user-lqt/gowin-fpga-instrument-138k/companion/README.md

# 配套应用

| 目录 | 内容 |
| --- | --- |
| `phone/` | Web Bluetooth网页、通信协议、测试和示例曲谱 |
| `esp32c3/` | ESP-IDF NimBLE BLE-UART桥接工程 |

网页部署与通信协议见[蓝牙说明](../docs/BLUETOOTH.md)。K230程序位于 [final/k230](../final/k230/)。

网页来源为团队提交 `2b471689`；ESP源码来自团队现有ESP32-C3工程。文件校验见 `release/manifest.json`。
