user-lqt/gowin-fpga-instrument-138k/docs/HARDWARE.md

# 硬件接线

整机连接图及模块工作原理见[硬件总览](HARDWARE_OVERVIEW.md)。本页给出具体引脚与接线对应关系。

按开发板球位丝印接线（如C18、A19）。58个端口及IO属性见[完整引脚表](PINOUT.md)。

## 硬件组成

| 部件 | 功能与数量 |
| --- | --- |
| Tang Mega 138K | GW5AST-LV138PG484AC1/I0；音频合成、扫描、控制与显示 |
| 自制24键琴键 | 每键2个触点，共48触点；8×6矩阵 |
| 双EC11 | 音量/音色与页面参数，各1个 |
| MCP3008 | SPI ADC，采样FSR和摇杆 |
| FSR压力传感器 | CH0，控制颤音 |
| 双轴摇杆 | CH1/CH2，表情输入 |
| PCM5102A模块 | 立体声I2S DAC；线路输出接功放或有源音箱 |
| Sipeed 5英寸RGB屏 | 800×480，RGB666接口 |
| 可寻址RGB灯带 | GRB数据格式，代码发送49个灯位置，24个位置对应实体琴键 |
| ESP32-C3 | BLE与UART双向桥接 |
| K230 | 手势、调参及8虚拟键扩展 |

外部GPIO信号采用3.3V逻辑，所有设备信号地共地。5V电源脚不是3.3V GPIO；不要将5V信号送入FPGA。F4板上复位属于1.5V Bank，不能将其当作普通外接3.3V输入。

## 双触点矩阵

| 行信号 | 球位 | 触点作用 |
| --- | --- | --- |
| R0 `row_out[0]` | E14 | K1–K6 的A触点 |
| R1 `row_out[1]` | E13 | K1–K6 的B触点 |
| R2 `row_out[2]` | C15 | K7–K12 的A触点 |
| R3 `row_out[3]` | C14 | K7–K12 的B触点 |
| R4 `row_out[4]` | B13 | K13–K18 的A触点 |
| R5 `row_out[5]` | C13 | K13–K18 的B触点 |
| R6 `row_out[6]` | A14 | K19–K24 的A触点 |
| R7 `row_out[7]` | A13 | K19–K24 的B触点 |

| 列信号 | 球位 | 对应琴键 |
| --- | --- | --- |
| C0 `col_in[0]` | B16 | K1 K7 K13 K19 |
| C1 `col_in[1]` | B15 | K2 K8 K14 K20 |
| C2 `col_in[2]` | A16 | K3 K9 K15 K21 |
| C3 `col_in[3]` | A15 | K4 K10 K16 K22 |
| C4 `col_in[4]` | A20 | K5 K11 K17 K23 |
| C5 `col_in[5]` | B20 | K6 K12 K18 K24 |

每个触点串独立防鬼键二极管，例如1N4148：`列线 → 触点 → 二极管阳极 → 阴极带环端 → 行线`。触点与二极管串联次序可对调，但带环端始终朝行。共48只二极管；A触点先闭合，B触点后闭合。

6条列线各用一只约10kΩ电阻连接3.3V，电阻另一端与对应列输入相接；不是将电阻串在列线中。最终CST也启用内部列上拉及8条行上拉，未选中行由RTL置高阻。

## 双EC11

| 信号 | 球位 |
| --- | --- |
| A编码器 A相 `enc_a` | A21 |
| A编码器 B相 `enc_b` | B21 |
| A编码器按压 `enc_sw_n` | B18 |
| B编码器 A相 `enc2_a` | C17 |
| B编码器 B相 `enc2_b` | D17 |
| B编码器按压 `enc2_sw_n` | E19 |

裸EC11相位公共端接GND，按压触点另一端接GND；信号端上拉到3.3V。用万用表确认实际引脚分组，不靠不同商家的ABCDE图猜测。当前约束启用内部上拉；已有外部上拉按已验证实物保留。

## MCP3008 FSR与摇杆

| FPGA信号 | 球位 | MCP3008 PDIP16 |
| --- | --- | --- |
| `adc_cs_n` | A18 | CS脚10 |
| `adc_sclk` | D15 | CLK脚13 |
| `adc_mosi` | D14 | DIN脚11 |
| `adc_miso` | D16 | DOUT脚12 |

VDD脚16与VREF脚15接3.3V，DGND脚9与AGND脚14共地，芯片附近做去耦。模块板按自身丝印，不照搬裸芯片脚号。

FSR分压输出送CH0（脚1）；摇杆VRx送CH1（脚2），VRy送CH2（脚3），摇杆电源3.3V。所有模拟输入限制在0至3.3V。压力增大需对应ADC读数上升，例如3.3V经FSR到CH0节点，再经固定分压电阻至GND；分压阻值和零点按实物标定。

## 外置PCM5102A

| 模块端 | 接线 |
| --- | --- |
| BCK | FPGA **A19** `o_hp_bck` |
| LCK/LRCK | FPGA **E16** `o_hp_ws` |
| DIN | FPGA **E17** `o_hp_din` |
| GND | 公共GND |
| 3.3V | 已确认的3.3V电源；不要取J13的5V |
| XMT/XSMT | 3.3V，解除静音 |
| FMT | GND，选择Philips I2S |
| SCK | 按当前无MCLK方案接GND，使用内部PLL |
| VCC/VIN | 对团队现有YX69008模块按厂家文字修正留空，避免与3.3V脚同时供电 |

FLT、DMP若引出，按模块已验证配置与资料核对。上述供电适用于团队已有模块，不能推广到所有PCM5102A板。音频从其LINE OUT的L/G/R或AUX引出，L/R不要短接，裸喇叭需要功放。

## 蓝牙 K230 灯带与屏幕

| 连接 | 最终球位与方向 |
| --- | --- |
| ESP GPIO21 TX → FPGA RX | C18 `ble_uart_rx` |
| FPGA TX → ESP GPIO20 RX | C19 `ble_uart_tx` |
| K230 UART3 IO32 TX → FPGA | C20 `k230_uart_rx`，115200/8N1 |
| LED灯带DIN | B17 `led_strip_din`；灯带GND共地 |
| RGB屏控制 | DE=L14 VS=L15 HS=N20 CLK=L19 |

ESP用USB供电及USB Serial/JTAG监视，避免日志占用GPIO20/21。K230程序与模型部署见[板端说明](../final/k230/README.md)。

灯带使用独立合适的5V供电，避免由FPGA信号脚供电；若灯带为5V输入阈值器件，DIN通过支持3.3V输入的5V逻辑缓冲器（如74AHCT125）转换。灯带电源与FPGA共地，按实际负载选电源，不将电源反灌开发板。

K1–K12映射灯 **2、4、6、8、10、12、14、16、18、20、22、24**；K13–K24映射灯 **27、29、31、33、35、37、39、41、43、45、47、49**。灯编号从DIN方向第一颗按1起算。

5英寸RGB屏使用对应专用RGB连接器与排线；数据RGB各6位共18位，完整球位见[引脚表](PINOUT.md)。不要沿用旧OLED接线。
