user-lqt/gowin-fpga-instrument-138k/docs/PLATFORM_TANG_MEGA_138K.md

# 平台冻结卡 · Tang Mega 138K

> 归属：成员 C 维护。**A/B 也必须读**，因为采样率、位宽、时钟直接决定你们的模块参数。
> 本文所有器件与板卡参数已按 Sipeed 官方文档核实（2026 年 9 月）；管脚号必须按实物原理图人工核对，见第 6 节。

---

## 1. 器件与板卡

| 项 | 值 |
|---|---|
| 开发板 | **Sipeed Tang Mega 138K Dock**（SOM + Dock 底板） |
| 芯片型号 | **GW5AST-LV138PG484AC1/I0** |
| 工艺 | 22 nm |
| 封装 | PG484（484 脚） |
| 事实核对 | SOM 资料页同时出现 `GW5AST-LV138FPG676A`；**IDE 里按 `PBG484A` 选封装，并按实物选 Device Version** |

> ⚠️ **这是最容易翻车的一步。** 器件版本选错 → 综合通过、烧录"成功"、管脚完全无反应。
> 核对方法：读芯片顶面丝印 + 查 Sipeed 的器件版本识别说明。核对结果写入 `constraint/tang_mega138k.cst` 顶部注释。

### 片上资源

| 资源 | 数量 | 对本项目的意义 |
|---|---|---|
| LUT4 | **138,240** | 32 路振荡器 + 音效 + 可视化后仍有余量 |
| FF | 138,240 | 控制逻辑与流水线充裕 |
| 分布式 SRAM (S-SRAM) | 1,080 Kbit | 小查找表、FIFO |
| 块 SRAM (B-SRAM) | **6,120 Kbit / 340 块** | 多组波表 + 混响/延迟线**全片上解决，不必用 DDR** |
| 18×18 乘法器 | **298** | 多相插值、FM 调制、滤波器都够用 |
| PLL | 12 | 可独立生成 12.288 MHz 音频时钟 |
| 全局时钟 / 高速时钟 | 16 / 24 | 音频域与系统域分离从容 |
| 硬核 SoC | RISC-V AE350 @800MHz | **本项目不使用**（软核/CPU 会破坏"纯硬件合成"合规性） |
| IO Bank | 10 | 外设扩展充足 |

### 板载资源（与本项目相关）

| 板载资源 | 数量 | 用途 |
|---|---|---|
| DDR3 | 1 GB（512MB×2） | 可选：超长延时/混响；**首选不用，避免时序坑** |
| Flash | 64/128 Mbit | 配置固化 |
| **扬声器接口** | **2 路，各 3W** | ★ 见第 4 节 |
| **3.5 mm 耳机接口** | 1（立体声，无麦克风） | ★ 见第 4 节 |
| 板载 ADC | 2 路差分 | 可选：模拟力度/包络输入 |
| 麦克风阵列接口 | 1（Sipeed 6+1） | 预留 |
| DVI/HDMI TX+RX | 1 | 拓展：可视化输出到显示器 |
| 千兆以太网 / USB3 / PCIe | 各 1 | 本项目不用 |
| PMOD / 2x20P 排针 | 2 / 2 | 外接键盘、OLED、传感器 |
| LED | 4（电池指示）+ 8（PMOD_LED） | 系统状态指示 |
| 按键 | 3 用户键 + 1 重配置键 | 复位、模式切换 |
| USB JTAG & UART | 1（JST SH1.0 8P） | 下载 + 串口调试 |
| MS5351 时钟发生器 | 1 | 可为 Serdes 提供 RefClk（本项目暂不用） |
| 供电 | 12V DC（DC5521）或双 5V USB | 见第 5 节电源注意 |

---

## 2. IDE 与 License（版本门槛，必须核对）

| 渠道 | 最低版本 | 说明 |
|---|---|---|
| **教育版** | **V1.9.9 或更高** | 138K 目前由教育版支持 |
| **商业版** | **V1.9.11.03 或更高** | 官网申请 License，或用 Sipeed 浮动 License 服务器 |
| 独立下载器 Programmer | **1.9.12 SP1** 更稳 | 从"云源软件商业版"页面单独下载 |

**Sipeed 浮动 License 服务器**（商业版选 Floating License 填入）：

```
IP:   106.55.34.119
Port: 10559
```

**烧写 Flash 的推荐模式**：

```
exFlash Erase, Program through GAO-Bridge 5A        (V1.9.11.03+)
exFlash Erase, Program through GAO-Bridge Arora V   (V1.9.12+)
```

---

## 3. 时钟与采样率方案（A/B/C 共同依据）

| 信号 | 频率 | 来源 | 用途 |
|---|---|---|---|
| `clk_fsys` | 100 MHz | PLL（板载晶振） | 系统、控制、UART、键盘扫描 |
| `clk_fs` | **12.288 MHz** | PLL = 48 kHz × 256 | 音频采样域，I2S 位时钟基准 |
| `sample_tick` | **48 kHz** | 由 `clk_fs` 每 256 拍产生（整除） | 音频核心的唯一样本节拍 |
| `HP_WS`（LRCK） | 48 kHz | `clk_fs` / 256 | 声道选择，**低电平 = 左声道** |
| `HP_BCK` | **3.072 MHz** = 64 × 48 kHz | `clk_fs` / 4 | 位时钟，每声道 **32 bit 槽**（给 24 bit 留空间） |

> ⚠️ **与官方例程的差异**：官方例程用 `HP_BCK = 1.536 MHz`（**16 bit** 槽、32 BCK/帧）以输出纯单音梯形波。
> 我们的设计把 BCK 提到 **3.072 MHz**（32 bit 槽、64 BCK/帧）以便输出 **24 bit**。
> **板载 DAC 是否接受 32 bit 槽尚未验证** —— 按 [`C_官方例程与板载音频通路分析.md`](C_官方例程与板载音频通路分析.md) 第 3 节的"验证阶梯"分四步走，不要一步到位。

> **为什么不用 100 MHz 直接分频？** 100 MHz / 48 kHz = 2083.33，除不尽，需要小数累加。用 12.288 MHz 音频域则每采样正好 256 拍，**无抖动、无累积误差**，也满足"确定性无抖动延迟"这条拓展要求。
> 若某处必须用 `clk_fsys` 产生 48 kHz，`event_defs.vh` 里也给了 Bresenham 小数累加的说明，但**首选音频域方案**。

**I2S 格式约定（C1 必须按此实现）**

| 项 | 约定 |
|---|---|
| 协议 | I2S（MSB 先出） |
| 槽位 | 每声道 **32 bit**，BCK = 64 × LRCK |
| 有效位宽 | 目标 24 bit，**左对齐放在 32 bit 槽的高 24 位**，低 8 位补 0 |
| 时序 | 发射端在 BCK 下降沿更新数据，接收端在上升沿采样 |
| 相位 | 官方例程在帧内第 3 个 BCK 翻转 `HP_WS`（**不是标准 1-BCK 延迟**）。**首次实现请照抄官方相位并实测确认**，不要凭理论推断 |
| 接口 | `HP_BCK` / `HP_WS` / `HP_DIN` 三线直连板载 DAC；官方例程将 `PA_EN` 固定低电平常开 |
| 备选 | 若板载 DAC 不接受 32 bit 槽：退回 16 bit 槽（BCK=1.536 MHz），或用外置 PCM5102A（SCK 接 GND，无需 MCLK） |

---

## 4. 音频输出硬件路径

> ### ✅ 已确认（2026-09-21）：板载 DAC + 功放是完整的，不需要外置器件
>
> 依据 Sipeed 官方例程 **`TangMega-138K-example → audio_i2s/`**：
>
> ```verilog
> output HP_BCK,   // 位时钟
> output HP_WS,    // 左右声道（低=左）
> output HP_DIN,   // DAC 串行数据输入
> output PA_EN,    // 音频功放控制；官方 top.v 固定为低电平常开
> ```
>
> 例程自述："Test condition: earphone in the jack or mounted speaker. Phenomenon: A 400 Hz trapezoidal wave is generated and played."
>
> **结论：外置 PCM5102A、PAM8403 功放、独立 5V 电源、无源喇叭全部不需要。**
> 板载已有 DAC + 功放 + 耳机口 + 扬声器接口，`PA_EN` 控制功放使能。
> **实机管脚已核实并写入 `constraint/tang_mega138k.cst`。**
> 详细分析与 I2S 协议参数见 [`C_官方例程与板载音频通路分析.md`](C_官方例程与板载音频通路分析.md)。

**首选路径（板载，阶段一即可验证）**

```
FPGA (HP_BCK / HP_WS / HP_DIN) → 板载 I2S DAC → 板载功放 (PA_EN 固定低电平) → 耳机口 / 扬声器
```

**备选路径（仅在板载 DAC 不支持 24 bit 时考虑）**

```
FPGA (I2S 三线) → PCM5102A 模块（3.3V 供电，SCK 接 GND）→ 有源音箱
```

> ⚠️ **仍需保留逻辑分析仪。** I2S 三线波形必须实测（LRCK=48 kHz、BCK/DATA 对齐），这是 C1 的硬性验收条件，"听起来对"不能代替波形证据。

**采购清单的重要修正**

原采购清单按 **Tang Mega 60K** 编写，且假设需要外置 DAC + 功放 + 独立电源。现修正为：

| 项 | 原计划 | 修正 |
|---|---|---|
| 开发板 | Tang Mega 60K | **Tang Mega 138K Dock** |
| 器件型号 | GW5AT-LV60PG484AC1/I0 | **GW5AST-LV138PG484AC1/I0**（IDE 选 PBG484A，版本 B/C） |
| **PCM5102A × 2** | 阶段一必买 | **不需要**（板载已有 I2S DAC）；仅作为"24 bit 不通"时的备选 |
| **PAM8403 功放板 + 5V 电源 + 无源喇叭** | 阶段四必买 | **不需要**（板载已有功放与扬声器接口） |
| **3.5mm 有源音箱** | 阶段一必买 | **不需要**（耳机口 + 一副耳机即可验证第一声） |
| 8 通道逻辑分析仪 | 阶段一自购 | ✅ **仍然必买**，不可省 |
| 管脚手册 | UG986-1.2.7 GW5AST-138 Pinout | ✅ 与板子匹配，不用更换 |

> 预算影响：可省下约 100~400 元，实际需要买的只剩**逻辑分析仪 + 万用表 + 杜邦线/面包板**，加上阶段二的键盘、编码器、OLED。

---

## 5. 硬件安全红线（违反会烧板子）

1. **外接 GPIO 只允许 3.3 V 电平。** 超过会**永久损坏** PCBA。
2. **HC-SR04 的 ECHO 是 5 V**，必须 10 kΩ 串联 + 20 kΩ 下拉分压到约 3.3 V 再进 FPGA，**不得直连**。
3. **PAM8403 / 板载功放为 BTL 差分输出**：扬声器负端**不得接地**，左右声道负端**不得互连**，不得接普通耳机。
4. **示波器地夹不得随意夹在功放输出端**（会短路 BTL 输出）。
5. **5 V I2C 模块（会通过上拉把 SDA/SCL 拉到 5 V）不得直连** FPGA。
6. 供电不足的典型现象：按住 PWR 2 秒后"灯全灭再依次点亮"。解决：双 USB 5V 供电，或 12V DC，或 3.7V 锂电池（≥3.6V / ≥600 mA）。
7. **上电后核心板灯不亮是正常的** —— 底板 PWR 键需**长按 2 秒**才开机。
8. 插拔、动 PCIe 金手指前必须完全断电。

---

## 6. 需要从 PDF / 官方资料人工核对的清单

> 这些内容自动化提取不可靠（中文管脚手册的汉字层无法转文本），**必须人工查**，查完把结论补进本文件与 `.cst`。

| # | 待核对项 | 依据文件 | 责任人 |
|---|---|---|---|
| 1 | 芯片实际器件版本（B/C） | 芯片丝印 + Sipeed 器件版本识别说明 | C |
| 2 | I2S 三根信号（BCK/LRCK/DIN）的物理管脚号 | `constraint/` 参考 + Sipeed 原理图 | C |
| 3 | 板载音频输出是 line-level 还是已放大 | Sipeed Schematics | C |
| 4 | 可用 GPIO 排针管脚表（键盘/OLED/传感器） | `UG986-1.2.7_GW5AST-138器件Pinout手册.pdf` | C/B |
| 5 | 板载晶振频率与可用 PLL 输入 | Sipeed 原理图 | C |
| 6 | 按键、LED、复位键管脚号 | Sipeed 原理图 | C |

**官方资料链接**

- 板卡文档：<https://wiki.sipeed.com/hardware/en/tang/tang-mega-138k/mega-138k.html>
- 原理图 / PCB / 机械 / 管脚文件：<https://dl.sipeed.com/shareURL/TANG/Mega_138K_60K/02_Schematic>
- 官方例程：<https://github.com/sipeed/TangMega-138K-example>
- 云源软件用户指南：`SUG100-4.4.6_Gowin云源软件用户指南.pdf`（工作区根目录）
- 器件管脚手册：`UG986-1.2.7_GW5AST-138器件Pinout手册.pdf`（工作区根目录）

---

## 7. 13.8 万 LUT / 298 乘法器下的资源规划（初版估算）

| 模块 | LUT 估算 | BSRAM | DSP | 说明 |
|---|---|---|---|---|
| 32 路振荡器（含 ADSR） | ~12–18 K | 2–4 块 | 32 | 每路相位累加 32 bit + 包络 |
| 共享波表（4 音色 × 4 K 点 × 16 bit） | ~1 K | 6 块 | — | **共享波表**，不按声部复制 |
| 混音 + 饱和 | ~3 K | 0 | 32 | 加法树 + 饱和链 |
| FM 调制（可选，每声部 1 算子） | ~6 K | 0 | 32–64 | 冲奖音色 |
| 延迟效果（最大 500 ms @48 kHz） | ~2 K | ~150 块 | 4 | 24 bit × 24000 点 ≈ 4.6 Mbit |
| Schroeder 混响（4 梳状 + 2 全通） | ~3 K | ~60 块 | 8 | 短延时为主 |
| 输入链路（键盘/编码器/触摸/力度） | ~4 K | 少量 | 1 | 含 I2C/SPI 状态机 |
| OLED 驱动 + 页面 | ~2 K | 少量 | 0 | I2C 写时序 |
| 系统（时钟/节拍/I2S/UART/LED） | ~3 K | 少量 | 2 | — |
| **合计** | **~36–42 K / 138 K（≈30%）** | **~220 块 / 340** | **~110 / 298** | 余量充足 |

> 资源余量充足，因此**不要为了省资源牺牲音质**：优先上多相插值、24 bit 全精度运算、长延时线。
> 真正的瓶颈不是资源，而是**时序收敛与调试时间**。

---

## 8. 延迟预算分解（A/B/C 共同目标）

| 环节 | 归属 | 预算 | 如何测 |
|---|---|---|---|
| 键盘扫描周期 | B | ≤ 1 ms | 扫描计数器周期，逻辑分析仪 |
| 消抖帧数 | B | 3 帧 ≈ 3 ms（可降到 2 帧 ≈ 2 ms 冲 5 ms 目标） | RTL 参数 + 仿真 |
| 事件打包与跨模块传递 | B→A | < 10 μs | 仿真波形 |
| 声部分配 | A | < 1 个采样周期 ≈ 21 μs | 仿真波形 |
| 振荡器/包络/混音流水线 | A | 若干采样周期，纯流水线**相位延迟不增加延迟** | 仿真 |
| C 后端（音量/效果/峰值） | C | ≤ 2 个采样周期 ≈ 42 μs | 仿真 |
| I2S 输出滞后 | C | 32 bit 槽 ≈ 0.67 ms | LRCK/BCK 实测 |
| **合计** | | **≈ 4.7 ms** ✅ 满足 ≤10 ms；冲 ≤5 ms 需压缩消抖 | 示波器：输入标记 → DAC 输出变化 |

**两个必须实测的数字**（写进报告与答辩）：

1. **总延迟**：输入事件标记 → DAC 输出首个变化样本，示波器双通道测
2. **吞吐量**：同时活跃可闻独立振荡器数 × **48 kHz**（过采样不计入）

---

## 9. 本卡的状态

- [x] 器件与板卡参数核实
- [x] IDE/License 版本门槛核实
- [x] 时钟与 I2S 方案定稿
- [ ] 第 6 节 6 项人工核对（责任人：C，阶段 0 内完成）
- [ ] 板载音频输出类型确认（责任人：C，阶段 0 内完成）

**未完成项不影响 A/B 开工** —— A/B 只依赖第 3 节的时钟/采样率约定和 `rtl/common/event_defs.vh`。
