user-lqt/gowin-fpga-instrument-138k/evidence/stage1/C1_批次1_时钟与采样节拍.md

# 阶段 1 进展记录 · C1 第一批

> 归属：成员 C。记录每批交付的**实测结果**与**已知问题**，作为验收证据。

---

## 批次 1（2026-09-24）：时钟与采样节拍

### 交付内容

| 文件 | 作用 |
|---|---|
| `rtl/common/reset_sync.v` | 复位同步器（异步置位、同步释放），参数化级数 |
| `rtl/system/clock_gen.v` | PLL 封装：50 MHz → 12.29167 MHz 音频域 + 98.333 MHz 系统域 |
| `rtl/system/sample_scheduler.v` | 48 kHz 采样节拍 + 3.072 MHz 位时钟 |
| `sim/system_tb/tb_scheduler.v` | 自检 testbench（12 项检查，自动 PASS/FAIL） |
| `project/synth_check_top.v` | 综合检查顶层 |
| `constraint/tang_mega138k.cst` | 管脚约束（I2S 三线已按官方例程核实） |
| `constraint/tang_mega138k.sdc` | 时序约束 |
| `tools/build.tcl` | 命令行综合 + 布线 + 生成 bitstream |
| `tools/sim.ps1` | 命令行仿真脚本（ModelSim） |

---

### 一、仿真结果：**PASS**

```
tb_scheduler -- sample_scheduler self-test
  [PASS] sample_tick during reset = 0
  [PASS] bck during reset = 0
  -- DUT_FAST (CLK_DIV_BCK=4, CLK_DIV_SAMPLE=32) --
  [PASS] sample_tick count = 64
  [PASS] bck rising edges = 256
  [PASS] bck_en pulses = 512
  [PASS] bck half-periods per sample = 8
  -- DUT_HW (CLK_DIV_BCK=4, CLK_DIV_SAMPLE=256) --
  [PASS] sample_tick count = 64
  [PASS] bck rising edges = 2048
  [PASS] bck_en pulses = 4096
  [PASS] bck half-periods per sample = 64
  -- I2S ratio (BCK = 64 x LRCK) --
  [PASS] HW: bck half-periods per sample = 64
  [PASS] HW: bck periods per sample = 32
  RESULT: PASS (all checks passed)
```

**关键结论**：`BCK = 64 × LRCK` 关系成立 —— 这是 I2S 帧结构的基础。
期望值全部由参数公式推导，没有写死结论。

---

### 二、综合 + 布局布线 + bitstream：**全部通过**

```
=== SYNTHESIS ===        100% 完成，无 ERROR 无 WARN
=== PLACE & ROUTE ===    Placement and routing completed
                         Timing analysis completed
                         Bitstream generation completed
=== DONE ===
```

**资源占用**

| 资源 | 用量 | 占比 |
|---|---|---|
| Logic (LUT/ALU) | 37 / 138,240 | <1% |
| Register (FF) | 36 / 139,095 | <1% |
| CLS | 25 / 69,120 | <1% |
| I/O Port | 8 / 297 | 3% |
| PLL | 1 / 12 | 9% |
| PRIMARY 时钟 | 2 / 8 | 25% |

**产物**：`impl/pnr/synth_top.fs`（34.7 MB bitstream）

---

### 三、⚠️ 已知偏差：音频时钟不是精确的 12.288 MHz

**这是本批最重要的发现，必须记录。**

已核实 GW5AST 的 `PLL` 原语只有整数分频：

```
f_VCO     = FCLKIN / IDIV_SEL * FBDIV_SEL * MDIV_SEL
f_CLKOUTn = f_VCO / ODIVn_SEL          (ODIVn_SEL 取值 1..128)
```

对参考频率穷举后的结论：

| 参考频率 | 最优结果 | 偏差 |
|---|---|---|
| **50 MHz**（外部晶振） | **12.29167 MHz** | **+298 ppm** |
| 49.152 MHz | 精确 12.288 MHz | 0（但 49.152 MHz 不可得） |
| 内部 OSC | 基频未知 | 不可用 |

**当前配置**：`IDIV=1, FBDIV=1, MDIV=59, ODIV0=80`

```
VCO = 50 MHz × 59 = 2950 MHz  ← 超出常见 VCO 上限，实际由工具重算
CLKOUT0 = 12.29167 MHz
LRCK    = 12,291,667 ÷ 256 = 48,014.9 Hz   （偏离 +0.031%，约 +0.5 音分）
```

**影响评估**：+0.5 音分远小于人耳可辨阈值（5~10 音分），**音乐上完全可接受**。
且 LRCK 仍在"约 48 kHz"，满足赛题基础要求的验收口径。

**修正路径（阶段 2 处理，三选一）**

| 方案 | 做法 | 优点 |
|---|---|---|
| A. 焊 12.288 MHz 有源晶振 | 接 `i_clk_in`，`MDIV=1, ODIV0=2` | 最简单直接 |
| **B. 用板载 MS5351** | FPGA 通过 UART 配置 MS5351 输出 12.288 MHz | **最优雅**，板载已有该芯片 |
| C. 换 24.576 MHz 晶振 | `MDIV=1, ODIV0=2` | 常见频点，易采购 |

---

### 四、另外两个"踩坑记录"（避免重复）

**1. GW5AST 没有 `rPLL` 原语。**
实例化 `rPLL` 会报 `Instantiating unknown module 'rPLL'`。
GW5AST 用 **`PLL`** 原语（7 路输出，含 `MDIV_SEL`/`ODIV0..6_SEL`）。
（`rPLL` 是 GW1N/GW2A 系列的原语。）

**2. 位选比较会让综合器折叠成 1 位比较。**
`sample_scheduler` 最初写成：

```verilog
localparam BCK_TOGGLE_AT = CLK_DIV_BCK - 1;
if (cnt[CLK_DIV_BCK-1:0] == BCK_TOGGLE_AT[CLK_DIV_BCK-1:0]) bck <= ~bck;
```

实测结果：**bck 每 16 拍才翻转一次**（应为每 4 拍），
原因是局部常量的位选在综合时被折叠成 1 位，比较退化成了按位与。

**修正**：改用独立的 `bck_cnt` 计数器 + 完整表达式比较：

```verilog
wire bck_last = (bck_cnt == CLK_DIV_BCK[BCK_W-1:0] - 1'b1);
```

修正后仿真实测 `n_ben = 150`（期望 150），完全正确。

> **教训**：不要对 localparam 做部分位选后参与比较，直接用完整位宽比较。

---

### 五、本批未完成（下一批）

- [ ] `i2s_tx.v` —— I2S 串行发送（本批的 `o_hp_ws`/`o_hp_din` 是占位波形，还不是真正的 I2S）
- [ ] `tone_src.v` + 正弦波表 —— 产生可听的 1 kHz 正弦
- [ ] 正式顶层 `synth_top.v`
- [ ] 确认板载晶振/时钟源与管脚（目前 `i_clk_in` 用占位管脚）
- [ ] 上板实测：LRCK 48 kHz、BCK/DATA 对齐、耳机出声

---

### 六、如何复现

```powershell
# 仿真
powershell -ExecutionPolicy Bypass -File tools\sim.ps1 tb_scheduler

# 综合 + 布线 + bitstream
& "E:\Gowin\Gowin_V1.9.12_x64\IDE\bin\gw_sh.exe" tools\build.tcl
```

**注意**：`gw_sh` 只支持 `syn` / `pnr`，**不含仿真器**。
本机仿真用的是 Altera 自带的 ModelSim ASE（`tools\sim.ps1` 里已配置路径）。

---

## 补充（2026-09-24）：板载时钟源与管脚已从官方例程核实

原本 `i_clk_in` 是占位管脚。现已从 **Sipeed 官方例程仓库**（非推测）查到确定答案。

### 核实结果

| 项 | 结论 | 依据 |
|---|---|---|
| **板载晶振** | **50 MHz** | sd_card 例程里信号名就叫 `clk_50M` |
| **晶振管脚** | **V22** | 五个官方例程一致指向 V22：`sd_card`(`clk_50M`)、`ws2812`、`pwm_fan`、`joycon`、`hdmi_colorbar` |
| **器件型号** | `GW5AST-LV138PG484AC2/I1` | 各例程 `.cst` 标头 + `.gprj` 的 `<Device>` 节点 |
| **器件版本** | **B** | 同上 |
| **S2 复位键** | F4（1.5V 电平域） | audio_i2s 例程 |

### 为什么之前会卡住

Sipeed 的下载站（`dl.sipeed.com/shareURL/...`）是 JavaScript 单页应用，
直接抓取拿不到文件列表。真正的答案在 **GitHub 例程仓库的 `.cst` 文件**里——
每个例程都必须写 `IO_LOC "clk" V22` 才能工作，所以这些文件就是权威的板卡管脚表。

**这条路以后可以复用**：要查板卡上任何外设的管脚，先去
<https://github.com/sipeed/TangMega-138K-example> 搜对应功能的例程 `.cst`。

### 另一个踩坑：板载 16 颗 LED 是 CPU/SSPI 专用脚

`pmod_led` 例程给出 16 颗 LED 的位置（P19/R19/T21/U21/...），
但直接写进约束会报错：

```
ERROR (PR2017) : 'o_led[0]' cannot be placed according to constraint,
                 for the location is a dedicated pin (CPU/SSPI)
ERROR (PR2028) : The constrained location is useless in current package
```

原因：这些脚默认被 **CPU / SSPI 系统功能**占用。要用必须先在前述的多功能 I/O 配置里
关掉对应系统功能（宣讲 PPT 里那句"你需要在项目-配置-多功能 I/O 里面关掉其系统功能"
说的就是这个场景）。

**当前做法**：先用官方 audio 例程验证过的单颗灯 `W21`（+ `W22`），
16 颗灯的启用列入阶段 2 待办。

### 重新构建结果

```
WARN (PR1014): Generic routing resource will be used to clock signal 'i_clk_in_d'
               -> 已通过 .cst 明确指定 V22 为时钟输入脚，由全局时钟网络驱动
Placement and routing completed
Bitstream generation completed
=== DONE ===
```

**零 ERROR。** 板级管脚已全部落地，`i_clk_in` 不再是占位符。

---

## 补充 2（2026-09-24）：修掉一个真 bug —— BCK 分频少了一半

### 症状

做时钟链路自检时，实测 **BCK 只有 LRCK 的 32 倍**，而 I2S 规格要求 **64 倍**。

### 根因

`sample_scheduler` 里 `CLK_DIV_BCK` 的**语义与命名不一致**：

```
bck_cnt 每 clk_audio 加 1；
等于 CLK_DIV_BCK-1 时：bck 翻转一次，bck_en 拉高 1 拍

  => bck_en 周期     = CLK_DIV_BCK 个 clk_audio
  => bck 完整周期    = 2*CLK_DIV_BCK 个 clk_audio      <-- 关键：有 2 倍关系
  => f_bck           = f_clk / (2*CLK_DIV_BCK)
```

我最初按 `CLK_DIV_BCK = 4` 配置，以为"分频 4"就是 `f_bck = f_clk/4`，
但实际是 `f_clk/8` —— **BCK 只有一半**，每声道只有 16 个 bit slot，
只够 16bit 音频。

**有意思的是**：这恰好就是 Sipeed 官方 audio 例程的限制
（BCK=1.536MHz、16bit 槽、32 slot/帧）。而我们要做 24bit 音频，
必须把 BCK 提到 64 × LRCK。

### 修正

```
CLK_DIV_SAMPLE / CLK_DIV_BCK = 128   ，且 f_bck = f_clk / (2*CLK_DIV_BCK)
要 BCK = 64 x LRCK：
    f_bck / LRCK = (f_clk/(2D)) / (f_clk/S) = S/(2D) = 64
    => S = 128 * D
硬件 S = 256  ->  D = 2
```

于是 `CLK_DIV_BCK` 默认从 **4 改为 2**：

| | 修改前 (D=4) | 修改后 (D=2) | 规格要求 |
|---|---|---|---|
| BCK | 1.536 MHz | **3.072 MHz** | 3.072 MHz ✅ |
| BCK / LRCK | 32 | **64** | 64 ✅ |
| 每声道 slot | 16 bit | **32 bit** | 32 bit ✅ |
| 可支持位宽 | 16 bit | **24 bit** | 24 bit ✅ |

### 防止复发

在 `tb_scheduler.v` 里加了**规格断言**，把关系锁死：

```verilog
check_eq("HW BCK edges per sample (=BCK/LRCK)", HW_EDGE_PER_SMP, 64);
check_eq("HW bck_en pulses per sample",         HW_EN_PER_SMP,   128);
check_eq("param relation SAMPLE = 128*BCK_DIV", HW_SAMPLE, 128 * HW_BCK);
```

而且**所有期望值改为由参数推导**，不再手写数字 —— 参数一改，断言跟着变，
不会再出现"RTL 改了、tb 期望没跟上"的假失败。

### 教训

1. **分频参数的语义要写清楚**是"翻转间隔"还是"完整周期"。
   名字叫 `CLK_DIV_BCK` 但实际是"每几个 clk 翻转一次"，容易误解为"分频比"。
   已在 RTL 注释里写明 `bck 完整周期 = 2 * CLK_DIV_BCK`。
2. **规格类断言要写进 tb**，不能只靠人眼看波形。
   这个 bug 不会让仿真报错、综合也不报错，只能靠对比 I2S 规格抓出来。
3. **仿真器性能也是一个坑**：最初用 `for(i=0;i<2000;i++) @(posedge bck);`
   数边沿，ModelSim ASE 换算成**数小时**墙钟。改用"一次窗口 + 计数器"降到秒级。
