user-lqt/gowin-fpga-instrument-138k/testing/measurements/reports/latency/full_key_budget_001/report.md

# 24键延迟：相位复核与条件性误差预算

## 结果

- 全部84次可用记录均纳入，24键各至少3次。
- 原始数据和旧报告不改动，所有审计源文件在补算前后均经SHA-256核对。
- 原最大扫描等余量包络：3.848995 ms。
- 全批次新增相位偏移最大值：20.770000 µs。
- 统一额外经验分析余量：30 µs（上述最大值向上取整到10 µs）。
- 按25 ppm时基假设、2 ns通道偏差计算，最大条件性包络：3.879094 ms。
- 若另按距校准10年累计漂移情景计算：3.879288 ms；这不是本机真实校准年龄。
- 最大值对应K1第1次。
- 上述为经验分析余量及仪器规格条件成立时的条件性结果，不是校准确认的严格物理闭合延迟上界。

## 计算口径

每条条件性包络 U(Y) = [E + A/1000 + 0.000002] / [1 - (25 + 5Y)×10⁻⁶]，单位ms。
E为旧包络（已包含扫描等待、对齐残差、采样及边界余量），A为本批统一经验分析余量（µs），Y为距适用校准基准的年数；0.000002 ms为2 ns通道间最大偏差。用整个包络计算时基项，不仅对3.5 ms图示间隔计算，也不重复添加扫描等待。
已下载核实的RIGOL官方英文手册第6页为15 ppm、5 ppm/年；时基精度带注[1]，第11页明确[1]为典型值，不是保证上限。本报告25 ppm是大于15 ppm的保守计算假设，不能由此反推本机真实误差必小于25 ppm。先前提及的中文25 ppm资料未能成功下载核实，因此不作为本次正式规格依据。规格要求规定温度下连续运行超过30分钟，本批未记录温度、预热及实际校准日期。

## 全键结果

|按键|可用次数|原最大间隔/ms|原最大包络/ms|最大新增相位偏移/µs|条件性包络：基础25 ppm/ms|条件性包络：加10年漂移/ms|
|---|---:|---:|---:|---:|---:|---:|
|K1|3|3.644729|3.848995|13.360|3.879094|3.879288|
|K2|3|3.593011|3.797557|17.810|3.827655|3.827846|
|K3|4|3.606189|3.810776|20.770|3.840874|3.841066|
|K4|3|3.600830|3.805243|15.267|3.835340|3.835532|
|K5|4|3.625809|3.830312|19.940|3.860411|3.860604|
|K6|3|3.613725|3.818217|8.450|3.848316|3.848508|
|K7|3|3.544496|3.748931|17.335|3.779027|3.779216|
|K8|4|3.586846|3.791281|18.445|3.821378|3.821569|
|K9|3|3.546361|3.750857|18.315|3.780954|3.781143|
|K10|4|3.531246|3.736508|12.105|3.766604|3.766793|
|K11|3|3.546947|3.751447|18.655|3.781544|3.781733|
|K12|3|3.545798|3.750209|18.315|3.780305|3.780494|
|K13|4|3.528483|3.732929|17.905|3.763025|3.763213|
|K14|3|3.505520|3.709968|18.615|3.740064|3.740251|
|K15|3|3.506245|3.710765|17.235|3.740861|3.741048|
|K16|4|3.518382|3.722858|8.660|3.752953|3.753141|
|K17|3|3.513631|3.718130|19.110|3.748226|3.748413|
|K18|3|3.526583|3.731064|17.050|3.761160|3.761348|
|K19|4|3.455832|3.660426|19.500|3.690520|3.690705|
|K20|3|3.467188|3.672896|5.460|3.702990|3.703176|
|K21|3|3.511721|3.716132|6.960|3.746228|3.746415|
|K22|7|3.447175|3.652398|19.245|3.682492|3.682676|
|K23|3|3.478565|3.682969|19.405|3.713064|3.713249|
|K24|4|3.513604|3.718145|19.965|3.748240|3.748428|

## 相位复核方法

两种方法×25/50/100 kHz×10/15/20 mV；每个降采样因子f检查0到f−1全部整数原始采样相位。FIR为与原SciPy默认resample_poly相同的Kaiser(β=5)、20f+1抽头低通；原始输入边界固定，不裁掉相位起点之前的样本。分块均值保留每块中心时刻；以完整输入的滑动均值枚举所有分块起点。
每个相位独立按原始规则估计静音基线，并寻找连续至少0.1 ms超阈值的首个起音。FIR全网格零相位与原resample_poly逐点比对，分块均值零相位与原reshape均值逐点比对；超过0.1 nV数值差异即中止。阈值比较另使用1 nV数值保护带，等于阈值按未超过处理，这不是新增的模拟电压准确度声明。
每条新增偏移=max(0，所有新增相位的最晚起音−旧18项最晚起音)。统一余量从全部记录的最大新增偏移得到，不因按键或结果是否小于5 ms选择算法。旧18项中位约50 µs、最大约80 µs的极差已由旧最晚起音覆盖，不重复相加。FIR未来样本支持长度不是额外测量误差，不能直接再加。

## 结论及仍需确认的条件

本轮钢琴音色、音量127、音效关闭、中等力度的84次记录，在采用本批经验分析余量及上述仪器规格假设时，条件性包络均小于5 ms。
整数相位检查覆盖记录中的原始采样网格，不等同于连续时间校准。经验余量只约束本批被比较的方法及相位，不能证明所有滤波方法共有的系统偏移为零，也不包含独立探头/线缆校准或电压阈值到真实物理声学起音的转换。
起点仍是B触点持续有效导通的扫描约束，不是任意首次机械接触；使用前一B窗口起点覆盖扫描盲区，以相邻扫描间的有效持续导通假设为条件。不能覆盖扫描期间完全不可见的短暂导通或任意接触抖动历史。
正式文档可采用本报告的条件性结论，但必须保留测量条件、起终点定义、经验余量口径及仪器假设。典型值不能冒充保证值；若需要校准确认的严格上界，还需本机有效校准依据，不能靠软件补算取代。未核实的预热/温度/校准日期不能填成已确认；因此软件严格验收标志仍不自动改为通过。

## 官方资料

RIGOL MSO/DS2000A官方英文数据手册，第6及11页
https://download.rigol.com/en/Manual/Digital%20Oscilloscope/MSO%26DS2000A/MSO2000A%26DS2000A_Datasheet_EN.pdf
