user-lqt/gowin-fpga-instrument-138k/final/THIRD_PARTY_NOTICES.md

# 第三方说明

FFT的r22sdf实现保留原许可证，见：

- `project/integrated_instrument_64/source/vendor/r22sdf/LICENSE`

MIT许可证及Nanamaru Namake的原版权声明未删除。源文件中的作者及许可说明保留。
Gowin生成IP及开发工具需按厂商许可使用。
本包含已固化的显示数据表，不分发操作系统字体文件；维护显示数据时应使用具有相应使用权的字体。
K230运行库和模型需按各自提供方授权另行安装。
