user-lqt/gowin-fpga-instrument-138k/docs/C1_模块设计说明.md

# C1 模块设计说明（写代码前的技术方案）

> 归属：成员 C。本文是 C1 阶段的**设计冻结文档** —— 写代码之前先定清楚"写什么、为什么这样写"。
> 对应任务书：`成员C_音频输出与FPGA系统平台任务书.md` 的 **C0 + C1**。

---

## 1. 本阶段要达成的目标

**一句话**：让 FPGA 自己产生的固定正弦波，经过 I2S 送到板载 DAC，从耳机口稳定出声。

对应任务书 C1 的硬性门槛：

| # | 门槛 | 怎么证明 |
|---|---|---|
| 1 | LRCK（HP_WS）实测 **48 kHz** | 示波器测周期 ≈ 20.83 μs |
| 2 | BCK = 64 × LRCK，DATA 对齐无错位 | 逻辑分析仪抓三线 |
| 3 | 左右声道稳定、无杂音/爆音/周期性中断 | 听 + 长时间观察 |
| 4 | 有逻辑分析仪波形证据 | 存 `evidence/stage1/` |

**本阶段不做**：不做合成、不做复音、不做 ADSR、不接键盘。**波形是固定的正弦**——它的作用是把整条输出链路先立起来，将来换成 A 的音频核心。

---

## 2. 要写的文件（5 个模块 + 1 个顶层 + 1 个 testbench）

| # | 文件 | 归属目录 | 干什么 |
|---|---|---|---|
| 1 | `rtl/system/clock_gen.v` | rtl/system | 产生两个时钟：`clk_fsys`（100 MHz 系统域）、`clk_fs`（12.288 MHz 音频域） |
| 2 | `rtl/system/sample_scheduler.v` | rtl/system | 从 12.288 MHz 产生 **48 kHz 单拍脉冲** `sample_tick`，以及 I2S 位时钟使能 |
| 3 | `rtl/system/i2s_tx.v` | rtl/system | 把 24 位采样串行输出：`HP_BCK` / `HP_WS` / `HP_DIN` |
| 4 | `rtl/system/tone_src.v` | rtl/system | **临时占位**：固定正弦音源（将来被 A 的 audio_core 替换） |
| 5 | `ip/gowin_osc/`、`ip/gowin_pll/` | ip | Gowin 原语封装（`.ipc` 配置 + 生成的 `.v`） |
| 6 | `project/synth_top.v` | project | 顶层：接线 + 复位同步 + 输出 |
| 7 | `sim/system_tb/tb_system.v` | sim/system_tb | 仿真验证 LRCK/BCK 频率、数据对齐、复位静音 |

**已存在、直接用**：`rtl/common/reset_sync.v`（上一轮已经写好）。

---

## 3. 时钟方案（关键决策）

### 3.1 两个时钟域

```
板载晶振 / 内部 OSC
        │
        ▼
   [ Gowin_PLL ]
        ├──> clk_fsys  100 MHz    系统域：UART、LED、键盘扫描（阶段2才有）
        └──> clk_fs   12.288 MHz  音频域：采样节拍、I2S 位时钟
                        │
                        ├── /256 ──> sample_tick  48 kHz（音频唯一节拍）
                        └── /4   ──> HP_BCK       3.072 MHz
```

### 3.2 为什么音频域必须是 12.288 MHz

12,288,000 ÷ 256 = **48,000 整除**。

如果直接用 100 MHz 分频：100,000,000 ÷ 48,000 = **2083.33**，除不尽 → 需要小数累加 → **产生抖动**。而赛题拓展要求里明确写着"**确定性无抖动延迟**"，所以这一步不能将就。

### 3.3 PLL 参数（供 `.ipc` 配置用）

假设参考时钟 `f_ref = 50 MHz`（内部 OSC 或板载晶振）：

```
VCO = f_ref × (M / N)
clkout = VCO / D

取 M = 64,  N = 25  →  VCO = 50 × 2.56 = 128 MHz
  D = 1.00 → 128.00 MHz    ← 接近 100 MHz，但不够准
```

**更优的一组**（同时精确产出两个频率）：

```
VCO = 1228.8 MHz（PLL 输出频率上限内，需在 IP 配置器里确认）
  D = 100 → 12.288 MHz   ✅ 精确
  D = 12.288 → 无法用整数分频得到 100 MHz ❌
```

**结论：100 MHz 和 12.288 MHz 无法用同一个 PLL 的整数分频同时精确得到。**

因此采用**两个 PLL**（板载有 12 个 PLL，够用）：

| PLL | 输入 | 输出 | 用途 |
|---|---|---|---|
| `PLL_A` | 50 MHz | **12.288 MHz** | 音频域，必须精确 |
| `PLL_B` | 50 MHz | **100 MHz**（50 × 2） | 系统域，整数倍，精确 |

**C1 阶段其实只需要 `PLL_A`** —— 因为这一步还没有键盘和 UART。`PLL_B` 到阶段 2 再接。

### 3.4 降级方案（重要）

板载晶振的频率目前**还没确认**（官方例程用的是内部 `Gowin_OSC`，没接外部晶振）。

所以 `clock_gen.v` 设计成**参数化**：

```verilog
parameter CLK_SRC = "OSC";   // "OSC" = 用内部振荡器；"EXT" = 用外部晶振
```

- 第一版直接用 `Gowin_OSC`（内部振荡器，省掉查晶振的事），先把声音弄响
- 等确认了晶振频率，改一个参数就切到外部

> 这符合"先让声音响起来比一步到位更重要"的原则。

---

## 4. 采样节拍（sample_scheduler）

三个输出：

| 信号 | 频率 | 波形 | 用途 |
|---|---|---|---|
| `sample_tick` | 48 kHz | **单拍脉冲**（1 个 clk_fs 周期宽） | 音频核心的唯一样本节拍 |
| `bck_en` | 3.072 MHz | 时钟使能（不是门控时钟！） | I2S 位时钟的节拍 |
| `bck` | 3.072 MHz | 方波输出 | 送给 `HP_BCK` |

**实现要点**

- 12.288 MHz ÷ 4 = 3.072 MHz → 2 位计数器
- 12.288 MHz ÷ 256 = 48 kHz → 8 位计数器，计到 0 时拉高一个 `clk_fs` 周期
- **计数器和脉冲与 I2S 帧天然对齐**：256 / 4 = 64，正好一帧 64 个 BCK

> **绝不要用门控时钟**（`assign gated_clk = clk & en`）。FPGA 里要用**时钟使能**（`if (en) ...`），门控时钟会产生毛刺和时序问题。

---

## 5. I2S 发送器（i2s_tx）

### 5.1 协议参数（已从官方例程核实）

| 参数 | 值 |
|---|---|
| BCK | 3.072 MHz = 64 × LRCK |
| LRCK（HP_WS） | 48 kHz，**低电平 = 左声道** |
| 每声道槽位 | 32 bit |
| 有效数据 | 24 bit，**左对齐放在 32 bit 槽的高 24 位**，低 8 位补 0 |
| 位序 | **MSB 先出** |
| 发送边沿 | 在 BCK 下降沿更新数据 |

### 5.2 ⚠️ 一个必须注意的细节：WS 相位

官方例程里 `HP_WS` 的翻转位置**不是标准 I2S 的 1 个 BCK 延迟**：

```verilog
HP_WS_r <= (b_cnt == 5'd3) ? 1'b0 : ((b_cnt == 5'd19) ? 1'b1 : HP_WS_r);
//                         ↑ 第 3 个 BCK 拉低（左）      ↑ 第 19 个 BCK 拉高（右）
```

**我的做法**：把这个相位做成参数

```verilog
parameter WS_LEFT_PHASE  = 6'd3;    // 左声道起点
parameter WS_RIGHT_PHASE = 6'd19;   // 右声道起点
```

**第一版先照抄官方的 3 / 19**，实测确认能出声之后，再试着改成标准 I2S 相位。**不要凭理论推断**——官方参数是实机验证过的。

### 5.3 实现结构

```
        24 位左采样 ─┐
        24 位右采样 ─┴─> [ 32 位槽移位寄存器 ] ─> HP_DIN
                                ▲
        bck (下降沿) ───────────┘
                                │
        [ 帧计数器 0..63 ] ──> [ WS 相位比较器 ] ──> HP_WS
```

- 帧计数器 `b_cnt` 范围 0~63，一个 BCK 加一
- `b_cnt == WS_LEFT_PHASE` → WS 拉低（左声道），加载左采样
- `b_cnt == WS_RIGHT_PHASE` → WS 拉高（右声道），加载右采样
- 每位在 BCK 下降沿移出

---

## 6. 音源（tone_src）：**临时的，将来会删**

### 6.1 它是什么

一个**固定频率正弦波**发生器：相位累加器 + 正弦波表 ROM。

| 参数 | 值 | 说明 |
|---|---|---|
| 频率 | 1000 Hz（1 kHz） | 便于用示波器/频谱确认 |
| 波表深度 | 256 点 | 小，够用 |
| 波表位宽 | 16 bit 有符号 | 换算成 24 bit 输出 |
| 相位累加器 | 32 bit | 频率分辨率足够 |

相位增量计算：

```
fout = SAMPLE_RATE × (phase_inc / 2^32)
1000 = 48000 × (phase_inc / 4294967296)
phase_inc = 4294967296 × 1000 / 48000 ≈ 89,478,485
```

### 6.2 为什么它必须存在，又必须消失

- **必须存在**：C1 阶段 A 的音频核心还没做好，需要有个音源把链路点亮
- **必须消失**：赛题**严禁**"预录 PCM 播放"。所以：
  - 它只做**单音正弦**，不播放任何音频片段
  - 它放在 `rtl/system/`，接口和 A 的 `audio_core` **完全一致**（24 位采样 + valid）
  - 阶段 2 集成时，把 `tone_src` 换成 `audio_core` 即可，顶层其他部分不动

> **合规说明要写进报告**：C1 阶段的固定正弦是**链路调试信号**，不是音频内容；最终作品的全部音频由播放动作实时合成。

---

## 7. 顶层（synth_top）

```
        ┌────────────────────────────────────────────┐
  OSC ──┤ clock_gen → clk_fs (12.288M) / clk_fsys    │
        │      │                                      │
  rst ──┤ reset_sync → rst_n                         │
        │      │                                      │
        │ sample_scheduler                            │
        │   ├─ sample_tick (48k) ──> tone_src         │
        │   └─ bck / bck_en ──────> i2s_tx            │
        │                              ▲              │
        │        tone_src ── 24bit L/R─┘              │
        │                              │              │
        │                         i2s_tx              │
        └──────────────┬───────────────┬──────────────┘
                 HP_BCK│        HP_WS│        HP_DIN│        PA_EN
                       ▼              ▼              ▼          ▼
                       板载 DAC → 板载功放 → 耳机口 / 扬声器
```

**输出端口（管脚已核实，直接接约束）**

| 端口 | 管脚 | 说明 |
|---|---|---|
| `HP_BCK` | Y17 | 位时钟 |
| `HP_WS` | AB17 | 声道，低=左 |
| `HP_DIN` | AA16 | 数据 |
| `PA_EN` | AB16 | 板载功放控制；官方可发声例程固定为 **低电平常开** |
| `rst_ext` | F4 | S2 按键，1.5V 电平域 |
| `led` | W21 | 心跳指示（证明系统在跑） |

---

## 8. 仿真验证（tb_system）

| # | 检查项 | 判据 |
|---|---|---|
| 1 | 复位期间输出 | `HP_DIN = 0`，无直流冲击 |
| 2 | `HP_WS` 周期 | **20.833 μs**（48 kHz） |
| 3 | `HP_BCK` 周期 | 325.5 ns（3.072 MHz）；一帧 **64 个 BCK** |
| 4 | 左右声道交替 | WS 低 32 个 BCK、高 32 个 BCK |
| 5 | 数据对齐 | 左声道 MSB 在 WS 拉低后的正确位置 |
| 6 | 正弦频率 | 输出采样序列重建后 ≈ 1 kHz |

**testbench 必须自动判定**，输出 `PASS` / `FAIL`，不能只让人肉眼看波形。

---

## 9. 上板验证步骤（你来操作）

| 步 | 动作 | 期望 |
|---|---|---|
| 1 | 接 USB，**按住 PWR 键 2 秒**开机 | 板子亮灯 |
| 2 | 命令行烧录 bitstream | 无报错 |
| 3 | LED 是否在闪 | 闪烁 = 系统时钟在跑 |
| 4 | **耳机插 3.5 mm 口** | 听到 1 kHz 纯音 |
| 5 | 示波器测 `HP_WS` | 周期 20.83 μs |
| 6 | 示波器测 `HP_BCK` | 周期 325.5 ns，且是 WS 的 64 倍 |
| 7 | 逻辑分析仪抓三线 | 保存波形到 `evidence/stage1/` |

---

## 10. 我要先问你三件事

### ① 工程放在哪、怎么放？

你指定了 `E:\GowinProjects`。两种放法：

| 方案 | 说明 | 优缺点 |
|---|---|---|
| **A. 源码在仓库，工程在 E 盘**（推荐） | `E:\GowinProjects\synth_top\` 里放 `.gprj`，源码用**相对路径**指回仓库 `D:\...\gowin-fpga-instrument-138k\rtl\` | 版本管理干净，但路径跨盘、Gowin 对跨盘相对路径可能不友好 |
| **B. 整个工程在 E 盘，仓库只存副本** | 在 `E:\GowinProjects\synth_top\` 完整开发，改完手动同步回仓库 | Gowin 用起来最顺，但容易忘记同步 |

我倾向 **A**，但如果 Gowin 跨盘引用报错，就退回 B 并用脚本自动同步。

### ② 时钟源用哪个？

- **先用内部 `Gowin_OSC`**（不用查晶振，立刻能跑） ← 我推荐
- 还是你先去查板载晶振频率，一步到位用外部晶振？

### ③ 器件版本 B 还是 C？

这个**只能看芯片顶面丝印**。在确认之前，我先按 **B** 综合（官方例程就是 B），但**烧录前你必须核对**，选错会"烧录成功但管脚毫无反应"。

---

## 11. 交付顺序（我写完什么给你什么）

| 批次 | 内容 | 你能验证什么 |
|---|---|---|
| 1 | `clock_gen.v` + `sample_scheduler.v` | 仿真看时钟和 48 kHz 节拍 |
| 2 | `i2s_tx.v` + `tb_system.v` | **仿真**验证 LRCK/BCK/数据对齐 |
| 3 | `tone_src.v` + 波表 + `synth_top.v` | 完整顶层，跑综合看资源与时序 |
| 4 | `tools/build.tcl` + 命令行综合布线 | 拿到 bitstream |
| 5 | 上板 | **耳机响** |

**每批我都会在命令行真跑一遍，把报错修干净再给你**，不会给你跑不通的代码。
