user-lqt/gowin-fpga-instrument-138k/docs/高云FPGA电子乐器项目总计划书_最终版.md

# 高云 FPGA 电子乐器 · 项目总计划书

> 总控与作战手册：系统数据流、三条独立链路、冻结接口、4 个阶段与决策门、验收卡、保底路线。**全员必读，先于个人任务书。**
>
> 本文档由团队原始 Word 文件自动转换归档，内容未作修改。
> 权威的接口与平台信息以 `INTERFACE_FREEZE.md` 和 `PLATFORM_TANG_MEGA_138K.md` 为准。

---

高云 FPGA 实时多音色合成电子乐器项目总计划书
面向全国大学生嵌入式芯片与系统设计竞赛 2026 高云赛道赛题二
文档定位：这是项目的总控与作战手册。它让成员和 AI 先理解整个系统要解决什么问题、为什么这样拆分、各阶段怎样从独立模块走向比赛成品，再去阅读并执行成员 A、B、C 三份个人任务书。个人任务书负责“我具体写什么”；本文件负责“整个团队为什么这样做、何时合并、什么才算完成”。
1 项目首先要回答的问题
我们不是要做一个“播放音乐文件的 FPGA 播放器”，而是要做一个由演奏动作驱动、由 FPGA 硬件逻辑逐样本生成声音的实时电子乐器。评委应能看到：按下/触摸/施压等动作先变成控制事件，事件进入 FPGA 内部的声部和振荡器，最后通过 I2S 输出到 DAC；音频不是预录的整段 PCM。
问题
本项目的答案
演奏者输入什么
音符、按键触发/释放、力度、编码器/距离/触摸等连续表情
FPGA 计算什么
音符到频率、相位累加、波表/FM/加法音色、ADSR、复音混音
如何发声
FPGA 生成采样 → C 的后端管线 → I2S → PCM5102A → 音箱
如何证明合规
RTL 可读、测试模式多频率输出、频谱可见独立峰、无整段预录音频播放
基础目标
≥2 独立演奏维度、≥4 复音、独立 ADSR、实时变调、延迟≤10 ms
冲奖方向
16/32 复音或等价振荡器、≥2 音色、≥3 维表情、至少一种硬件音效、延迟≤5 ms
2 赛题要求如何转成工程指标
所有工程决策都围绕四条验收链路：输入链路、合成链路、输出链路、证据链路。每条链路都必须有独立仿真、真实硬件验证和可交付证据。
链路
必须实现
必须留下的证据
输入链路
按键/传感器稳定采集，事件和连续参数有明确协议
输入 testbench、波形、延迟/误触发/校准记录
合成链路
逐样本、逐声部实时产生音频，具备复音/ADSR/音色
A 的 RTL、仿真波形、资源报告、多频测试模式
输出链路
固定采样率 I2S、DAC 发声、音效和总音量可靠
C 的 I2S 波形、LRCK/BCK 实测、端到端延迟
证据链路
能向评委解释结构并现场复现
顶层 RTL、频谱、演示脚本、版本标签、故障恢复流程
3 系统大局：从动作到声音的完整数据流
演奏者动作
  ├─ 矩阵键盘：note_id + NOTE_ON/OFF
  ├─ 编码器/距离：音量、音色或连续参数
  ├─ 触摸：触发/位置
  └─ 压力：velocity/力度
             │
             ▼
B：输入与参数界面
  扫描、消抖、滤波、校准、事件打包、UI 页面数据
             │ 标准事件/参数接口
             ▼
A：音频合成与音质优化
  声部管理 → 相位累加器/振荡器 → 音色 → ADSR → 混音
             │ 24 bit 原始音频采样
             ▼
C：音频输出与 FPGA 系统平台
  sample_tick → 音量/音效/峰值 → I2S → PCM5102A
             │
             ▼
有源音箱/功放扬声器

C 同时提供时钟、复位、顶层、管脚约束、性能测试；B 提供 OLED 页面内容；A 提供音频核心状态。
4 三份个人任务书如何衔接
三份个人任务书不是三个互相独立的项目，而是三个可以先独立证明、再通过稳定接口拼接的子系统。阅读顺序建议为：先读本总计划书，再读自己的个人任务书，最后浏览另外两份任务书的接口和边界章节。
文件
成员拿到后要回答的问题
与总计划书的关系
成员A_音频合成与音质优化任务书.docx
我如何从事件生成声音？哪些波形/复音/包络必须仿真和测量？
落实合成链路和音质证据
成员B_演奏输入与参数界面任务书.docx
我如何把动作变成事件？哪些传感器和 UI 可靠？
落实输入链路和用户控制
成员C_音频输出与FPGA系统平台任务书.docx
我如何让采样稳定输出并把系统放到 Tang Mega 60K？
落实输出链路、平台和整机证据
5 为什么必须分成独立工程
Gowin 的 .gprj、顶层、.cst 和 .sdc 很容易被多人同时修改造成冲突；因此 A/B/C 各自拥有自己的仿真工程和目录。
A 可以用 testbench 假事件独立完成 DDS/ADSR；B 可以用波形激励独立完成输入；C 可以用固定正弦样本和 stub 独立完成 I2S/音效。
只有在“独立验收通过”后才合并；合并失败不能反过来阻塞成员继续开发。
最终工程不是三个人同时编辑的共享文件，而是 C 在系统分支上按版本合并的集成结果。
主仓库建议结构：
rtl/audio_core/     A
rtl/input/          B
rtl/ui/             B（页面内容/参数状态）
rtl/system/         C
rtl/common/         C 维护接口定义
sim/audio_core_tb/   A
sim/input_ui_tb/    B
sim/system_tb/      C
project/            C
constraint/         C
6 冻结的接口：三个人靠什么协作
B → A：event_valid, event_type, note_id[6:0], velocity[7:0], param_valid, param_id[3:0], param_value[15:0]
A → C：audio_core_valid, audio_left/right signed[23:0], active_voice_count[5:0], engine_ready, overload_flag
B → C：ui_page[3:0], ui_param_value[15:0], key_state[15:0], sensor_state, input_ready, ui_dirty
C → B：system_ready, audio_locked, i2s_active, system_error
EVENT_NOTE_ON、EVENT_NOTE_OFF、EVENT_PARAM_CHANGE 的编码在阶段 0 冻结。
所有模块明确 clk、rst_n、sample_tick、valid 脉冲宽度和复位值。
接口只传语义，不传对方内部实现：A 不知道事件来自哪个传感器，C 不知道 A 如何生成波形。
接口变更必须增加版本号并同步更新两个相关 testbench。
7 开发方法：先独立证明，再逐层合并
模块级仿真：每个人用自己的 testbench 证明内部逻辑，先不接真实硬件。
模块级综合：A/B/C 分别检查 RTL 能否综合；A 看音频资源，B 看状态机，C 看 I2S/效果资源。
接口级仿真：C 用 stub 或真实模块检查边界握手、时钟和状态传递。
板级最小链路：C 先用固定样本让 DAC 发声，再接 A 的真实采样。
系统级基础版本：接入 B 的键盘和参数，完成 4 复音和第二演奏维度。
冲奖扩展：在阶段 2 标签上分支扩展，任何新增功能先独立验证，避免破坏可提交版本。
8 阶段 0：工程、硬件和接口冻结
阶段目标：用最少代码消除最大的不确定性。结束时三个人应能同时开工，且不再反复争论接口和板卡基础信息。
成员
必须完成
阶段输出
A
audio_core_sim.gprj；事件输入空壳；采样率/定点/位宽方案
接口草案、tb 框架、定点说明
B
input_ui_sim.gprj；事件和参数定义；键位映射；外设电平表
输入接口、键位表、电平风险表
C
synth_top.gprj、audio_system_sim.gprj；Tang Mega 60K 器件/时钟/初版管脚
工程骨架、common 文件、约束初版
通过条件：三个工程能打开；三个 testbench 能运行；事件和音频接口字段、方向、宽度、复位值冻结。
未通过时不进入复杂功能开发；否则后续代码会建立在不稳定接口上。
9 阶段 1：三条独立最小链路
阶段目标：证明每个人负责的核心技术“单独就能工作”。
A 合成核心
B 输入界面
C 输出平台
单音 DDS/波表；NOTE_ON/OFF；基础采样
矩阵扫描；消抖；NOTE_ON/OFF；简单参数
固定正弦/ROM；sample_tick；I2S；PCM5102A
验证频率、相位、静音、释放
验证一次按键一次事件、无重复
验证 LRCK≈48 kHz、BCK/DATA 对齐、稳定发声
交付 RTL、testbench、波形、资源初测
交付 RTL、testbench、事件波形
交付 RTL、testbench、逻辑分析仪结果
首次集成步骤
C 先用 stub 连接 A/B 接口，验证顶层时序和状态线。
C 保留固定样本 I2S 回归测试，接入 A 后仍能一键切回。
接入 B 时先只用矩阵键盘，不同时引入触摸和压力。
第一次合并只追求“按键→单音→DAC”，不追求 32 复音和漂亮 UI。
10 阶段 2：基础可提交版本
阶段目标：形成随时可以提交、演示和回退的基线。所有冲奖开发都不能破坏这条基线。
模块
必须实现
清晰的完成定义
A
4～8 复音、独立 ADSR、声部分配、混音、限幅
同时按下多个键可听到不同音高；松键平滑释放；无明显混音回绕
B
矩阵键盘 + EC11 编码器；参数管理；OLED 页面内容
至少两个独立演奏维度；旋钮变化能改变音量/音色/滑音；页面显示一致
C
真实 A/B 接入；I2S；LED/调试；延迟测量
按键到 DAC 总延迟≤10 ms；连续运行 30 分钟；可复位恢复
基础版本冻结检查
给 Git 打 stage2-baseline 标签并备份 bitstream。
记录器件资源、最高频率、延迟、已知问题和演示步骤。
如果阶段 3 失败，比赛仍使用 stage2-baseline，不允许临近比赛时没有可运行版本。
11 阶段 3：冲奖扩展的优先级
冲奖不应按“想到什么做什么”，而应按收益/风险排序。每完成一个功能都要回归阶段 2 测试。
优先级
A
B
C
为什么
P1
16 复音或第二音色
触摸或力度一种
一种硬件音效、性能计数
投入适中，展示效果明显
P2
32 复音/FM/加法
第三维表情、校准
实时波形/频谱、延迟优化
提高评分但资源/调试增加
P3
声部抢占与音质精修
完整触摸+力度面板
更多效果、现场故障恢复
最后阶段才做，不能影响基础版本
冲奖合并规则
每次只合并一个大功能，记录资源增量和延迟变化。
如果时序、资源或稳定性恶化，先降低并行度/效果复杂度，不立即重写全部架构。
冲奖功能必须有演示价值和可验证证据；不能只存在于代码里。
12 阶段 4：成品化和比赛现场
成员
现场前必须完成
A
音色参数固化；切音/爆音处理；多频测试模式；最终音频核心和资源报告
B
面板、触摸电极、压力传感器固定；校准；稳定输入路线；OLED 演示页面
C
最终顶层、约束、bitstream、上电自检、故障恢复、延迟/时序/连续运行证据
现场演示固定脚本
上电：OLED/LED 显示 ready，确认没有 error。
单音：按几个不同键，确认音高变化。
和弦：同时触发 4 个以上音符，显示活跃声部。
表情：旋钮/触摸/压力改变音量、音色或效果。
测试模式：输出不同频率，连接频谱设备观察多个峰。
复位恢复：执行一次复位或重新上电，系统回到可演示状态。
13 每个人和 AI 的工作循环
理解目标 → 写接口/假数据 → 独立仿真 → 小步综合 → 记录证据 → 提交分支 → C 集成 → 系统回归
AI 开始工作前必须读本总计划书和对应个人任务书，复述自己负责和不负责的目录。
AI 先提出最小实现和验证方式，再写代码；不能一上来生成整个大系统。
成员必须把真实板卡测量结果、逻辑分析仪截图、综合报告和听感问题反馈给 AI。
AI 输出必须标记：仿真已证明、综合待确认、上板必须测量、人工决策项。
14 关键风险、保底路线和决策门
决策门
继续条件
不满足时的保底
M1 阶段1结束
单音 DAC 稳定发声
只保留固定样本/I2S 调试，暂停高级音色
M2 阶段2结束
≥4复音、2维交互、≤10 ms
冻结基础版本，冲奖全部降级
M3 阶段3中期
新增功能不破坏 stage2-baseline
回退到标签版本，删掉最高风险功能
M4 决赛前
连续运行、复位、现场脚本可复现
使用最稳定音色/输入路线，不追求全部功能
15 完成定义
项目完成不是“代码很多”，而是以下事项同时成立：A 的合成核心能用标准事件逐样本生成声音；B 的输入和参数界面能稳定产生事件并让演奏者可控；C 的系统平台能把采样可靠送到 DAC，并完成时钟、约束、音效和整机验证；基础赛题指标有实测证据；至少一个冲奖方向可演示；所有代码能从冻结版本复现。
16 与三份个人任务书的最终使用方式
全体先阅读本总计划书，理解系统数据流、阶段门和保底路线。
成员 A 打开“成员A_音频合成与音质优化任务书”，只实现音频核心目录和仿真。
成员 B 打开“成员B_演奏输入与参数界面任务书”，只实现输入/UI 目录和仿真。
成员 C 打开“成员C_音频输出与FPGA系统平台任务书”，维护顶层、约束、I2S、音效、系统验证。
每阶段由 C 发起合并，但是否进入下一阶段由本总计划书的通过条件决定。
17 阶段验收总规则
每个阶段结束时必须召开阶段验收，不能以代码写完作为完成标准。必须同时检查功能、仿真、综合、真实硬件、证据和版本冻结。只有硬性门槛全部满足，才能进入下一阶段。
等级
含义
处理
通过
全部硬性门槛满足且证据齐全
打阶段 Git 标签，备份工程和 bitstream
有条件通过
核心目标满足，但存在已记录的非阻塞问题
列出责任人和截止时间，不得隐瞒
不通过
硬性门槛未满足或结果不可复现
停止扩展，回到本阶段定位并启用保底路线
18 阶段 0 最终验收卡：工程、硬件和接口冻结
目标是让三个人可以并行开发，且后续不再反复修改基础接口。
项目
必须看到的结果
通过门槛
独立工程
audio_core_sim、input_ui_sim、audio_system_sim 均可打开
无缺失文件和路径错误
仿真顶层
tb_audio_core、tb_input、tb_system 均能启动并结束
每个 testbench 至少有 PASS 条件
接口冻结
事件、参数、音频、UI、状态字段/位宽/复位值
A/B/C 已确认，无未决字段
板卡信息
Tang Mega 60K 器件、时钟、初版管脚表
C 能解释关键接口来源和电平
代码边界
目录所有权、分支和合并规则
成员无需修改他人私有目录即可开工
阶段 0 通过后的冻结物
Git 标签 stage0-freeze。
event_defs.vh、status_defs.vh、三个工程和 testbench 骨架。
Tang Mega 60K 初版 .cst/.sdc。
接口变更流程和责任人。
19 阶段 1 最终验收卡：三条独立最小链路
A、B、C 必须分别证明自己的核心技术能脱离其他人的内部实现独立工作。
成员
验收动作
硬性门槛
证据
A
tb 发送 NOTE_ON/OFF，观察单音采样
音高可计算、复位静音、NOTE_OFF 后回零/静音
testbench、波形、频率计算、RTL
B
tb 模拟行列电平和抖动
一次按下一个 NOTE_ON、松开一个 NOTE_OFF、无抖动重复
输入波形、事件计数、键位表
C
固定正弦/ROM 样本经 I2S 到 PCM5102A
LRCK 约48 kHz、BCK/DATA 对齐、左右声道稳定、音箱发声
仿真波形、逻辑分析仪、接线记录
阶段 1 通过后的冻结物
Git 标签 stage1-minimal。
固定样本 I2S 回归测试。
A 单音、B 键盘、C I2S 的可复现实验配置。
20 阶段 2 最终验收卡：基础可提交版本
本阶段结束必须得到随时可提交、可演示、可回退的版本。
类别
测试方法
硬性通过条件
复音
同时触发多个不同音符
至少4个独立声部可闻且音高可区分
ADSR
按下、保持、松开并观察包络/听感
每声部独立，松键平滑释放，无明显硬切
双维度
键盘触发音符，编码器/第二输入改变参数
两个维度独立，连续操作不丢事件
I2S/DAC
真实板卡连续演奏
无周期中断、严重杂音、随机静音
延迟
输入标记到 DAC 数据变化的测量
总延迟≤10 ms
稳定性
连续运行30分钟并多次复位
不死机，复位后恢复，状态显示正确
合规证据
检查 RTL、波形、综合报告和测试模式
能证明 FPGA 逐样本生成而非预录播放
阶段 2 通过后的冻结物
Git 标签 stage2-baseline。
可提交 bitstream、工程压缩包、资源/时序/延迟记录。
固定演示：单音、和弦、第二维控制、复位恢复。
已知问题清单和负责人。
21 阶段 3 最终验收卡：冲奖扩展
每项冲奖功能单独验收，并回归 stage2-baseline。
方向
验收方法
硬性门槛
高复音/振荡器
多频测试+频谱+资源报告
达到申报的16/32复音或等价振荡器，谱峰可辨
第二音色
现场切换两种音色并做单音/和弦
差异可听/可测，切换不死机，不播放预录片段
第三维表情
同时改变音符、力度、连续参数
三维独立、变化平滑、噪声不造成明显颤动
硬件音效
同一音符旁路/开启对比
至少一种 FPGA 实时效果，旁路可靠，资源可接受
低延迟
不同复音/效果状态重复测量
目标≤5 ms；否则保留≤10 ms基础版本
可视化/测试
启动波形/频谱/多频模式
现场可启动，显示与真实状态一致
阶段 3 通过后的冻结物
Git 标签 stage3-award。
每项功能的资源、时序、延迟和演示证据。
stage2-baseline 可一键构建，冲奖分支独立保留。
22 阶段 4 最终验收卡：成品化和比赛现场
场景
操作
通过条件
冷启动
完全断电后上电
规定时间内 ready，无错误
基础演示
单音、音阶、和弦
每次可重复，音高和复音正常
表情演示
改变旋钮/触摸/力度
音量、音色或效果按预期变化，无明显误触发
测试模式
多频输出并观察频谱
多个独立峰可见且能解释来源
故障恢复
复位、重新上电
回到可演示状态并有状态提示
长时间运行
连续运行和间歇演奏
无死机、无周期性中断
安全检查
核对 FPGA、DAC、功放、电源、示波器接地
无5V直入FPGA；BTL负端不接地；供电明确
最终版本必须冻结
Git 标签 stage4-final。
最终 .gprj、.cst、.sdc、RTL、仿真、bitstream 和演示脚本。
从零构建/下载/演示步骤。
已知限制表和启用功能清单。
23 阶段验收会议流程
每位成员先展示自己的独立 testbench 和结果。
C 展示系统仿真、综合/布局布线和真实板卡；B 展示输入波形/校准；A 展示音频波形/频谱/资源。
逐项对照验收表填写通过、问题、证据路径。
硬性门槛全部勾选后才打 Git 标签。
未通过项目指定责任人、复测时间和保底方案。
24 失败时的判断顺序
先确认供电、复位、时钟、管脚，再怀疑算法。
先用固定样本验证 C 的 I2S，再接 A；先用 testbench 验证 B 事件，再接真实传感器。
先减功能保住 stage2-baseline，再优化资源或恢复冲奖功能。
把“听起来不对”转化为波形、频率、频谱、延迟或状态信号问题。
25 局部任务与团队验收的关系
个人任务书中的验收是局部完成条件；本总计划书中的验收卡是团队放行条件。例如 A 完成 8 复音并不等于阶段 2 通过，还必须有 B 的稳定输入、C 的 I2S 输出和≤10 ms 延迟实测。只有局部任务和系统验收同时通过，才能进入下一阶段。
26 最终完成定义
项目完成必须同时满足：A 能由标准事件逐样本生成声音；B 能稳定产生事件、参数并提供可用界面；C 能把采样可靠送到 DAC 并完成平台、音效、约束和整机验证；基础指标有实测证据；至少一个冲奖方向可演示；冻结版本可从零复现。
