user-lqt/gowin-fpga-instrument-138k/evidence/stage1/C1_批次3_16bit槽修正与回归.md

# C1 批次 3：板载 DAC 16bit 槽修正与回归

> 日期：2026-09-25
> 范围：成员 C，阶段 1 音频输出链路

## 结论

板载 DAC 实测只接受 16bit 槽格式。正式顶层已统一为：

- `CLK_DIV_SAMPLE = 256`，音频采样率约 48.0005 kHz
- `CLK_DIV_BCK = 4`，BCK 约 1.53602 MHz
- `i2s_tx DATA_BITS = 16`、`SLOT_BITS = 16`
- 24bit 音频核心样本发送前取高 16 位
- 阶段 1 临时测试音已降为 400 Hz，方便无示波器时听辨；I2S 时钟未改变

这对应 `BCK/LRCK = 32`，与板载 DAC 的官方例程格式一致。24bit 槽格式保留在 `i2s_tx` 参数化接口中，供外置 PCM5102A 等 DAC 使用。

## 仿真回归

以下命令均通过 `tools/sim.ps1` 串行执行，结果为 `RESULT: PASS`：

| Testbench | 验证内容 |
|---|---|
| `tb_rx_golden` | 手工逐位黄金接收模型，正负满量程左右声道均正确 |
| `tb_i2s_tx` | 复位、64 BCK/帧、数据重建、左右声道隔离 |
| `tb_scheduler` | 采样节拍、64 个 `bck_en`/帧、32 BCK/LRCK |
| `tb_top_integration` | 真实调度器驱动 I2S，端到端数据解码 |
| `tb_clock_gen` | 当前 16bit 槽配置的时钟比值与复位释放 |
| `tb_reset_sync` | 异步置位、同步释放、窄脉冲抗毛刺 |
| `tb_tone_src` | 1kHz 音源无 X/Z、左右一致、满量程幅度 |

## 工程构建

`tools/build.tcl` 已用 Gowin V1.9.12 重新执行，综合、布局布线、时序分析和 bitstream 生成完成。由于脚本加入了 `gao/i2s_debug.gao`，本次带片上逻辑分析仪的 bitstream 输出文件为：

`project/synth_top/impl/pnr/ao_0.fs`

`synth_top.fs` 是此前不带 GAO 的旧产物，烧录前应按是否需要片上逻辑分析仪选择对应文件。

仍有两条非致命告警：GAO 捕获信号被替换为延迟节点，以及输入时钟使用通用路由资源。需上板用示波器/逻辑分析仪确认实际波形后再处理。
