user-lqt/gowin-fpga-instrument-138k/evidence/stage1/C1_批次2_完成记录.md

# 批次 2 完成记录：i2s_tx 收敛，全链路仿真通过，bitstream 已生成（C 版）

> 承接 `C1_批次2_重做记录.md`（根因已定位但未收敛）。本文件记录收尾结果。
> 状态：**完成。** 日期：2026-09-24。

---

## 1. 最终结论

- `tb_i2s_tx` **全部 PASS**（复位 / 64 BCK 每帧 / 6 组数据重建 / 左右不串道）
- 回归 5 个 tb 全 PASS：tb_reset_sync / tb_clock_gen / tb_scheduler / tb_tone_src(新) / tb_i2s_tx
- 综合布线**零 ERROR、零时序违例**，资源 134 LUT + 147 FF（<1%）
- 器件版本按实物丝印更正为 **C**，bitstream 已按 C 重新生成
  （`project/synth_top/impl/pnr/synth_top.fs`，顶层为正式 `synth_top`）

## 2. i2s_tx 最终时序依据（推翻"扫描调参"路线）

逐拍推导 Sipeed 官方例程 `audio_i2s/eda_proj/src/audio_drive.v`
（该例程在板载 DAC 上实测发声），确认板载链路吃**左对齐格式**：

- WS 跳变与该声道 MSB 在**同一个 BCK 周期**（非标准 Philips I2S）
- 数据 MSB 先出，槽内高位对齐（32bit 槽、24bit 数据、低 8 位补 0）
- 数据/WS 在 BCK 低半周更新，DAC 在 BCK 上升沿采样

`i2s_tx.v` v2 按此三条规定重写：64bit 帧移位寄存器
`{sample_l, 8'b0, sample_r, 8'b0}`，k=0 装载并立即输出左 MSB，之后每个
PH_LO 移一位。v1 的"仿真穷举装载点"拼凑路线废弃。

## 3. 收尾过程中新抓到的问题（全部已修）

| # | 问题 | 影响 | 修法 |
|---|---|---|---|
| 1 | **tb 接收端模型 bug**（v1 时代遗留）：`ws_d` 每拍更新而采样点隔拍，WS 跳变永远检测不到，bcnt 退化成自由计数器 | 之前"左对右错"鬼影的主要来源之一 | `ws_d` 只在采样点更新（tb v2.1） |
| 2 | tb 重写时引入的 off-by-one：ws 跳变处 bcnt 应从 1 计（v1 原写法），误改为 0 | 锁存窗口错位 1 位、跨槽串数据 | bcnt 跳变处 `<= 6'd1`（tb v2.2） |
| 3 | `tone_src` 例化 `sine_rom` **漏接 .clk** | 音源输出恒为 x，从未真正跑过 | 补上 `.clk(clk_audio)` |
| 4 | `sine_rom.v` 127 个 `16'sd-NNN` 非法字面量 | ModelSim 编译直接报错（该文件从未通过编译） | 批量改为 `-16'sdNNN` |
| 5 | `synth_top` 给 `i2s_tx` 传不存在的参数 `WS_LEAD` | 正式顶层从未综合通过 | 删除该参数 |
| 6 | 器件版本按官方例程误用 B | wiki 明示：版本错则"烧录成功但管脚无反应" | 实物丝印核对为 **C**，build.tcl/.cst 更正 |

## 4. 防回归措施

- 新增 `tb/tb_tone_src.v` 冒烟测试（锁死音源链路：无 x/z、左右同源、输出在动）
- `tb_i2s_tx` 带 `TB_VERSION` 打印，执行"改完先确认版本号"纪律
- `tools/sim.ps1` 已纳入批次 2 全部源文件（此前只编译批次 1 文件）
- `tools/build.tcl` 顶层切换为正式 `synth_top`

## 5. 上板检查单（M1 决策门：耳机出声）

1. 板子接 DEBUG-USB2，长按 PWR 2s 开机
2. Programmer 烧录 `synth_top.fs`（SRAM 模式）
3. 预期现象：`o_locked`（W22）常亮；`o_led`（W21）约 1.5Hz 闪烁；耳机 1kHz 蜂鸣
4. 无声排查顺序：S2 复位（F4）→ 核对烧录器件版本是 C → 示波器量 HP_BCK（Y17，周期 ≈325.5ns）/ HP_WS（AB17，周期 ≈20.83µs）
5. 若音高正常但有杂音/顿挫：怀疑板载 DAC 只认 16bit 槽（官方例程是 16bit 槽），
   把 `i2s_tx` 的 `SLOT_BITS` 改 16 试一次即可定位

---

## 6. 追加（2026-09-24 二审后）：PLL 参数重大修正

二次代码审查对"12.29167 MHz"的来源提出质疑，追查后确认为**致命 bug**，
若按原 bitstream 上板 PLL 不会锁定。三个叠加错误：

| # | 错误 | 后果 |
|---|---|---|
| 1 | `clock_gen` 的 `IDIV_SEL`/`FBDIV_SEL` 参数**从未通过 defparam 传给 PLL 原语** | IDIV 按默认 ÷1 |
| 2 | 文件头"+1 语义"注释是臆测（UG306 表 5-4/5-8：静态值=实际分频值） | 全部分频计算错误 |
| 3 | 由此 VCO = 50×59 = **2950 MHz**，而 138K 合法范围 650~1300 MHz（UG306 §2.3） | 硬件上 PLL 不锁定 |

**实锤证据**：时序报告 Clock Summary 的 Generated Clock 推导值为 36.875 MHz
（=50×59/80），而非注释声称的 12.29167 MHz；若上板 LRCK 会快 3 倍。

**修复过程第四个约束**：先试 IDIV=3，报 `PA2078: PFD 必须 19~81.25 MHz`
（50/3=16.67 不达标）。脚本穷举全参数空间（VCO 与 PFD 双约束）得最优解：

```
IDIV=2, FBDIV=1, MDIV=29, ODIV0=59  →  VCO=725 MHz  →  12.288136 MHz
LRCK = 48000.5 Hz（偏差 +0.0011%，约 0.02 音分 —— 比原目标还准 30 倍）
ODIV1=7 → 103.571 MHz 系统域
```

重建后时序报告确认 Generated Clock = **12.288 MHz** ✓，零 ERROR。
`sample_scheduler`/`synth_check_top`/tb 中的旧频率数字已全部同步修正
（`synth_check_top` 里还发现第三套"+1 误解"参数，一并修正）。

**防回归**：
- 新增 `tb/tb_top_integration.v`：scheduler+i2s_tx 真实互连，锁死
  "每帧 128 bck_en、frame_start 与 sample_tick 1:1"的跨模块关系，PASS
- 纪律：**PLL 频率只看时序报告 Clock Summary 的 Generated Clock 推导值**，
  注释不算数
- 回归 6/6 tb PASS：tb_reset_sync / tb_clock_gen / tb_scheduler /
  tb_tone_src / tb_i2s_tx / tb_top_integration
