user-lqt/gowin-fpga-instrument-138k/companion/phone/scores/YEQU_REVISION.md

# 夜曲开头第二版

依据用户提供的MIDI修正；20次按键、建议200 BPM、默认映射、吉他音色，整体降低一个八度。

删除首版选入的 tick 3084 与 4044 两处疑似和弦经过音；保留 tick 4006 的重复C，补入后续的重复C。不再直接将同一小时间窗的最高音全部当成主旋律。选取源起音 tick 为：892,1012,1127,1203,1373,1488,1734,2086,2333,2449,3123,3293,3406,3654,3892,4006,4251,4368,4967,5327。

按120 BPM原MIDI时间（384 ticks/quarter）与200 BPM目标曲谱建立115.2 tick/单位的时间对应，先量化累计起音位置再求相邻时值，避免独立取整漂移。最短时值仍为一个八分音符单位，不包含原始音长、踏板、伴奏与力度，无法完全还原原MIDI。源旋律分离属于人工候选修订，尚未完成真人听辨验收。

yequ_guitar_opening.txt和兼容旧链接的yequ_guitar_chorus.txt内容一致，以本说明替代README中的初版自动提取规则。
