user-lqt/gowin-fpga-instrument-138k/testing/measurements/reports/lrck/lrck_002/report.html

# LRCK 采样率实测

实测：47999.586 Hz。不是示波器采集采样率。

接线与固件版本为人工确认；周期离散包含仪器误差，不证明无抖动，不代表比赛验收通过。

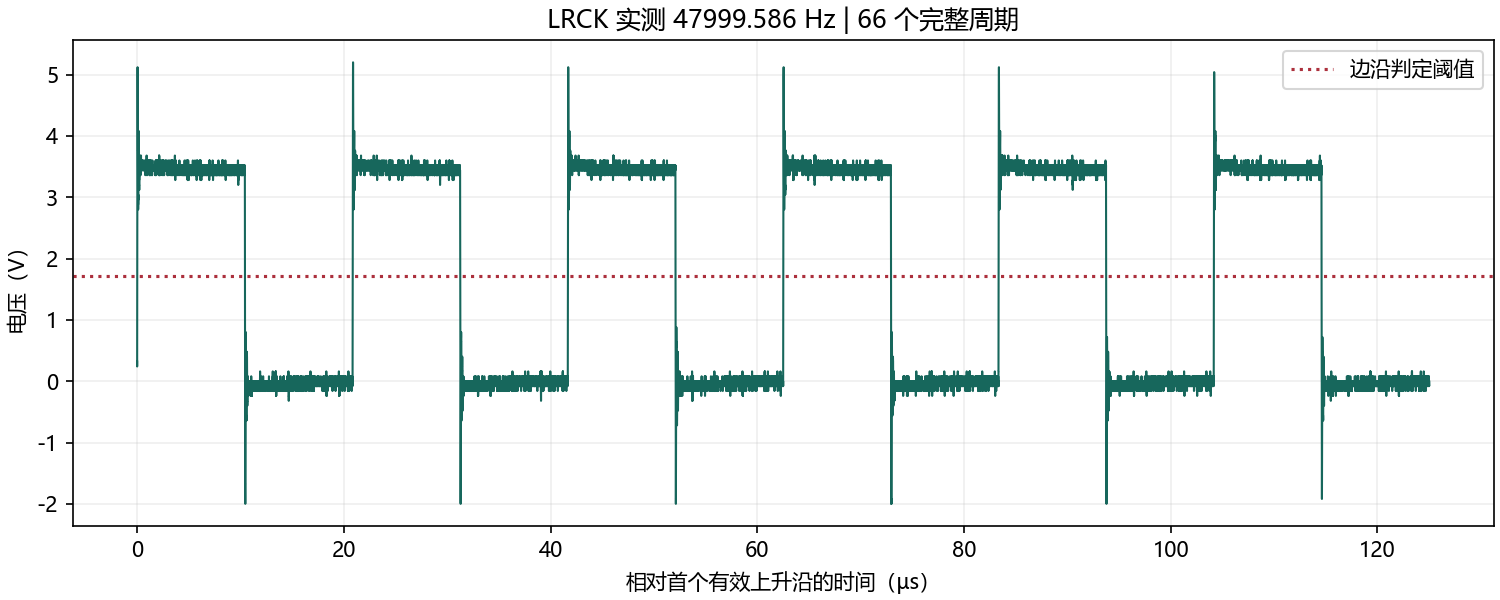
[picture p2: testing/measurements/reports/lrck/lrck_002/lrck_waveform.png]
LRCK 原始数据波形


示波器原始屏幕 · 逐周期数据

LRCK 实测频率（Hz） | 47999.585894523574
平均周期（µs） | 20.83351306816364
最短周期（µs） | 20.819664584700035
最长周期（µs） | 20.848414581824994
观测周期标准差（ns，含仪器误差） | 9.433195631545924
完整周期数 | 66
每周期采样点数 | 20832.666666666675
低电平估计（V） | -0.08
高电平估计（V） | 3.52
边沿判定阈值（V） | 1.72
采样间隔（ns） | 0.9999999
相对标称 48 kHz 的偏差（ppm） | -8.627197425559174
计算方法 | 筛选有效上升沿，线性插值定位阈值，使用全部完整周期
记录类型 | LRCK 采样率分析
原始数据 SHA256 | 8e8368325d098774e8f364f099df03ecab4a0a049ddfb8b055265e87be45f611
示波器身份 | RIGOL TECHNOLOGIES,DS2202A,DS2D192700914,00.03.05.SP1
示波器采集采样率（Hz） | 1000000100.00001
人工记录的固件版本 | C:/Users/lenovo/Desktop/FPGA/FPGA_Instrument_20261031/project/integrated_instrument_64/impl/pnr/integrated_instrument_64.fs
人工指定烧录文件 SHA256 | 2a1c5ea9a07e9421049f5e1623558a684046df6744faac9d5258cddcdec18ef8
接线已经人工确认 | 是
采集元数据 SHA256 | a3db68a7eae60b0711dd97ef83497b0b45e6cde400fa9ae2abd3973f44b82c41
