user-lqt/gowin-fpga-instrument-138k/testing/measurements/reports/polyphony/group02_64_001/report.html

# 复音频率测量证据

DAC 模拟输出实测 | 64 声部 | 第 2 组 | 工具自检：通过
记录时长 0.700000 s；FFT 频点间隔 1.192093 Hz；共同频率缩放拟合系数 1.00001000。频率显示的小数位数不代表仪器测量准确度。
橙色虚线：设计频率。圆点标注：实测 FFT 频点的幅度最大位置。关闭声部不把噪声最大值作为音调频率报告。
此处通过/未通过为工具自检结果；自检阈值不是赛题直接规定，不能替代最终比赛验收。频谱峰数也不能单独证明 RTL 振荡器的独立性。

## 频谱总览

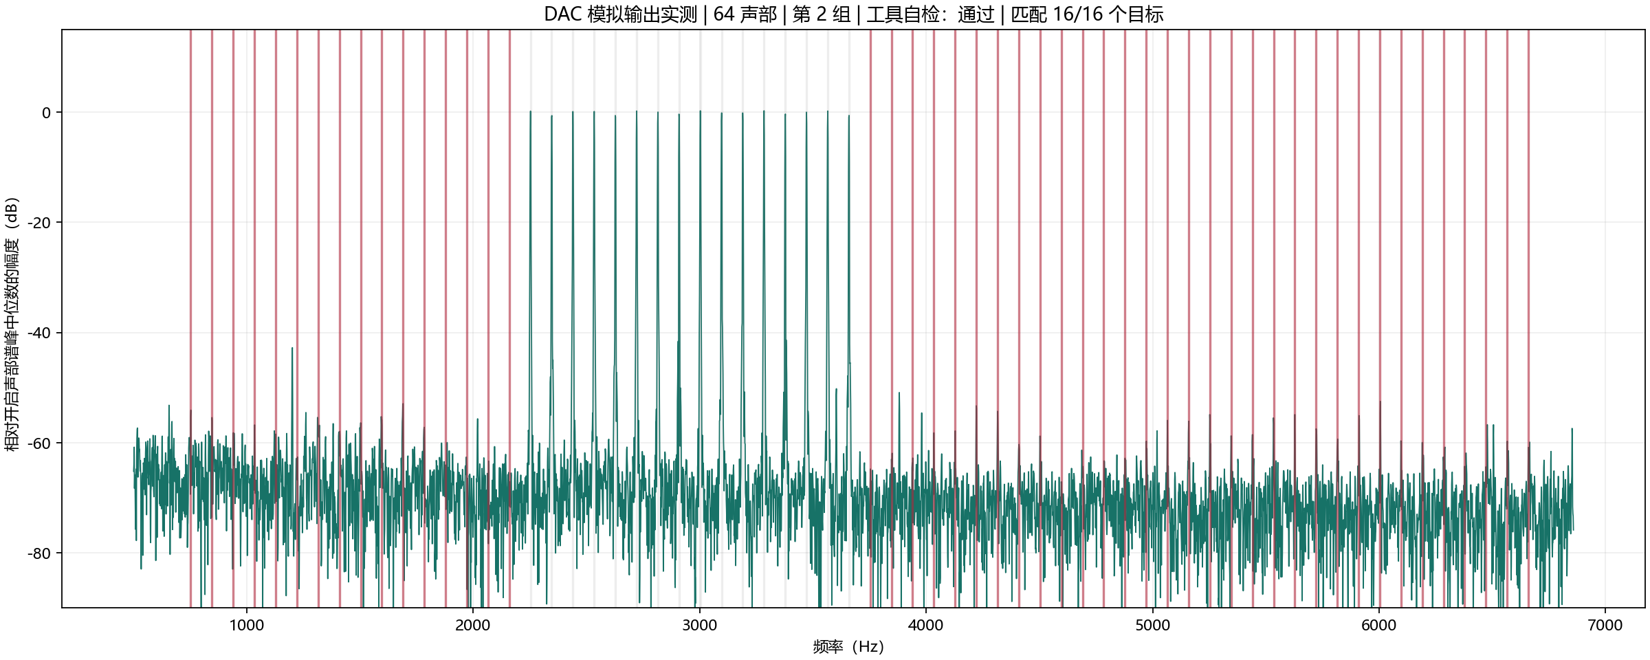
[picture p22: testing/measurements/reports/polyphony/group02_64_001/spectrum.png]
实测频谱总览


## 频率明细

频率偏差 CSV | 可打印频率表

声部 | 状态 | 设计频率（Hz） | 实测频率（Hz） | 频率偏差（Hz） | 目标检查
01 | 关闭 | 752.929688 | -- | -- | 符合
02 | 关闭 | 846.679688 | -- | -- | 符合
03 | 关闭 | 940.429688 | -- | -- | 符合
04 | 关闭 | 1034.179688 | -- | -- | 符合
05 | 关闭 | 1127.929688 | -- | -- | 符合
06 | 关闭 | 1221.679688 | -- | -- | 符合
07 | 关闭 | 1315.429688 | -- | -- | 符合
08 | 关闭 | 1409.179688 | -- | -- | 符合
09 | 关闭 | 1502.929688 | -- | -- | 符合
10 | 关闭 | 1596.679688 | -- | -- | 符合
11 | 关闭 | 1690.429688 | -- | -- | 符合
12 | 关闭 | 1784.179688 | -- | -- | 符合
13 | 关闭 | 1877.929688 | -- | -- | 符合
14 | 关闭 | 1971.679688 | -- | -- | 符合
15 | 关闭 | 2065.429688 | -- | -- | 符合
16 | 关闭 | 2159.179688 | -- | -- | 符合
17 | 开启 | 2252.929688 | 2253.055573 | +0.125885 | 符合
18 | 开启 | 2346.679688 | 2347.230911 | +0.551224 | 符合
19 | 开启 | 2440.429688 | 2440.214157 | -0.215530 | 符合
20 | 开启 | 2534.179688 | 2534.389496 | +0.209808 | 符合
21 | 开启 | 2627.929688 | 2627.372742 | -0.556946 | 符合
22 | 开启 | 2721.679688 | 2721.548080 | -0.131607 | 符合
23 | 开启 | 2815.429688 | 2815.723419 | +0.293732 | 符合
24 | 开启 | 2909.179688 | 2908.706665 | -0.473022 | 符合
25 | 开启 | 3002.929688 | 3002.882004 | -0.047684 | 符合
26 | 开启 | 3096.679688 | 3097.057343 | +0.377655 | 符合
27 | 开启 | 3190.429688 | 3190.040588 | -0.389099 | 符合
28 | 开启 | 3284.179688 | 3284.215927 | +0.036240 | 符合
29 | 开启 | 3377.929688 | 3378.391266 | +0.461578 | 符合
30 | 开启 | 3471.679688 | 3471.374512 | -0.305176 | 符合
31 | 开启 | 3565.429688 | 3565.549850 | +0.120163 | 符合
32 | 开启 | 3659.179688 | 3659.725189 | +0.545502 | 符合
33 | 关闭 | 3752.929688 | -- | -- | 符合
34 | 关闭 | 3846.679688 | -- | -- | 符合
35 | 关闭 | 3940.429688 | -- | -- | 符合
36 | 关闭 | 4034.179688 | -- | -- | 符合
37 | 关闭 | 4127.929688 | -- | -- | 符合
38 | 关闭 | 4221.679688 | -- | -- | 符合
39 | 关闭 | 4315.429688 | -- | -- | 符合
40 | 关闭 | 4409.179688 | -- | -- | 符合
41 | 关闭 | 4502.929688 | -- | -- | 符合
42 | 关闭 | 4596.679688 | -- | -- | 符合
43 | 关闭 | 4690.429688 | -- | -- | 符合
44 | 关闭 | 4784.179688 | -- | -- | 符合
45 | 关闭 | 4877.929688 | -- | -- | 符合
46 | 关闭 | 4971.679688 | -- | -- | 符合
47 | 关闭 | 5065.429688 | -- | -- | 符合
48 | 关闭 | 5159.179688 | -- | -- | 符合
49 | 关闭 | 5252.929688 | -- | -- | 符合
50 | 关闭 | 5346.679688 | -- | -- | 符合
51 | 关闭 | 5440.429688 | -- | -- | 符合
52 | 关闭 | 5534.179688 | -- | -- | 符合
53 | 关闭 | 5627.929688 | -- | -- | 符合
54 | 关闭 | 5721.679688 | -- | -- | 符合
55 | 关闭 | 5815.429688 | -- | -- | 符合
56 | 关闭 | 5909.179688 | -- | -- | 符合
57 | 关闭 | 6002.929688 | -- | -- | 符合
58 | 关闭 | 6096.679688 | -- | -- | 符合
59 | 关闭 | 6190.429688 | -- | -- | 符合
60 | 关闭 | 6284.179688 | -- | -- | 符合
61 | 关闭 | 6377.929688 | -- | -- | 符合
62 | 关闭 | 6471.679688 | -- | -- | 符合
63 | 关闭 | 6565.429688 | -- | -- | 符合
64 | 关闭 | 6659.179688 | -- | -- | 符合

## 标注放大图

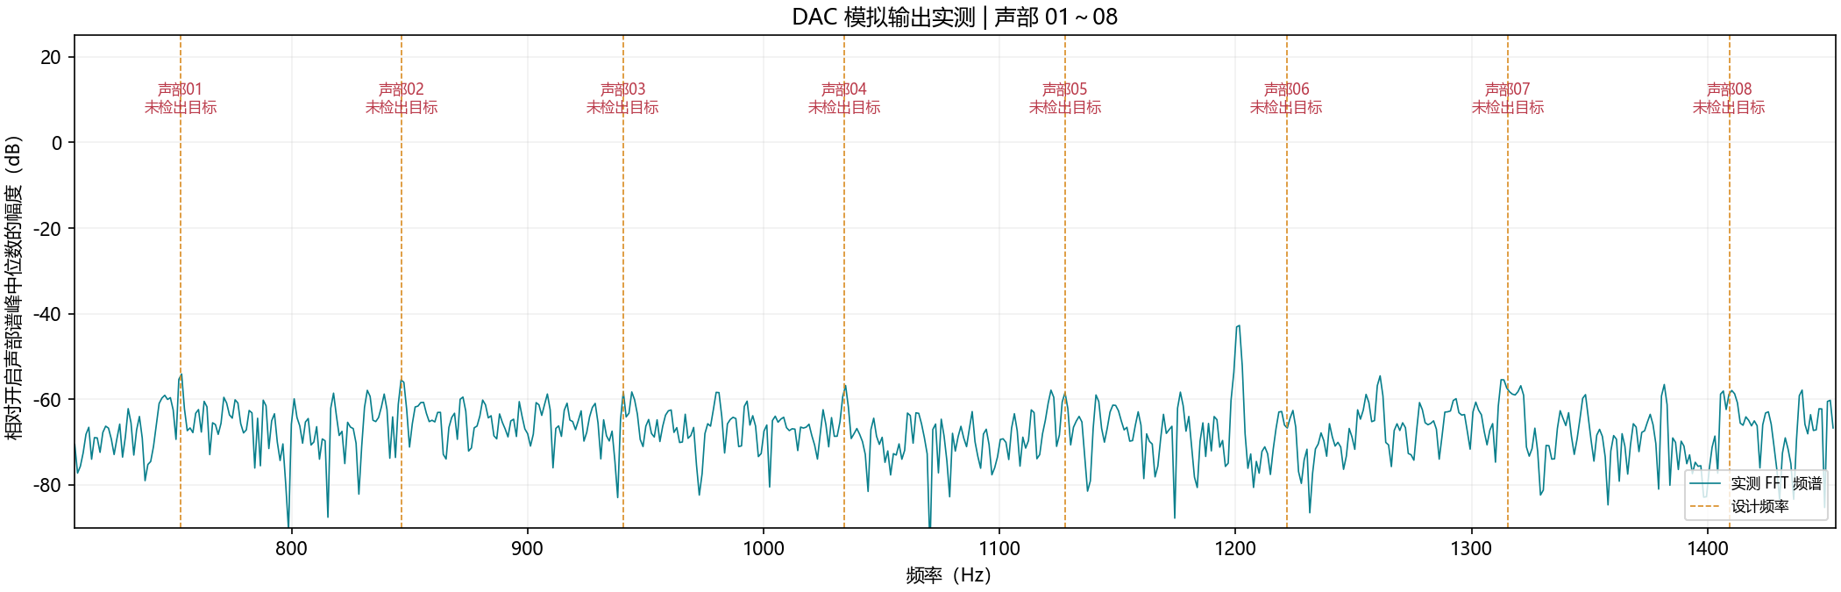
[picture p23: testing/measurements/reports/polyphony/group02_64_001/zoom_01_08.png]
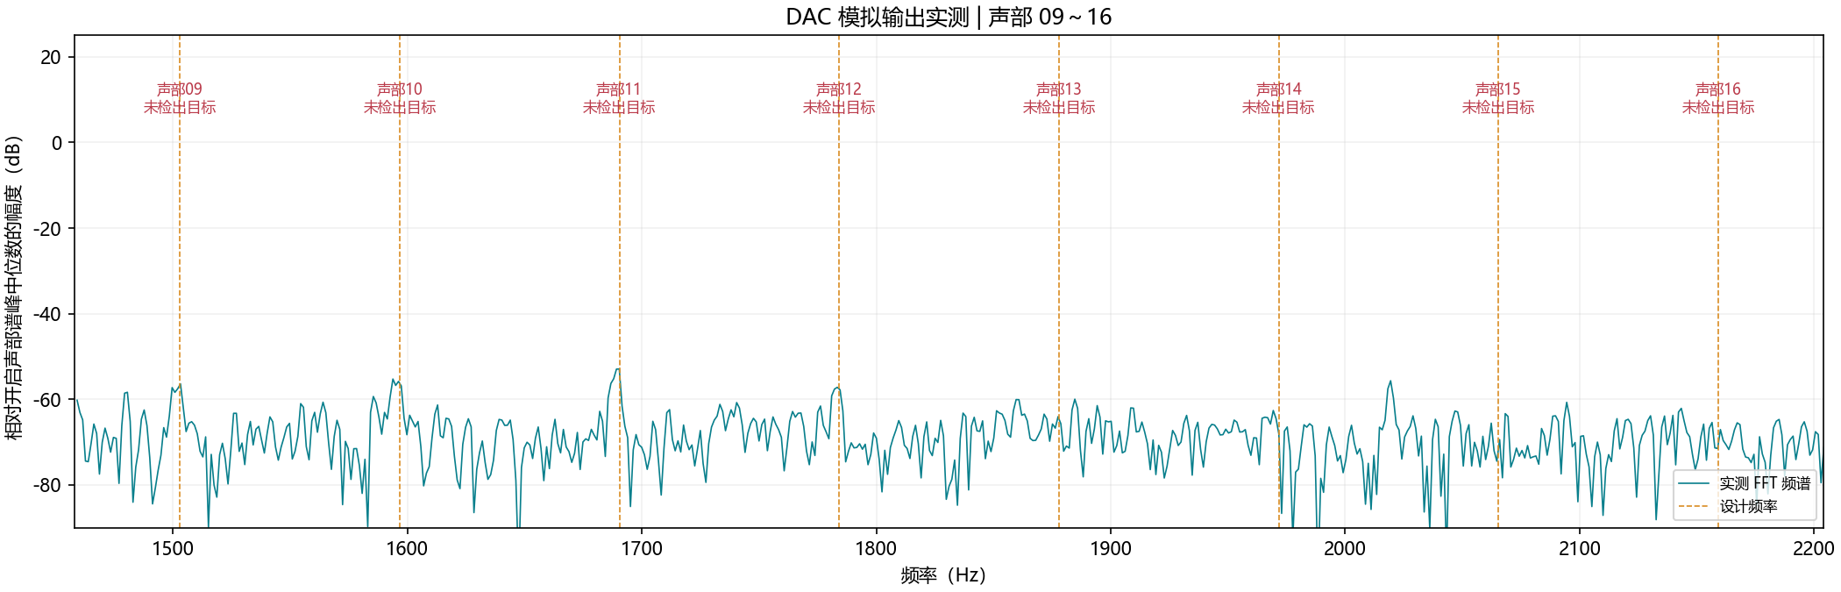
[picture p24: testing/measurements/reports/polyphony/group02_64_001/zoom_09_16.png]
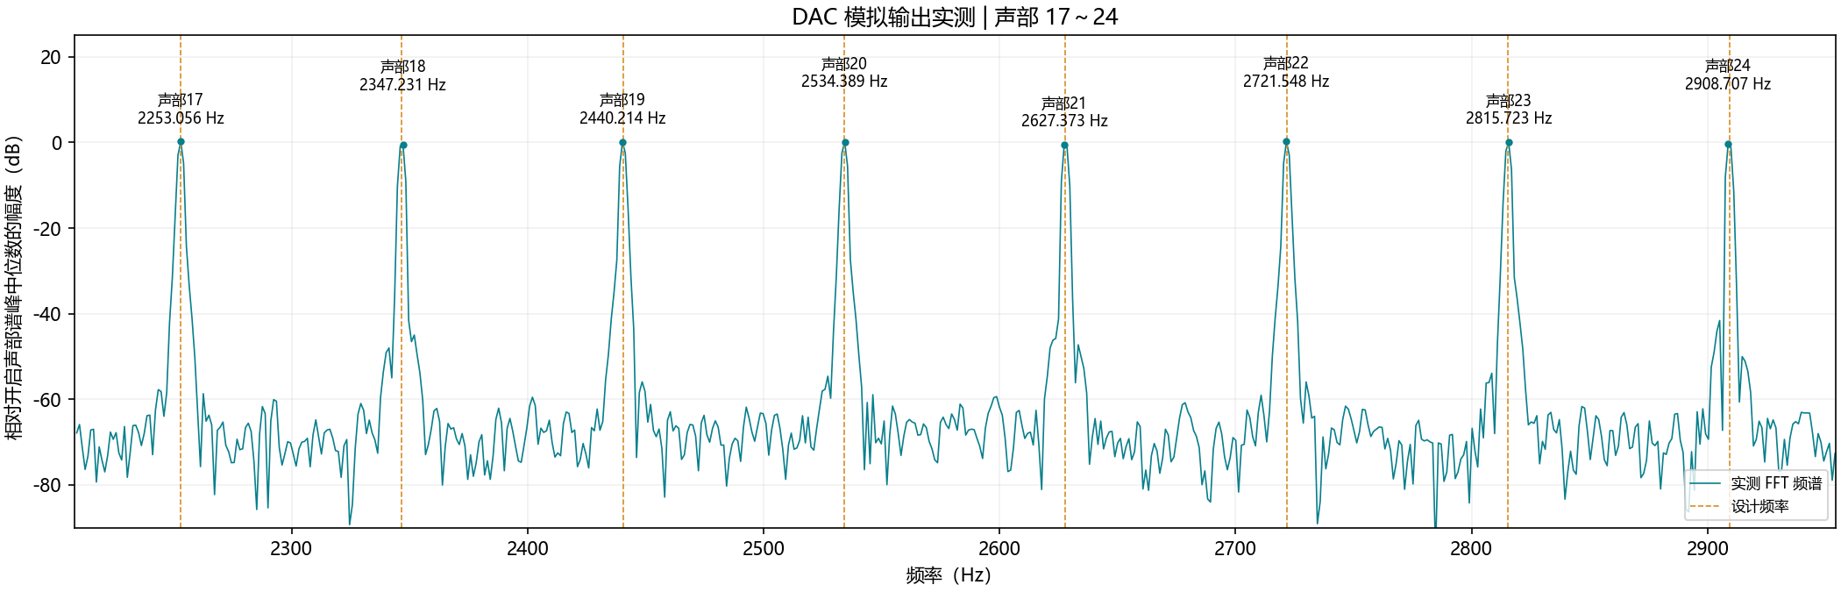
[picture p25: testing/measurements/reports/polyphony/group02_64_001/zoom_17_24.png]
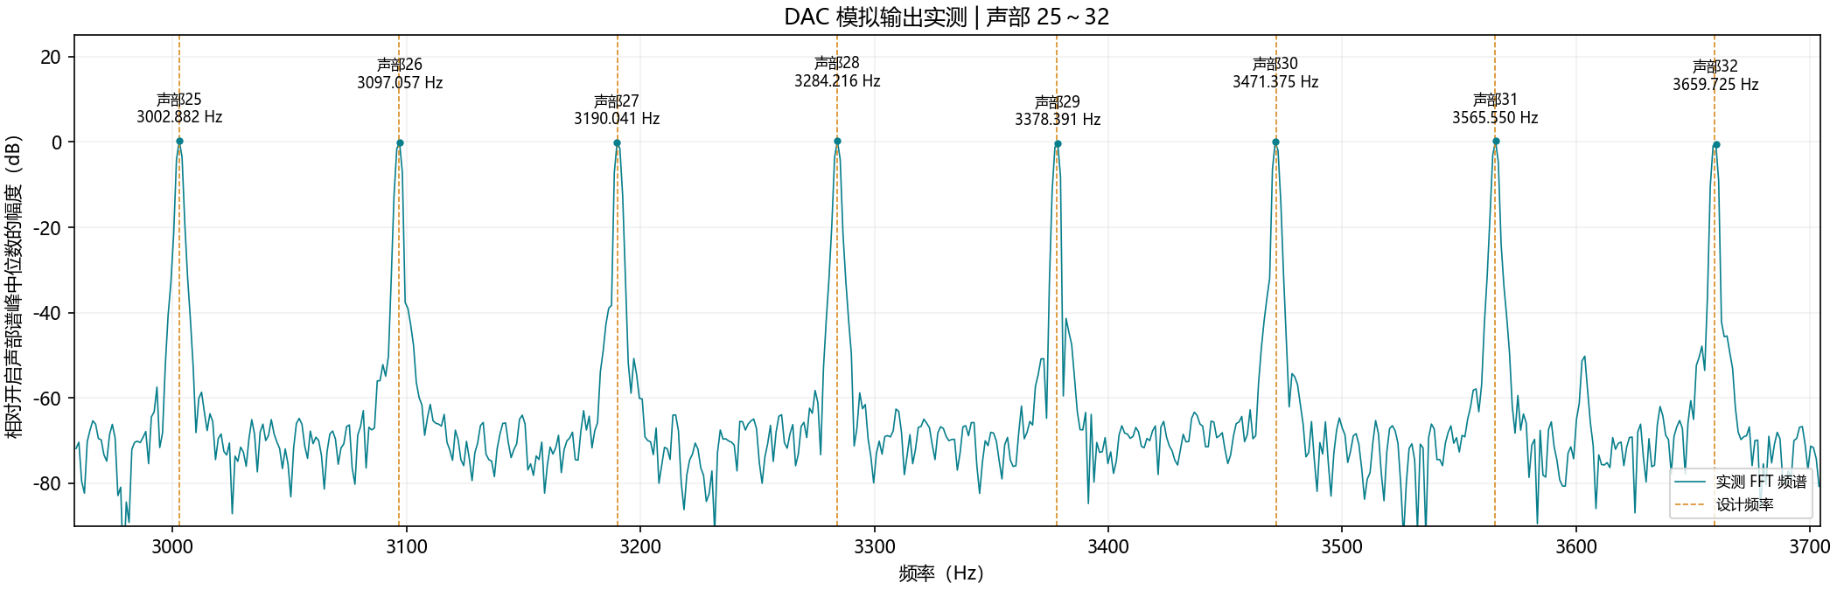
[picture p26: testing/measurements/reports/polyphony/group02_64_001/zoom_25_32.png]
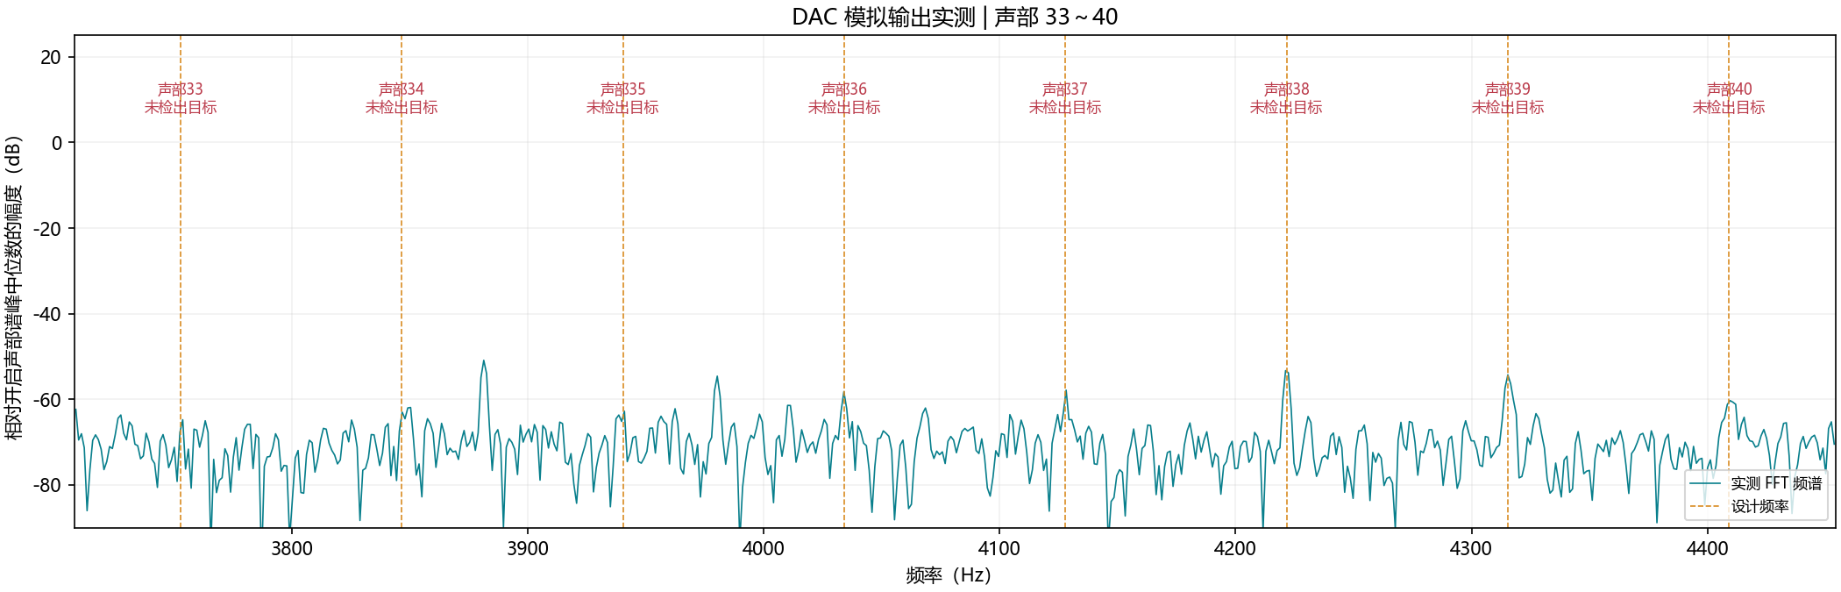
[picture p27: testing/measurements/reports/polyphony/group02_64_001/zoom_33_40.png]
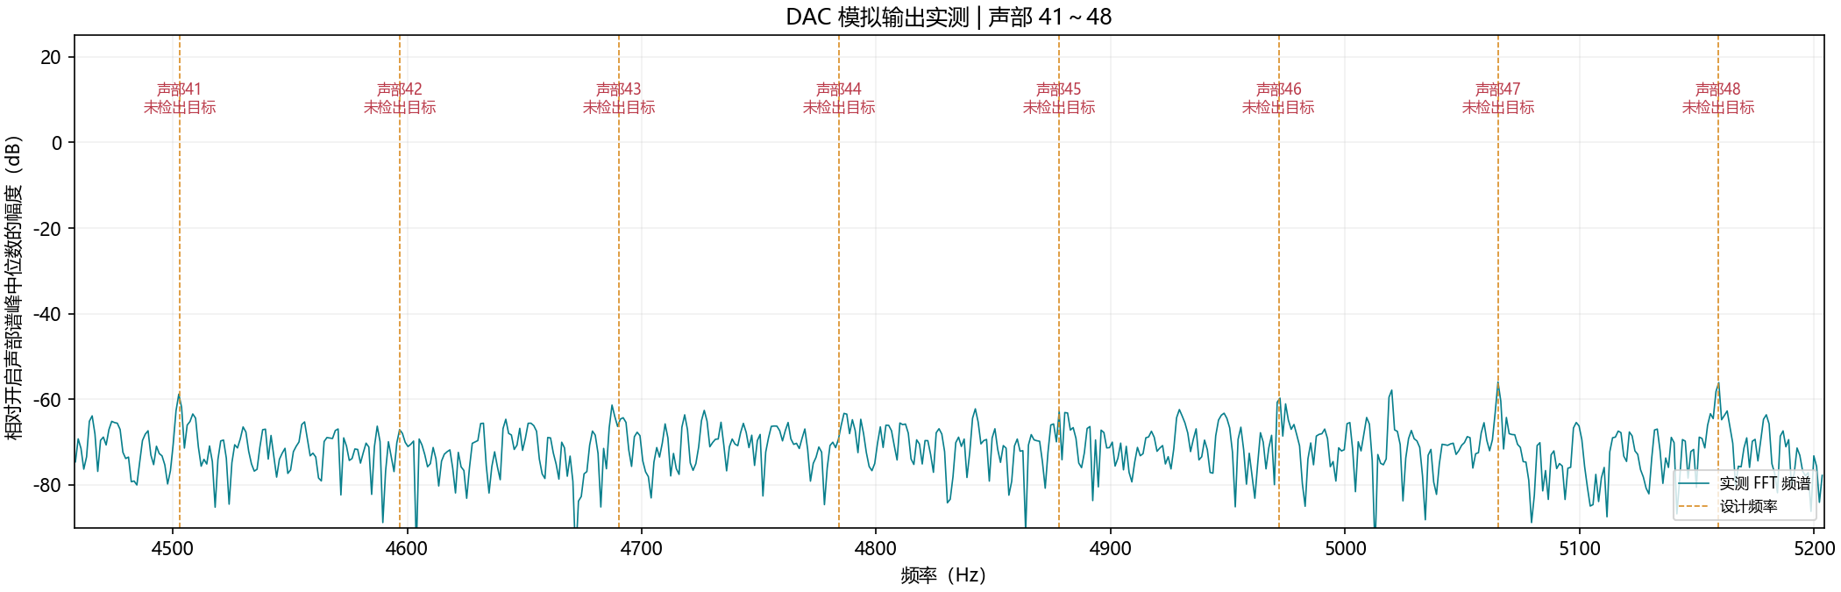
[picture p28: testing/measurements/reports/polyphony/group02_64_001/zoom_41_48.png]
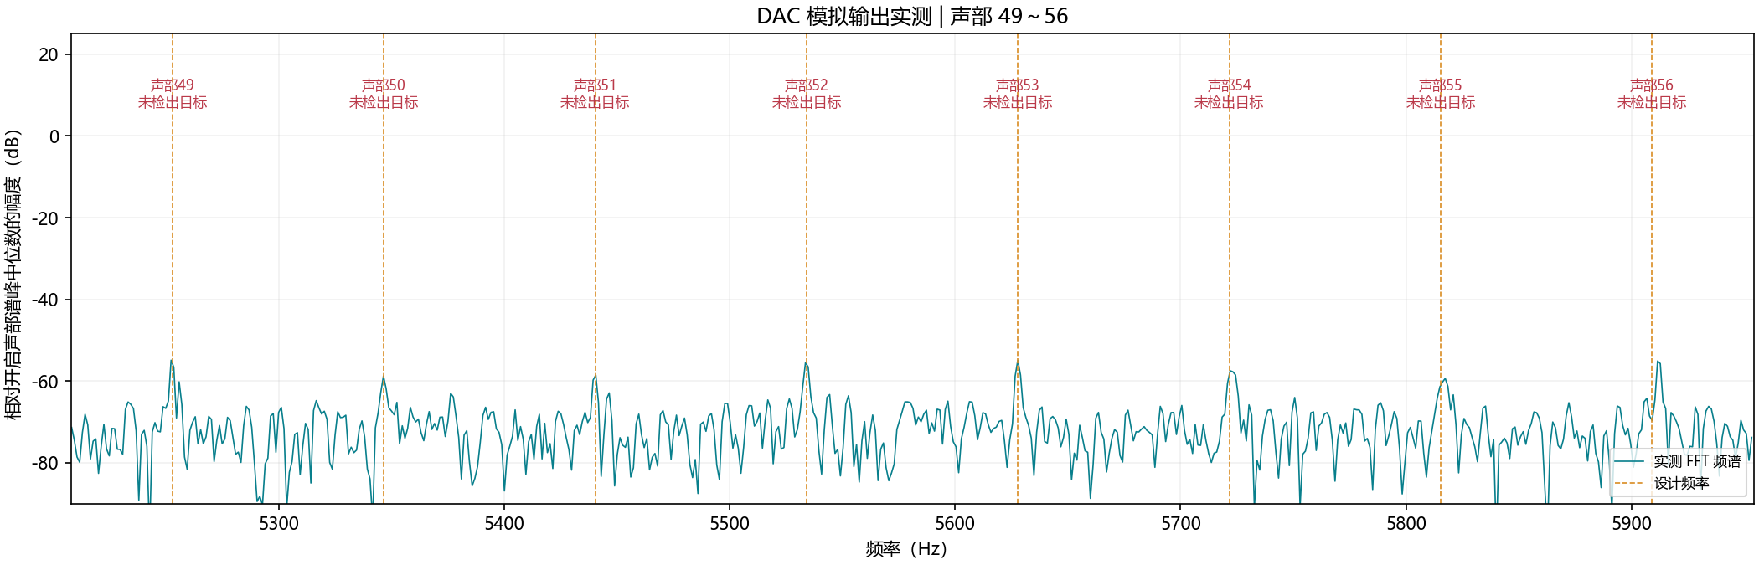
[picture p29: testing/measurements/reports/polyphony/group02_64_001/zoom_49_56.png]
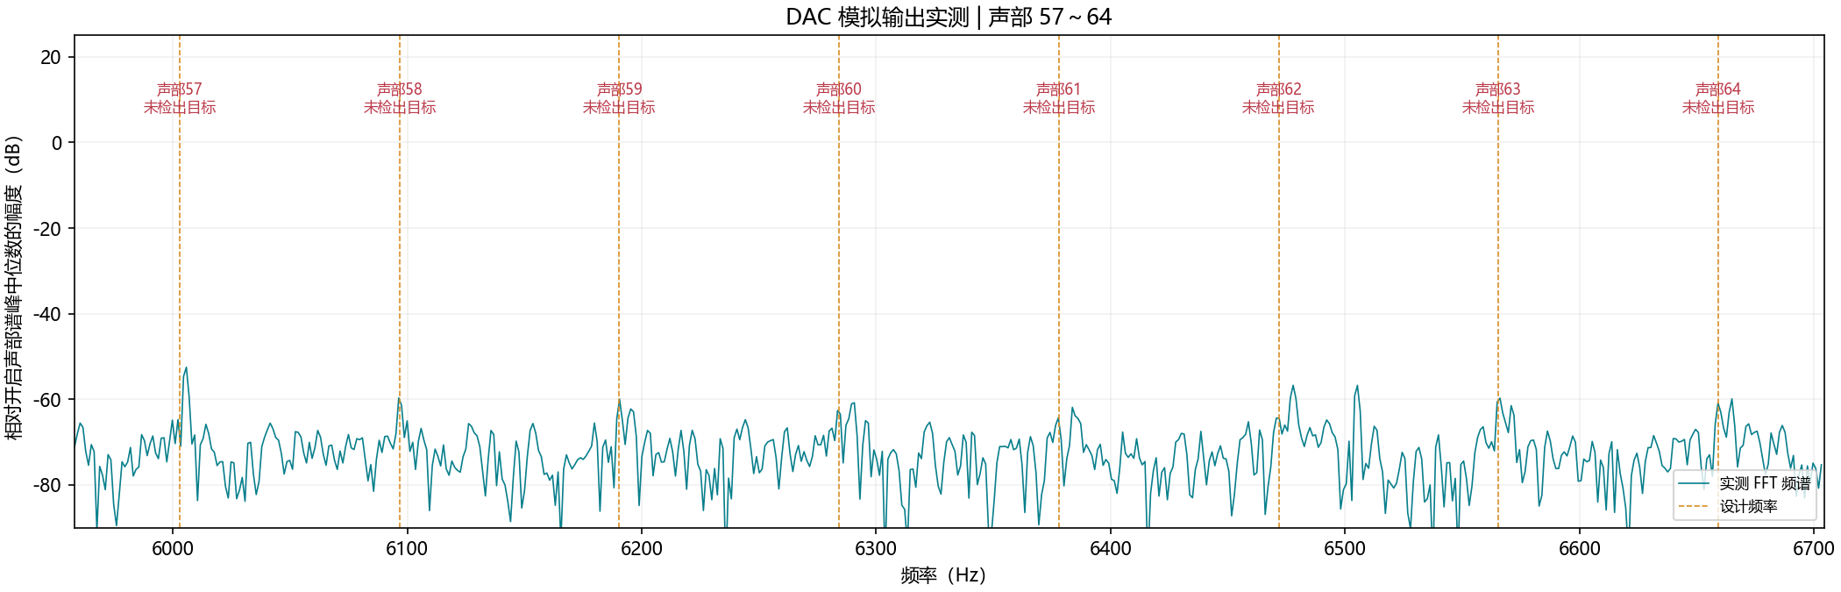
[picture p30: testing/measurements/reports/polyphony/group02_64_001/zoom_57_64.png]
