user-lqt/gowin-fpga-instrument-138k/testing/measurements/reports/polyphony/group03_64_001/report.html

# 复音频率测量证据

DAC 模拟输出实测 | 64 声部 | 第 3 组 | 工具自检：通过
记录时长 0.700000 s；FFT 频点间隔 1.192093 Hz；共同频率缩放拟合系数 1.00000500。频率显示的小数位数不代表仪器测量准确度。
橙色虚线：设计频率。圆点标注：实测 FFT 频点的幅度最大位置。关闭声部不把噪声最大值作为音调频率报告。
此处通过/未通过为工具自检结果；自检阈值不是赛题直接规定，不能替代最终比赛验收。频谱峰数也不能单独证明 RTL 振荡器的独立性。

## 频谱总览

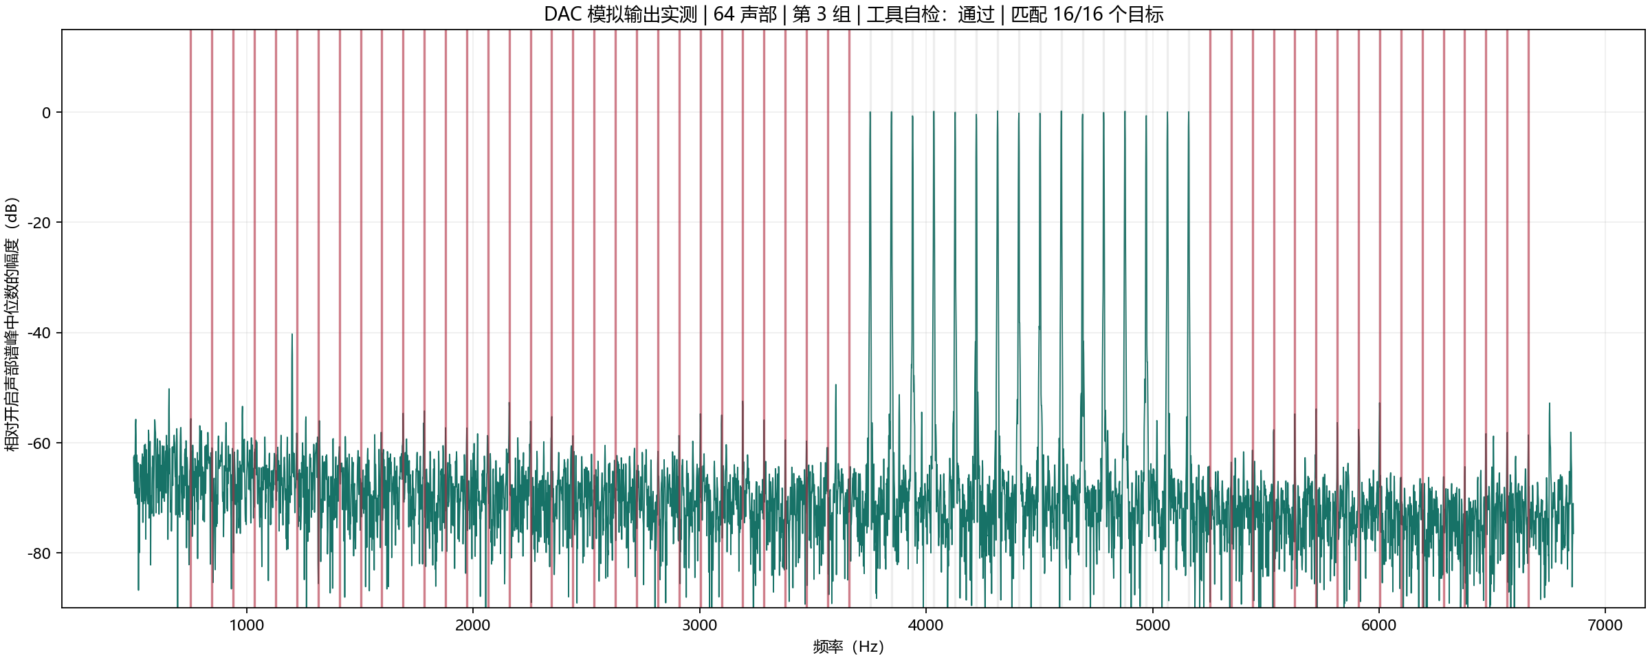
[picture p31: testing/measurements/reports/polyphony/group03_64_001/spectrum.png]
实测频谱总览


## 频率明细

频率偏差 CSV | 可打印频率表

声部 | 状态 | 设计频率（Hz） | 实测频率（Hz） | 频率偏差（Hz） | 目标检查
01 | 关闭 | 752.929688 | -- | -- | 符合
02 | 关闭 | 846.679688 | -- | -- | 符合
03 | 关闭 | 940.429688 | -- | -- | 符合
04 | 关闭 | 1034.179688 | -- | -- | 符合
05 | 关闭 | 1127.929688 | -- | -- | 符合
06 | 关闭 | 1221.679688 | -- | -- | 符合
07 | 关闭 | 1315.429688 | -- | -- | 符合
08 | 关闭 | 1409.179688 | -- | -- | 符合
09 | 关闭 | 1502.929688 | -- | -- | 符合
10 | 关闭 | 1596.679688 | -- | -- | 符合
11 | 关闭 | 1690.429688 | -- | -- | 符合
12 | 关闭 | 1784.179688 | -- | -- | 符合
13 | 关闭 | 1877.929688 | -- | -- | 符合
14 | 关闭 | 1971.679688 | -- | -- | 符合
15 | 关闭 | 2065.429688 | -- | -- | 符合
16 | 关闭 | 2159.179688 | -- | -- | 符合
17 | 关闭 | 2252.929688 | -- | -- | 符合
18 | 关闭 | 2346.679688 | -- | -- | 符合
19 | 关闭 | 2440.429688 | -- | -- | 符合
20 | 关闭 | 2534.179688 | -- | -- | 符合
21 | 关闭 | 2627.929688 | -- | -- | 符合
22 | 关闭 | 2721.679688 | -- | -- | 符合
23 | 关闭 | 2815.429688 | -- | -- | 符合
24 | 关闭 | 2909.179688 | -- | -- | 符合
25 | 关闭 | 3002.929688 | -- | -- | 符合
26 | 关闭 | 3096.679688 | -- | -- | 符合
27 | 关闭 | 3190.429688 | -- | -- | 符合
28 | 关闭 | 3284.179688 | -- | -- | 符合
29 | 关闭 | 3377.929688 | -- | -- | 符合
30 | 关闭 | 3471.679688 | -- | -- | 符合
31 | 关闭 | 3565.429688 | -- | -- | 符合
32 | 关闭 | 3659.179688 | -- | -- | 符合
33 | 开启 | 3752.929688 | 3752.708435 | -0.221252 | 符合
34 | 开启 | 3846.679688 | 3846.883774 | +0.204086 | 符合
35 | 开启 | 3940.429688 | 3939.867020 | -0.562668 | 符合
36 | 开启 | 4034.179688 | 4034.042358 | -0.137329 | 符合
37 | 开启 | 4127.929688 | 4128.217697 | +0.288010 | 符合
38 | 开启 | 4221.679688 | 4221.200943 | -0.478745 | 符合
39 | 开启 | 4315.429688 | 4315.376282 | -0.053406 | 符合
40 | 开启 | 4409.179688 | 4409.551620 | +0.371933 | 符合
41 | 开启 | 4502.929688 | 4502.534866 | -0.394821 | 符合
42 | 开启 | 4596.679688 | 4596.710205 | +0.030518 | 符合
43 | 开启 | 4690.429688 | 4690.885544 | +0.455856 | 符合
44 | 开启 | 4784.179688 | 4783.868790 | -0.310898 | 符合
45 | 开启 | 4877.929688 | 4878.044128 | +0.114441 | 符合
46 | 开启 | 4971.679688 | 4972.219467 | +0.539780 | 符合
47 | 开启 | 5065.429688 | 5065.202713 | -0.226974 | 符合
48 | 开启 | 5159.179688 | 5159.378052 | +0.198364 | 符合
49 | 关闭 | 5252.929688 | -- | -- | 符合
50 | 关闭 | 5346.679688 | -- | -- | 符合
51 | 关闭 | 5440.429688 | -- | -- | 符合
52 | 关闭 | 5534.179688 | -- | -- | 符合
53 | 关闭 | 5627.929688 | -- | -- | 符合
54 | 关闭 | 5721.679688 | -- | -- | 符合
55 | 关闭 | 5815.429688 | -- | -- | 符合
56 | 关闭 | 5909.179688 | -- | -- | 符合
57 | 关闭 | 6002.929688 | -- | -- | 符合
58 | 关闭 | 6096.679688 | -- | -- | 符合
59 | 关闭 | 6190.429688 | -- | -- | 符合
60 | 关闭 | 6284.179688 | -- | -- | 符合
61 | 关闭 | 6377.929688 | -- | -- | 符合
62 | 关闭 | 6471.679688 | -- | -- | 符合
63 | 关闭 | 6565.429688 | -- | -- | 符合
64 | 关闭 | 6659.179688 | -- | -- | 符合

## 标注放大图

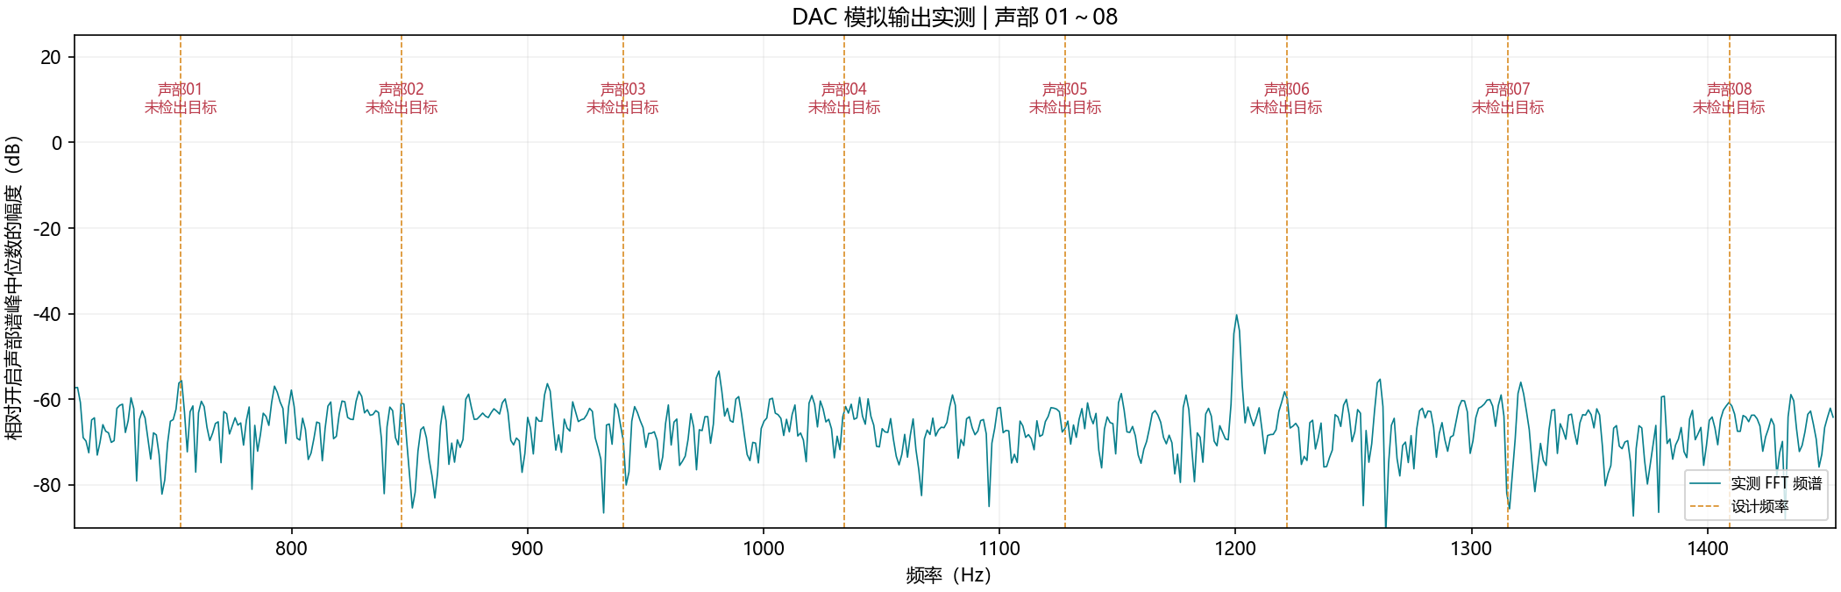
[picture p32: testing/measurements/reports/polyphony/group03_64_001/zoom_01_08.png]
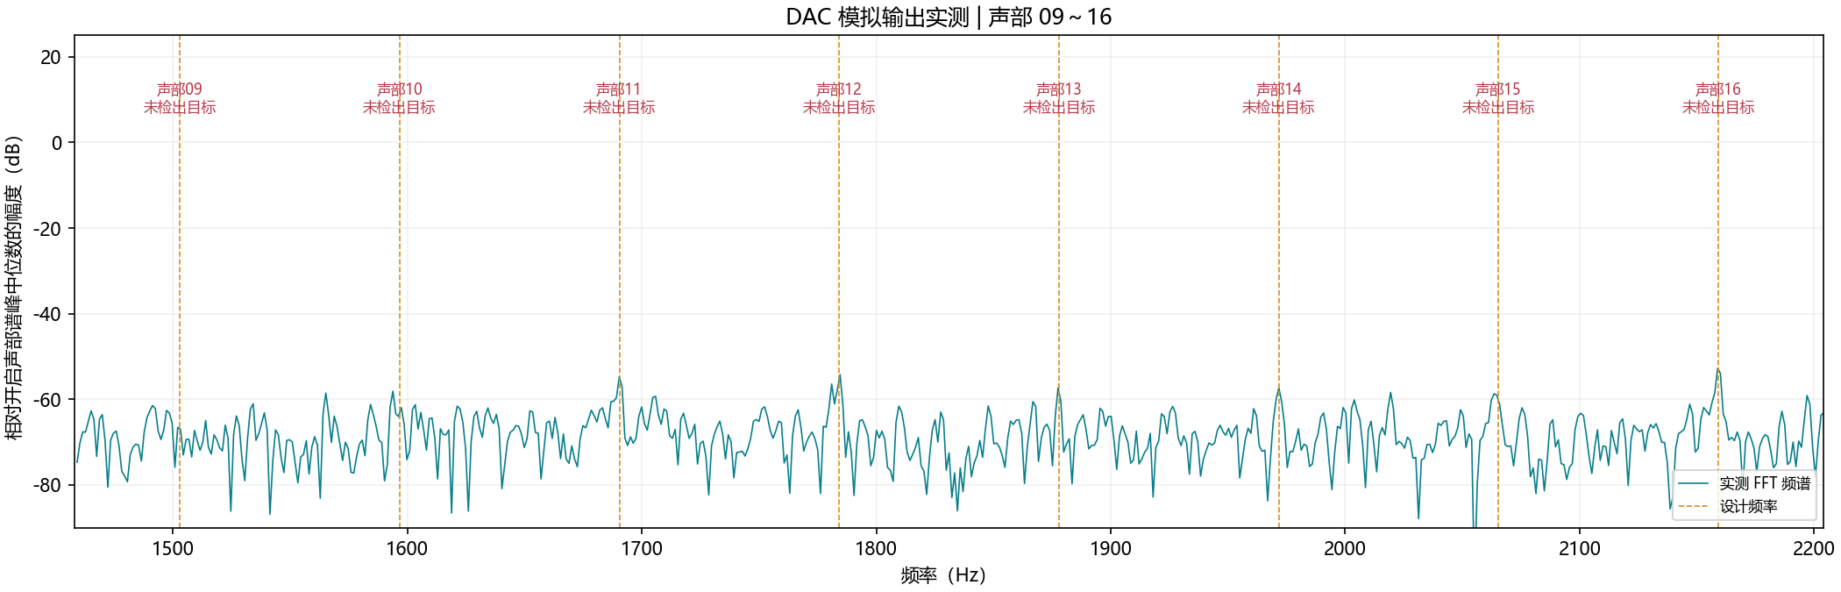
[picture p33: testing/measurements/reports/polyphony/group03_64_001/zoom_09_16.png]
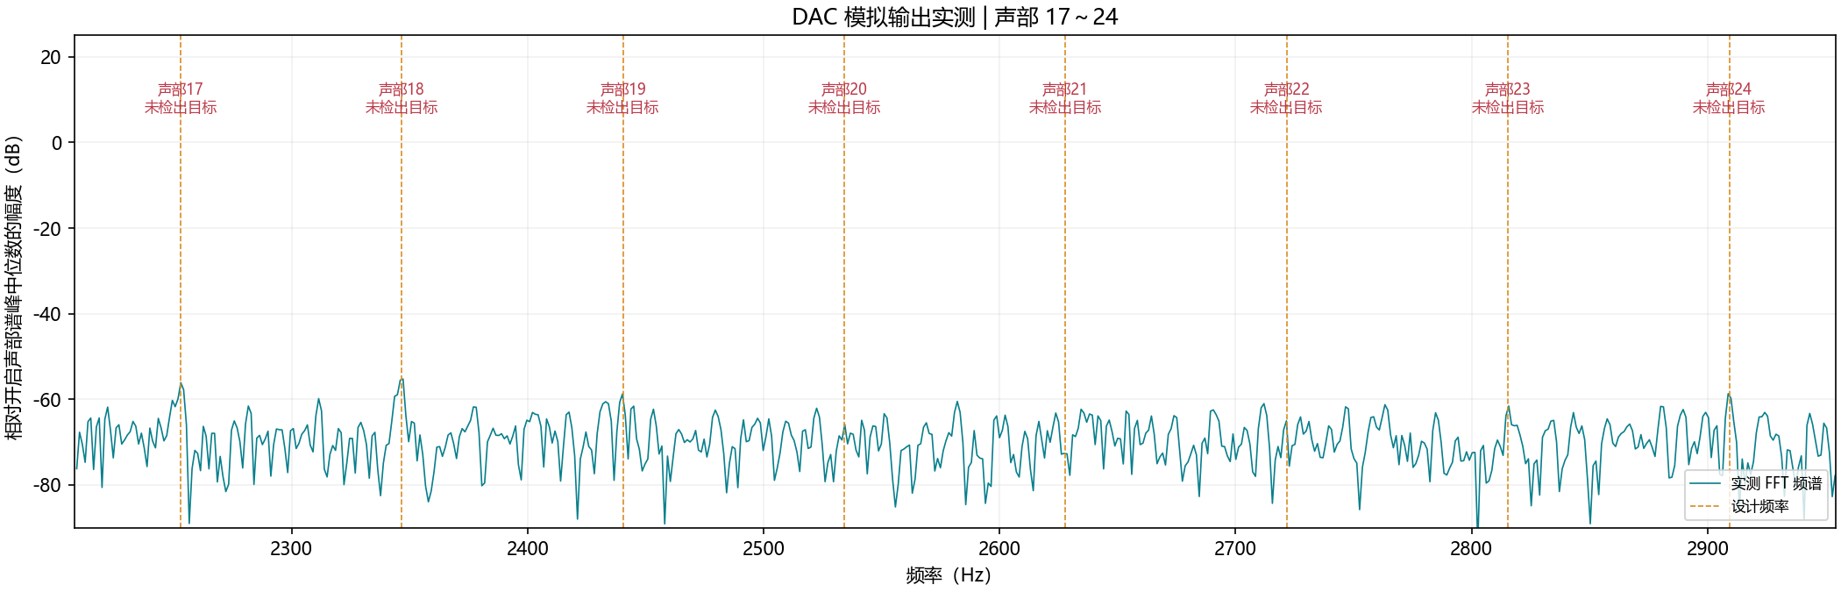
[picture p34: testing/measurements/reports/polyphony/group03_64_001/zoom_17_24.png]
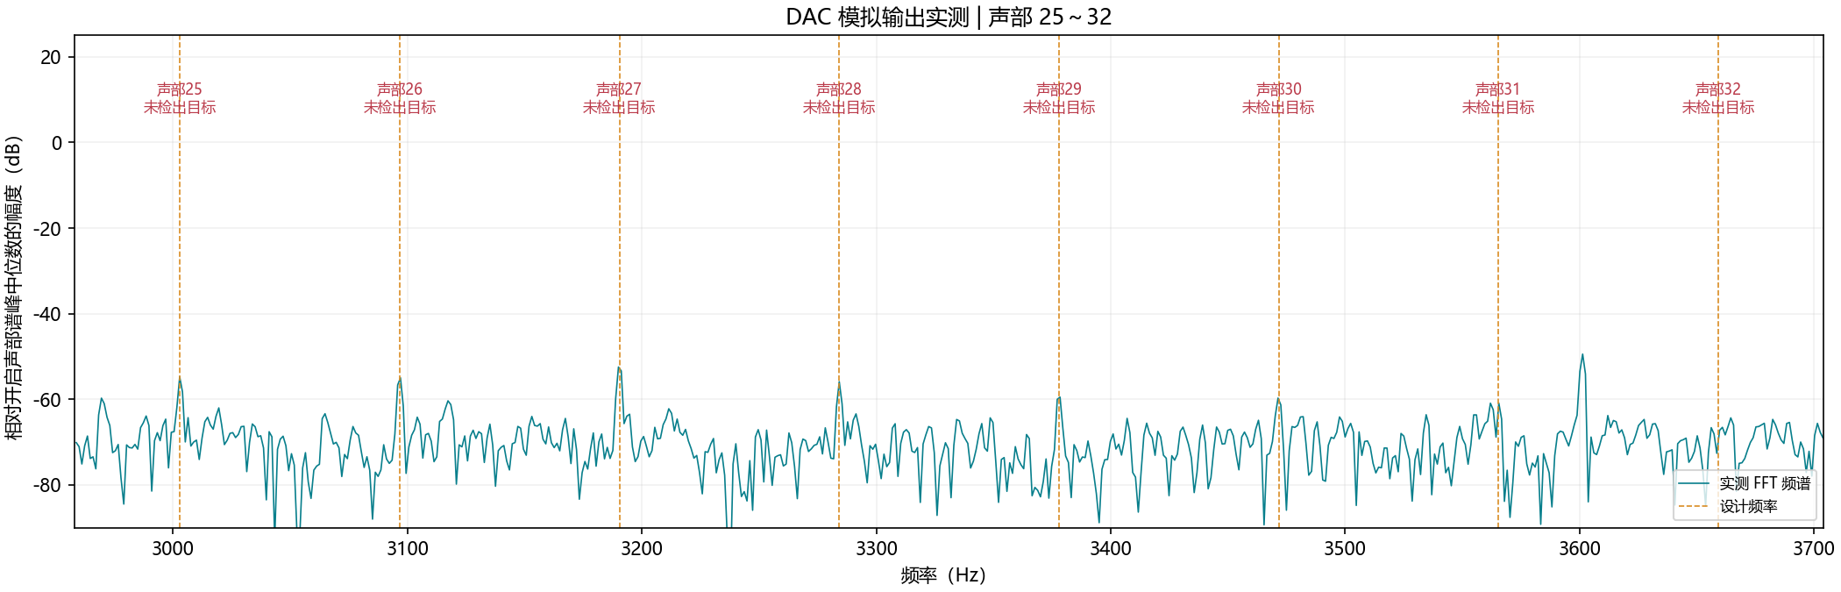
[picture p35: testing/measurements/reports/polyphony/group03_64_001/zoom_25_32.png]
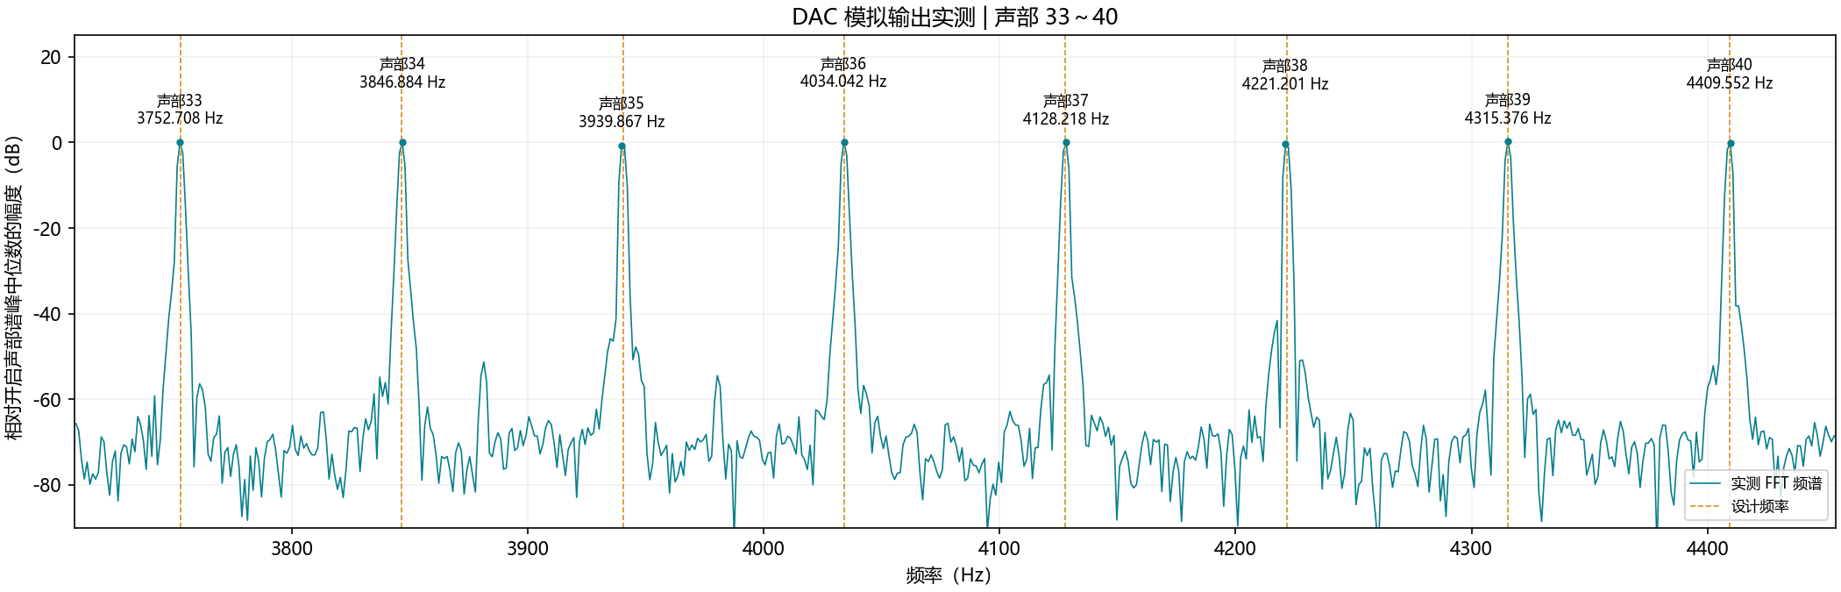
[picture p36: testing/measurements/reports/polyphony/group03_64_001/zoom_33_40.png]
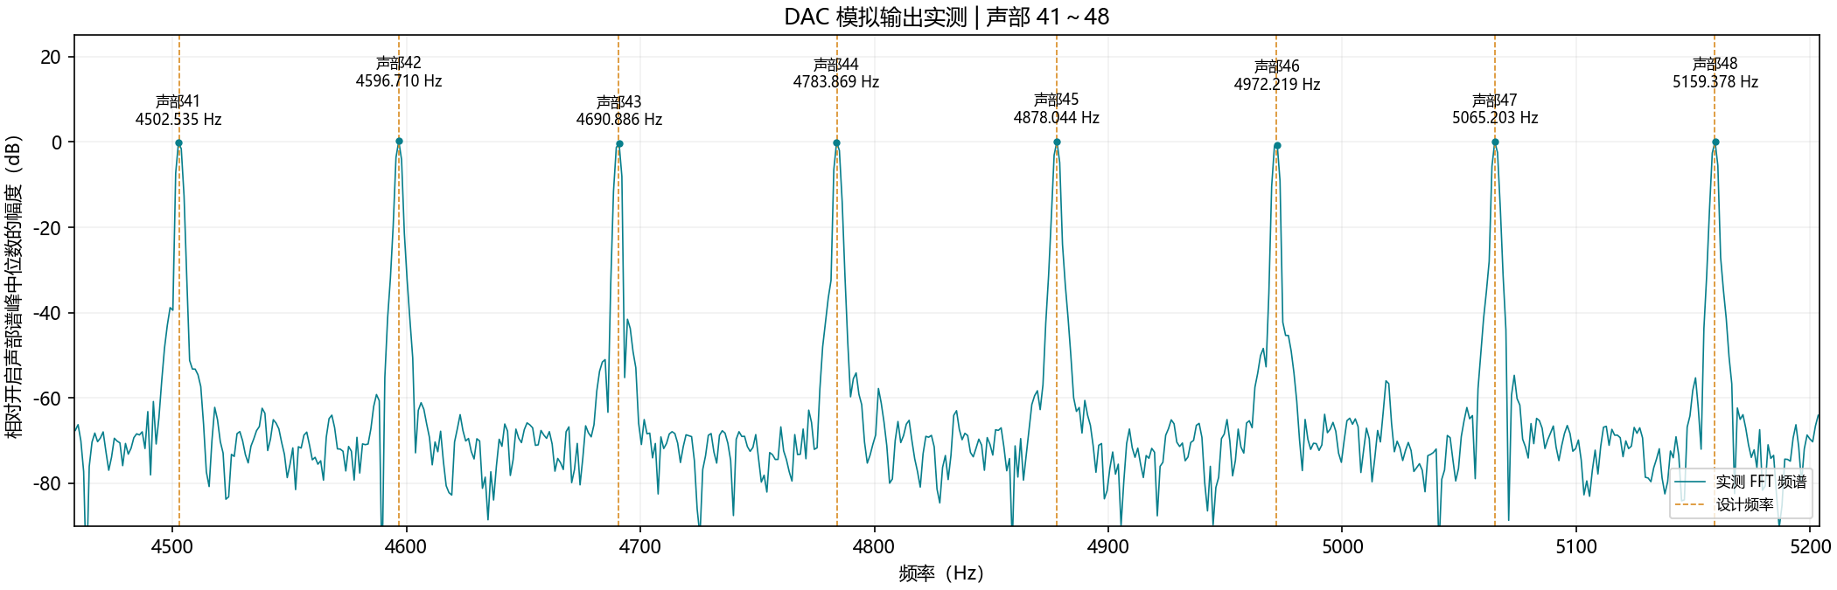
[picture p37: testing/measurements/reports/polyphony/group03_64_001/zoom_41_48.png]
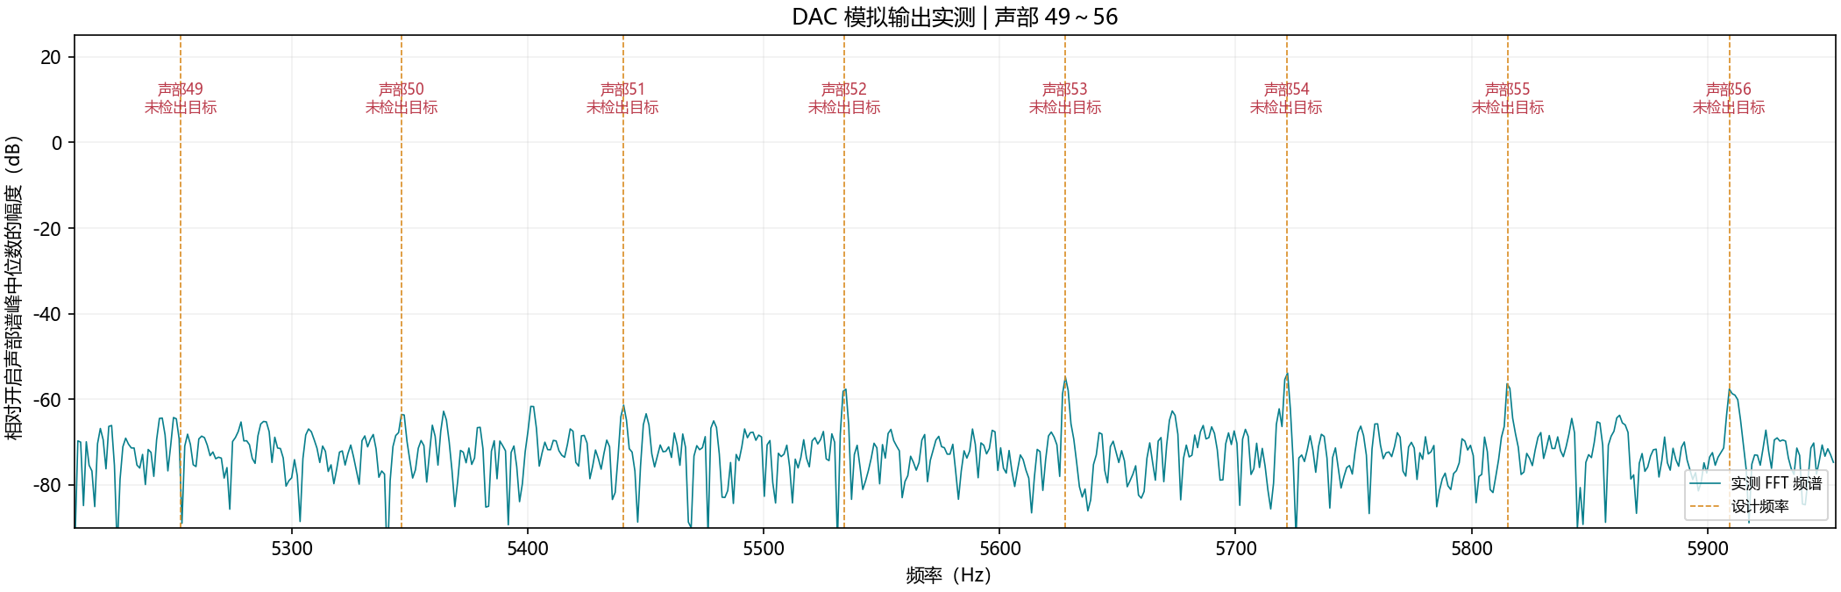
[picture p38: testing/measurements/reports/polyphony/group03_64_001/zoom_49_56.png]
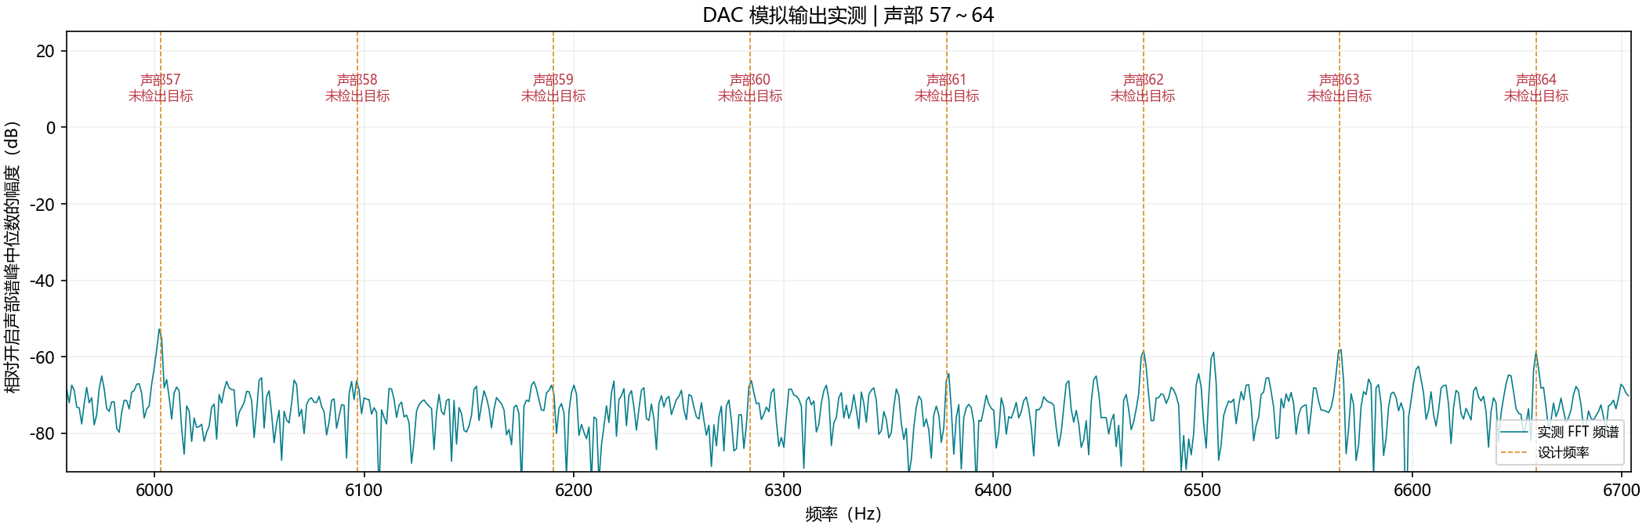
[picture p39: testing/measurements/reports/polyphony/group03_64_001/zoom_57_64.png]
