user-lqt/gowin-fpga-instrument-138k/testing/measurements/reports/polyphony/group04_64_001/report.html

# 复音频率测量证据

DAC 模拟输出实测 | 64 声部 | 第 4 组 | 工具自检：通过
记录时长 0.700000 s；FFT 频点间隔 1.192093 Hz；共同频率缩放拟合系数 0.99999000。频率显示的小数位数不代表仪器测量准确度。
橙色虚线：设计频率。圆点标注：实测 FFT 频点的幅度最大位置。关闭声部不把噪声最大值作为音调频率报告。
此处通过/未通过为工具自检结果；自检阈值不是赛题直接规定，不能替代最终比赛验收。频谱峰数也不能单独证明 RTL 振荡器的独立性。

## 频谱总览

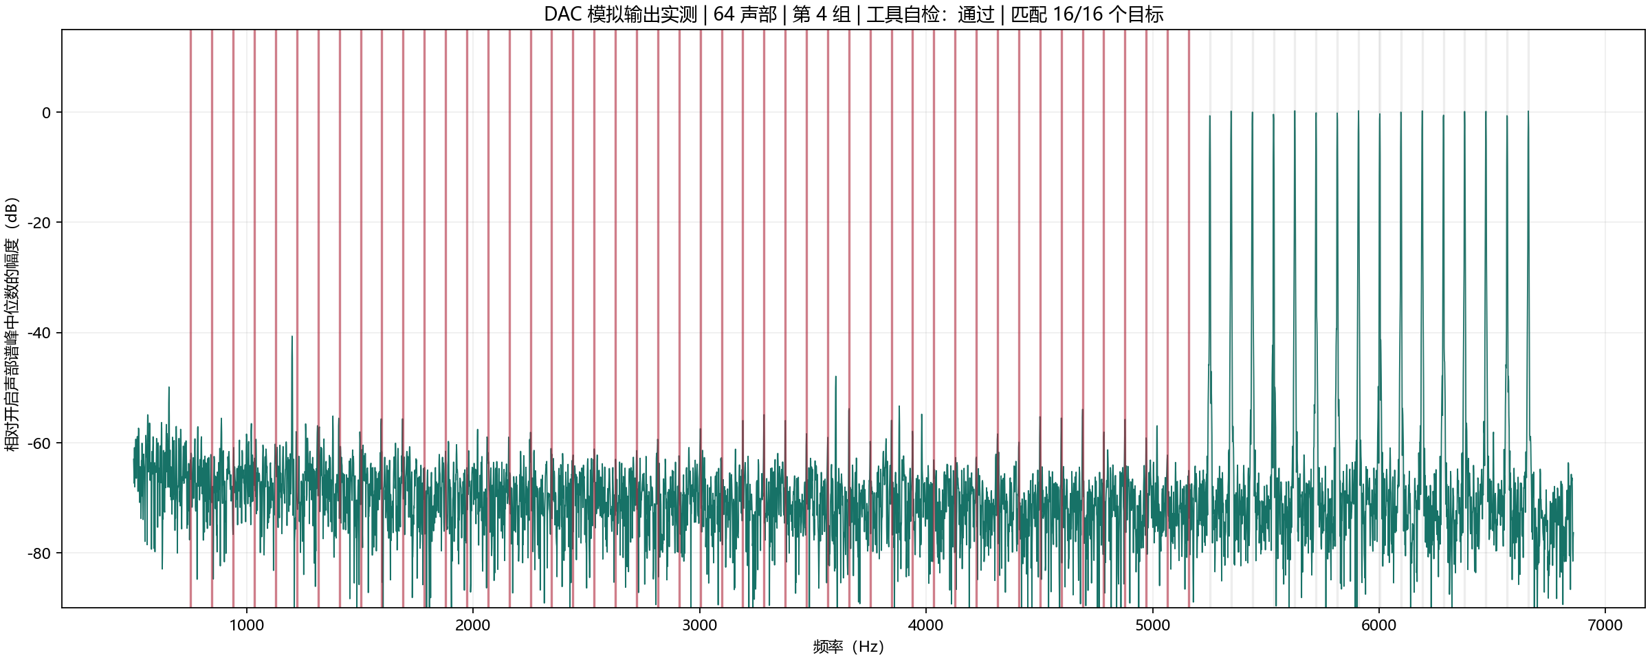
[picture p40: testing/measurements/reports/polyphony/group04_64_001/spectrum.png]
实测频谱总览


## 频率明细

频率偏差 CSV | 可打印频率表

声部 | 状态 | 设计频率（Hz） | 实测频率（Hz） | 频率偏差（Hz） | 目标检查
01 | 关闭 | 752.929688 | -- | -- | 符合
02 | 关闭 | 846.679688 | -- | -- | 符合
03 | 关闭 | 940.429688 | -- | -- | 符合
04 | 关闭 | 1034.179688 | -- | -- | 符合
05 | 关闭 | 1127.929688 | -- | -- | 符合
06 | 关闭 | 1221.679688 | -- | -- | 符合
07 | 关闭 | 1315.429688 | -- | -- | 符合
08 | 关闭 | 1409.179688 | -- | -- | 符合
09 | 关闭 | 1502.929688 | -- | -- | 符合
10 | 关闭 | 1596.679688 | -- | -- | 符合
11 | 关闭 | 1690.429688 | -- | -- | 符合
12 | 关闭 | 1784.179688 | -- | -- | 符合
13 | 关闭 | 1877.929688 | -- | -- | 符合
14 | 关闭 | 1971.679688 | -- | -- | 符合
15 | 关闭 | 2065.429688 | -- | -- | 符合
16 | 关闭 | 2159.179688 | -- | -- | 符合
17 | 关闭 | 2252.929688 | -- | -- | 符合
18 | 关闭 | 2346.679688 | -- | -- | 符合
19 | 关闭 | 2440.429688 | -- | -- | 符合
20 | 关闭 | 2534.179688 | -- | -- | 符合
21 | 关闭 | 2627.929688 | -- | -- | 符合
22 | 关闭 | 2721.679688 | -- | -- | 符合
23 | 关闭 | 2815.429688 | -- | -- | 符合
24 | 关闭 | 2909.179688 | -- | -- | 符合
25 | 关闭 | 3002.929688 | -- | -- | 符合
26 | 关闭 | 3096.679688 | -- | -- | 符合
27 | 关闭 | 3190.429688 | -- | -- | 符合
28 | 关闭 | 3284.179688 | -- | -- | 符合
29 | 关闭 | 3377.929688 | -- | -- | 符合
30 | 关闭 | 3471.679688 | -- | -- | 符合
31 | 关闭 | 3565.429688 | -- | -- | 符合
32 | 关闭 | 3659.179688 | -- | -- | 符合
33 | 关闭 | 3752.929688 | -- | -- | 符合
34 | 关闭 | 3846.679688 | -- | -- | 符合
35 | 关闭 | 3940.429688 | -- | -- | 符合
36 | 关闭 | 4034.179688 | -- | -- | 符合
37 | 关闭 | 4127.929688 | -- | -- | 符合
38 | 关闭 | 4221.679688 | -- | -- | 符合
39 | 关闭 | 4315.429688 | -- | -- | 符合
40 | 关闭 | 4409.179688 | -- | -- | 符合
41 | 关闭 | 4502.929688 | -- | -- | 符合
42 | 关闭 | 4596.679688 | -- | -- | 符合
43 | 关闭 | 4690.429688 | -- | -- | 符合
44 | 关闭 | 4784.179688 | -- | -- | 符合
45 | 关闭 | 4877.929688 | -- | -- | 符合
46 | 关闭 | 4971.679688 | -- | -- | 符合
47 | 关闭 | 5065.429688 | -- | -- | 符合
48 | 关闭 | 5159.179688 | -- | -- | 符合
49 | 开启 | 5252.929688 | 5252.361298 | -0.568390 | 符合
50 | 开启 | 5346.679688 | 5346.536636 | -0.143051 | 符合
51 | 开启 | 5440.429688 | 5440.711975 | +0.282288 | 符合
52 | 开启 | 5534.179688 | 5533.695221 | -0.484467 | 符合
53 | 开启 | 5627.929688 | 5627.870560 | -0.059128 | 符合
54 | 开启 | 5721.679688 | 5722.045898 | +0.366211 | 符合
55 | 开启 | 5815.429688 | 5815.029144 | -0.400543 | 符合
56 | 开启 | 5909.179688 | 5909.204483 | +0.024796 | 符合
57 | 开启 | 6002.929688 | 6003.379822 | +0.450134 | 符合
58 | 开启 | 6096.679688 | 6096.363068 | -0.316620 | 符合
59 | 开启 | 6190.429688 | 6190.538406 | +0.108719 | 符合
60 | 开启 | 6284.179688 | 6284.713745 | +0.534058 | 符合
61 | 开启 | 6377.929688 | 6377.696991 | -0.232697 | 符合
62 | 开启 | 6471.679688 | 6471.872330 | +0.192642 | 符合
63 | 开启 | 6565.429688 | 6564.855576 | -0.574112 | 符合
64 | 开启 | 6659.179688 | 6659.030914 | -0.148773 | 符合

## 标注放大图

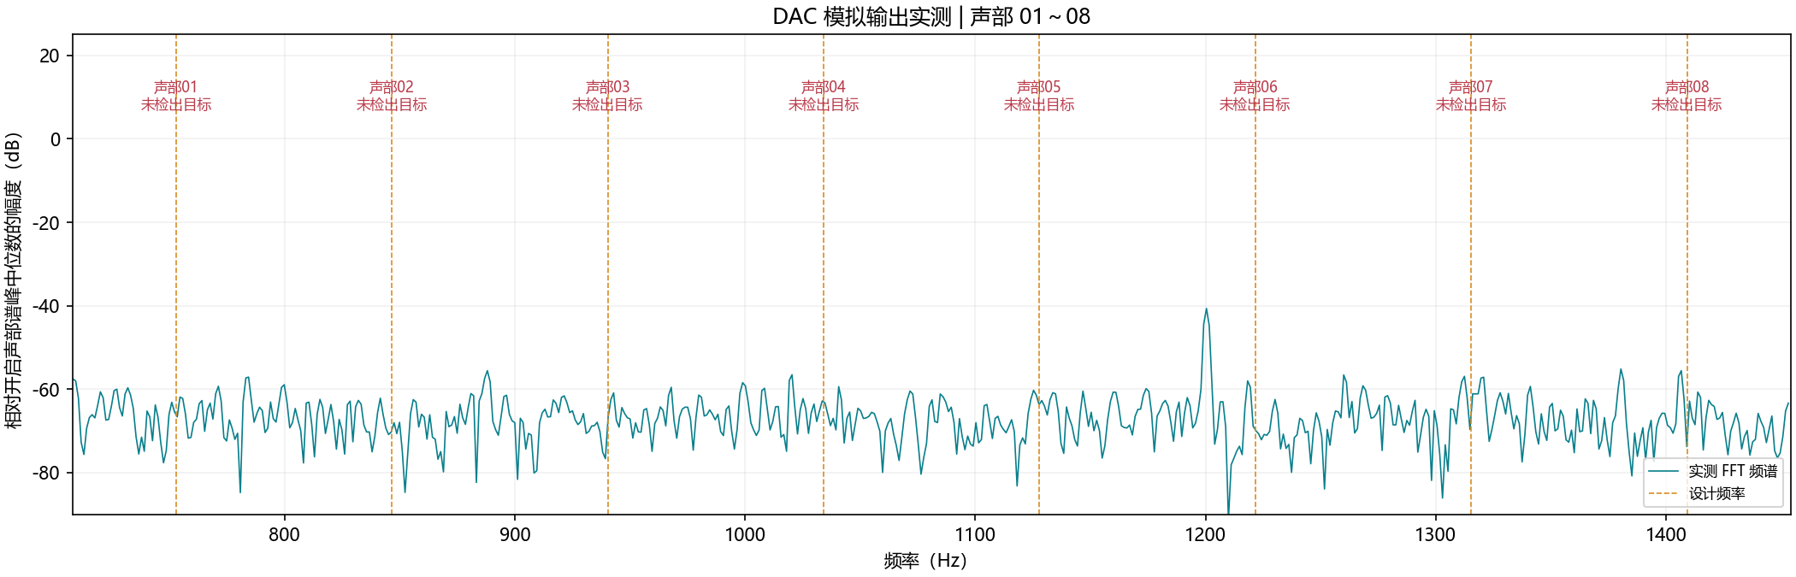
[picture p41: testing/measurements/reports/polyphony/group04_64_001/zoom_01_08.png]
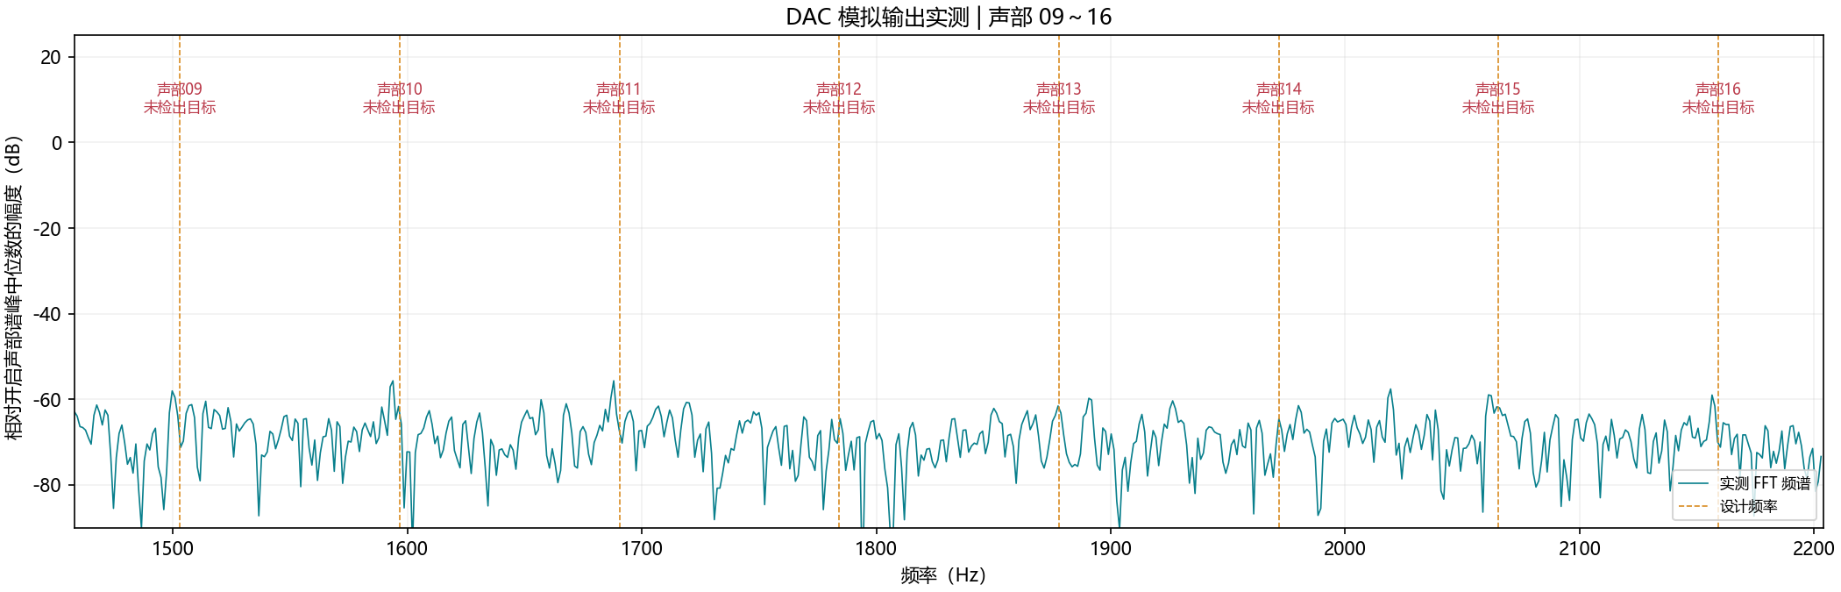
[picture p42: testing/measurements/reports/polyphony/group04_64_001/zoom_09_16.png]
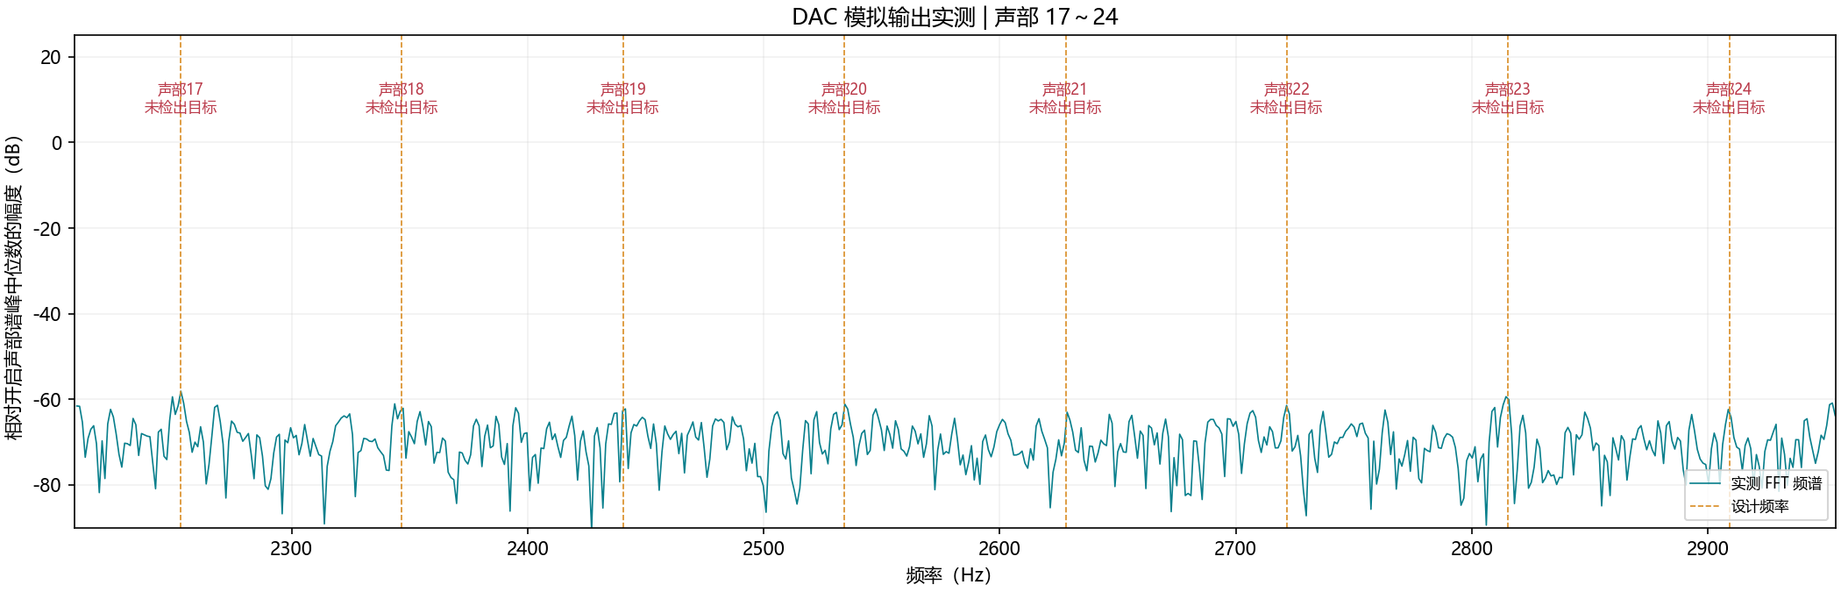
[picture p43: testing/measurements/reports/polyphony/group04_64_001/zoom_17_24.png]
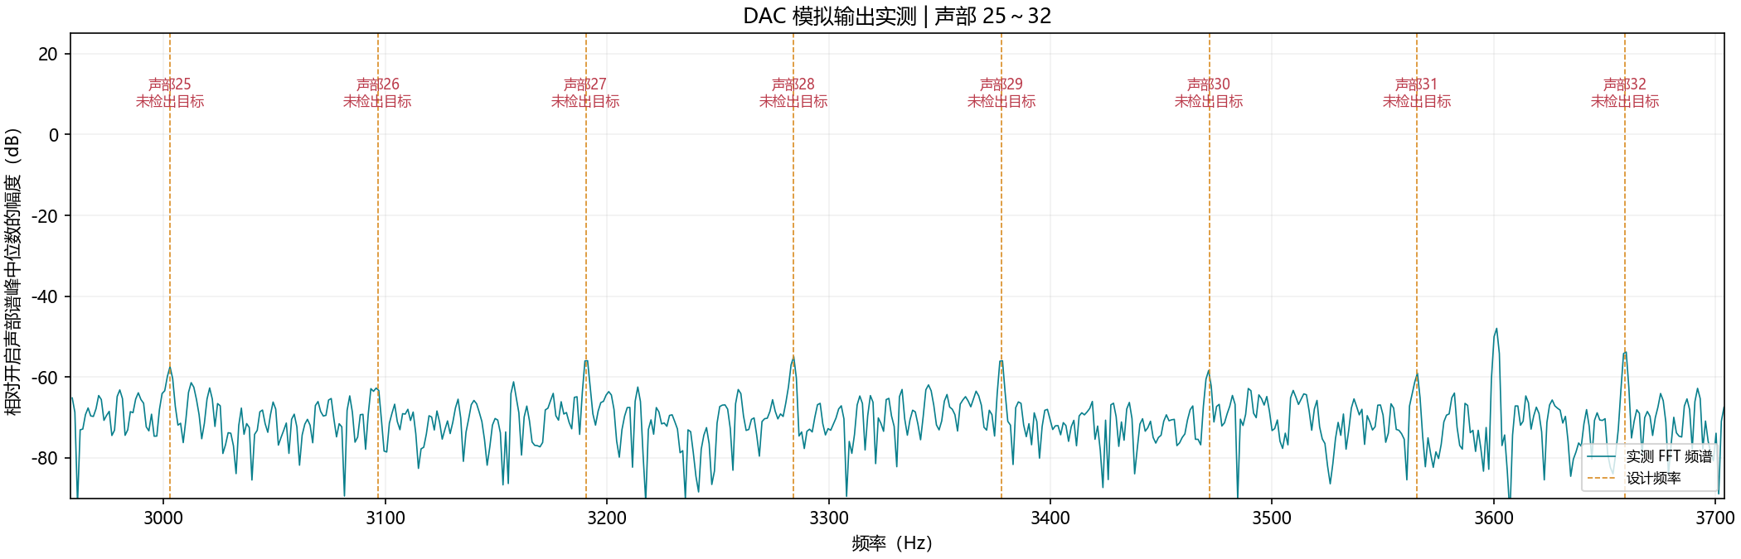
[picture p44: testing/measurements/reports/polyphony/group04_64_001/zoom_25_32.png]
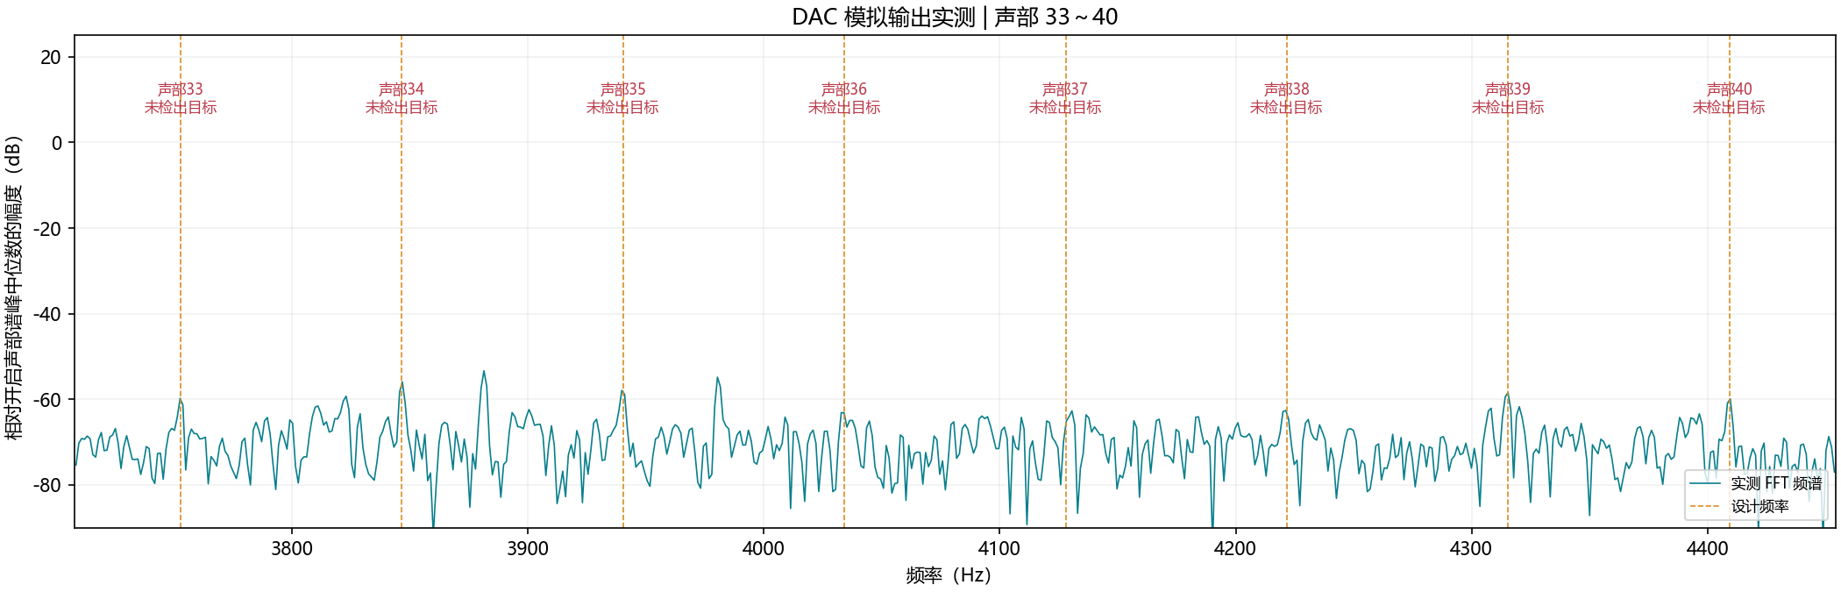
[picture p45: testing/measurements/reports/polyphony/group04_64_001/zoom_33_40.png]
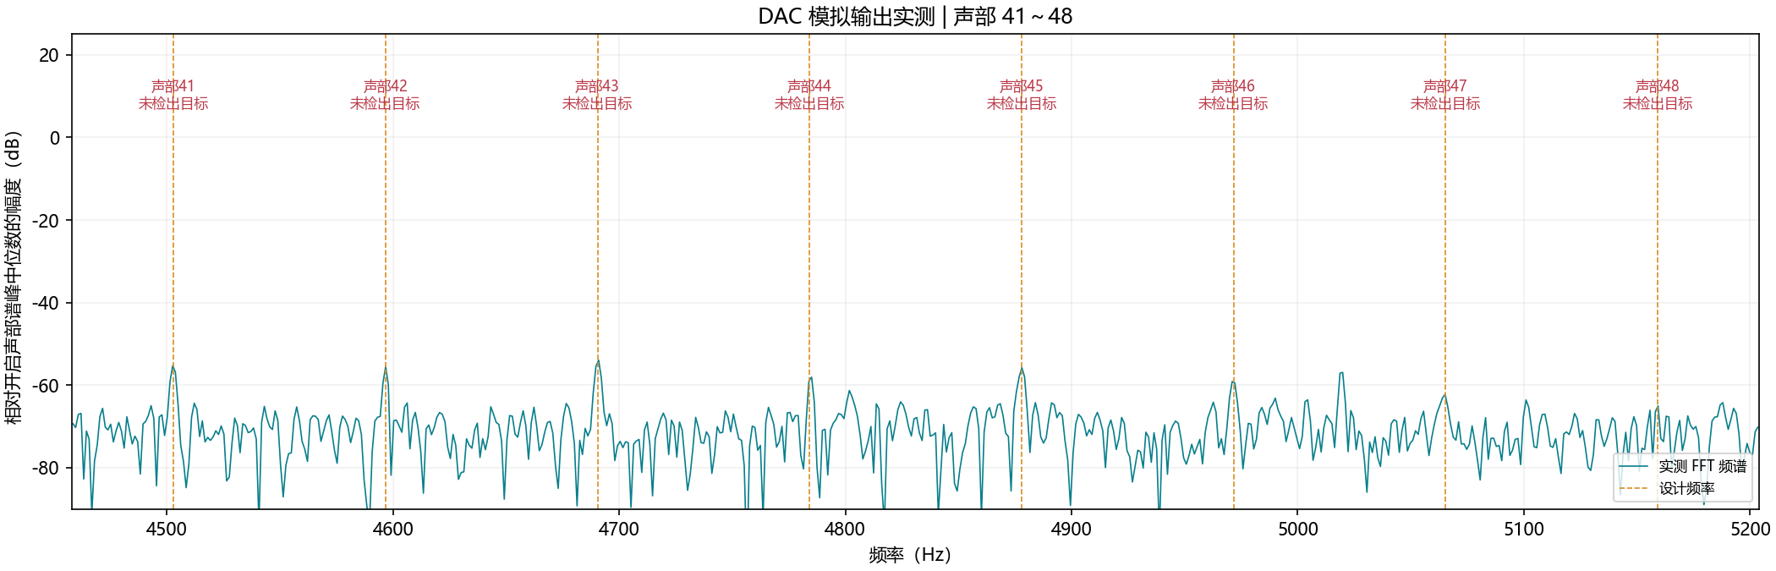
[picture p46: testing/measurements/reports/polyphony/group04_64_001/zoom_41_48.png]
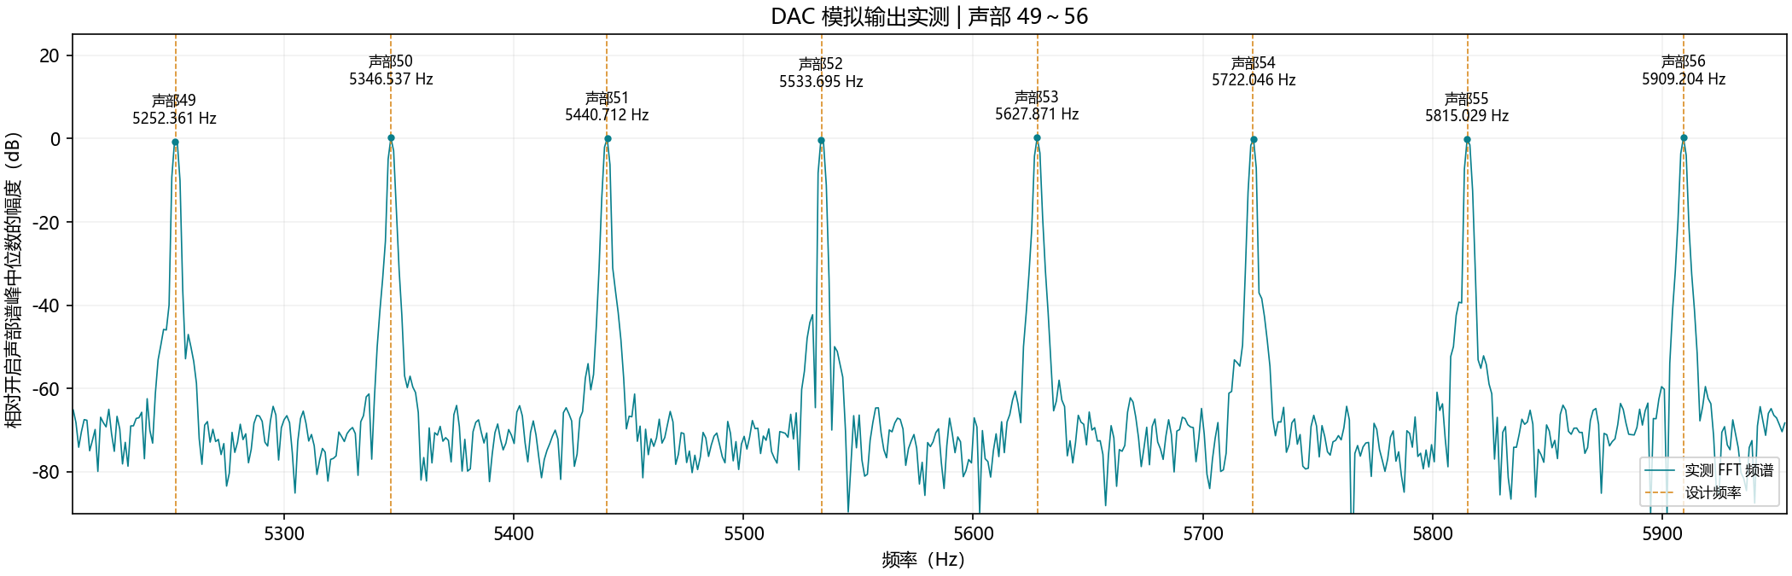
[picture p47: testing/measurements/reports/polyphony/group04_64_001/zoom_49_56.png]
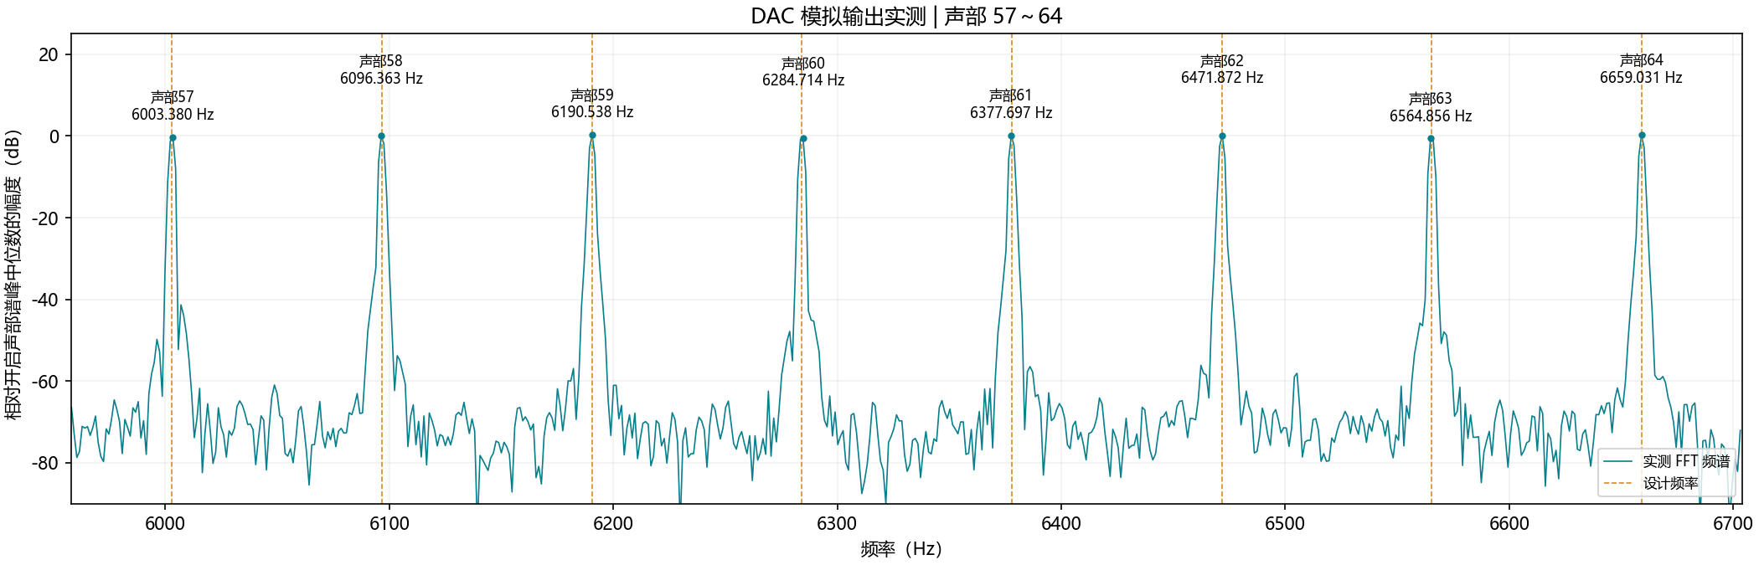
[picture p48: testing/measurements/reports/polyphony/group04_64_001/zoom_57_64.png]
