user-lqt/gowin-fpga-instrument-138k/testing/measurements/reports/polyphony/mute18_64_001/report.html

# 复音频率测量证据

DAC 模拟输出实测 | 64 声部 | 声部 18 静音 | 工具自检：通过
记录时长 0.700000 s；FFT 频点间隔 1.192093 Hz；共同频率缩放拟合系数 1.00000000。频率显示的小数位数不代表仪器测量准确度。
橙色虚线：设计频率。圆点标注：实测 FFT 频点的幅度最大位置。关闭声部不把噪声最大值作为音调频率报告。
此处通过/未通过为工具自检结果；自检阈值不是赛题直接规定，不能替代最终比赛验收。频谱峰数也不能单独证明 RTL 振荡器的独立性。

## 频谱总览

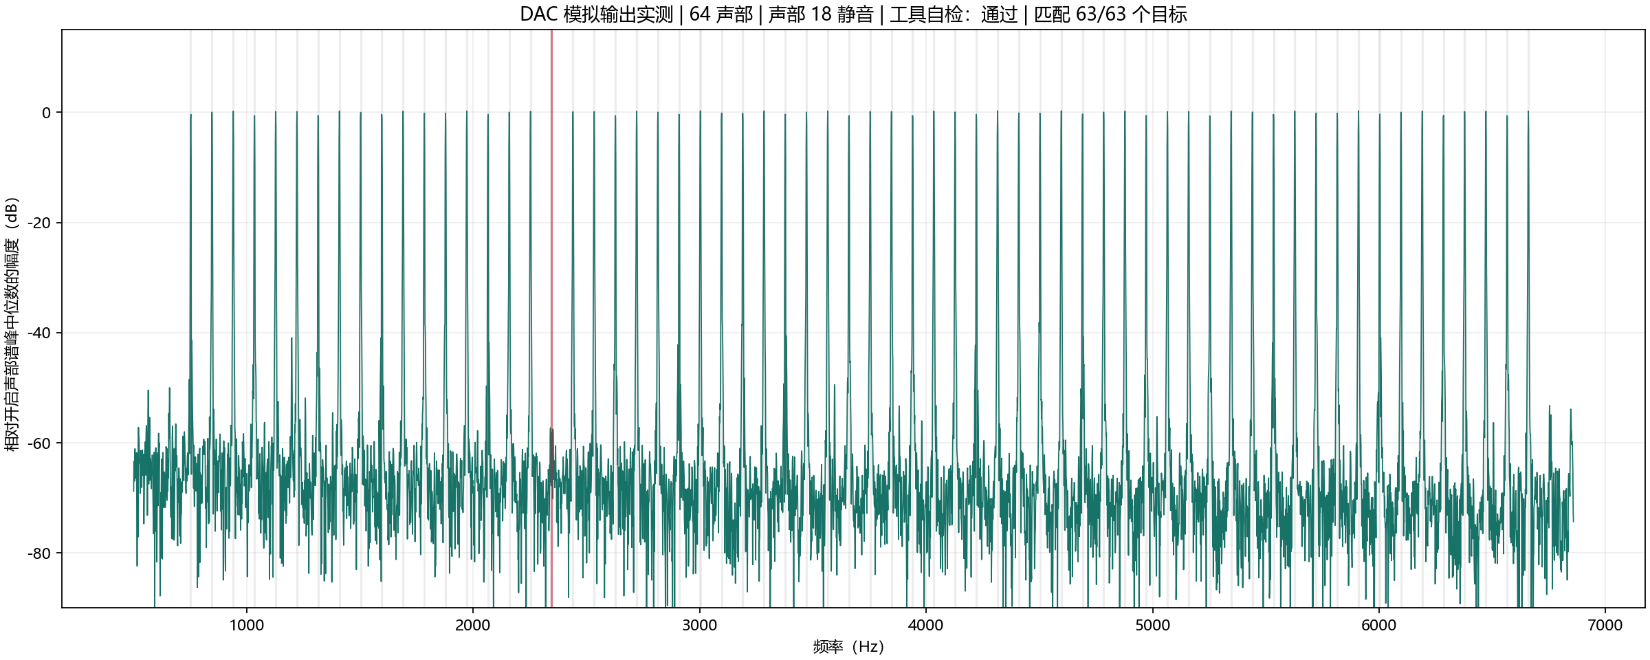
[picture p59: testing/measurements/reports/polyphony/mute18_64_001/spectrum.png]
实测频谱总览


## 频率明细

频率偏差 CSV | 可打印频率表

声部 | 状态 | 设计频率（Hz） | 实测频率（Hz） | 频率偏差（Hz） | 目标检查
01 | 开启 | 752.929688 | 753.402710 | +0.473022 | 符合
02 | 开启 | 846.679688 | 846.385956 | -0.293732 | 符合
03 | 开启 | 940.429688 | 940.561295 | +0.131607 | 符合
04 | 开启 | 1034.179688 | 1034.736633 | +0.556946 | 符合
05 | 开启 | 1127.929688 | 1127.719879 | -0.209808 | 符合
06 | 开启 | 1221.679688 | 1221.895218 | +0.215530 | 符合
07 | 开启 | 1315.429688 | 1314.878464 | -0.551224 | 符合
08 | 开启 | 1409.179688 | 1409.053802 | -0.125885 | 符合
09 | 开启 | 1502.929688 | 1503.229141 | +0.299454 | 符合
10 | 开启 | 1596.679688 | 1596.212387 | -0.467300 | 符合
11 | 开启 | 1690.429688 | 1690.387726 | -0.041962 | 符合
12 | 开启 | 1784.179688 | 1784.563065 | +0.383377 | 符合
13 | 开启 | 1877.929688 | 1877.546310 | -0.383377 | 符合
14 | 开启 | 1971.679688 | 1971.721649 | +0.041962 | 符合
15 | 开启 | 2065.429688 | 2065.896988 | +0.467300 | 符合
16 | 开启 | 2159.179688 | 2158.880234 | -0.299454 | 符合
17 | 开启 | 2252.929688 | 2253.055573 | +0.125885 | 符合
18 | 关闭 | 2346.679688 | -- | -- | 符合
19 | 开启 | 2440.429688 | 2440.214157 | -0.215530 | 符合
20 | 开启 | 2534.179688 | 2534.389496 | +0.209808 | 符合
21 | 开启 | 2627.929688 | 2627.372742 | -0.556946 | 符合
22 | 开启 | 2721.679688 | 2721.548080 | -0.131607 | 符合
23 | 开启 | 2815.429688 | 2815.723419 | +0.293732 | 符合
24 | 开启 | 2909.179688 | 2908.706665 | -0.473022 | 符合
25 | 开启 | 3002.929688 | 3002.882004 | -0.047684 | 符合
26 | 开启 | 3096.679688 | 3097.057343 | +0.377655 | 符合
27 | 开启 | 3190.429688 | 3190.040588 | -0.389099 | 符合
28 | 开启 | 3284.179688 | 3284.215927 | +0.036240 | 符合
29 | 开启 | 3377.929688 | 3378.391266 | +0.461578 | 符合
30 | 开启 | 3471.679688 | 3471.374512 | -0.305176 | 符合
31 | 开启 | 3565.429688 | 3565.549850 | +0.120163 | 符合
32 | 开启 | 3659.179688 | 3659.725189 | +0.545502 | 符合
33 | 开启 | 3752.929688 | 3752.708435 | -0.221252 | 符合
34 | 开启 | 3846.679688 | 3846.883774 | +0.204086 | 符合
35 | 开启 | 3940.429688 | 3939.867020 | -0.562668 | 符合
36 | 开启 | 4034.179688 | 4034.042358 | -0.137329 | 符合
37 | 开启 | 4127.929688 | 4128.217697 | +0.288010 | 符合
38 | 开启 | 4221.679688 | 4221.200943 | -0.478745 | 符合
39 | 开启 | 4315.429688 | 4315.376282 | -0.053406 | 符合
40 | 开启 | 4409.179688 | 4409.551620 | +0.371933 | 符合
41 | 开启 | 4502.929688 | 4502.534866 | -0.394821 | 符合
42 | 开启 | 4596.679688 | 4596.710205 | +0.030518 | 符合
43 | 开启 | 4690.429688 | 4690.885544 | +0.455856 | 符合
44 | 开启 | 4784.179688 | 4783.868790 | -0.310898 | 符合
45 | 开启 | 4877.929688 | 4878.044128 | +0.114441 | 符合
46 | 开启 | 4971.679688 | 4972.219467 | +0.539780 | 符合
47 | 开启 | 5065.429688 | 5065.202713 | -0.226974 | 符合
48 | 开启 | 5159.179688 | 5159.378052 | +0.198364 | 符合
49 | 开启 | 5252.929688 | 5252.361298 | -0.568390 | 符合
50 | 开启 | 5346.679688 | 5346.536636 | -0.143051 | 符合
51 | 开启 | 5440.429688 | 5440.711975 | +0.282288 | 符合
52 | 开启 | 5534.179688 | 5533.695221 | -0.484467 | 符合
53 | 开启 | 5627.929688 | 5627.870560 | -0.059128 | 符合
54 | 开启 | 5721.679688 | 5722.045898 | +0.366211 | 符合
55 | 开启 | 5815.429688 | 5815.029144 | -0.400543 | 符合
56 | 开启 | 5909.179688 | 5909.204483 | +0.024796 | 符合
57 | 开启 | 6002.929688 | 6003.379822 | +0.450134 | 符合
58 | 开启 | 6096.679688 | 6096.363068 | -0.316620 | 符合
59 | 开启 | 6190.429688 | 6190.538406 | +0.108719 | 符合
60 | 开启 | 6284.179688 | 6284.713745 | +0.534058 | 符合
61 | 开启 | 6377.929688 | 6377.696991 | -0.232697 | 符合
62 | 开启 | 6471.679688 | 6471.872330 | +0.192642 | 符合
63 | 开启 | 6565.429688 | 6564.855576 | -0.574112 | 符合
64 | 开启 | 6659.179688 | 6659.030914 | -0.148773 | 符合

## 标注放大图

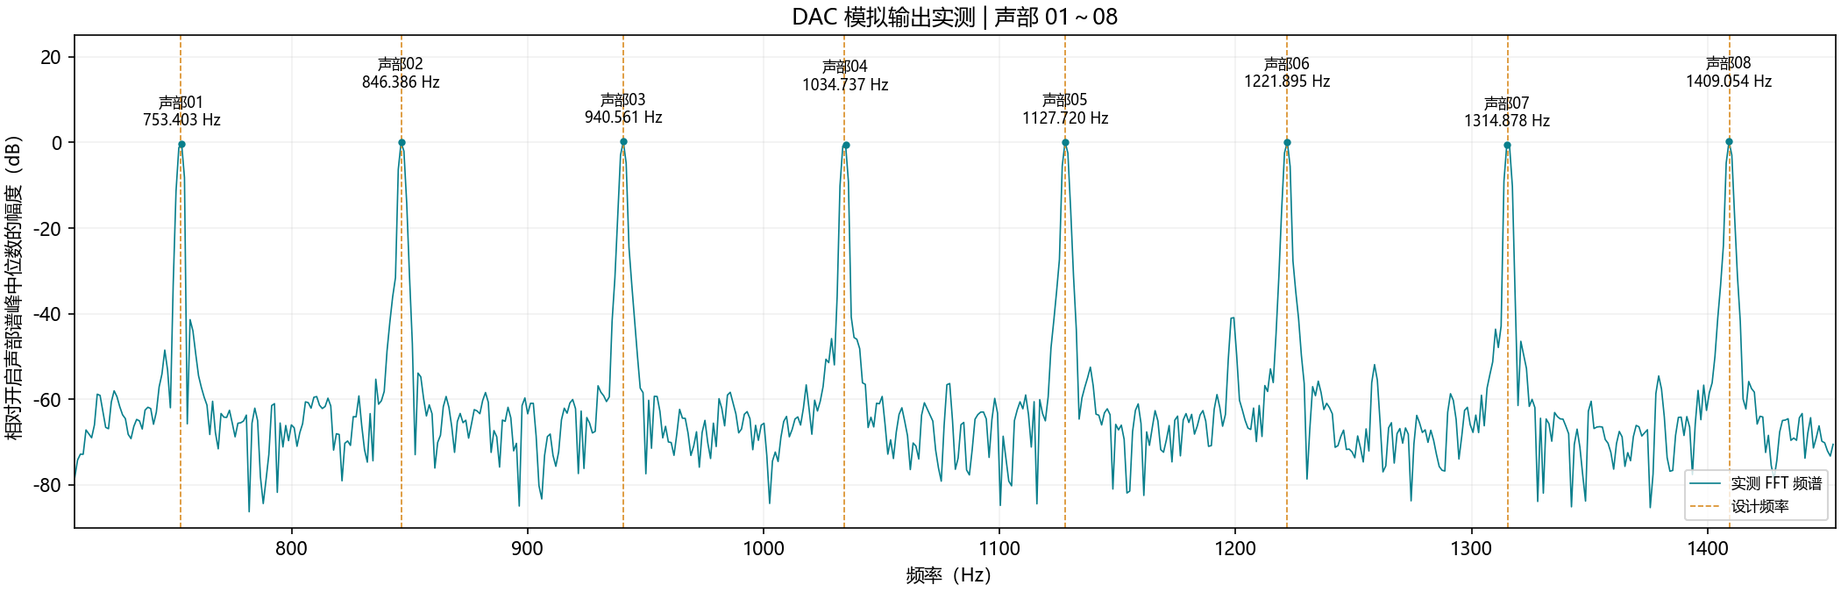
[picture p60: testing/measurements/reports/polyphony/mute18_64_001/zoom_01_08.png]
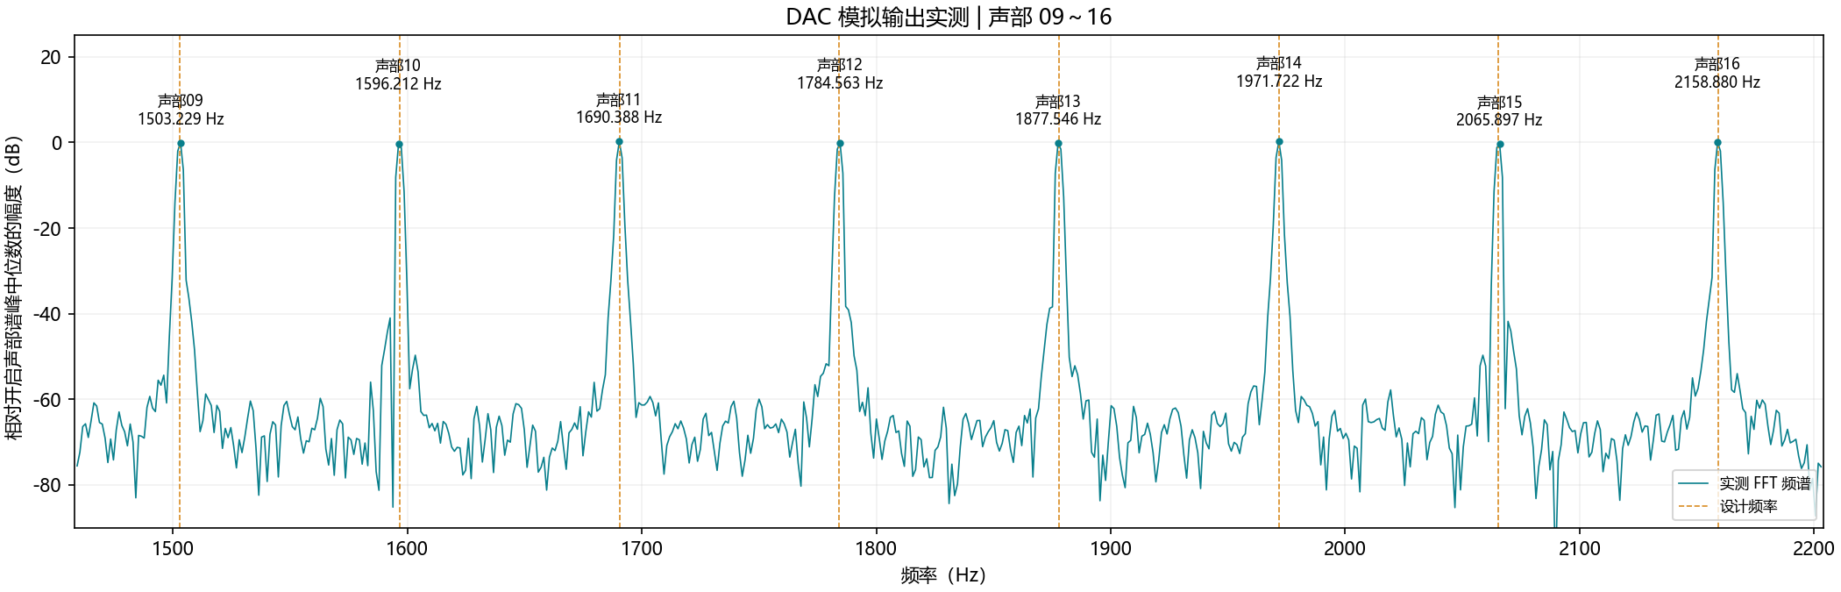
[picture p61: testing/measurements/reports/polyphony/mute18_64_001/zoom_09_16.png]
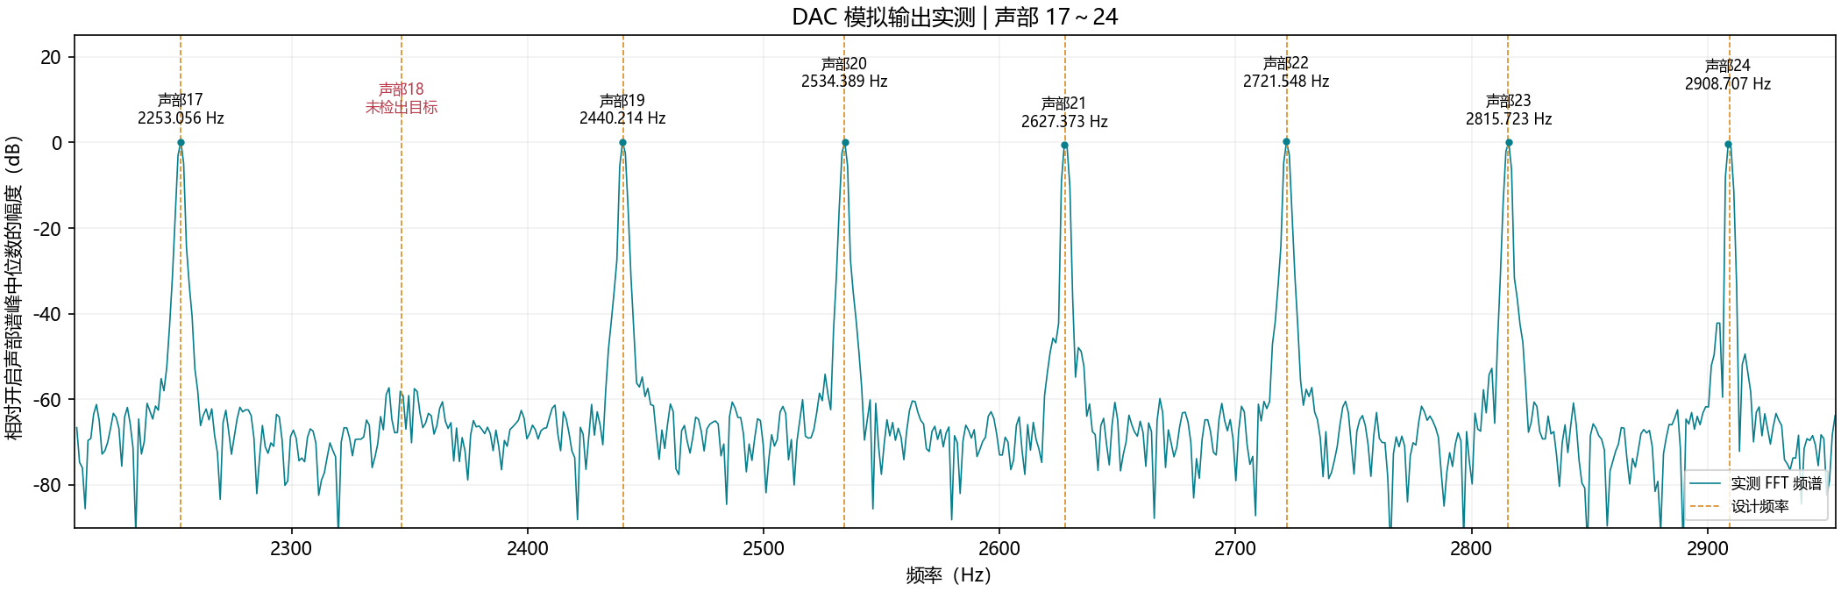
[picture p62: testing/measurements/reports/polyphony/mute18_64_001/zoom_17_24.png]
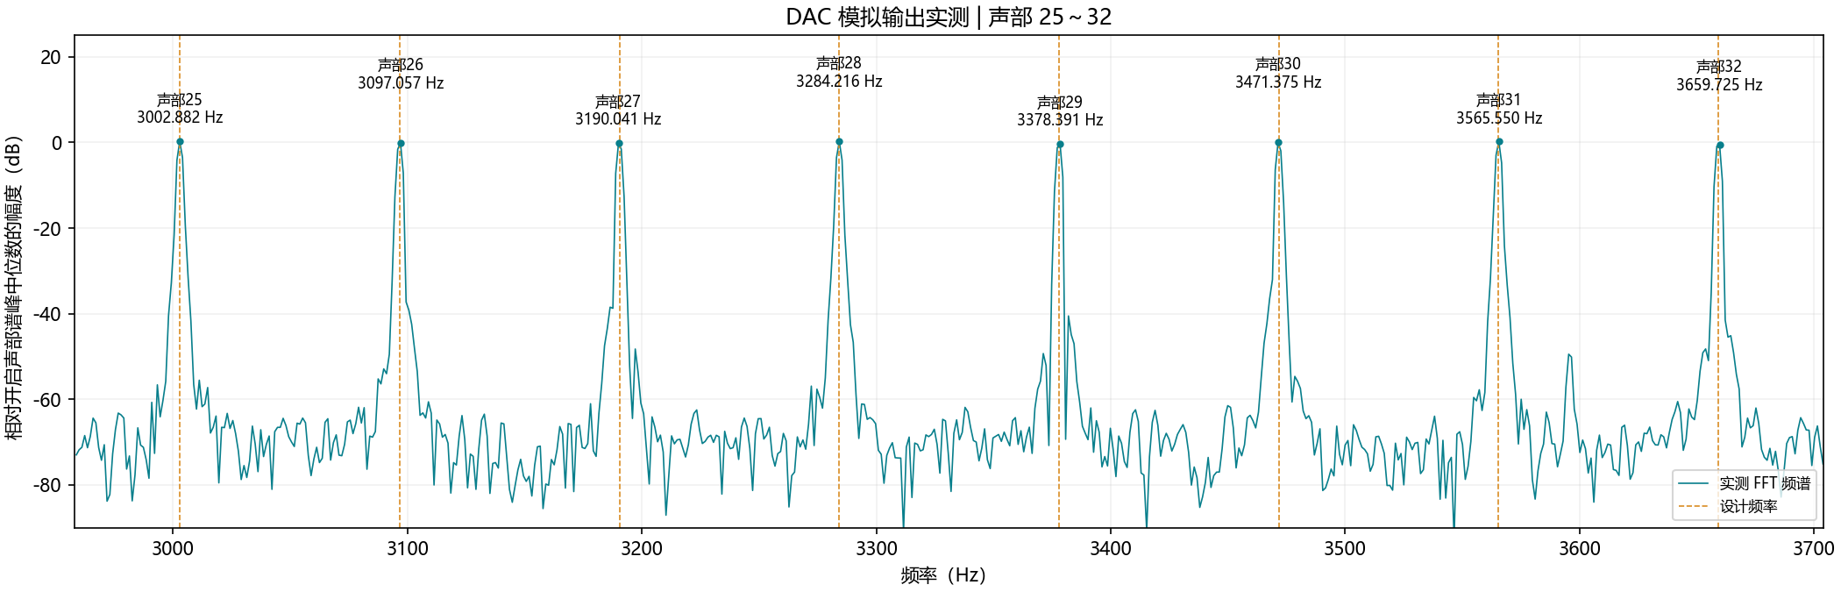
[picture p63: testing/measurements/reports/polyphony/mute18_64_001/zoom_25_32.png]
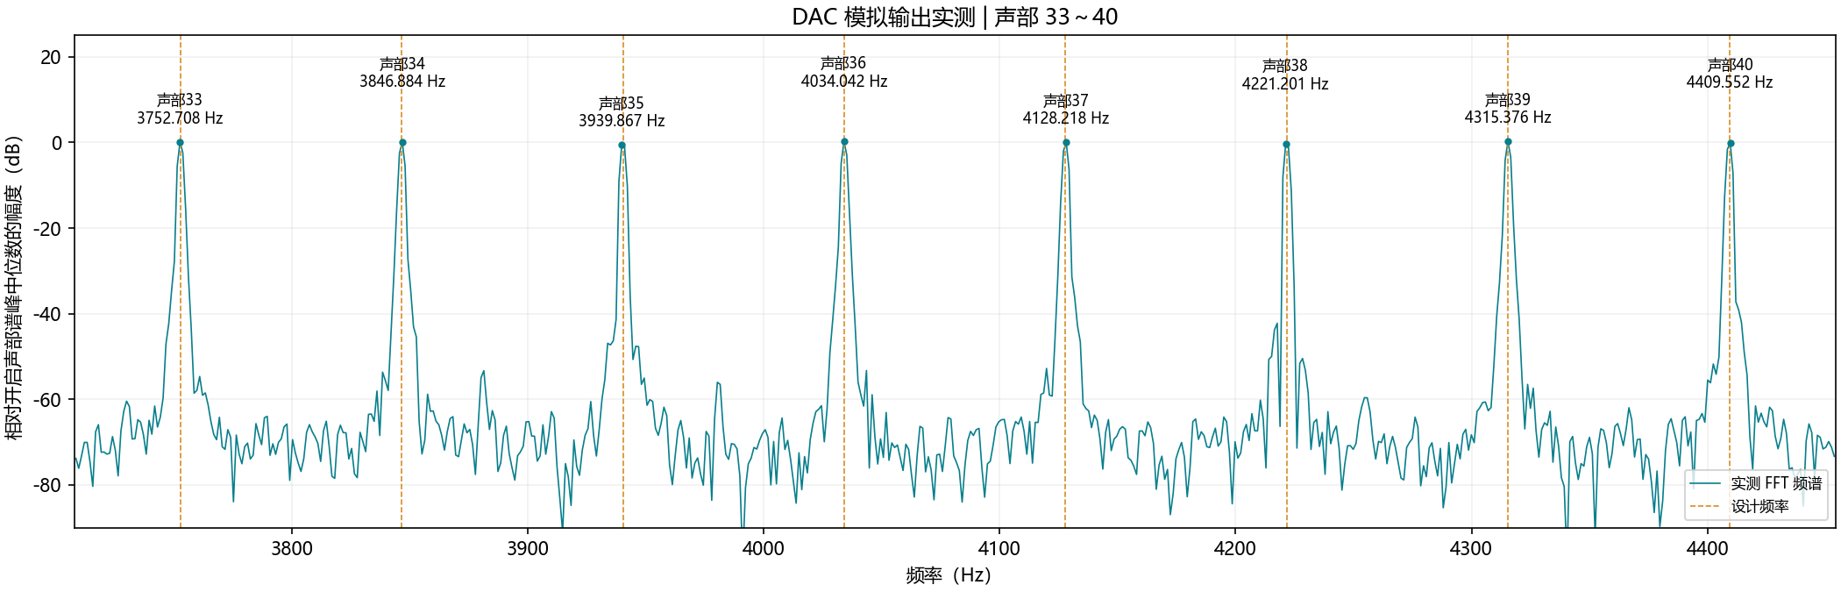
[picture p64: testing/measurements/reports/polyphony/mute18_64_001/zoom_33_40.png]
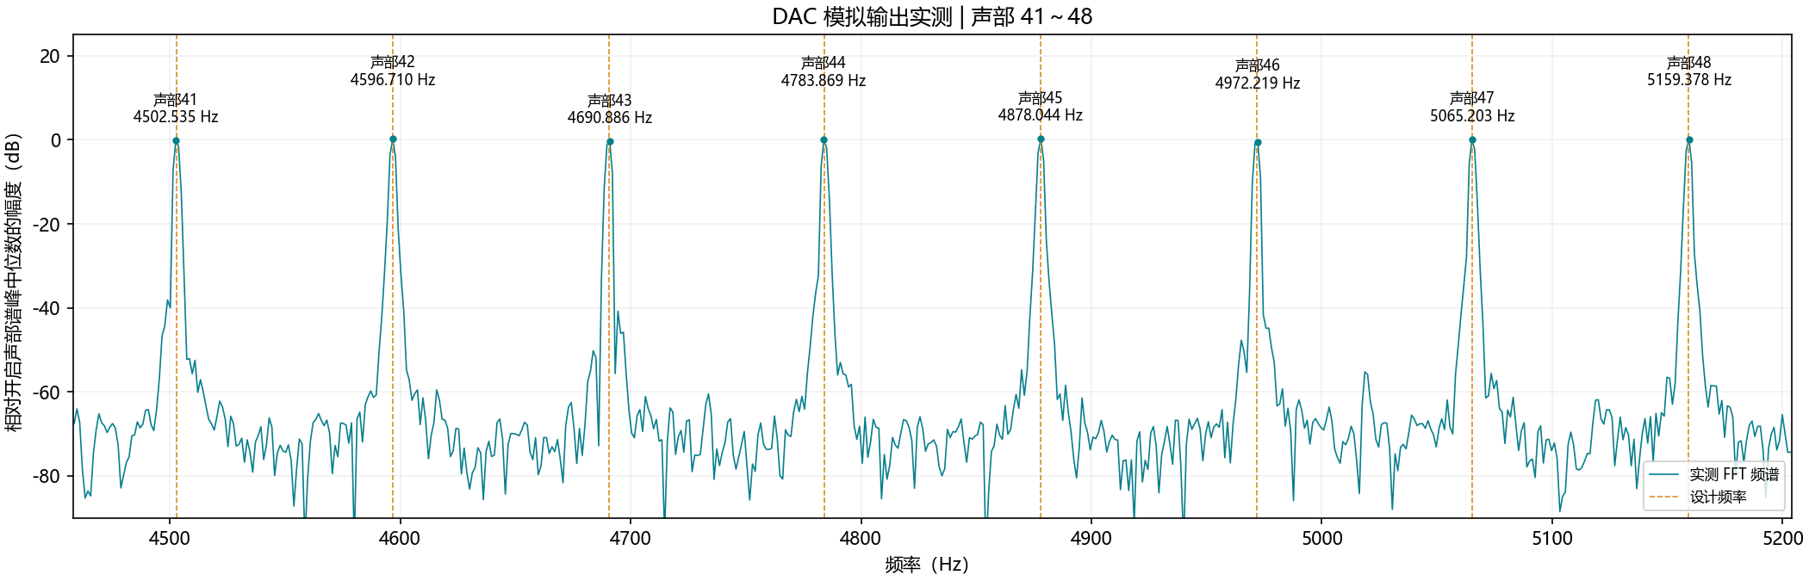
[picture p65: testing/measurements/reports/polyphony/mute18_64_001/zoom_41_48.png]
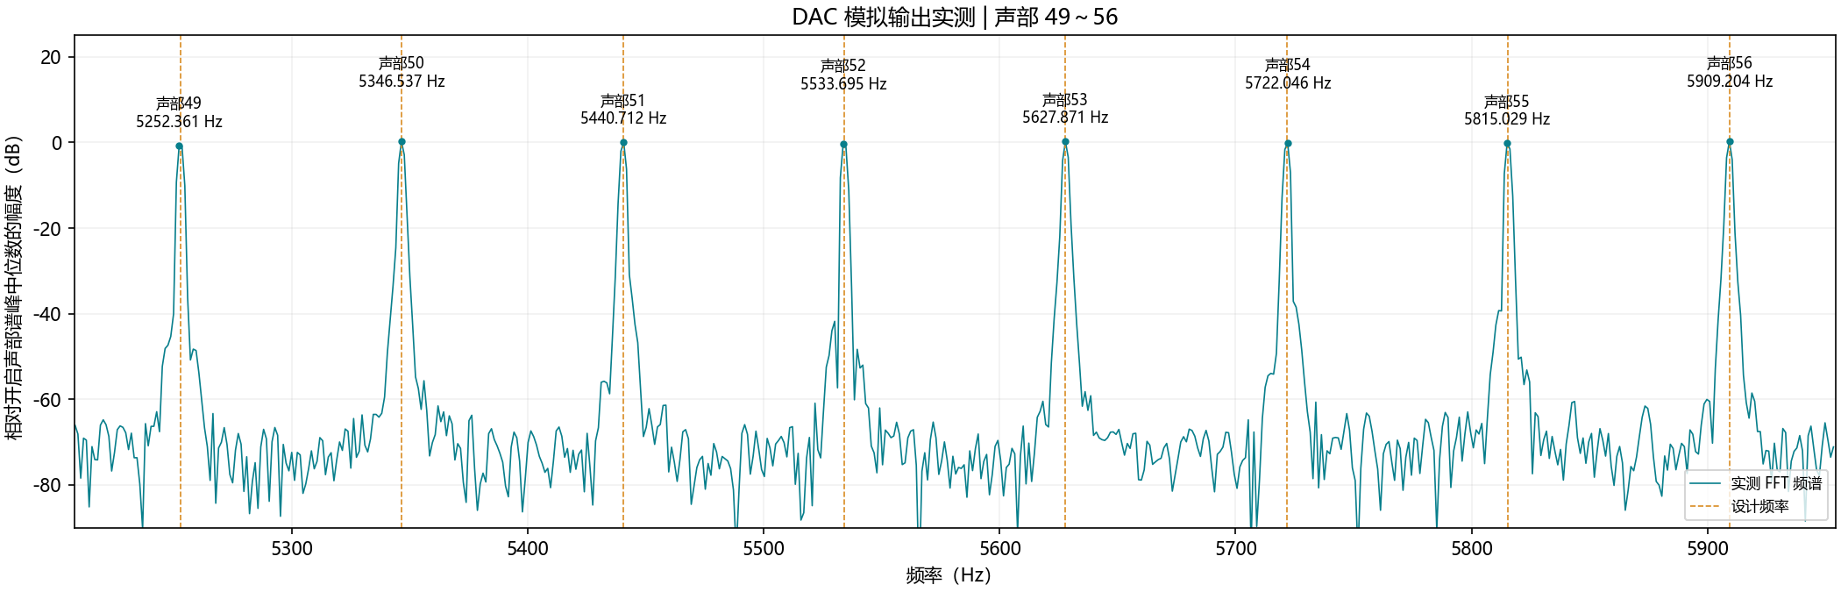
[picture p66: testing/measurements/reports/polyphony/mute18_64_001/zoom_49_56.png]
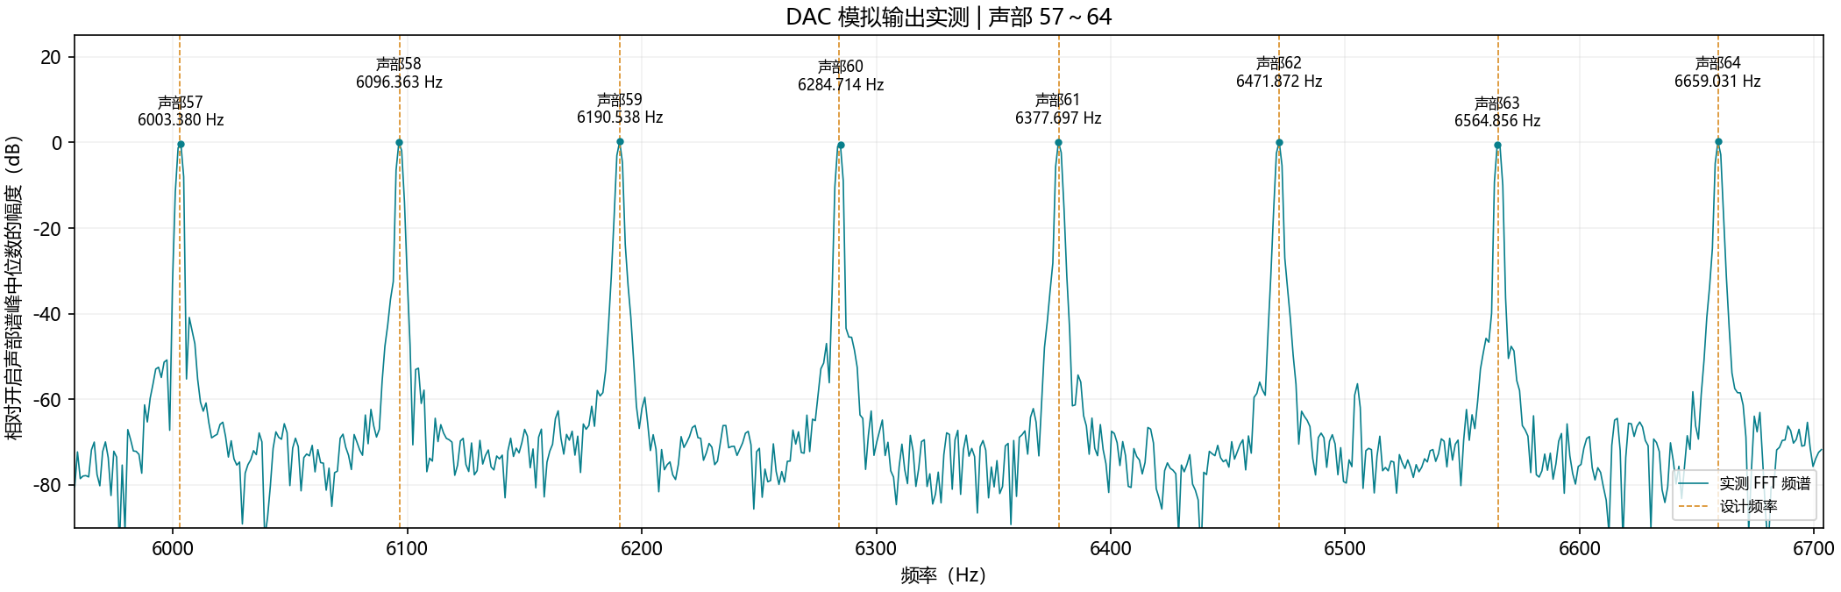
[picture p67: testing/measurements/reports/polyphony/mute18_64_001/zoom_57_64.png]
