user-lqt/gowin-fpga-instrument-138k/testing/measurements/reports/polyphony/video test/all_64_002_video_test/report.html

# 复音频率测量证据

DAC 模拟输出实测 | 64 声部 | 全声部开启 | 工具自检：通过
记录时长 0.700000 s；FFT 频点间隔 1.192093 Hz；共同频率缩放拟合系数 1.00000500。频率显示的小数位数不代表仪器测量准确度。
橙色虚线：设计频率。圆点标注：实测 FFT 频点的幅度最大位置。关闭声部不把噪声最大值作为音调频率报告。
此处通过/未通过为工具自检结果；自检阈值不是赛题直接规定，不能替代最终比赛验收。频谱峰数也不能单独证明 RTL 振荡器的独立性。

## 频谱总览

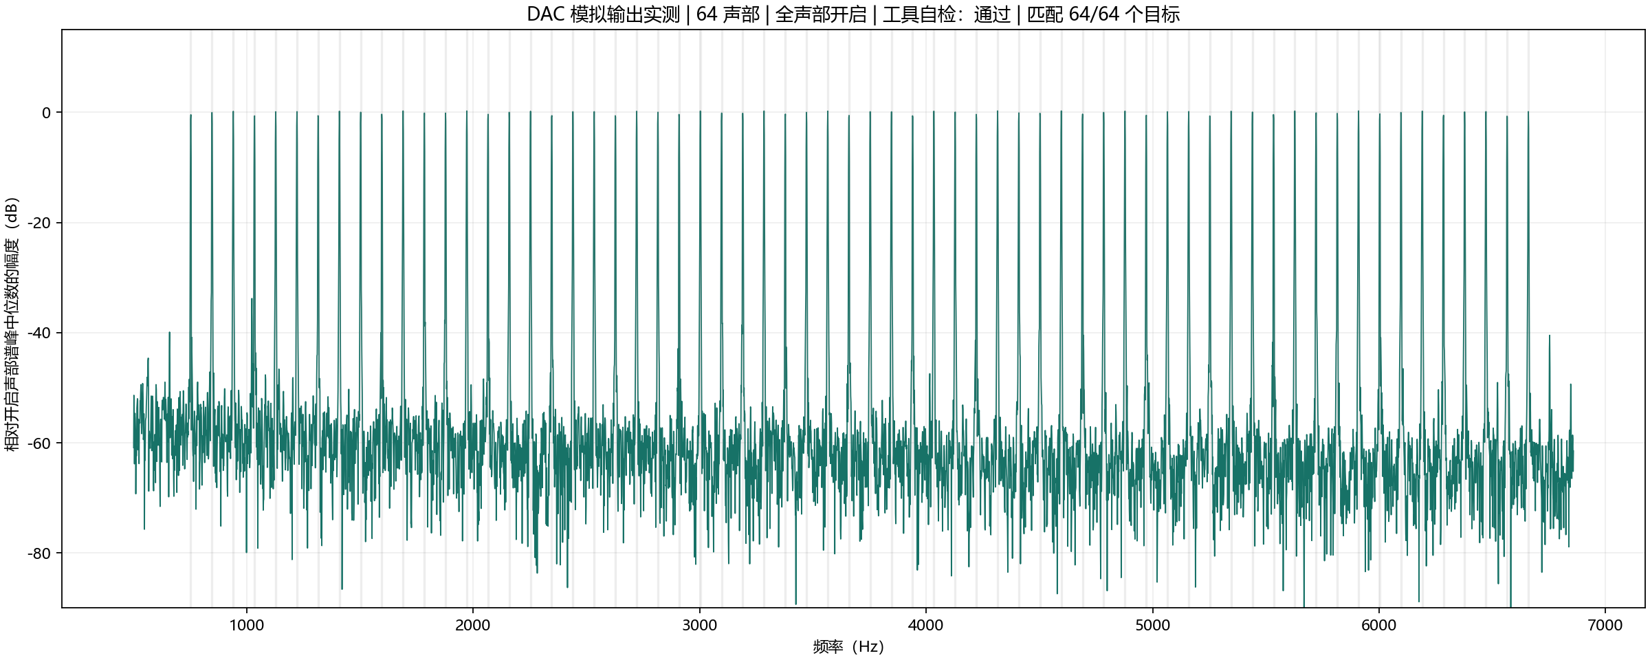
[picture p68: testing/measurements/reports/polyphony/video test/all_64_002_video_test/spectrum.png]
实测频谱总览


## 频率明细

频率偏差 CSV | 可打印频率表

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

## 标注放大图

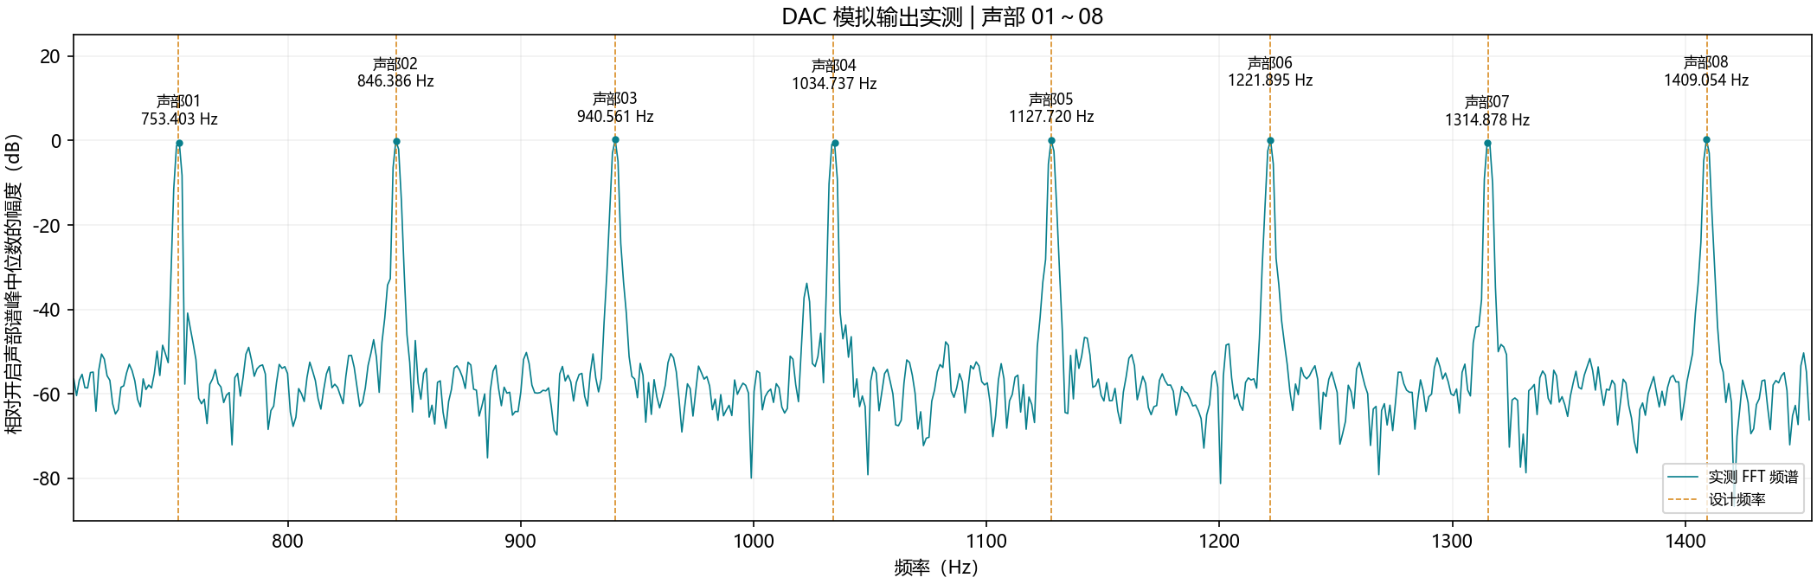
[picture p69: testing/measurements/reports/polyphony/video test/all_64_002_video_test/zoom_01_08.png]
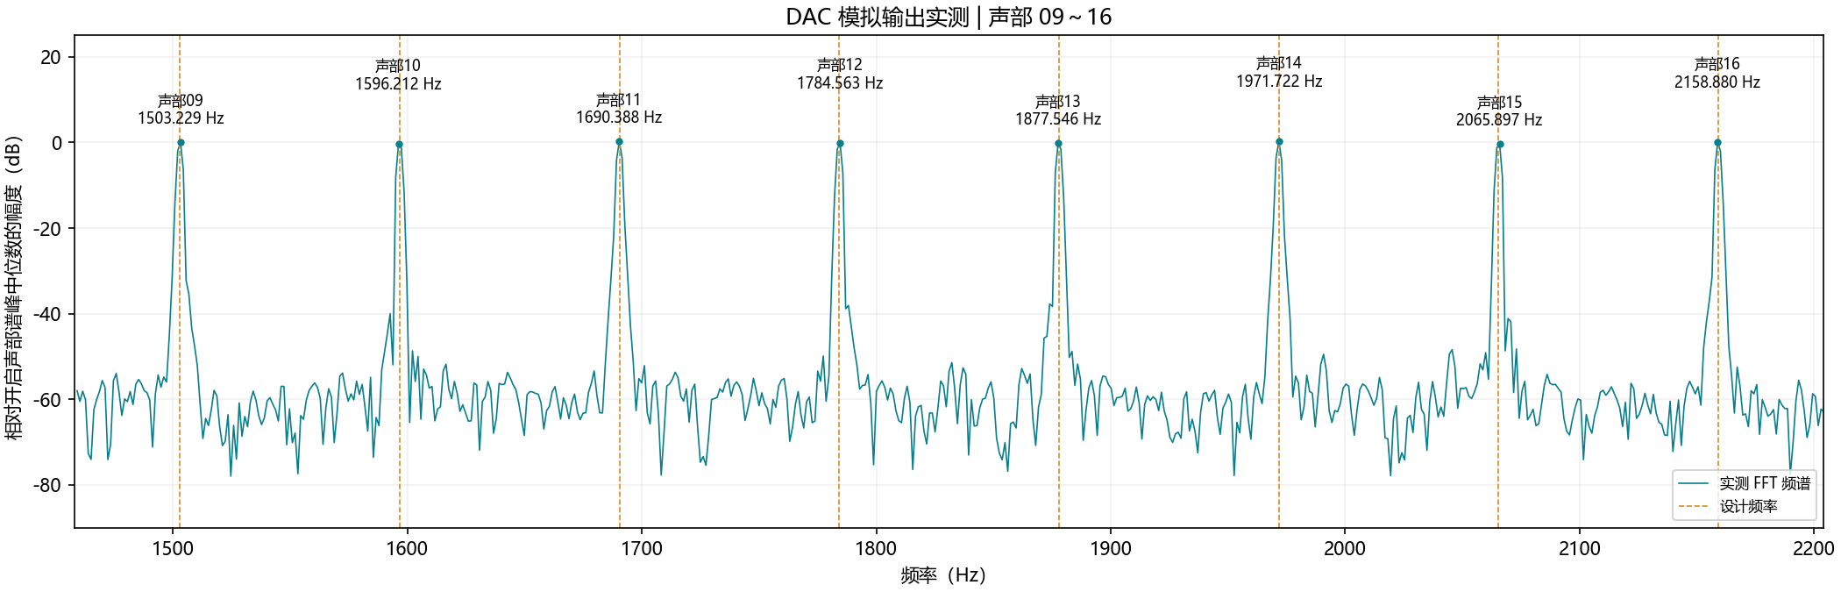
[picture p70: testing/measurements/reports/polyphony/video test/all_64_002_video_test/zoom_09_16.png]
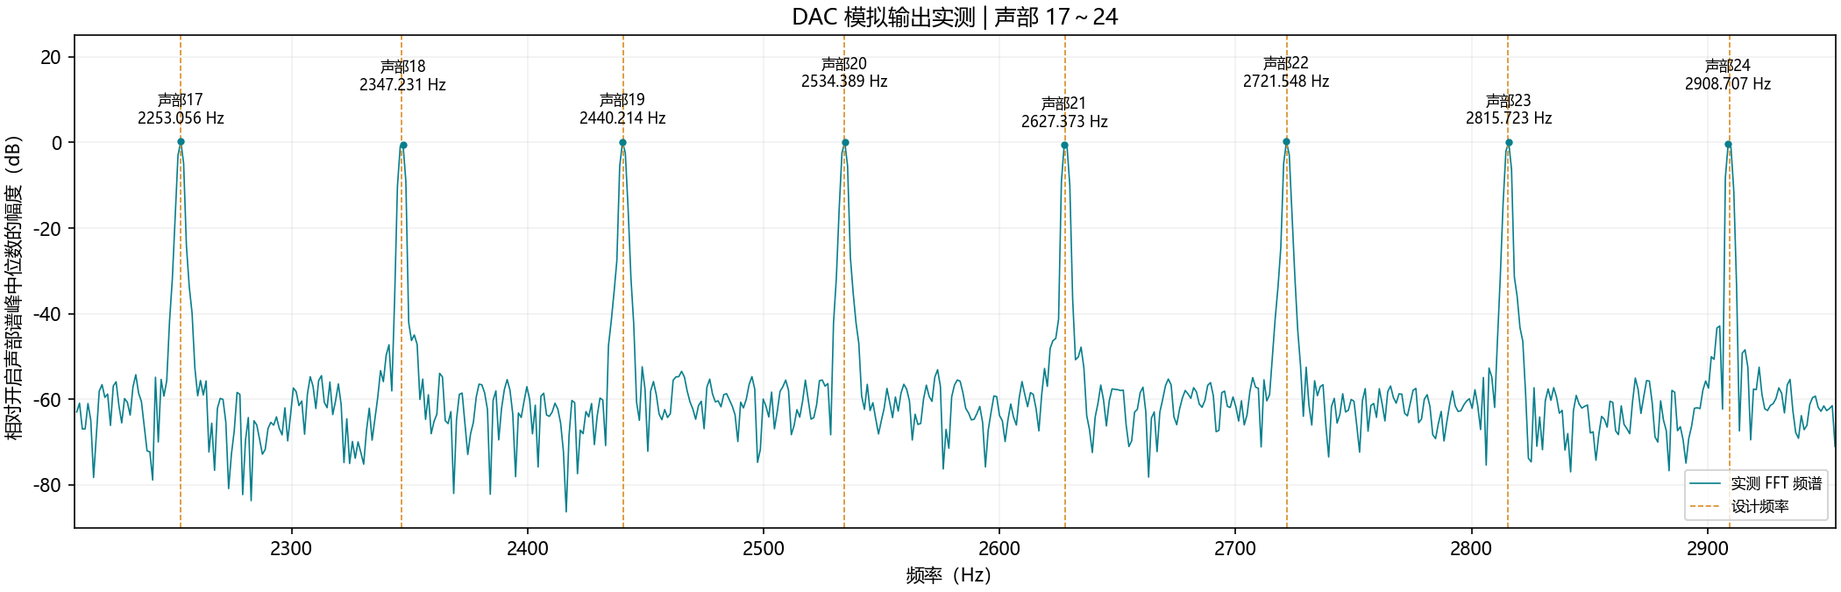
[picture p71: testing/measurements/reports/polyphony/video test/all_64_002_video_test/zoom_17_24.png]
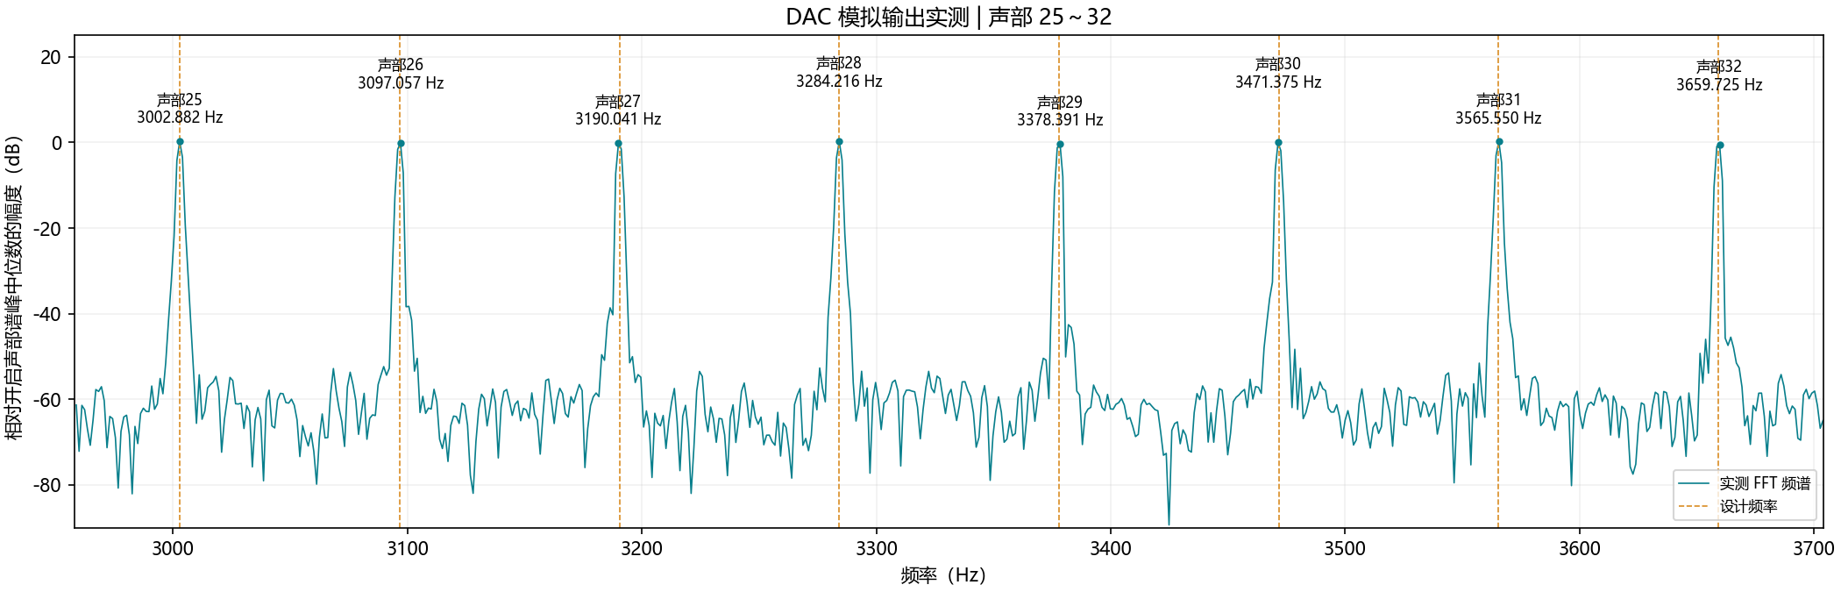
[picture p72: testing/measurements/reports/polyphony/video test/all_64_002_video_test/zoom_25_32.png]
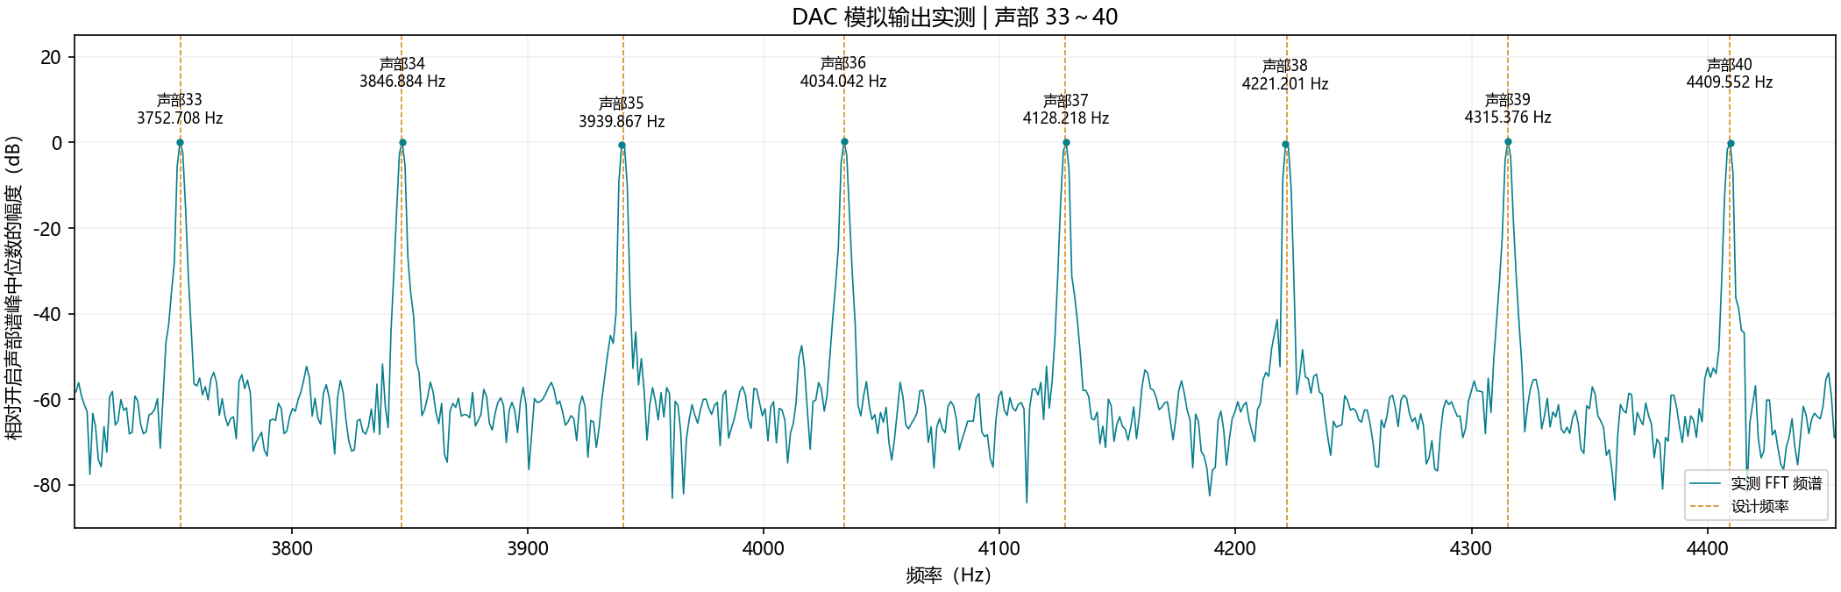
[picture p73: testing/measurements/reports/polyphony/video test/all_64_002_video_test/zoom_33_40.png]
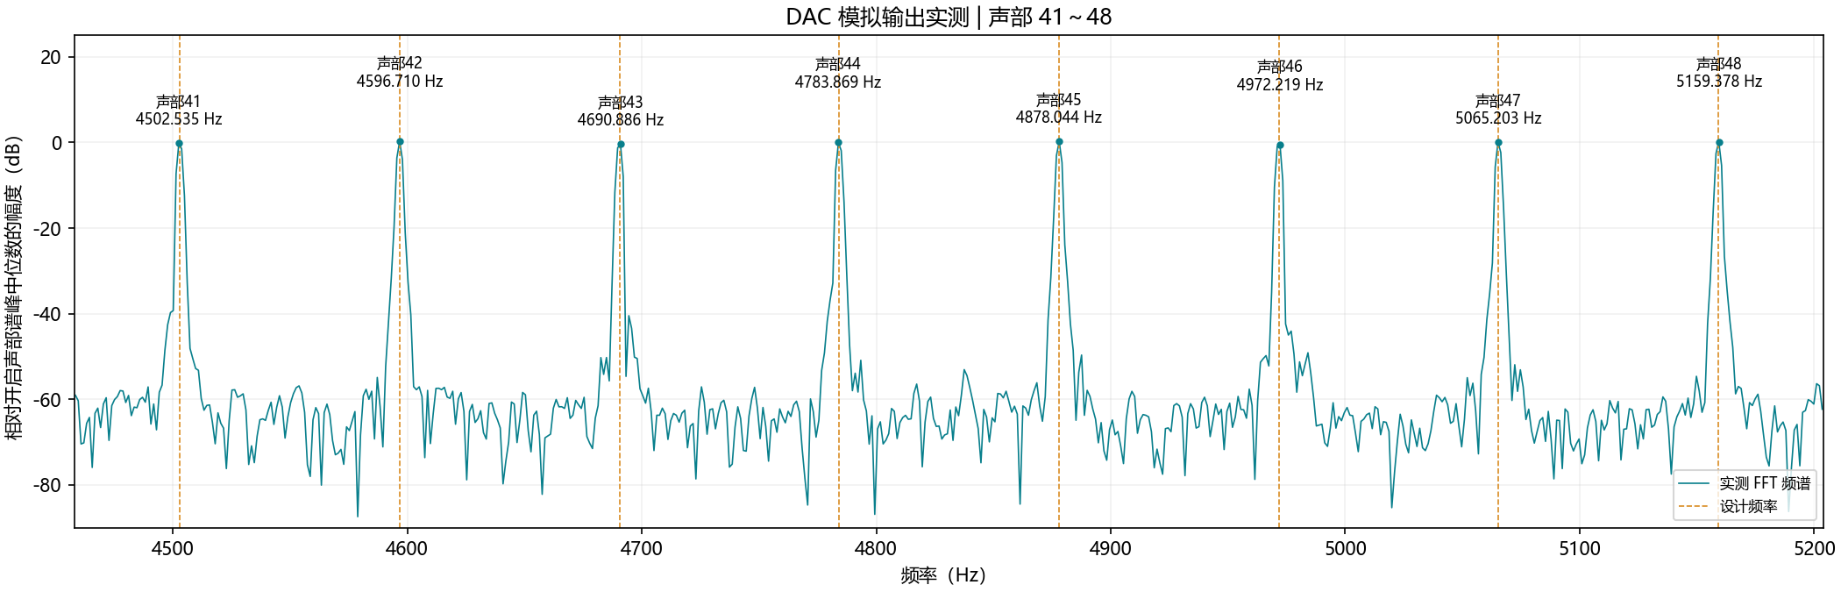
[picture p74: testing/measurements/reports/polyphony/video test/all_64_002_video_test/zoom_41_48.png]
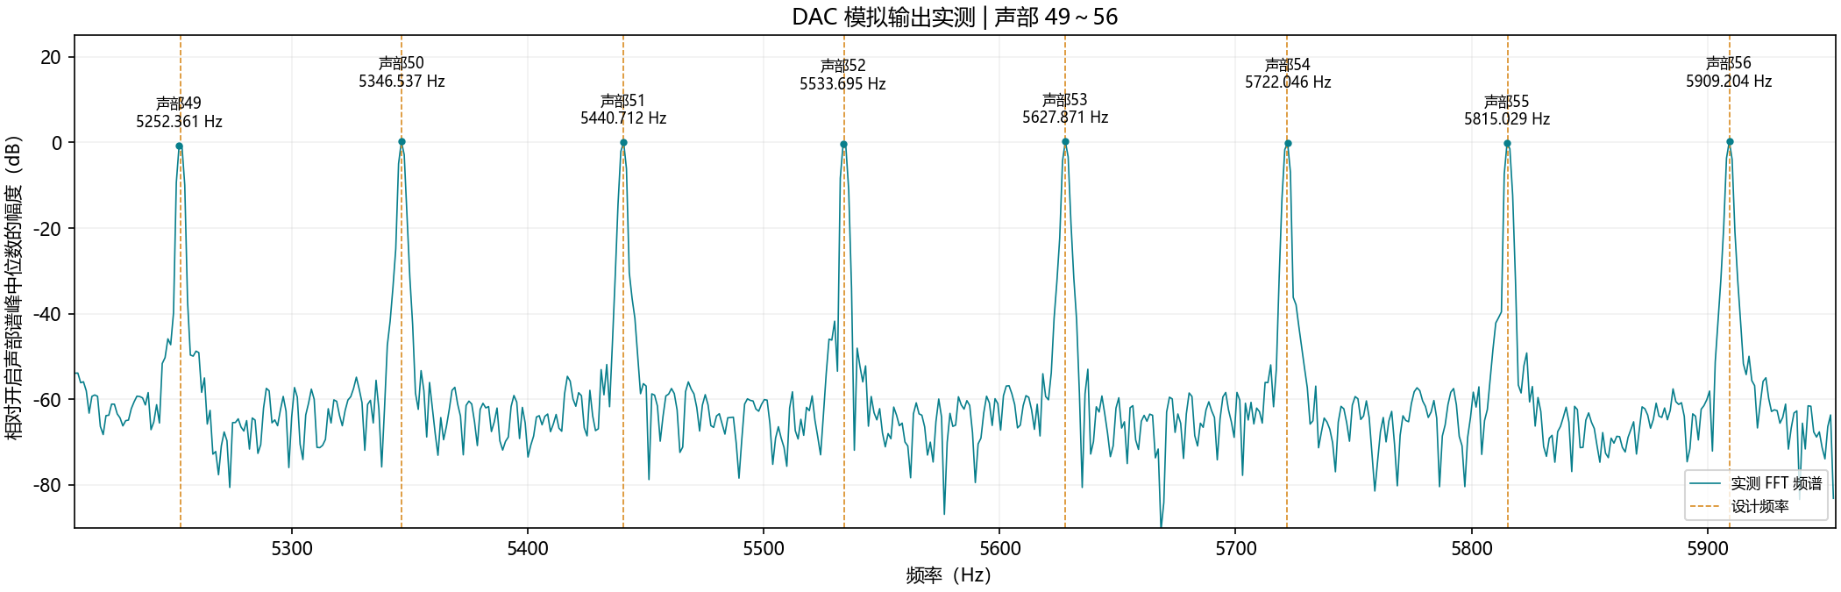
[picture p75: testing/measurements/reports/polyphony/video test/all_64_002_video_test/zoom_49_56.png]
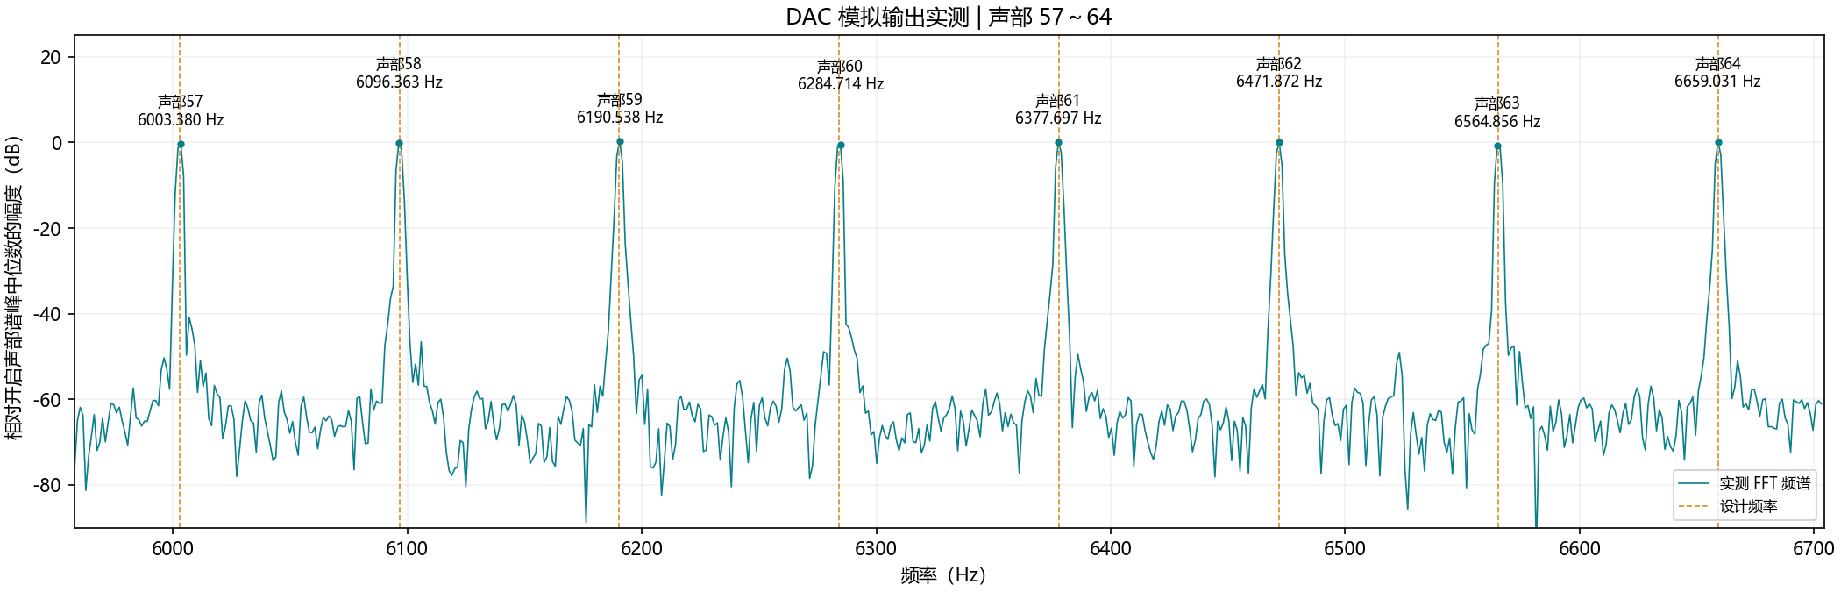
[picture p76: testing/measurements/reports/polyphony/video test/all_64_002_video_test/zoom_57_64.png]
