user-lqt/gowin-fpga-instrument-138k/testing/measurements/reports/latency/full_key_budget_001/keys.csv

按键 | 次数 | 原最大间隔/ms | 原最大包络/ms | 最大新增相位偏移/µs | 基础时基条件性包络/ms | 10年漂移情景条件性包络/ms
K1 | 3 | 3.644728691772292 | 3.84899544464415 | 13.360000000000454 | 3.8790944220047 | 3.8792883912734952
K2 | 3 | 3.5930106159047166 | 3.797556879091361 | 17.81000000000005 | 3.8276545704556226 | 3.8278459675389263
K3 | 4 | 3.6061888050226454 | 3.810775693109426 | 20.770000000001552 | 3.8408737149522993 | 3.841065773042404
K4 | 3 | 3.6008300759034615 | 3.8052425091561815 | 15.267499999999101 | 3.835340392665998 | 3.8355321740692365
K5 | 4 | 3.625808944732842 | 3.8303120194220446 | 19.94000000000301 | 3.8604105296852866 | 3.860603564689396
K6 | 3 | 3.6137245267497744 | 3.818217309556791 | 8.450000000000124 | 3.848315517444727 | 3.8485079476528647
K7 | 3 | 3.5444957330440023 | 3.7489306835184775 | 17.335000000000267 | 3.779027159197457 | 3.779216124727832
K8 | 4 | 3.5868463696439936 | 3.7912807283225844 | 18.444999999998878 | 3.8213782627791537 | 3.821569346023536
K9 | 3 | 3.5463612376715905 | 3.750857248178947 | 18.31499999999965 | 3.7809537720232473 | 3.7811428338914888
K10 | 4 | 3.531245920813369 | 3.7365080547993044 | 12.105000000001837 | 3.766604219904802 | 3.7667925642416225
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
