user-lqt/gowin-fpga-instrument-138k/testing/measurements/reports/lrck/lrck_002/periods.csv

上升沿相对触发时间（s） | 周期（µs）
-0.000687848251215175 | 20.847747915225
-0.00066700050329995 | 20.820747917925
-0.000646179755382025 | 20.83991458267501
-0.00062533984079935 | 20.832206250112495
-0.0006045076345492375 | 20.827372917262494
-0.000583680261631975 | 20.84599791540001
-0.000562834263716575 | 20.819997917999988
-0.0005420142657985749 | 20.843497915649998
-0.000521170767882925 | 20.827497917250003
-0.000500343269965675 | 20.832747916725005
-0.00047951052204895 | 20.839997916000005
-0.00045867052413295 | 20.82266458440003
-0.00043784785954854996 | 20.84608124872496
-0.000417001778299825 | 20.823497917650037
-0.00039617828038217496 | 20.837747916224995
-0.00037534053246594996 | 20.834664583200006
-0.00035450586788274995 | 20.824081250924948
-0.000333681786631825 | 20.848247915175
-0.00031283353871665 | 20.820331251299997
-0.00029201320746535 | 20.841664582500048
-0.00027117154288284996 | 20.829664583700016
-0.00025034187829914994 | 20.830081250324938
-0.000229511797048825 | 20.843247915675068
-0.00020866854913314994 | 20.82099791789996
-0.00018784755121524998 | 20.844997915500024
-0.00016700255329974995 | 20.824997917499953
-0.00014617755538225 | 20.835247916474973
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
