user-lqt/gowin-fpga-instrument-138k/testing/measurements/reports/polyphony/all_64_001/frequency_errors.csv

声部 | 开启状态 | 设计频率（Hz） | 时钟拟合后的预期频率（Hz） | 实测频率（Hz） | 谱峰幅度（V） | 相对幅度（dB） | 谱峰信噪比估计（dB） | 检出谱峰 | 目标检查 | 频率偏差（Hz）
1 | 开启 | 752.9296875 | 752.9296875 | 753.4027099609375 | 0.04497426580709753 | -0.3989633611610733 | 69.20469523266597 | 是 | 符合 | 0.4730224609375
2 | 开启 | 846.6796875 | 846.6796875 | 846.3859558105469 | 0.047063310258563223 | -0.004595596311893864 | 69.59906299751515 | 是 | 符合 | -0.293731689453125
3 | 开启 | 940.4296875 | 940.4296875 | 940.5612945556641 | 0.0481208792360099 | 0.1884260703650138 | 69.79208466419206 | 是 | 符合 | 0.1316070556640625
4 | 开启 | 1034.1796875 | 1034.1796875 | 1034.7366333007812 | 0.043866826911834016 | -0.6155205871281839 | 68.98813800669886 | 是 | 符合 | 0.55694580078125
5 | 开启 | 1127.9296875 | 1127.9296875 | 1127.7198791503906 | 0.04776237717663766 | 0.12347366991775038 | 69.72713226374479 | 是 | 符合 | -0.209808349609375
6 | 开启 | 1221.6796875 | 1221.6796875 | 1221.8952178955078 | 0.047849565189894756 | 0.13931490589898626 | 69.74297349972603 | 是 | 符合 | 0.2155303955078125
7 | 开启 | 1315.4296875 | 1315.4296875 | 1314.8784637451172 | 0.04404900407424285 | -0.5795231342377742 | 69.02413545958926 | 是 | 符合 | -0.5512237548828125
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
