user-lqt/gowin-fpga-instrument-138k/testing/measurements/reports/polyphony/all_64_001/peaks.csv

voice | enabled | nominal_hz | predicted_hz | measured_hz | amplitude_peak | relative_db | snr_db | present | match
1 | True | 752.9296875 | 752.9296875 | 753.4027099609375 | 0.04497426580709753 | -0.3989633611610733 | 69.20469523266597 | True | True
2 | True | 846.6796875 | 846.6796875 | 846.3859558105469 | 0.047063310258563223 | -0.004595596311893864 | 69.59906299751515 | True | True
3 | True | 940.4296875 | 940.4296875 | 940.5612945556641 | 0.0481208792360099 | 0.1884260703650138 | 69.79208466419206 | True | True
4 | True | 1034.1796875 | 1034.1796875 | 1034.7366333007812 | 0.043866826911834016 | -0.6155205871281839 | 68.98813800669886 | True | True
5 | True | 1127.9296875 | 1127.9296875 | 1127.7198791503906 | 0.04776237717663766 | 0.12347366991775038 | 69.72713226374479 | True | True
6 | True | 1221.6796875 | 1221.6796875 | 1221.8952178955078 | 0.047849565189894756 | 0.13931490589898626 | 69.74297349972603 | True | True
7 | True | 1315.4296875 | 1315.4296875 | 1314.8784637451172 | 0.04404900407424285 | -0.5795231342377742 | 69.02413545958926 | True | True
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
