user-lqt/gowin-fpga-instrument-138k/testing/measurements/reports/polyphony/group01_64_001/frequency_errors.csv

声部 | 开启状态 | 设计频率（Hz） | 时钟拟合后的预期频率（Hz） | 实测频率（Hz） | 谱峰幅度（V） | 相对幅度（dB） | 谱峰信噪比估计（dB） | 检出谱峰 | 目标检查 | 频率偏差（Hz）
1 | 开启 | 752.9296875 | 752.9108642578125 | 753.4027099609375 | 0.04498646068789409 | -0.3865613105518261 | 69.96214351485116 | 是 | 符合 | 0.4730224609375
2 | 开启 | 846.6796875 | 846.6585205078125 | 846.3859558105469 | 0.04706201594308222 | 0.0052126946050418625 | 70.35391752000803 | 是 | 符合 | -0.293731689453125
3 | 开启 | 940.4296875 | 940.4061767578124 | 940.5612945556641 | 0.048107084735617714 | 0.19598295566242474 | 70.54468778106542 | 是 | 符合 | 0.1316070556640625
4 | 开启 | 1034.1796875 | 1034.1538330078124 | 1034.7366333007812 | 0.0438551868137564 | -0.6077785309225964 | 69.74092629448039 | 是 | 符合 | 0.55694580078125
5 | 开启 | 1127.9296875 | 1127.9014892578125 | 1127.7198791503906 | 0.04783159265078053 | 0.14609899879841712 | 70.49480382420141 | 是 | 符合 | -0.209808349609375
6 | 开启 | 1221.6796875 | 1221.6491455078124 | 1221.8952178955078 | 0.047805395540547795 | 0.14134047977116185 | 70.49004530517415 | 是 | 符合 | 0.2155303955078125
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
