user-lqt/gowin-fpga-instrument-138k/testing/measurements/reports/polyphony/group01_64_001/peaks.csv

voice | enabled | nominal_hz | predicted_hz | measured_hz | amplitude_peak | relative_db | snr_db | present | match
1 | True | 752.9296875 | 752.9108642578125 | 753.4027099609375 | 0.04498646068789409 | -0.3865613105518261 | 69.96214351485116 | True | True
2 | True | 846.6796875 | 846.6585205078125 | 846.3859558105469 | 0.04706201594308222 | 0.0052126946050418625 | 70.35391752000803 | True | True
3 | True | 940.4296875 | 940.4061767578124 | 940.5612945556641 | 0.048107084735617714 | 0.19598295566242474 | 70.54468778106542 | True | True
4 | True | 1034.1796875 | 1034.1538330078124 | 1034.7366333007812 | 0.0438551868137564 | -0.6077785309225964 | 69.74092629448039 | True | True
5 | True | 1127.9296875 | 1127.9014892578125 | 1127.7198791503906 | 0.04783159265078053 | 0.14609899879841712 | 70.49480382420141 | True | True
6 | True | 1221.6796875 | 1221.6491455078124 | 1221.8952178955078 | 0.047805395540547795 | 0.14134047977116185 | 70.49004530517415 | True | True
7 | True | 1315.4296875 | 1315.3968017578125 | 1314.8784637451172 | 0.044076229364010906 | -0.5641091502962146 | 69.78459567510677 | True | True
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
