user-lqt/gowin-fpga-instrument-138k/testing/measurements/reports/polyphony/group02_64_001/frequency_errors.csv

声部 | 开启状态 | 设计频率（Hz） | 时钟拟合后的预期频率（Hz） | 实测频率（Hz） | 谱峰幅度（V） | 相对幅度（dB） | 谱峰信噪比估计（dB） | 检出谱峰 | 目标检查 | 频率偏差（Hz）
1 | 关闭 | 752.9296875 | 752.9372167968751 | 753.4027099609375 | 9.309181641466991e-05 | -54.07539256268646 | 16.516886502171783 | 否 | 符合 | 未记录
2 | 关闭 | 846.6796875 | 846.688154296875 | 846.3859558105469 | 7.964598015497881e-05 | -55.43034542546462 | 15.161933639393624 | 否 | 符合 | 未记录
3 | 关闭 | 940.4296875 | 940.4390917968751 | 940.5612945556641 | 5.789905360770762e-05 | -58.2001933501589 | 12.392085714699348 | 否 | 符合 | 未记录
4 | 关闭 | 1034.1796875 | 1034.190029296875 | 1034.7366333007812 | 6.830020875848368e-05 | -56.76518202820961 | 13.827097036648638 | 否 | 符合 | 未记录
5 | 关闭 | 1127.9296875 | 1127.940966796875 | 1127.7198791503906 | 5.637687755398629e-05 | -58.431602276075424 | 12.160676788782819 | 否 | 符合 | 未记录
6 | 关闭 | 1221.6796875 | 1221.691904296875 | 1224.2794036865234 | 3.492985959379179e-05 | -62.58968585167423 | 8.002593213184015 | 否 | 符合 | 未记录
7 | 关闭 | 1315.4296875 | 1315.442841796875 | 1312.4942779541016 | 7.982494729809806e-05 | -55.410849840515006 | 15.181429224343246 | 否 | 符合 | 未记录
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
