user-lqt/gowin-fpga-instrument-138k/testing/measurements/reports/polyphony/group02_64_001/peaks.csv

voice | enabled | nominal_hz | predicted_hz | measured_hz | amplitude_peak | relative_db | snr_db | present | match
1 | False | 752.9296875 | 752.9372167968751 | 753.4027099609375 | 9.309181641466991e-05 | -54.07539256268646 | 16.516886502171783 | False | True
2 | False | 846.6796875 | 846.688154296875 | 846.3859558105469 | 7.964598015497881e-05 | -55.43034542546462 | 15.161933639393624 | False | True
3 | False | 940.4296875 | 940.4390917968751 | 940.5612945556641 | 5.789905360770762e-05 | -58.2001933501589 | 12.392085714699348 | False | True
4 | False | 1034.1796875 | 1034.190029296875 | 1034.7366333007812 | 6.830020875848368e-05 | -56.76518202820961 | 13.827097036648638 | False | True
5 | False | 1127.9296875 | 1127.940966796875 | 1127.7198791503906 | 5.637687755398629e-05 | -58.431602276075424 | 12.160676788782819 | False | True
6 | False | 1221.6796875 | 1221.691904296875 | 1224.2794036865234 | 3.492985959379179e-05 | -62.58968585167423 | 8.002593213184015 | False | True
7 | False | 1315.4296875 | 1315.442841796875 | 1312.4942779541016 | 7.982494729809806e-05 | -55.410849840515006 | 15.181429224343246 | False | True
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
