user-lqt/gowin-fpga-instrument-138k/testing/measurements/reports/polyphony/group03_64_001/peaks.csv

voice | enabled | nominal_hz | predicted_hz | measured_hz | amplitude_peak | relative_db | snr_db | present | match
1 | False | 752.9296875 | 752.9334521484375 | 753.4027099609375 | 7.846073844566496e-05 | -55.63029040173503 | 14.942839162269415 | False | True
2 | False | 846.6796875 | 846.6839208984376 | 846.3859558105469 | 4.264194505524159e-05 | -60.92659810198077 | 9.646531462023676 | False | True
3 | False | 940.4296875 | 940.4343896484376 | 936.9850158691406 | 4.2118371016660854e-05 | -61.03390690804496 | 9.539222655959483 | False | True
4 | False | 1034.1796875 | 1034.1848583984374 | 1037.1208190917969 | 4.161825398456678e-05 | -61.13766110159482 | 9.43546846240962 | False | True
5 | False | 1127.9296875 | 1127.9353271484376 | 1124.1436004638672 | 3.651022035089673e-05 | -62.27504914533171 | 8.29808041867274 | False | True
6 | False | 1221.6796875 | 1221.6857958984376 | 1220.703125 | 5.8081512742688465e-05 | -58.24257984438447 | 12.330549719619972 | False | True
7 | False | 1315.4296875 | 1315.4362646484376 | 1312.4942779541016 | 5.341428578896288e-05 | -58.97018971167312 | 11.602939852331325 | False | True
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
