user-lqt/gowin-fpga-instrument-138k/testing/measurements/reports/polyphony/group04_64_001/frequency_errors.csv

声部 | 开启状态 | 设计频率（Hz） | 时钟拟合后的预期频率（Hz） | 实测频率（Hz） | 谱峰幅度（V） | 相对幅度（dB） | 谱峰信噪比估计（dB） | 检出谱峰 | 目标检查 | 频率偏差（Hz）
1 | 关闭 | 752.9296875 | 752.922158203125 | 754.5948028564453 | 3.790493619107713e-05 | -61.883002054881274 | 8.446490041459407 | 否 | 符合 | 未记录
2 | 关闭 | 846.6796875 | 846.6712207031251 | 842.8096771240234 | 2.3516980549934603e-05 | -66.0292862530925 | 4.30020584324819 | 否 | 符合 | 未记录
3 | 关闭 | 940.4296875 | 940.420283203125 | 942.9454803466797 | 4.259809437565886e-05 | -60.86911402487544 | 9.460378071465257 | 否 | 符合 | 未记录
4 | 关闭 | 1034.1796875 | 1034.1693457031251 | 1033.5445404052734 | 3.409425429319371e-05 | -62.80329353202912 | 7.52619856431156 | 否 | 符合 | 未记录
5 | 关闭 | 1127.9296875 | 1127.918408203125 | 1125.335693359375 | 4.571641428485443e-05 | -60.255474259365045 | 10.07401783697565 | 否 | 符合 | 未记录
6 | 关闭 | 1221.6796875 | 1221.667470703125 | 1218.3189392089844 | 5.932780114492562e-05 | -57.991752403405876 | 12.337739692934814 | 否 | 符合 | 未记录
7 | 关闭 | 1315.4296875 | 1315.416533203125 | 1312.4942779541016 | 6.724505422360244e-05 | -56.90371049026461 | 13.425781606076084 | 否 | 符合 | 未记录
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
