user-lqt/gowin-fpga-instrument-138k/testing/measurements/reports/polyphony/mute01_64_001/frequency_errors.csv

声部 | 开启状态 | 设计频率（Hz） | 时钟拟合后的预期频率（Hz） | 实测频率（Hz） | 谱峰幅度（V） | 相对幅度（dB） | 谱峰信噪比估计（dB） | 检出谱峰 | 目标检查 | 频率偏差（Hz）
1 | 关闭 | 752.9296875 | 752.9296875 | 752.2106170654297 | 0.0001083381690944351 | -52.77043735260978 | 16.736845309413862 | 否 | 符合 | 未记录
2 | 开启 | 846.6796875 | 846.6796875 | 846.3859558105469 | 0.047078569374749926 | -0.00960204778673788 | 69.49768061423691 | 是 | 符合 | -0.293731689453125
3 | 开启 | 940.4296875 | 940.4296875 | 940.5612945556641 | 0.04820626927838939 | 0.19600325964645324 | 69.7032859216701 | 是 | 符合 | 0.1316070556640625
4 | 开启 | 1034.1796875 | 1034.1796875 | 1034.7366333007812 | 0.043898105452081226 | -0.6171516395042991 | 68.89013102251936 | 是 | 符合 | 0.55694580078125
5 | 开启 | 1127.9296875 | 1127.9296875 | 1127.7198791503906 | 0.0478412793902739 | 0.12998851608341874 | 69.63727117810707 | 是 | 符合 | -0.209808349609375
6 | 开启 | 1221.6796875 | 1221.6796875 | 1221.8952178955078 | 0.047806032769737314 | 0.12358690869812566 | 69.63086957072177 | 是 | 符合 | 0.2155303955078125
7 | 开启 | 1315.4296875 | 1315.4296875 | 1314.8784637451172 | 0.044030113619617305 | -0.5910710649603 | 68.91621159706335 | 是 | 符合 | -0.5512237548828125
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
