user-lqt/gowin-fpga-instrument-138k/testing/measurements/reports/polyphony/mute01_64_001/peaks.csv

voice | enabled | nominal_hz | predicted_hz | measured_hz | amplitude_peak | relative_db | snr_db | present | match
1 | False | 752.9296875 | 752.9296875 | 752.2106170654297 | 0.0001083381690944351 | -52.77043735260978 | 16.736845309413862 | False | True
2 | True | 846.6796875 | 846.6796875 | 846.3859558105469 | 0.047078569374749926 | -0.00960204778673788 | 69.49768061423691 | True | True
3 | True | 940.4296875 | 940.4296875 | 940.5612945556641 | 0.04820626927838939 | 0.19600325964645324 | 69.7032859216701 | True | True
4 | True | 1034.1796875 | 1034.1796875 | 1034.7366333007812 | 0.043898105452081226 | -0.6171516395042991 | 68.89013102251936 | True | True
5 | True | 1127.9296875 | 1127.9296875 | 1127.7198791503906 | 0.0478412793902739 | 0.12998851608341874 | 69.63727117810707 | True | True
6 | True | 1221.6796875 | 1221.6796875 | 1221.8952178955078 | 0.047806032769737314 | 0.12358690869812566 | 69.63086957072177 | True | True
7 | True | 1315.4296875 | 1315.4296875 | 1314.8784637451172 | 0.044030113619617305 | -0.5910710649603 | 68.91621159706335 | True | True
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
