user-lqt/gowin-fpga-instrument-138k/testing/measurements/reports/polyphony/mute18_64_001/frequency_errors.csv

声部 | 开启状态 | 设计频率（Hz） | 时钟拟合后的预期频率（Hz） | 实测频率（Hz） | 谱峰幅度（V） | 相对幅度（dB） | 谱峰信噪比估计（dB） | 检出谱峰 | 目标检查 | 频率偏差（Hz）
1 | 开启 | 752.9296875 | 752.9296875 | 753.4027099609375 | 0.045089288603890096 | -0.3890607397870047 | 68.87231348148623 | 是 | 符合 | 0.4730224609375
2 | 开启 | 846.6796875 | 846.6796875 | 846.3859558105469 | 0.04716969273583806 | 0.0027325396660514032 | 69.26410676093928 | 是 | 符合 | -0.293731689453125
3 | 开启 | 940.4296875 | 940.4296875 | 940.5612945556641 | 0.04829402659175024 | 0.20733993274465673 | 69.46871415401789 | 是 | 符合 | 0.1316070556640625
4 | 开启 | 1034.1796875 | 1034.1796875 | 1034.7366333007812 | 0.044016071231565285 | -0.5983028880336669 | 68.66307133323957 | 是 | 符合 | 0.55694580078125
5 | 开启 | 1127.9296875 | 1127.9296875 | 1127.7198791503906 | 0.047878938639799425 | 0.13236188626560907 | 69.39373610753884 | 是 | 符合 | -0.209808349609375
6 | 开启 | 1221.6796875 | 1221.6796875 | 1221.8952178955078 | 0.047811296366607366 | 0.12008198293719899 | 69.38145620421044 | 是 | 符合 | 0.2155303955078125
7 | 开启 | 1315.4296875 | 1315.4296875 | 1314.8784637451172 | 0.044094179691562145 | -0.5829030535321583 | 68.67847116774108 | 是 | 符合 | -0.5512237548828125
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
