user-lqt/gowin-fpga-instrument-138k/testing/measurements/reports/polyphony/mute18_64_001/peaks.csv

voice | enabled | nominal_hz | predicted_hz | measured_hz | amplitude_peak | relative_db | snr_db | present | match
1 | True | 752.9296875 | 752.9296875 | 753.4027099609375 | 0.045089288603890096 | -0.3890607397870047 | 68.87231348148623 | True | True
2 | True | 846.6796875 | 846.6796875 | 846.3859558105469 | 0.04716969273583806 | 0.0027325396660514032 | 69.26410676093928 | True | True
3 | True | 940.4296875 | 940.4296875 | 940.5612945556641 | 0.04829402659175024 | 0.20733993274465673 | 69.46871415401789 | True | True
4 | True | 1034.1796875 | 1034.1796875 | 1034.7366333007812 | 0.044016071231565285 | -0.5983028880336669 | 68.66307133323957 | True | True
5 | True | 1127.9296875 | 1127.9296875 | 1127.7198791503906 | 0.047878938639799425 | 0.13236188626560907 | 69.39373610753884 | True | True
6 | True | 1221.6796875 | 1221.6796875 | 1221.8952178955078 | 0.047811296366607366 | 0.12008198293719899 | 69.38145620421044 | True | True
7 | True | 1315.4296875 | 1315.4296875 | 1314.8784637451172 | 0.044094179691562145 | -0.5829030535321583 | 68.67847116774108 | True | True
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
