user-lqt/gowin-fpga-instrument-138k/testing/measurements/reports/latency/firmware_2A1C5EA9A07E/K01/medium/trial_001/audio_spectrum.csv

频率（Hz） | 幅度（V） | 幅度（dBV）
35.714285714285715 | 0.006002980628385248 | -44.43266116219775
71.42857142857143 | 0.008501768589362404 | -41.40981440641042
107.14285714285714 | 0.01268955288432933 | -37.93107359953926
142.85714285714286 | 0.01746049450126359 | -35.158869214752244
178.57142857142858 | 0.021871414589731224 | -33.202462538930185
214.28571428571428 | 0.024751932586735807 | -32.127817729365155
250.0 | 0.02584900967265357 | -31.75112181885965
285.7142857142857 | 0.023484795387919623 | -32.58426438539454
321.42857142857144 | 0.019408851507011313 | -34.240003253000026
357.14285714285717 | 0.014050176231271359 | -37.046364567436115
392.8571428571429 | 0.008245028488523777 | -41.67615678853407
428.57142857142856 | 0.0048458417899133535 | -46.29261538172196
464.2857142857143 | 0.007348226735832056 | -42.67634903262261
500.0 | 0.010323019799871117 | -39.72386479336732
535.7142857142858 | 0.011881211809438914 | -38.502785235391485
571.4285714285714 | 0.011798951893709206 | -38.563131391157434
607.1428571428571 | 0.010587864257079848 | -39.50383270513778
642.8571428571429 | 0.007756210131887176 | -42.207008669837606
678.5714285714286 | 0.0049601826834759005 | -46.090046563081195
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
