user-lqt/gowin-fpga-instrument-138k/testing/measurements/reports/latency/firmware_2A1C5EA9A07E/K01/medium/trial_001_video_test/audio_spectrum.csv

频率（Hz） | 幅度（V） | 幅度（dBV）
35.714285714285715 | 0.021109137006747263 | -33.51059042704319
71.42857142857143 | 0.023259934216293996 | -32.667830357534825
107.14285714285714 | 0.034204751916109354 | -29.318271102511467
142.85714285714286 | 0.049105480703774275 | -26.177400664029054
178.57142857142858 | 0.06786359020722466 | -23.36726336952028
214.28571428571428 | 0.2395721843325882 | -12.411272147368136
250.0 | 0.4582783576793305 | -6.777413038930467
285.7142857142857 | 0.40352001935091386 | -7.882698285606003
321.42857142857144 | 0.1605029634049212 | -15.890338894026563
357.14285714285717 | 0.06116432113930705 | -24.270036802452587
392.8571428571429 | 0.04833568646148855 | -26.314642183888182
428.57142857142856 | 0.04787167816057602 | -26.398426957733786
464.2857142857143 | 0.101644072297216 | -19.858358871492644
500.0 | 0.23651535102999124 | -12.522813322518697
535.7142857142858 | 0.27934356767524615 | -11.077226490036157
571.4285714285714 | 0.1636143892143447 | -15.723570091339523
607.1428571428571 | 0.05487181042561682 | -25.21301421146593
642.8571428571429 | 0.04129477497961105 | -27.682097921388817
678.5714285714286 | 0.03138792728439455 | -30.064747243610412
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
