user-lqt/gowin-fpga-instrument-138k/testing/measurements/reports/latency/firmware_2A1C5EA9A07E/K01/medium/trial_002/audio_spectrum.csv

频率（Hz） | 幅度（V） | 幅度（dBV）
35.714285714285715 | 0.016600611772790014 | -35.59751813720953
71.42857142857143 | 0.023506881011416708 | -32.57609982021589
107.14285714285714 | 0.027944343346957175 | -31.074121824839622
142.85714285714286 | 0.04096586915861966 | -27.751556528632634
178.57142857142858 | 0.06249835272190451 | -24.08262858534728
214.28571428571428 | 0.08160140704051785 | -21.766047054171697
250.0 | 0.08950031178631015 | -20.963509035170436
285.7142857142857 | 0.0820460776993622 | -21.71884352055169
321.42857142857144 | 0.06255908252417909 | -24.074192583109983
357.14285714285717 | 0.03978026465416504 | -28.006646637675026
392.8571428571429 | 0.021663187445060007 | -33.28555284899128
428.57142857142856 | 0.01672060667824193 | -35.53495937976684
464.2857142857143 | 0.026589982567289117 | -31.50563894794002
500.0 | 0.03909588277161278 | -28.15737952406159
535.7142857142858 | 0.04567228373562752 | -26.80694543942378
571.4285714285714 | 0.04359773975181604 | -27.210720507636807
607.1428571428571 | 0.03447926798982485 | -29.24883926028432
642.8571428571429 | 0.023533853145346582 | -32.56613921868654
678.5714285714286 | 0.014504407185827108 | -36.770000333690035
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
