user-lqt/gowin-fpga-instrument-138k/testing/measurements/reports/latency/firmware_2A1C5EA9A07E/K01/medium/trial_003/audio_spectrum.csv

频率（Hz） | 幅度（V） | 幅度（dBV）
35.714285714285715 | 0.01719940695422143 | -35.28973055132512
71.42857142857143 | 0.030240308309195118 | -30.38827570766292
107.14285714285714 | 0.03903796712707411 | -28.17025611953366
142.85714285714286 | 0.050963395793533275 | -25.85483283588014
178.57142857142858 | 0.0916888393347977 | -20.75367049713328
214.28571428571428 | 0.15374803925031036 | -16.263808281548535
250.0 | 0.1903768383690187 | -14.40771779764428
285.7142857142857 | 0.17329381276069591 | -15.224338859034631
321.42857142857144 | 0.11661032203878792 | -18.66526010542025
357.14285714285717 | 0.059631766175707174 | -24.49044655029653
392.8571428571429 | 0.03329479991708685 | -29.552471812555147
428.57142857142856 | 0.037123024683632946 | -28.60713291743883
464.2857142857143 | 0.06158506784307825 | -24.210491516281003
500.0 | 0.09193140630930922 | -20.730721925327906
535.7142857142858 | 0.10474180578947422 | -19.597598859283792
571.4285714285714 | 0.08885862074987566 | -21.026008641927024
607.1428571428571 | 0.05709870739750609 | -24.867474464324548
642.8571428571429 | 0.03350841202065319 | -29.496923061921173
678.5714285714286 | 0.026091238794990656 | -31.670106007833482
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
