user-lqt/gowin-fpga-instrument-138k/testing/measurements/reports/latency/firmware_2A1C5EA9A07E/K02/medium/trial_001/audio_spectrum.csv

频率（Hz） | 幅度（V） | 幅度（dBV）
14.285714285714285 | 0.006075181445224009 | -44.32881493242745
28.57142857142857 | 0.01410871877106852 | -37.010248464699416
42.857142857142854 | 0.01468131117190027 | -36.66470312642
57.14285714285714 | 0.015559304260214133 | -36.1601965308665
71.42857142857142 | 0.016367302232800095 | -35.72045795966662
85.71428571428571 | 0.01836842746758791 | -34.71856044642809
100.0 | 0.020234169069699718 | -33.87829251025562
114.28571428571428 | 0.023233521063015596 | -32.67769934910247
128.57142857142856 | 0.02584295303988086 | -31.753157231768053
142.85714285714283 | 0.02991896162287449 | -30.48106966620584
157.14285714285714 | 0.03372538962487297 | -29.440860485631234
171.42857142857142 | 0.039747419588566694 | -28.013821211758994
185.7142857142857 | 0.04582642730840983 | -26.777679992666577
200.0 | 0.056296010184144915 | -24.990447668305297
214.28571428571428 | 0.06841983991640893 | -23.29635892558609
228.57142857142856 | 0.09254157081763774 | -20.673262659583415
242.85714285714283 | 0.1316413024326064 | -17.61215659068062
257.1428571428571 | 0.29950550062957554 | -10.471903941544504
271.4285714285714 | 0.47284030635916974 | -6.505710199081321
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
