user-lqt/gowin-fpga-instrument-138k/testing/measurements/reports/latency/firmware_2A1C5EA9A07E/K02/medium/trial_002/audio_spectrum.csv

频率（Hz） | 幅度（V） | 幅度（dBV）
14.285714285714285 | 0.006498923666450355 | -43.743171280766546
28.57142857142857 | 0.006146521558190239 | -44.227411816075126
42.857142857142854 | 0.006394185570080831 | -43.88429527841943
57.14285714285714 | 0.007251540162557217 | -42.791394867028984
71.42857142857142 | 0.007515469955212496 | -42.48087714099837
85.71428571428571 | 0.008533967372477549 | -41.37698043783047
100.0 | 0.009920478694050487 | -40.06934742552773
114.28571428571428 | 0.011225713024007673 | -38.99572128701418
128.57142857142856 | 0.012245507959784937 | -38.240463901179645
142.85714285714283 | 0.014373703255099825 | -36.848626507803004
157.14285714285714 | 0.01715183686247842 | -35.31378725409157
171.42857142857142 | 0.01933055662364318 | -34.27511280551661
185.7142857142857 | 0.022953366089661177 | -32.78307233153748
200.0 | 0.028035999233632453 | -31.045679211199744
214.28571428571428 | 0.036483757826410376 | -28.75800871431599
228.57142857142856 | 0.045610142610796385 | -26.818771396669895
242.85714285714283 | 0.06062811331819169 | -24.346518926657215
257.1428571428571 | 0.2700505372600715 | -11.371099087237141
271.4285714285714 | 0.6049226950733466 | -4.366002432510392
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
