user-lqt/gowin-fpga-instrument-138k/testing/measurements/reports/latency/firmware_2A1C5EA9A07E/K02/medium/trial_003/audio_spectrum.csv

频率（Hz） | 幅度（V） | 幅度（dBV）
14.285714285714285 | 0.009912674461407232 | -40.07618312194134
28.57142857142857 | 0.010421718961795641 | -39.641212849036705
42.857142857142854 | 0.011915381632588326 | -38.477840865304806
57.14285714285714 | 0.013070322590937131 | -37.6742738677694
71.42857142857142 | 0.011679153558284262 | -38.65177262784068
85.71428571428571 | 0.01297619624322748 | -37.73705190213689
100.0 | 0.01806781187578485 | -34.86188880026234
114.28571428571428 | 0.021303972900308304 | -33.43078798025017
128.57142857142856 | 0.01988395343573476 | -34.02994525126339
142.85714285714283 | 0.01758472587874143 | -35.097287946745006
157.14285714285714 | 0.025389126534394336 | -31.907044799239117
171.42857142857142 | 0.037612682075936626 | -28.493313938173493
185.7142857142857 | 0.041994654608570034 | -27.536119726205133
200.0 | 0.03602310073322083 | -28.868378149391614
214.28571428571428 | 0.04350793095288868 | -27.228631387287045
228.57142857142856 | 0.0823163265422913 | -21.69028037375826
242.85714285714283 | 0.12512492122231825 | -18.05312365881965
257.1428571428571 | 0.29608901285359357 | -10.571554158569128
271.4285714285714 | 0.5740474738829706 | -4.821043796889216
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
