user-lqt/gowin-fpga-instrument-138k/testing/measurements/reports/latency/firmware_2A1C5EA9A07E/K03/medium/trial_001/audio_spectrum.csv

频率（Hz） | 幅度（V） | 幅度（dBV）
14.285714285714285 | 0.00622207730806721 | -44.12129194343279
28.57142857142857 | 0.008156622755755225 | -41.769792467433966
42.857142857142854 | 0.00926588143486303 | -40.662265225575844
57.14285714285714 | 0.009680638175582902 | -40.28192023606668
71.42857142857142 | 0.010256524330784273 | -39.77999570785921
85.71428571428571 | 0.012067108880959422 | -38.36793537261147
100.0 | 0.013470894127709857 | -37.41207154234345
114.28571428571428 | 0.014675396369296233 | -36.66820320034844
128.57142857142856 | 0.016609477580944505 | -35.592880544567656
142.85714285714283 | 0.019813827242249667 | -34.06063255924522
157.14285714285714 | 0.022417706108280908 | -32.9881765729862
171.42857142857142 | 0.025767946028608907 | -31.77840395648841
185.7142857142857 | 0.03044122605261585 | -30.330757197580812
200.0 | 0.035372597519572425 | -29.026660948462442
214.28571428571428 | 0.04217410554691085 | -27.499082388249278
228.57142857142856 | 0.05494676783194495 | -25.201156985296006
242.85714285714283 | 0.07185649831609449 | -22.870679009827924
257.1428571428571 | 0.10192878374727486 | -19.83406315845565
271.4285714285714 | 0.27614624123795734 | -11.177217275909006
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
