user-lqt/gowin-fpga-instrument-138k/testing/measurements/reports/latency/firmware_2A1C5EA9A07E/K03/medium/trial_002/audio_spectrum.csv

频率（Hz） | 幅度（V） | 幅度（dBV）
14.285714285714285 | 0.00875486611459376 | -41.155009821165784
28.57142857142857 | 0.0038357018901243644 | -48.323103069156524
42.857142857142854 | 0.0030925405577227824 | -50.19369192044603
57.14285714285714 | 0.003959096890140369 | -48.04807739441579
71.42857142857142 | 0.003725133427080851 | -48.577163340959835
85.71428571428571 | 0.005000827007500232 | -46.01916337290394
100.0 | 0.005460999177110795 | -45.254557778119995
114.28571428571428 | 0.005953166499586571 | -44.50503941652586
128.57142857142856 | 0.007219353299085138 | -42.83003408522184
142.85714285714283 | 0.008280273090668647 | -41.63910679132019
157.14285714285714 | 0.009154429462334685 | -40.76737434692003
171.42857142857142 | 0.010804412937688062 | -39.32797651425266
185.7142857142857 | 0.012383784129992888 | -38.142932541443955
200.0 | 0.014519100847653265 | -36.76120556389461
214.28571428571428 | 0.01680716333688816 | -35.490111586169334
228.57142857142856 | 0.022190442504495284 | -33.07668074639689
242.85714285714283 | 0.030666135039790352 | -30.266819124408286
257.1428571428571 | 0.049477346232647185 | -26.111872044813566
271.4285714285714 | 0.08713658841218454 | -21.19598895290477
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
