user-lqt/gowin-fpga-instrument-138k/testing/measurements/reports/latency/firmware_2A1C5EA9A07E/K03/medium/trial_003/audio_spectrum.csv

频率（Hz） | 幅度（V） | 幅度（dBV）
14.285714285714285 | 0.010785985078530801 | -39.34280369711922
28.57142857142857 | 0.004000382242198505 | -47.95797018470941
42.857142857142854 | 0.0036861207235049744 | -48.66860890760488
57.14285714285714 | 0.003733836124024151 | -48.55689493820384
71.42857142857142 | 0.005219475676732133 | -45.647462438571395
85.71428571428571 | 0.005203012536949766 | -45.67490255291708
100.0 | 0.005363379326202518 | -45.41122972752646
114.28571428571428 | 0.007141774341144535 | -42.92387752684121
128.57142857142856 | 0.007521607399531424 | -42.473786778194935
142.85714285714283 | 0.008590107995232294 | -41.32002752328521
157.14285714285714 | 0.009552968641121623 | -40.3972329576154
171.42857142857142 | 0.011620386259651411 | -38.69558871662949
185.7142857142857 | 0.013545638212017617 | -37.3640105613385
200.0 | 0.01597773960836178 | -35.929693217651575
214.28571428571428 | 0.01913660426145739 | -34.36270248201793
228.57142857142856 | 0.022681039663352612 | -32.886740838873244
242.85714285714283 | 0.03108490711963936 | -30.14900851894103
257.1428571428571 | 0.04817495176009304 | -26.34357423104682
271.4285714285714 | 0.282239918709458 | -10.987631232668921
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
