user-lqt/gowin-fpga-instrument-138k/testing/measurements/reports/latency/firmware_2A1C5EA9A07E/K04/medium/trial_001/audio_spectrum.csv

频率（Hz） | 幅度（V） | 幅度（dBV）
35.714285714285715 | 0.017718824726421088 | -35.03130175705763
71.42857142857143 | 0.02356662662495354 | -32.5540515765117
107.14285714285714 | 0.0321451275376367 | -29.85769693621625
142.85714285714286 | 0.045723500005980584 | -26.797210659539772
178.57142857142858 | 0.06097194626001124 | -24.297398836483808
214.28571428571428 | 0.09542209301628439 | -20.40702123459157
250.0 | 0.22714068789146338 | -12.874101265937256
285.7142857142857 | 0.6123707232012875 | -4.259711612776095
321.42857142857144 | 0.7245887895063796 | -2.7981677889493555
357.14285714285717 | 0.4047174075412263 | -7.856962310166593
392.8571428571429 | 0.1154197436363826 | -18.75439789311826
428.57142857142856 | 0.0860741237502359 | -21.302547795904484
464.2857142857143 | 0.059479509741947184 | -24.512652395888193
500.0 | 0.05197363231252213 | -25.684338606332876
535.7142857142858 | 0.05151832720015908 | -25.760764939181747
571.4285714285714 | 0.11059739712222105 | -19.125101878123402
607.1428571428571 | 0.2027419045024824 | -13.861129563553673
642.8571428571429 | 0.206463630624795 | -13.703128798801218
678.5714285714286 | 0.1070459204565987 | -19.40859758223398
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
