user-lqt/gowin-fpga-instrument-138k/testing/measurements/reports/latency/firmware_2A1C5EA9A07E/K04/medium/trial_002/audio_spectrum.csv

频率（Hz） | 幅度（V） | 幅度（dBV）
35.714285714285715 | 0.01976257141276314 | -34.083130954363135
71.42857142857143 | 0.023341026978532107 | -32.637600788180244
107.14285714285714 | 0.03199055225958669 | -29.899565250696206
142.85714285714286 | 0.04640610828856948 | -26.66849701759963
178.57142857142858 | 0.06198069508507152 | -24.154871153119508
214.28571428571428 | 0.09276749818027015 | -20.65208311212823
250.0 | 0.21801815205117964 | -13.230146916213158
285.7142857142857 | 0.5581824738748915 | -5.064476077080954
321.42857142857144 | 0.6657394778191071 | -3.533913779378981
357.14285714285717 | 0.39643563578936747 | -8.03654626985694
392.8571428571429 | 0.12398760309913688 | -18.132434712042958
428.57142857142856 | 0.08772828842698185 | -21.137206872299444
464.2857142857143 | 0.05923979609687154 | -24.54772889976065
500.0 | 0.05225882579043976 | -25.636807054233437
535.7142857142858 | 0.0489103457680041 | -26.211985339114978
571.4285714285714 | 0.09904442668444002 | -20.08339915128062
607.1428571428571 | 0.17708456928406116 | -15.0363856103883
642.8571428571429 | 0.1876221359142907 | -14.53431848563175
678.5714285714286 | 0.10745980967214955 | -19.375078659379326
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
