user-lqt/gowin-fpga-instrument-138k/testing/measurements/reports/latency/firmware_2A1C5EA9A07E/K04/medium/trial_003/audio_spectrum.csv

频率（Hz） | 幅度（V） | 幅度（dBV）
14.285714285714285 | 0.005822199381445082 | -44.698258524221266
28.57142857142857 | 0.002910478322606804 | -50.72071262029671
42.857142857142854 | 0.0032506661779441114 | -49.76055254806979
57.14285714285714 | 0.0033825019754053108 | -49.41523882198372
71.42857142857142 | 0.004348140972998419 | -47.233927678086445
85.71428571428571 | 0.004531150130625957 | -46.87583096201216
100.0 | 0.004318421599197429 | -47.29349921193495
114.28571428571428 | 0.0055471016075216645 | -45.11867757955028
128.57142857142856 | 0.007157305230093624 | -42.90500922979196
142.85714285714283 | 0.007303371201063984 | -42.72953250702078
157.14285714285714 | 0.00833098228874066 | -41.586075776356914
171.42857142857142 | 0.00963406104738815 | -40.3238121210715
185.7142857142857 | 0.01109846401520527 | -39.09474243485866
200.0 | 0.012937397707333617 | -37.76306142079742
214.28571428571428 | 0.014683454137371496 | -36.663435378394894
228.57142857142856 | 0.017766597966533015 | -35.00791450051843
242.85714285714283 | 0.023666945160593873 | -32.517155910718046
257.1428571428571 | 0.030955714596367444 | -30.185183321519627
271.4285714285714 | 0.0404674041312726 | -27.857893069382463
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
