user-lqt/gowin-fpga-instrument-138k/testing/measurements/reports/latency/firmware_2A1C5EA9A07E/K05/medium/trial_001/audio_spectrum.csv

频率（Hz） | 幅度（V） | 幅度（dBV）
14.285714285714285 | 0.00198910671743415 | -54.02683831891423
28.57142857142857 | 0.005529029571149864 | -45.147021745978876
42.857142857142854 | 0.005679197384835313 | -44.914260736367495
57.14285714285714 | 0.00617277566305307 | -44.19039012587256
71.42857142857142 | 0.0073277311130001055 | -42.70060950482487
85.71428571428571 | 0.008607146329085553 | -41.30281627164021
100.0 | 0.009498852740784358 | -40.446576901453255
114.28571428571428 | 0.010460565283766089 | -39.60889691551856
128.57142857142856 | 0.01183873351565263 | -38.53389510189516
142.85714285714283 | 0.013489958632077982 | -37.39978764242227
157.14285714285714 | 0.014975809788513046 | -36.49219369306463
171.42857142857142 | 0.01687528845876839 | -35.4549758958876
185.7142857142857 | 0.018955968724734353 | -34.44508033020447
200.0 | 0.021871055866411394 | -33.202605001444724
214.28571428571428 | 0.025003284490807475 | -32.04005875252771
228.57142857142856 | 0.029407019138305186 | -30.630979916112075
242.85714285714283 | 0.03470653494046869 | -29.191774872266343
257.1428571428571 | 0.04203180595765233 | -27.528438989996875
271.4285714285714 | 0.054284023813909475 | -25.306559353109733
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
