user-lqt/gowin-fpga-instrument-138k/testing/measurements/reports/latency/firmware_2A1C5EA9A07E/K05/medium/trial_002/audio_spectrum.csv

频率（Hz） | 幅度（V） | 幅度（dBV）
14.285714285714285 | 0.00788791816190763 | -42.06075207801109
28.57142857142857 | 0.005942643982097764 | -44.52040574227573
42.857142857142854 | 0.006359599928270194 | -43.93140408454629
57.14285714285714 | 0.007231878985772229 | -42.81497699426855
71.42857142857142 | 0.00833233067247673 | -41.58467006401459
85.71428571428571 | 0.009371644691447403 | -40.56368370467881
100.0 | 0.010468454064787707 | -39.6023489656661
114.28571428571428 | 0.011722581704152281 | -38.619534632581875
128.57142857142856 | 0.01326819469608284 | -37.54376328629192
142.85714285714283 | 0.0150218537114916 | -36.465529433191726
157.14285714285714 | 0.016986038772616417 | -35.398157778445366
171.42857142857142 | 0.019139136344924756 | -34.36155327381265
185.7142857142857 | 0.02140211283754404 | -33.39086701115434
200.0 | 0.02492250813234955 | -32.06816507233843
214.28571428571428 | 0.02907680375699908 | -30.729066692840995
228.57142857142856 | 0.033458838623990156 | -29.509782754589065
242.85714285714283 | 0.04051011661978604 | -27.848730131511324
257.1428571428571 | 0.05025314354195051 | -25.97673532283736
271.4285714285714 | 0.06081757062890094 | -24.319418636660778
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
