user-lqt/gowin-fpga-instrument-138k/testing/measurements/reports/latency/firmware_2A1C5EA9A07E/K05/medium/trial_003/audio_spectrum.csv

频率（Hz） | 幅度（V） | 幅度（dBV）
14.285714285714285 | 0.008228910323439306 | -41.69315340960481
28.57142857142857 | 0.005329171072313878 | -45.4668067639961
42.857142857142854 | 0.0058321373056552375 | -44.68344520002093
57.14285714285714 | 0.007057835140495539 | -43.02656980535061
71.42857142857142 | 0.007755819821666442 | -42.20744577465403
85.71428571428571 | 0.00828711928778756 | -41.63192819439416
100.0 | 0.009326589108825376 | -40.605543120903704
114.28571428571428 | 0.010703230479701498 | -39.409702450480275
128.57142857142856 | 0.012067221398101553 | -38.36785438329313
142.85714285714283 | 0.01350796173093475 | -37.38820356847224
157.14285714285714 | 0.015204704456760258 | -36.36044034176247
171.42857142857142 | 0.016761268480383087 | -35.51386234754608
185.7142857142857 | 0.019009753140641038 | -34.42047045632976
200.0 | 0.021833699201252176 | -33.21745354363824
214.28571428571428 | 0.02493964680157075 | -32.06219402694504
228.57142857142856 | 0.02962919438409643 | -30.56560313597302
242.85714285714283 | 0.034572851136776904 | -29.22529607596646
257.1428571428571 | 0.04317564257955835 | -27.295223802862797
271.4285714285714 | 0.05371687313783149 | -25.39778551146954
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
