user-lqt/gowin-fpga-instrument-138k/testing/measurements/reports/latency/firmware_2A1C5EA9A07E/K06/medium/trial_001/audio_spectrum.csv

频率（Hz） | 幅度（V） | 幅度（dBV）
14.285714285714285 | 0.006680161517473878 | -43.504260734621994
28.57142857142857 | 0.0028709548186610537 | -50.83947284223699
42.857142857142854 | 0.0035304881962219285 | -49.04330472360073
57.14285714285714 | 0.003302002133322067 | -49.62445300977642
71.42857142857142 | 0.004018201060248937 | -47.91936672173055
85.71428571428571 | 0.004911196595780132 | -46.17625361321985
100.0 | 0.005630403132646683 | -44.98921017751644
114.28571428571428 | 0.006154284732932178 | -44.216448292805815
128.57142857142856 | 0.007275728787856657 | -42.762469963838385
142.85714285714283 | 0.007941622191330763 | -42.00181555149438
157.14285714285714 | 0.009253989290810545 | -40.67342014847212
171.42857142857142 | 0.010403616975623144 | -39.656312907369106
185.7142857142857 | 0.011915559334066995 | -38.47771132820978
200.0 | 0.0135816070298389 | -37.34097679124425
214.28571428571428 | 0.015598877700990218 | -36.13813293778315
228.57142857142856 | 0.01800285132592658 | -34.89317410121445
242.85714285714283 | 0.02082513965624964 | -33.62824154945811
257.1428571428571 | 0.024830628563235323 | -32.10024573126919
271.4285714285714 | 0.03045355580594182 | -30.327239823025923
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
