user-lqt/gowin-fpga-instrument-138k/testing/measurements/reports/latency/firmware_2A1C5EA9A07E/K06/medium/trial_002/audio_spectrum.csv

频率（Hz） | 幅度（V） | 幅度（dBV）
14.285714285714285 | 0.004699641432371971 | -46.55870552163761
28.57142857142857 | 0.003467982513098709 | -49.198462021401454
42.857142857142854 | 0.003944345174929197 | -48.08050172751945
57.14285714285714 | 0.004830725340182705 | -46.31975308853921
71.42857142857142 | 0.005665755214057559 | -44.93484385745012
85.71428571428571 | 0.006901003060508277 | -43.22175559979609
100.0 | 0.007346894851556896 | -42.6779235143018
114.28571428571428 | 0.008687933284369391 | -41.22167045478569
128.57142857142856 | 0.009747951818145556 | -40.221732521968725
142.85714285714283 | 0.011086421796634018 | -39.10417204316654
157.14285714285714 | 0.01232047488712266 | -38.18745104329856
171.42857142857142 | 0.014111226223923476 | -37.00870491393544
185.7142857142857 | 0.015860472325982058 | -35.99367767011198
200.0 | 0.01784222717282032 | -34.97101870716347
214.28571428571428 | 0.020731359592165113 | -33.66744430639793
228.57142857142856 | 0.023514311636566837 | -32.57335460739169
242.85714285714283 | 0.02759064901703543 | -31.184761669139043
257.1428571428571 | 0.032945214297442814 | -29.644153263379607
271.4285714285714 | 0.03925851267327038 | -28.121323157393267
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
