user-lqt/gowin-fpga-instrument-138k/testing/measurements/reports/latency/firmware_2A1C5EA9A07E/K06/medium/trial_003/audio_spectrum.csv

频率（Hz） | 幅度（V） | 幅度（dBV）
14.285714285714285 | 0.004654771960849487 | -46.64203180845662
28.57142857142857 | 0.003573722726728025 | -48.9375829197821
42.857142857142854 | 0.004065281647510571 | -47.81818721186607
57.14285714285714 | 0.004981452718502955 | -46.052879748716165
71.42857142857142 | 0.006197240347820332 | -44.15603320526861
85.71428571428571 | 0.006795902391970319 | -43.355057348658725
100.0 | 0.00797126476697125 | -41.969455309246825
114.28571428571428 | 0.008803758203421053 | -41.10663787839841
128.57142857142856 | 0.010061618907608181 | -39.94664271944845
142.85714285714283 | 0.011452363247432273 | -38.822097708549286
157.14285714285714 | 0.012805221012317633 | -37.852258428094316
171.42857142857142 | 0.014578260088192239 | -36.72588611732616
185.7142857142857 | 0.016550101248816396 | -35.62398689979817
200.0 | 0.018753661282490817 | -34.53827864453113
214.28571428571428 | 0.0213750822884157 | -33.40184409355268
228.57142857142856 | 0.0241250997280751 | -32.35061765397298
242.85714285714283 | 0.02834037053355115 | -30.951889518168734
257.1428571428571 | 0.0341260700798811 | -29.33827443418783
271.4285714285714 | 0.04034469110469631 | -27.88427210638492
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
