user-lqt/gowin-fpga-instrument-138k/testing/measurements/reports/latency/firmware_2A1C5EA9A07E/K07/medium/trial_001/audio_spectrum.csv

频率（Hz） | 幅度（V） | 幅度（dBV）
14.285714285714285 | 0.002874021129927226 | -50.83020086476611
28.57142857142857 | 0.00394330526011207 | -48.08279203829356
42.857142857142854 | 0.004316776930968357 | -47.29680785778757
57.14285714285714 | 0.004544967428634776 | -46.8493844957704
71.42857142857142 | 0.005488555699697238 | -45.21083848139652
85.71428571428571 | 0.006493131322449515 | -43.75091627016406
100.0 | 0.007383580043907049 | -42.63466025318693
114.28571428571428 | 0.008662368999609302 | -41.24726640270114
128.57142857142856 | 0.010474226437111302 | -39.59756083071674
142.85714285714283 | 0.01152950266749634 | -38.763788517454415
157.14285714285714 | 0.012754681889302186 | -37.88660737055228
171.42857142857142 | 0.01436528495181379 | -36.85371509720268
185.7142857142857 | 0.016108932608504066 | -35.858664706940765
200.0 | 0.018325967896906756 | -34.73866157118839
214.28571428571428 | 0.020554679291095 | -33.74178590011906
228.57142857142856 | 0.02336649082145806 | -32.62813010073008
242.85714285714283 | 0.02650122806519519 | -31.53468000837329
257.1428571428571 | 0.030411393029196092 | -30.339273720736717
271.4285714285714 | 0.03606153940487264 | -28.859114758721773
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
