user-lqt/gowin-fpga-instrument-138k/testing/measurements/reports/latency/firmware_2A1C5EA9A07E/K07/medium/trial_002/audio_spectrum.csv

频率（Hz） | 幅度（V） | 幅度（dBV）
14.285714285714285 | 0.0011869959970131228 | -58.51101491287183
28.57142857142857 | 0.003589204664498621 | -48.9000355303085
42.857142857142854 | 0.003842792083318916 | -48.30706225351832
57.14285714285714 | 0.004021225729510571 | -47.91283094615231
71.42857142857142 | 0.0045316020112281825 | -46.87496478251561
85.71428571428571 | 0.005245043782212921 | -45.60501764495044
100.0 | 0.006228557939342765 | -44.11224982598104
114.28571428571428 | 0.007369784821675396 | -42.65090384423891
128.57142857142856 | 0.007764719273019627 | -42.197484824162146
142.85714285714283 | 0.008783229896235024 | -41.126914993574964
157.14285714285714 | 0.010210462616635276 | -39.81909160821204
171.42857142857142 | 0.011479232917398247 | -38.80174264097631
185.7142857142857 | 0.012954968167367938 | -37.751272996293245
200.0 | 0.014391000564788788 | -36.83818019540263
214.28571428571428 | 0.016169467603328918 | -35.826085589185425
228.57142857142856 | 0.018524534626399535 | -34.645053871264594
242.85714285714283 | 0.02101085006645554 | -33.55112752712837
257.1428571428571 | 0.02428017957698074 | -32.29496211058189
271.4285714285714 | 0.02821778752693118 | -30.9895408197932
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
