user-lqt/gowin-fpga-instrument-138k/testing/measurements/reports/latency/firmware_2A1C5EA9A07E/K07/medium/trial_003/audio_spectrum.csv

频率（Hz） | 幅度（V） | 幅度（dBV）
14.285714285714285 | 0.005071083770593437 | -45.89798430331594
28.57142857142857 | 0.0032233429958053233 | -49.83386957538899
42.857142857142854 | 0.003076875318292426 | -50.2378020391372
57.14285714285714 | 0.003945379609807911 | -48.07822408476487
71.42857142857142 | 0.004781192702344346 | -46.409275040837386
85.71428571428571 | 0.005923293764378296 | -44.54873456181978
100.0 | 0.006188503026777649 | -44.168287846205786
114.28571428571428 | 0.007805026222166365 | -42.152512670421984
128.57142857142856 | 0.008969852094907664 | -40.94429436073472
142.85714285714283 | 0.00995355962114363 | -40.04043155622422
157.14285714285714 | 0.01128304012567752 | -38.951477347627005
171.42857142857142 | 0.012773330382823014 | -37.87391709261567
185.7142857142857 | 0.014551903610658844 | -36.74160381256053
200.0 | 0.016351291491511332 | -35.72895878608538
214.28571428571428 | 0.01842482224335238 | -34.691933867591054
228.57142857142856 | 0.020745706129603848 | -33.66143556669167
242.85714285714283 | 0.024074865060951425 | -32.36872276813786
257.1428571428571 | 0.027712422945126575 | -31.146510028782565
271.4285714285714 | 0.03187738034493828 | -29.93034751495651
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
