user-lqt/gowin-fpga-instrument-138k/testing/measurements/reports/latency/firmware_2A1C5EA9A07E/K08/medium/trial_001/audio_spectrum.csv

频率（Hz） | 幅度（V） | 幅度（dBV）
14.285714285714285 | 0.004990225427828207 | -46.0375967033618
28.57142857142857 | 0.0026265255615762276 | -51.61236736496932
42.857142857142854 | 0.0029190923282268245 | -50.69504336913111
57.14285714285714 | 0.0031241648028462964 | -50.10532129436503
71.42857142857142 | 0.003789492588623468 | -48.42837875954977
85.71428571428571 | 0.004690498607925164 | -46.57561977187872
100.0 | 0.005405081409898506 | -45.3439552086688
114.28571428571428 | 0.005851728045890454 | -44.654317310926174
128.57142857142856 | 0.0064587726367916045 | -43.797000066451616
142.85714285714283 | 0.0074354468966055035 | -42.57385847452299
157.14285714285714 | 0.008077363140655604 | -41.85460783491352
171.42857142857142 | 0.009050045296030922 | -40.866984942377584
185.7142857142857 | 0.01045784611995088 | -39.611155056109055
200.0 | 0.011675668051826085 | -38.6543652166567
214.28571428571428 | 0.013028961872688321 | -37.70180373628419
228.57142857142856 | 0.01450406815410321 | -36.77020336346689
242.85714285714283 | 0.016339623871381933 | -35.73515889788775
257.1428571428571 | 0.018544162414401297 | -34.635855554087826
271.4285714285714 | 0.021122179599357655 | -33.50522537888869
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
