user-lqt/gowin-fpga-instrument-138k/testing/measurements/reports/latency/firmware_2A1C5EA9A07E/K08/medium/trial_002/audio_spectrum.csv

频率（Hz） | 幅度（V） | 幅度（dBV）
14.285714285714285 | 0.0024603896778616838 | -52.179922073033396
28.57142857142857 | 0.0028920330331819893 | -50.77593501560874
42.857142857142854 | 0.0027109921281308555 | -51.337434869447435
57.14285714285714 | 0.0026600589154648652 | -51.50217488859717
71.42857142857142 | 0.003830082724190618 | -48.335836916076516
85.71428571428571 | 0.005237826343044581 | -45.61697808884457
100.0 | 0.006085822601740325 | -44.31361422459859
114.28571428571428 | 0.006985384691439833 | -43.11619343804211
128.57142857142856 | 0.007833885544181237 | -42.12045555873378
142.85714285714283 | 0.008421661175511881 | -41.49204470634543
157.14285714285714 | 0.009388209658624703 | -40.54834440497322
171.42857142857142 | 0.010601772952778164 | -39.492430016927614
185.7142857142857 | 0.012148578956093602 | -38.30949038801365
200.0 | 0.013794615399249506 | -37.20580806725096
214.28571428571428 | 0.015231388643254191 | -36.34521000601659
228.57142857142856 | 0.01726030419880222 | -35.25903108933737
242.85714285714283 | 0.019577378027898003 | -34.16490946236857
257.1428571428571 | 0.022691148236698835 | -32.88287054043713
271.4285714285714 | 0.02566443916437771 | -31.813364435566648
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
