user-lqt/gowin-fpga-instrument-138k/testing/measurements/reports/latency/firmware_2A1C5EA9A07E/K08/medium/trial_003/audio_spectrum.csv

频率（Hz） | 幅度（V） | 幅度（dBV）
14.285714285714285 | 0.0044949236598127995 | -46.94555359542744
28.57142857142857 | 0.0013477563398854341 | -57.40777233121028
42.857142857142854 | 0.0013532502398957268 | -57.37243774495777
57.14285714285714 | 0.002088327376064482 | -53.60402836556494
71.42857142857142 | 0.002231743298067814 | -53.02711521479693
85.71428571428571 | 0.0029644341095855574 | -50.561163965320624
100.0 | 0.0038268416167599735 | -48.343190234948565
114.28571428571428 | 0.003988967898265128 | -47.982789174341754
128.57142857142856 | 0.004698805772055811 | -46.560250128558806
142.85714285714283 | 0.0053872281817196 | -45.37269258129192
157.14285714285714 | 0.006395803314472057 | -43.8820980053105
171.42857142857142 | 0.007097077035791191 | -42.97840961322571
185.7142857142857 | 0.007940734090626718 | -42.002786936920316
200.0 | 0.00871599287416595 | -41.19366266973563
214.28571428571428 | 0.009704412565237496 | -40.26061497037012
228.57142857142856 | 0.011243216477591966 | -38.982188546448036
242.85714285714283 | 0.012607945782294102 | -37.98711334877365
257.1428571428571 | 0.014235164365655254 | -36.932750278545676
271.4285714285714 | 0.016331917453765242 | -35.73925647586846
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
