user-lqt/gowin-fpga-instrument-138k/testing/measurements/reports/latency/firmware_2A1C5EA9A07E/K09/medium/trial_001/audio_spectrum.csv

频率（Hz） | 幅度（V） | 幅度（dBV）
14.285714285714285 | 0.003374385610115003 | -49.436105792519555
28.57142857142857 | 0.0003725926120469587 | -68.57531521526083
42.857142857142854 | 0.0007302983917230382 | -62.72999311538075
57.14285714285714 | 0.0012048521634792026 | -58.381324763425866
71.42857142857142 | 0.0014751736621205036 | -56.6231370030573
85.71428571428571 | 0.0013661639084002024 | -57.28994384261654
100.0 | 0.002049766572597458 | -53.765911871616545
114.28571428571428 | 0.002465871121532628 | -52.160592509954604
128.57142857142856 | 0.0025218454325240947 | -51.965630709414214
142.85714285714283 | 0.0028393477703284186 | -50.935628215106874
157.14285714285714 | 0.0033861694454533535 | -49.405826267813225
171.42857142857142 | 0.004136793455504003 | -47.66672324597262
185.7142857142857 | 0.004159153520235895 | -47.61990097831904
200.0 | 0.004782076906671119 | -46.40766887442449
214.28571428571428 | 0.005324303038378891 | -45.47474468321703
228.57142857142856 | 0.005931092135902631 | -44.537306588281886
242.85714285714283 | 0.0066968395270182645 | -43.48260215436723
257.1428571428571 | 0.007449320255512396 | -42.55766708932533
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
