user-lqt/gowin-fpga-instrument-138k/testing/measurements/reports/latency/firmware_2A1C5EA9A07E/K09/medium/trial_002/audio_spectrum.csv

频率（Hz） | 幅度（V） | 幅度（dBV）
14.285714285714285 | 0.0011763203600929071 | -58.58948772041231
28.57142857142857 | 0.0006249578467925397 | -64.0829854938474
42.857142857142854 | 0.0005956365796972664 | -64.50037277740161
57.14285714285714 | 0.0009371695787367904 | -60.56363634774936
71.42857142857142 | 0.0012149778724493872 | -58.30863262996586
85.71428571428571 | 0.001550372530254145 | -56.191278702470065
100.0 | 0.0019153048779336876 | -54.3552417052863
114.28571428571428 | 0.002301024915975973 | -52.761573573499874
128.57142857142856 | 0.0027242863251208953 | -51.29494499182834
142.85714285714283 | 0.0028216521320867595 | -50.98993058716534
157.14285714285714 | 0.003294312666798321 | -49.64470367696816
171.42857142857142 | 0.0036268847147745936 | -48.809324976248845
185.7142857142857 | 0.0041469085079566485 | -47.645510924877286
200.0 | 0.004602280047434214 | -46.74053916334789
214.28571428571428 | 0.005145422683632119 | -45.7715788645657
228.57142857142856 | 0.005606002445767137 | -45.02693434206428
242.85714285714283 | 0.006175897531327992 | -44.1859983659723
257.1428571428571 | 0.0070268111932219575 | -43.064834311476936
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
