user-lqt/gowin-fpga-instrument-138k/testing/measurements/reports/latency/firmware_2A1C5EA9A07E/K09/medium/trial_003/audio_spectrum.csv

频率（Hz） | 幅度（V） | 幅度（dBV）
14.285714285714285 | 0.002913042427908806 | -50.71306379819512
28.57142857142857 | 0.0006250798867954673 | -64.08128950344367
42.857142857142854 | 0.000401863073970501 | -67.91843796063871
57.14285714285714 | 0.0016663076566183006 | -55.564896202208836
71.42857142857142 | 0.002037359194614282 | -53.81864792773632
85.71428571428571 | 0.0015904916767040457 | -55.96937198565562
100.0 | 0.0016402293442511413 | -55.701908453937065
114.28571428571428 | 0.002354658207740792 | -52.561442486327714
128.57142857142856 | 0.002526397293650592 | -51.94996705128531
142.85714285714283 | 0.0030927969332472716 | -50.1929718790526
157.14285714285714 | 0.0036527977137998787 | -48.747487553369
171.42857142857142 | 0.0039506883059079335 | -48.0665446625799
185.7142857142857 | 0.004534094210789682 | -46.870189204256114
200.0 | 0.0050821601631633965 | -45.8790330474918
214.28571428571428 | 0.005339180468848122 | -45.450507987410916
228.57142857142856 | 0.005943559766271486 | -44.51906731657659
242.85714285714283 | 0.00676162320481433 | -43.3989806839141
257.1428571428571 | 0.007840624682107632 | -42.11298669226892
271.4285714285714 | 0.008462245393932536 | -41.45028769712229
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
