user-lqt/gowin-fpga-instrument-138k/testing/measurements/reports/latency/firmware_2A1C5EA9A07E/K10/medium/trial_001/audio_spectrum.csv

频率（Hz） | 幅度（V） | 幅度（dBV）
14.285714285714285 | 0.0009118006517475155 | -60.802002034077304
28.57142857142857 | 0.00014042929780486328 | -77.0508455154065
42.857142857142854 | 0.0011019562152136439 | -59.15671322527231
57.14285714285714 | 0.0019038909838735014 | -54.407158455770734
71.42857142857142 | 0.0016468572135318754 | -55.666881071412284
85.71428571428571 | 0.002699046783889102 | -51.37579175082011
100.0 | 0.0025924226924025646 | -51.72588371334794
114.28571428571428 | 0.00338158098665427 | -49.41760414090241
128.57142857142856 | 0.003873633655921942 | -48.23762909068995
142.85714285714283 | 0.004130031016540066 | -47.68093373558085
157.14285714285714 | 0.004558602349493838 | -46.82336579997304
171.42857142857142 | 0.005218848756027395 | -45.64850577921382
185.7142857142857 | 0.00567701715157944 | -44.91759587337423
200.0 | 0.0065541438330595355 | -43.66968064198819
214.28571428571428 | 0.007085562452376072 | -42.992513394518355
228.57142857142856 | 0.007908276006494757 | -42.03836363591323
242.85714285714283 | 0.008908728414193727 | -41.003685609743286
257.1428571428571 | 0.009880330090885936 | -40.104570917446694
271.4285714285714 | 0.010815856932341925 | -39.3187813206253
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
