user-lqt/gowin-fpga-instrument-138k/testing/measurements/reports/latency/firmware_2A1C5EA9A07E/K10/medium/trial_002/audio_spectrum.csv

频率（Hz） | 幅度（V） | 幅度（dBV）
14.285714285714285 | 0.002174315759971599 | -53.25354772518408
28.57142857142857 | 0.0009707682459865101 | -60.257688759253256
42.857142857142854 | 0.0013120621016006414 | -57.64091217505786
57.14285714285714 | 0.0011630919188782818 | -58.68771923450841
71.42857142857142 | 0.0023377017550211014 | -52.624217942275195
85.71428571428571 | 0.0026646183987863127 | -51.487299553894644
100.0 | 0.0019377347897197197 | -54.254113268542916
114.28571428571428 | 0.0034060644904256726 | -49.354942667275445
128.57142857142856 | 0.004271663286276665 | -47.388059757582866
142.85714285714283 | 0.0044875087966546184 | -46.95989374171064
157.14285714285714 | 0.005476435057315706 | -45.23004116150475
171.42857142857142 | 0.0058108150741959345 | -44.71525891020302
185.7142857142857 | 0.006130085140821177 | -44.250669870375454
200.0 | 0.007160617951013217 | -42.90098994173477
214.28571428571428 | 0.008009712967993342 | -41.927660935868694
228.57142857142856 | 0.008462000284674882 | -41.450539287887615
242.85714285714283 | 0.009342156896781688 | -40.591056864633465
257.1428571428571 | 0.01023852434766258 | -39.79525265206399
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
