user-lqt/gowin-fpga-instrument-138k/testing/measurements/reports/latency/firmware_2A1C5EA9A07E/K10/medium/trial_003/audio_spectrum.csv

频率（Hz） | 幅度（V） | 幅度（dBV）
14.285714285714285 | 0.0016898240437016904 | -55.443170296221226
28.57142857142857 | 0.0005731598186830002 | -64.8344852676543
42.857142857142854 | 0.0015473151737271818 | -56.20842431076767
57.14285714285714 | 0.0013716116496712515 | -57.25537669793606
71.42857142857142 | 0.0018063554238894066 | -54.863935850695256
85.71428571428571 | 0.0027545354128488374 | -51.19903279759046
100.0 | 0.0026902281152890073 | -51.404217857119896
114.28571428571428 | 0.0035816838489920832 | -48.918255029135494
128.57142857142856 | 0.004016683824456755 | -47.9226470531831
142.85714285714283 | 0.0049130207307534835 | -46.17302806665081
157.14285714285714 | 0.005404453325942188 | -45.34496458938083
171.42857142857142 | 0.005732022430014513 | -44.833842376615735
185.7142857142857 | 0.0064721507722314275 | -43.77902748309047
200.0 | 0.007303822745129829 | -42.72899550286538
214.28571428571428 | 0.007943697325997803 | -41.99954623726562
228.57142857142856 | 0.008836687281227044 | -41.07421027693385
242.85714285714283 | 0.009950423496968399 | -40.04316869969355
257.1428571428571 | 0.010977622937780034 | -39.189833811138726
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
