user-lqt/gowin-fpga-instrument-138k/testing/measurements/reports/latency/firmware_2A1C5EA9A07E/K11/medium/trial_001/audio_spectrum.csv

频率（Hz） | 幅度（V） | 幅度（dBV）
14.285714285714285 | 0.001825448354728791 | -54.772608990506185
28.57142857142857 | 0.00027638476349834415 | -71.16971804730146
42.857142857142854 | 0.0012499379407062668 | -58.062230982685115
57.14285714285714 | 0.0011976408299262673 | -58.433468129228466
71.42857142857142 | 0.0007641765945074312 | -62.336125363623076
85.71428571428571 | 0.0017754800970864284 | -55.01368383445638
100.0 | 0.00238772839343428 | -52.440301523561615
114.28571428571428 | 0.001598405605086587 | -55.926260123729385
128.57142857142856 | 0.0024502945638841768 | -52.21563406960966
142.85714285714283 | 0.00270228215815024 | -51.36538612382253
157.14285714285714 | 0.003046992048828892 | -50.32257358147526
171.42857142857142 | 0.0030651876891786404 | -50.270858547681684
185.7142857142857 | 0.003760836892383075 | -48.494310030696184
200.0 | 0.003769864662422704 | -48.473484812425426
214.28571428571428 | 0.004396130452598455 | -47.13858857245478
228.57142857142856 | 0.004608811560633737 | -46.728220968123466
242.85714285714283 | 0.005094388148698105 | -45.85815937191703
257.1428571428571 | 0.005944352498201822 | -44.51790889919994
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
