user-lqt/gowin-fpga-instrument-138k/testing/measurements/reports/latency/firmware_2A1C5EA9A07E/K11/medium/trial_002/audio_spectrum.csv

频率（Hz） | 幅度（V） | 幅度（dBV）
14.285714285714285 | 0.0025401760360001346 | -51.90272370843318
28.57142857142857 | 0.0008051888477007792 | -61.8820449790843
42.857142857142854 | 0.0013731338940510898 | -57.245742254356166
57.14285714285714 | 0.0017736399351510213 | -55.022690824794374
71.42857142857142 | 0.001334281513647719 | -57.495050620902575
85.71428571428571 | 0.0018879527627595999 | -54.480177522045956
100.0 | 0.0014690726005862635 | -56.65913482272601
114.28571428571428 | 0.002217853645969469 | -53.081342318335686
128.57142857142856 | 0.0026392828236165844 | -51.57028137214557
142.85714285714283 | 0.0024283256561952065 | -52.293861432621696
157.14285714285714 | 0.0028499500289802717 | -50.90325509687109
171.42857142857142 | 0.0030007441697553617 | -50.4554205806706
185.7142857142857 | 0.0037779900567487105 | -48.454783788552895
200.0 | 0.003762973604101079 | -48.4893765617635
214.28571428571428 | 0.004268693089142683 | -47.39410138030097
228.57142857142856 | 0.0048430676216721265 | -46.297589340877856
242.85714285714283 | 0.005190471823906123 | -45.69586324301082
257.1428571428571 | 0.005791301387819014 | -44.74447666313266
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
