user-lqt/gowin-fpga-instrument-138k/testing/measurements/reports/latency/firmware_2A1C5EA9A07E/K11/medium/trial_003/audio_spectrum.csv

频率（Hz） | 幅度（V） | 幅度（dBV）
14.285714285714285 | 0.001465446357337054 | -56.68060148567632
28.57142857142857 | 0.0007469696358749756 | -62.53394103571253
42.857142857142854 | 0.001136792098200981 | -58.88637907669333
57.14285714285714 | 0.0013475929415243113 | -57.408825448996
71.42857142857142 | 0.001419007617899563 | -56.96030546078902
85.71428571428571 | 0.002193199202855761 | -53.17843841276007
100.0 | 0.0015092402158642757 | -56.424832618383995
114.28571428571428 | 0.001886981425793012 | -54.48464749447882
128.57142857142856 | 0.0023401051188517655 | -52.61529266793491
142.85714285714283 | 0.002738082675201361 | -51.25106885346597
157.14285714285714 | 0.002804678927194839 | -51.04233697071361
171.42857142857142 | 0.002658083767383181 | -51.508626734690154
185.7142857142857 | 0.003296017532070341 | -49.64020973767104
200.0 | 0.00395212906590492 | -48.063377619263925
214.28571428571428 | 0.004119655069337398 | -47.70278290144665
228.57142857142856 | 0.004583659405336947 | -46.77575321295219
242.85714285714283 | 0.004737561954923242 | -46.488901951008906
257.1428571428571 | 0.005447177781961253 | -45.276569004672204
271.4285714285714 | 0.005943042324362002 | -44.5198235366113
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
