user-lqt/gowin-fpga-instrument-138k/testing/measurements/reports/latency/firmware_2A1C5EA9A07E/K12/medium/trial_001/audio_spectrum.csv

频率（Hz） | 幅度（V） | 幅度（dBV）
14.285714285714285 | 0.0009963876134178125 | -60.031433600585586
28.57142857142857 | 0.0009328937863836088 | -60.60335599137929
42.857142857142854 | 0.0001027029552937292 | -79.76834118661475
57.14285714285714 | 0.0008846348008934141 | -61.06471959598922
71.42857142857142 | 0.0013665130683947016 | -57.287724213131966
85.71428571428571 | 0.0015703197707063342 | -56.08023802808965
100.0 | 0.0009166797923170071 | -60.75564684636902
114.28571428571428 | 0.0016030351081022791 | -55.9011393210004
128.57142857142856 | 0.0021115820491439297 | -53.50784077307752
142.85714285714283 | 0.0020281194854738153 | -53.85812924758937
157.14285714285714 | 0.0020466203524623305 | -53.77925422757278
171.42857142857142 | 0.0025141305613935903 | -51.99224345407949
185.7142857142857 | 0.0027125893498389283 | -51.33231895409103
200.0 | 0.003112172059336805 | -50.13872801285718
214.28571428571428 | 0.003303002308435511 | -49.621822455687585
228.57142857142856 | 0.0035073544113787144 | -49.10040694567628
242.85714285714283 | 0.003947273238118086 | -48.07405619669221
257.1428571428571 | 0.004382485548970335 | -47.16559014592825
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
