user-lqt/gowin-fpga-instrument-138k/testing/measurements/reports/latency/firmware_2A1C5EA9A07E/K12/medium/trial_002/audio_spectrum.csv

频率（Hz） | 幅度（V） | 幅度（dBV）
14.285714285714285 | 0.002179593521476939 | -53.23248983285718
28.57142857142857 | 0.00015084762674339735 | -76.42923036213047
42.857142857142854 | 0.0010909792730764028 | -59.24367000517272
57.14285714285714 | 0.0006324754734882832 | -63.979126223129086
71.42857142857142 | 0.0011849048514873141 | -58.5263304468005
85.71428571428571 | 0.0018173737306083136 | -54.811115075733895
100.0 | 0.0018787430937185498 | -54.522652057473294
114.28571428571428 | 0.0012809657714355537 | -57.84924949683567
128.57142857142856 | 0.0015656193798556269 | -56.106276228959885
142.85714285714283 | 0.0019775169296059707 | -54.0775957960193
157.14285714285714 | 0.0023621154332879894 | -52.53397765676134
171.42857142857142 | 0.0024184529435650245 | -52.329247167361785
185.7142857142857 | 0.0026402401176554183 | -51.56713148509854
200.0 | 0.002980246824262158 | -50.514955322662765
214.28571428571428 | 0.0032577736547143464 | -49.74158186232657
228.57142857142856 | 0.0035832942247254486 | -48.9143506079391
242.85714285714283 | 0.0036727387920942253 | -48.70019915803843
257.1428571428571 | 0.00425725889715022 | -47.4173987644403
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
