user-lqt/gowin-fpga-instrument-138k/testing/measurements/reports/latency/firmware_2A1C5EA9A07E/K12/medium/trial_003/audio_spectrum.csv

频率（Hz） | 幅度（V） | 幅度（dBV）
14.285714285714285 | 0.000918647833178418 | -60.73701890001233
28.57142857142857 | 0.0006885794317696765 | -63.24091908085062
42.857142857142854 | 0.001075479837859117 | -59.36795453934917
57.14285714285714 | 0.0015536062946540717 | -56.1731805565485
71.42857142857142 | 0.0008846991151120462 | -61.064088142310084
85.71428571428571 | 0.0011410598904210772 | -58.85383120634579
100.0 | 0.0013791160531029995 | -57.207983725046596
114.28571428571428 | 0.0017277656087817958 | -55.25030349775798
128.57142857142856 | 0.0022105100222784882 | -53.11015023393277
142.85714285714283 | 0.002284726246007274 | -52.82331658558762
157.14285714285714 | 0.0022519343781286895 | -52.948885381492296
171.42857142857142 | 0.002576131482602555 | -51.78063949773893
185.7142857142857 | 0.002600307367804971 | -51.699506269415494
200.0 | 0.0031561379898194524 | -50.01688034431531
214.28571428571428 | 0.0035849121003540194 | -48.91042976951476
228.57142857142856 | 0.003999560390594385 | -47.95975482559623
242.85714285714283 | 0.004014367775610811 | -47.92765684423705
257.1428571428571 | 0.004491727164480398 | -46.9517326286178
271.4285714285714 | 0.005002233597116773 | -46.0167206240816
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
