user-lqt/gowin-fpga-instrument-138k/testing/measurements/reports/latency/firmware_2A1C5EA9A07E/K13/medium/trial_001/audio_spectrum.csv

频率（Hz） | 幅度（V） | 幅度（dBV）
14.285714285714285 | 0.0018731932152872856 | -54.54834847806639
28.57142857142857 | 0.0004195096978542908 | -67.54515990166757
42.857142857142854 | 0.0006125108326213236 | -64.25772452274407
57.14285714285714 | 0.0009840748865035565 | -60.1394370241015
71.42857142857142 | 0.0016457084854298463 | -55.67294183182557
85.71428571428571 | 0.0017408919812033571 | -55.18456350266992
100.0 | 0.0018253194837209116 | -54.77322220909579
114.28571428571428 | 0.0020279320422099054 | -53.85893205371437
128.57142857142856 | 0.0023270957800412117 | -52.66371482771335
142.85714285714283 | 0.002577424476600106 | -51.77628103011387
157.14285714285714 | 0.00287850501752325 | -50.81666018378604
171.42857142857142 | 0.0031964005979394656 | -49.90677593527102
185.7142857142857 | 0.0035202112083043964 | -49.068625572202514
200.0 | 0.003901340118094386 | -48.17572372653693
214.28571428571428 | 0.0043178462853703066 | -47.29465645079873
228.57142857142856 | 0.0045787028525438355 | -46.78515080574194
242.85714285714283 | 0.004744209522549936 | -46.47672278209211
257.1428571428571 | 0.005135811996895645 | -45.78781765129658
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
