user-lqt/gowin-fpga-instrument-138k/testing/measurements/reports/latency/firmware_2A1C5EA9A07E/K13/medium/trial_002/audio_spectrum.csv

频率（Hz） | 幅度（V） | 幅度（dBV）
14.285714285714285 | 0.0006781070510507217 | -63.3740347949108
28.57142857142857 | 0.0013556359157609085 | -57.357138672613075
42.857142857142854 | 0.0012039712347570405 | -58.38767778208752
57.14285714285714 | 0.0010270638224245418 | -59.76805136436245
71.42857142857142 | 0.0004768536803232054 | -66.43229722324618
85.71428571428571 | 0.0016765361804231044 | -55.51174139718089
100.0 | 0.0020288156804947246 | -53.85514814341582
114.28571428571428 | 0.0019044758216375719 | -54.40449073148143
128.57142857142856 | 0.0021743192373506054 | -53.253533833868616
142.85714285714283 | 0.002397305049367236 | -52.40553399744429
157.14285714285714 | 0.002399143958305045 | -52.398873836627274
171.42857142857142 | 0.0025914271178640916 | -51.729220017828375
185.7142857142857 | 0.0031512640739829938 | -50.03030403383393
200.0 | 0.0035870043254165127 | -48.905361992528114
214.28571428571428 | 0.0038319876260850465 | -48.33151803952988
228.57142857142856 | 0.003995793763429568 | -47.96793870579751
242.85714285714283 | 0.004322012318089607 | -47.28627999352237
257.1428571428571 | 0.004846085557423393 | -46.29217845362415
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
