user-lqt/gowin-fpga-instrument-138k/testing/measurements/reports/latency/firmware_2A1C5EA9A07E/K13/medium/trial_003/audio_spectrum.csv

频率（Hz） | 幅度（V） | 幅度（dBV）
14.285714285714285 | 0.0008522324702398606 | -61.38883846214909
28.57142857142857 | 0.00046525610032654085 | -66.64615847589293
42.857142857142854 | 0.001211354470225402 | -58.33457507377239
57.14285714285714 | 0.0018092754656613553 | -54.84990611875702
71.42857142857142 | 0.0018734853227269737 | -54.546994098200074
85.71428571428571 | 0.0013109651609633352 | -57.64817699155945
100.0 | 0.0013999682383287586 | -57.077636344649946
114.28571428571428 | 0.002089168403228359 | -53.60053102188695
128.57142857142856 | 0.002483357778303475 | -52.09921413931954
142.85714285714283 | 0.002663329514124255 | -51.491501963652475
157.14285714285714 | 0.0028782779637054777 | -50.81734534576297
171.42857142857142 | 0.0032000991853739914 | -49.89673121489532
185.7142857142857 | 0.0035659769170537634 | -48.95642944771481
200.0 | 0.0037558981638240122 | -48.50572383125411
214.28571428571428 | 0.004016681080294696 | -47.922652987306364
228.57142857142856 | 0.004420618840970102 | -47.090338593082166
242.85714285714283 | 0.0048242340610711604 | -46.331432587152285
257.1428571428571 | 0.005285898264459472 | -45.53762399627327
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
