user-lqt/gowin-fpga-instrument-138k/testing/measurements/reports/latency/firmware_2A1C5EA9A07E/K14/medium/trial_001/audio_spectrum.csv

频率（Hz） | 幅度（V） | 幅度（dBV）
14.285714285714285 | 0.0020990454257561655 | -53.55956325368055
28.57142857142857 | 0.001912184632438138 | -54.36940352804164
42.857142857142854 | 0.0018749217321182804 | -54.540337140257066
57.14285714285714 | 0.0015813172321153517 | -56.01961992789798
71.42857142857142 | 0.0018240636608410203 | -54.77920017246011
85.71428571428571 | 0.0021255141414129467 | -53.45072002501993
100.0 | 0.0021952799922662367 | -53.17020161466658
114.28571428571428 | 0.0022602465190102827 | -52.9168838187585
128.57142857142856 | 0.0024076756261337292 | -52.368040475106284
142.85714285714283 | 0.0023384554558660026 | -52.62141796694486
157.14285714285714 | 0.0027870914830389506 | -51.09697551682152
171.42857142857142 | 0.003117554508884211 | -50.12371888721664
185.7142857142857 | 0.0035288990161271073 | -49.04721538687407
200.0 | 0.0038761802521455006 | -48.231920707286406
214.28571428571428 | 0.004159113288011207 | -47.61998499886601
228.57142857142856 | 0.004416878920596694 | -47.09769011688091
242.85714285714283 | 0.004855931447249162 | -46.27454905929666
257.1428571428571 | 0.005316693098520373 | -45.48716816466212
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
