user-lqt/gowin-fpga-instrument-138k/testing/measurements/reports/latency/firmware_2A1C5EA9A07E/K14/medium/trial_002/audio_spectrum.csv

频率（Hz） | 幅度（V） | 幅度（dBV）
14.285714285714285 | 0.0022023214007275325 | -53.14238601993925
28.57142857142857 | 0.001382931101082569 | -57.18398912615824
42.857142857142854 | 0.001521096819665971 | -56.35686283388505
57.14285714285714 | 0.0014926452804909028 | -56.52086775747398
71.42857142857142 | 0.0017982078469196286 | -54.90320223032826
85.71428571428571 | 0.0017926296692191747 | -54.93018839979111
100.0 | 0.0014348638701079828 | -56.8637859962347
114.28571428571428 | 0.001609650479279735 | -55.865368335255695
128.57142857142856 | 0.002139375121149786 | -53.3942611784913
142.85714285714283 | 0.002449360750682836 | -52.21894491414336
157.14285714285714 | 0.0025326715056109765 | -51.92842271466672
171.42857142857142 | 0.00283813075034838 | -50.939352016564634
185.7142857142857 | 0.003062730081449276 | -50.27782551801465
200.0 | 0.0032355220393292536 | -49.80111275116414
214.28571428571428 | 0.003626748719124245 | -48.80965067321743
228.57142857142856 | 0.003953739801137116 | -48.05983830716759
242.85714285714283 | 0.004260378388185716 | -47.411036540935115
257.1428571428571 | 0.004580070238444436 | -46.782557234966575
271.4285714285714 | 0.00498241253293842 | -46.051206333415
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
