user-lqt/gowin-fpga-instrument-138k/testing/measurements/reports/latency/firmware_2A1C5EA9A07E/K14/medium/trial_003/audio_spectrum.csv

频率（Hz） | 幅度（V） | 幅度（dBV）
14.285714285714285 | 0.001257759345392823 | -58.00804894198098
28.57142857142857 | 0.001188647832522109 | -58.4989359445811
42.857142857142854 | 0.0010495173586539508 | -59.58020747883449
57.14285714285714 | 0.000983710535848227 | -60.14265354312026
71.42857142857142 | 0.0014695560867414494 | -56.65627668182411
85.71428571428571 | 0.0018627326240213931 | -54.5969895821139
100.0 | 0.0012509893673452732 | -58.05492763063839
114.28571428571428 | 0.0015453026879523961 | -56.21972879944825
128.57142857142856 | 0.0023510056798533552 | -52.57492643301809
142.85714285714283 | 0.0025664652879993023 | -51.81329210581466
157.14285714285714 | 0.0030421218380908424 | -50.33646792564121
171.42857142857142 | 0.0037593587184600844 | -48.497724637547044
185.7142857142857 | 0.003790339391789677 | -48.42643802025727
200.0 | 0.003990795978908119 | -47.978809480898015
214.28571428571428 | 0.004158280360993192 | -47.62172465734185
228.57142857142856 | 0.004653066531393532 | -46.64521475414655
242.85714285714283 | 0.004982961723325899 | -46.05024897707733
257.1428571428571 | 0.005383238690217572 | -45.3791272669737
271.4285714285714 | 0.00582999539613864 | -44.68663576393592
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
