user-lqt/gowin-fpga-instrument-138k/testing/measurements/reports/latency/firmware_2A1C5EA9A07E/K15/medium/trial_001/audio_spectrum.csv

频率（Hz） | 幅度（V） | 幅度（dBV）
14.285714285714285 | 0.0025664786132249037 | -51.81324700832627
28.57142857142857 | 0.0017239997677739932 | -55.26925594023169
42.857142857142854 | 0.0013973415099227393 | -57.09394878896472
57.14285714285714 | 0.0011027905332844329 | -59.1501394135302
71.42857142857142 | 0.001326819010299432 | -57.543766293111446
85.71428571428571 | 0.001743441011062175 | -55.171854845927406
100.0 | 0.002006058880997462 | -53.953126477987006
114.28571428571428 | 0.0023565519140621096 | -52.55445976869276
128.57142857142856 | 0.001877267667088738 | -54.529475996141684
142.85714285714283 | 0.00217726358602573 | -53.24177981580721
157.14285714285714 | 0.002559655329684974 | -51.83637021324414
171.42857142857142 | 0.0027849173839468314 | -51.10375367751203
185.7142857142857 | 0.003192415614865277 | -49.917611472412126
200.0 | 0.003660478870451534 | -48.729241914021635
214.28571428571428 | 0.003926775786889092 | -48.119277911931874
228.57142857142856 | 0.004145075852972816 | -47.64935035305286
242.85714285714283 | 0.004629196829571979 | -46.689887059739554
257.1428571428571 | 0.004948484875784326 | -46.11055505490664
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
