user-lqt/gowin-fpga-instrument-138k/testing/measurements/reports/latency/firmware_2A1C5EA9A07E/K15/medium/trial_002/audio_spectrum.csv

频率（Hz） | 幅度（V） | 幅度（dBV）
14.285714285714285 | 0.0020044481639769343 | -53.960103406776206
28.57142857142857 | 0.0016711043998345048 | -55.53992834676744
42.857142857142854 | 0.0014885693370380326 | -56.54461862522684
57.14285714285714 | 0.0016123148682130424 | -55.85100282165954
71.42857142857142 | 0.0015746341134394205 | -56.05640688160644
85.71428571428571 | 0.001580768486689595 | -56.02263461040771
100.0 | 0.0017064485648524178 | -55.35813595066518
114.28571428571428 | 0.0019137935281595088 | -54.36209836794289
128.57142857142856 | 0.0023598188946402803 | -52.542426517516716
142.85714285714283 | 0.002085842023555078 | -53.614371740781756
157.14285714285714 | 0.0024875370612486404 | -52.08460880158746
171.42857142857142 | 0.0027205326117221485 | -51.30692127455072
185.7142857142857 | 0.0029138650699191623 | -50.71061125273641
200.0 | 0.0030969098409909745 | -50.18142875776622
214.28571428571428 | 0.0035650289714390187 | -48.958738729510344
228.57142857142856 | 0.004152626616087134 | -47.633542335486155
242.85714285714283 | 0.004747719403223583 | -46.4702991272582
257.1428571428571 | 0.0049767443975346805 | -46.06109327549856
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
