user-lqt/gowin-fpga-instrument-138k/testing/measurements/reports/latency/firmware_2A1C5EA9A07E/K15/medium/trial_003/audio_spectrum.csv

频率（Hz） | 幅度（V） | 幅度（dBV）
14.285714285714285 | 0.0019871553676131313 | -54.03536351679543
28.57142857142857 | 0.00038575895051432533 | -68.27367976990362
42.857142857142854 | 0.0007041553886871037 | -63.046629856851375
57.14285714285714 | 0.0006965777993868398 | -63.14060742091001
71.42857142857142 | 0.0012997370816431027 | -57.72288980832039
85.71428571428571 | 0.0007604347118364167 | -62.378761339158274
100.0 | 0.0011158743430522595 | -59.04769415799646
114.28571428571428 | 0.0010037308208556922 | -59.96765480141082
128.57142857142856 | 0.0013124197761581007 | -57.63854468166574
142.85714285714283 | 0.0012846827681315953 | -57.82408202344493
157.14285714285714 | 0.00128091464221474 | -57.84959619745991
171.42857142857142 | 0.0016182802618734241 | -55.81892525837112
185.7142857142857 | 0.0014431900553724345 | -56.813529447924
200.0 | 0.0017321962318030848 | -55.22805820986232
214.28571428571428 | 0.0018906129804129245 | -54.46794729378574
228.57142857142856 | 0.002156583103350038 | -53.32467603548969
242.85714285714283 | 0.0020408288761055425 | -53.8038681886653
257.1428571428571 | 0.002382201865647258 | -52.460428791388225
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
