user-lqt/gowin-fpga-instrument-138k/testing/measurements/reports/latency/firmware_2A1C5EA9A07E/K16/medium/trial_001/audio_spectrum.csv

频率（Hz） | 幅度（V） | 幅度（dBV）
35.714285714285715 | 0.007481449850251843 | -42.52028461771591
71.42857142857143 | 0.004821361271068037 | -46.33660650059134
107.14285714285714 | 0.005495507363563193 | -45.19984411749771
142.85714285714286 | 0.0068662519071535375 | -43.26560534683964
178.57142857142858 | 0.008031337464089877 | -41.90424250686387
214.28571428571428 | 0.009864746539953638 | -40.118281376433735
250.0 | 0.011856400335341116 | -38.520942900361334
285.7142857142857 | 0.014317936624848374 | -36.88239128443096
321.42857142857144 | 0.016693612428028706 | -35.54899347276644
357.14285714285717 | 0.020507735359828923 | -33.76164591016773
392.8571428571429 | 0.02466573589633861 | -32.15811845872844
428.57142857142856 | 0.031514162584753765 | -30.02988457492566
464.2857142857143 | 0.03888929093382182 | -28.20339950492729
500.0 | 0.05452010495719125 | -25.26886633543946
535.7142857142858 | 0.07730113630923766 | -22.23628244007994
571.4285714285714 | 0.18303742484334182 | -14.749202058811532
607.1428571428571 | 0.3003545772896584 | -10.447314903665411
642.8571428571429 | 0.30408631738727465 | -10.340062417037881
678.5714285714286 | 0.1903393840093819 | -14.409426810374477
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
