user-lqt/gowin-fpga-instrument-138k/testing/measurements/reports/latency/firmware_2A1C5EA9A07E/K16/medium/trial_002/audio_spectrum.csv

频率（Hz） | 幅度（V） | 幅度（dBV）
14.285714285714285 | 0.0014179189765366092 | -56.96697170250055
28.57142857142857 | 0.000640396848764562 | -63.87101627607691
42.857142857142854 | 0.0011180480770189038 | -59.03079042031409
57.14285714285714 | 0.0003274741560170911 | -69.6964593694468
71.42857142857142 | 0.0010922574762892779 | -59.23349947894483
85.71428571428571 | 0.000947077518879808 | -60.47228944540625
100.0 | 0.001012576433914449 | -59.891443686722276
114.28571428571428 | 0.0008168177035934912 | -61.757497159616804
128.57142857142856 | 0.0008607966278102883 | -61.30198886065067
142.85714285714283 | 0.0012651894574686948 | -57.956888712335385
157.14285714285714 | 0.0016495563502475208 | -55.65265687992904
171.42857142857142 | 0.0016157079548612563 | -55.83274273576269
185.7142857142857 | 0.0016933919771820055 | -55.42485004250777
200.0 | 0.0017929955064333938 | -54.92841597711805
214.28571428571428 | 0.0018034273342599728 | -54.87802704158051
228.57142857142856 | 0.001839213708101896 | -54.70735609651081
242.85714285714283 | 0.0020841527998001724 | -53.62140887753286
257.1428571428571 | 0.00233746089407543 | -52.62511292358433
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
