user-lqt/gowin-fpga-instrument-138k/testing/measurements/reports/latency/firmware_2A1C5EA9A07E/K16/medium/trial_003/audio_spectrum.csv

频率（Hz） | 幅度（V） | 幅度（dBV）
14.285714285714285 | 0.0004229961781972267 | -67.47327112982083
28.57142857142857 | 0.0008020780287063249 | -61.91566760219217
42.857142857142854 | 0.000641375947706835 | -63.85774661231933
57.14285714285714 | 0.0005041521066488382 | -65.94876827458245
71.42857142857142 | 0.0008058701481772998 | -61.87469862973604
85.71428571428571 | 0.0013727724789075293 | -57.24802872129439
100.0 | 0.0012172034316210911 | -58.29273663840355
114.28571428571428 | 0.0013690252222684387 | -57.27177101115367
128.57142857142856 | 0.0012344132126624566 | -58.17078876813202
142.85714285714283 | 0.0016756181702449527 | -55.51649877673998
157.14285714285714 | 0.0015997249521609372 | -55.91909362222041
171.42857142857142 | 0.0015924536020695318 | -55.958664249349546
185.7142857142857 | 0.0015965068229076868 | -55.93658442197927
200.0 | 0.0018410324832718462 | -54.69877097428406
214.28571428571428 | 0.0022169020529404066 | -53.085069888789974
228.57142857142856 | 0.002109475272701314 | -53.516511221165224
242.85714285714283 | 0.002444351467917947 | -52.23672695383616
257.1428571428571 | 0.002653750649611844 | -51.522797730298976
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
