user-lqt/gowin-fpga-instrument-138k/testing/measurements/reports/latency/firmware_2A1C5EA9A07E/K17/medium/trial_001/audio_spectrum.csv

频率（Hz） | 幅度（V） | 幅度（dBV）
14.285714285714285 | 0.0023438869940380323 | -52.60126661629381
28.57142857142857 | 0.00046810429383379123 | -66.59314750303248
42.857142857142854 | 0.0009106506514359162 | -60.81296394795521
57.14285714285714 | 0.001044107427882271 | -59.6250962922649
71.42857142857142 | 0.0008194924591322363 | -61.72910076797889
85.71428571428571 | 0.0004017208752594173 | -67.92151199497009
100.0 | 0.0005063878372420753 | -65.91033468074953
114.28571428571428 | 0.0009186018118469849 | -60.73745404632682
128.57142857142856 | 0.0013812756586383539 | -57.19439282844362
142.85714285714283 | 0.00132516284840477 | -57.554614965595896
157.14285714285714 | 0.001208892651773586 | -58.3522452451873
171.42857142857142 | 0.00144293218374082 | -56.81508159599908
185.7142857142857 | 0.0013174425154889409 | -57.605366509034674
200.0 | 0.0014925985573470764 | -56.52113964954906
214.28571428571428 | 0.0014257268024142286 | -56.91927371928925
228.57142857142856 | 0.001745784954564317 | -55.160185072837024
242.85714285714283 | 0.002011748259764116 | -53.92852731362939
257.1428571428571 | 0.001974120433505851 | -54.09252712439579
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
