user-lqt/gowin-fpga-instrument-138k/testing/measurements/reports/latency/firmware_2A1C5EA9A07E/K17/medium/trial_002/audio_spectrum.csv

频率（Hz） | 幅度（V） | 幅度（dBV）
14.285714285714285 | 0.0006405993834349315 | -63.86826967344818
28.57142857142857 | 0.0011375409259351387 | -58.88065939076974
42.857142857142854 | 0.0010912230039738864 | -59.241729745364545
57.14285714285714 | 0.0007135363099381512 | -62.93167843824543
71.42857142857142 | 0.0004893575574795017 | -66.2074740038025
85.71428571428571 | 0.0010137010414540785 | -59.88180214641291
100.0 | 0.000914824860965598 | -60.773240833350705
114.28571428571428 | 0.0007793557206402698 | -62.16528544861536
128.57142857142856 | 0.0012853091039064174 | -57.819848326378896
142.85714285714283 | 0.0008905893124064592 | -61.00645041923515
157.14285714285714 | 0.0011502625371244445 | -58.784060490117184
171.42857142857142 | 0.0011779166421253945 | -58.577708845407656
185.7142857142857 | 0.0011977133533435317 | -58.432942169098546
200.0 | 0.0013981468260757402 | -57.08894437715435
214.28571428571428 | 0.0014431446106335133 | -56.81380296297516
228.57142857142856 | 0.0016075266315535603 | -55.87683646958709
242.85714285714283 | 0.001652045906277418 | -55.63955777752863
257.1428571428571 | 0.001761592357149499 | -55.081891651994596
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
