user-lqt/gowin-fpga-instrument-138k/testing/measurements/reports/latency/firmware_2A1C5EA9A07E/K17/medium/trial_003/audio_spectrum.csv

频率（Hz） | 幅度（V） | 幅度（dBV）
14.285714285714285 | 0.0019695593134269776 | -54.11261871693775
28.57142857142857 | 0.0008681571326798022 | -61.22803324578694
42.857142857142854 | 0.0007921887061300825 | -62.02342706848424
57.14285714285714 | 0.0009130343623658399 | -60.790257546684394
71.42857142857142 | 0.0008001590387450302 | -61.93647369054072
85.71428571428571 | 0.0010497748170295346 | -59.578076994022666
100.0 | 0.0011817109823247358 | -58.54977456604458
114.28571428571428 | 0.0008532724391479164 | -61.37824563860196
128.57142857142856 | 0.0013412083997997113 | -57.45007470618794
142.85714285714283 | 0.0015043471168671157 | -56.45303883943143
157.14285714285714 | 0.0010803031673694938 | -59.329087011753636
171.42857142857142 | 0.0012232654049174423 | -58.249586126876316
185.7142857142857 | 0.0016629498158777934 | -55.58241713246118
200.0 | 0.0017743560201219323 | -55.01918471306727
214.28571428571428 | 0.001813904422950359 | -54.827712004601246
228.57142857142856 | 0.0019169813693643025 | -54.34764215789619
242.85714285714283 | 0.0018287158538447125 | -54.75707540052083
257.1428571428571 | 0.0019031291222359828 | -54.41063489981718
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
