user-lqt/gowin-fpga-instrument-138k/testing/measurements/reports/latency/firmware_2A1C5EA9A07E/K18/medium/trial_001/audio_spectrum.csv

频率（Hz） | 幅度（V） | 幅度（dBV）
14.285714285714285 | 0.0018496984931003712 | -54.657981144958484
28.57142857142857 | 0.0004929784823160804 | -66.14344073069611
42.857142857142854 | 0.0009531534990044063 | -60.41674307007868
57.14285714285714 | 0.001142376380147435 | -58.84381569955267
71.42857142857142 | 0.000454902413065977 | -66.8416351882873
85.71428571428571 | 0.0002724015423215394 | -71.29580875604866
100.0 | 0.0004150205863940765 | -67.63860720621089
114.28571428571428 | 0.00048051949933904955 | -66.36577968192645
128.57142857142856 | 0.0008430629542351416 | -61.482799879839654
142.85714285714283 | 0.0009132222491019033 | -60.78847032417754
157.14285714285714 | 0.0003444883657404377 | -69.25650881504288
171.42857142857142 | 0.0008684771810480522 | -61.22483176022954
185.7142857142857 | 0.0008791148560230005 | -61.11908761619529
200.0 | 0.0009924903249069724 | -60.06547436353864
214.28571428571428 | 0.0010422804439867148 | -59.64030821403398
228.57142857142856 | 0.0011180543660818346 | -59.03074156199214
242.85714285714283 | 0.0014575606227389811 | -56.72746746107377
257.1428571428571 | 0.0016567255621541608 | -55.61498853666123
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
