user-lqt/gowin-fpga-instrument-138k/testing/measurements/reports/latency/firmware_2A1C5EA9A07E/K18/medium/trial_002/audio_spectrum.csv

频率（Hz） | 幅度（V） | 幅度（dBV）
14.285714285714285 | 0.0008237644368396707 | -61.6839392225295
28.57142857142857 | 0.0001791470776924229 | -74.93580543596427
42.857142857142854 | 0.0002807001883984669 | -71.0351459175722
57.14285714285714 | 0.0003740409200710727 | -68.54161766781193
71.42857142857142 | 0.0004674447848899713 | -66.60539362240883
85.71428571428571 | 0.00047756116055579754 | -66.41942002125026
100.0 | 0.0005266100481387735 | -65.57021716933166
114.28571428571428 | 0.0005197204986222578 | -65.68460307116383
128.57142857142856 | 0.00048041199385115744 | -66.36772317282842
142.85714285714283 | 0.0005626565089349172 | -64.99513305499866
157.14285714285714 | 0.0006447838398618801 | -63.811717114715655
171.42857142857142 | 0.0006576619628976609 | -63.63994551286373
185.7142857142857 | 0.0008341402690715081 | -61.57521824476426
200.0 | 0.0008506362148101931 | -61.40512263329984
214.28571428571428 | 0.0009319927433025752 | -60.611749382875686
228.57142857142856 | 0.0009914430106152197 | -60.07464489062912
242.85714285714283 | 0.0010460193362737782 | -59.6092057441859
257.1428571428571 | 0.001146727182332942 | -58.81079785471067
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
