user-lqt/gowin-fpga-instrument-138k/testing/measurements/reports/latency/firmware_2A1C5EA9A07E/K18/medium/trial_003/audio_spectrum.csv

频率（Hz） | 幅度（V） | 幅度（dBV）
14.285714285714285 | 0.0009542078694211525 | -60.407140122087874
28.57142857142857 | 0.0003725802792567349 | -68.57560272237782
42.857142857142854 | 0.0002458645035365957 | -72.18608335210321
57.14285714285714 | 0.0013032980794423336 | -57.699124894466685
71.42857142857142 | 0.0008646747607457307 | -61.262944351858685
85.71428571428571 | 0.0006396763259094348 | -63.88079443999145
100.0 | 0.0005973383076238197 | -64.47559265646773
114.28571428571428 | 0.00019773345260047488 | -74.07839700818553
128.57142857142856 | 0.000386702632080531 | -68.25245743807527
142.85714285714283 | 0.0005287273173485581 | -65.53536501310998
157.14285714285714 | 0.0003687284680820886 | -68.66586661844023
171.42857142857142 | 0.0006241074276614751 | -64.09481297478207
185.7142857142857 | 0.00041254935879621665 | -67.69048167098772
200.0 | 0.0007074733761687614 | -63.005797979693355
214.28571428571428 | 0.0007234569965746164 | -62.81174557853967
228.57142857142856 | 0.00056862717268592 | -64.90344781498025
242.85714285714283 | 0.0007763180868768363 | -62.1992059080778
257.1428571428571 | 0.0007928796708204771 | -62.01585434353181
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
