user-lqt/gowin-fpga-instrument-138k/testing/measurements/reports/latency/firmware_2A1C5EA9A07E/K19/medium/trial_001/audio_spectrum.csv

频率（Hz） | 幅度（V） | 幅度（dBV）
14.285714285714285 | 0.0013645336866669297 | -57.300314765979564
28.57142857142857 | 0.000282895992282404 | -70.96746410084009
42.857142857142854 | 0.00046249311587233323 | -66.6978945454572
57.14285714285714 | 0.0003982034558881678 | -67.99789950361827
71.42857142857142 | 9.345825946299274e-05 | -80.58764622798387
85.71428571428571 | 0.00023897444081359486 | -72.43297091887831
100.0 | 0.0006229607633541785 | -64.11078612284841
114.28571428571428 | 0.0006927559787546569 | -63.188394347971226
128.57142857142856 | 0.0012206381800903782 | -58.26826099918537
142.85714285714283 | 0.0013273633795758437 | -57.540203364247475
157.14285714285714 | 0.001015662364733404 | -59.86501279976257
171.42857142857142 | 0.0009470462076155171 | -60.472576613749354
185.7142857142857 | 0.0011230146121868423 | -58.99229185694665
200.0 | 0.0013659844606801633 | -57.29108482244907
214.28571428571428 | 0.0016249952324614502 | -55.78295817700948
228.57142857142856 | 0.0015492379023423373 | -56.19763772950055
242.85714285714283 | 0.0016131286803163416 | -55.846619745559146
257.1428571428571 | 0.0017537150919389314 | -55.12081921197794
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
