user-lqt/gowin-fpga-instrument-138k/testing/measurements/reports/latency/firmware_2A1C5EA9A07E/K19/medium/trial_002/audio_spectrum.csv

频率（Hz） | 幅度（V） | 幅度（dBV）
14.285714285714285 | 0.0009068849236121227 | -60.848956358268
28.57142857142857 | 0.0009319599969219757 | -60.61205457457055
42.857142857142854 | 0.001145400527152067 | -58.82085242691265
57.14285714285714 | 0.0008011094398728221 | -61.92616301448922
71.42857142857142 | 0.00038209622767212064 | -68.35654499913782
85.71428571428571 | 0.0001969726646470076 | -74.11188079825867
100.0 | 0.0002735155961129754 | -71.26035809500658
114.28571428571428 | 0.0007166021261568526 | -62.894438152345444
128.57142857142856 | 0.0008096628336098484 | -61.8339159184067
142.85714285714283 | 0.0008145154328472284 | -61.782013651617845
157.14285714285714 | 0.0008191021461065515 | -61.73323872366198
171.42857142857142 | 0.001174233431908513 | -58.6049111774009
185.7142857142857 | 0.001141438103446166 | -58.850952678842596
200.0 | 0.0011421914380648102 | -58.84522199312804
214.28571428571428 | 0.0013842295022272037 | -57.17583797666413
228.57142857142856 | 0.0014898015773541248 | -56.537431404889624
242.85714285714283 | 0.001652753601874239 | -55.63583775401124
257.1428571428571 | 0.001780844149285422 | -54.98748172378385
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
