user-lqt/gowin-fpga-instrument-138k/testing/measurements/reports/latency/firmware_2A1C5EA9A07E/K19/medium/trial_003/audio_spectrum.csv

频率（Hz） | 幅度（V） | 幅度（dBV）
14.285714285714285 | 0.000727311156194137 | -62.76559501506675
28.57142857142857 | 0.0004394400689850656 | -67.14200691618802
42.857142857142854 | 0.0006980616553164757 | -63.12212434463737
57.14285714285714 | 0.0007821347329549448 | -62.13436855162424
71.42857142857142 | 0.00028731377959317255 | -70.83287089416946
85.71428571428571 | 7.461977402364223e-05 | -82.54292140996003
100.0 | 0.0004367131280446777 | -67.19607505089469
114.28571428571428 | 0.0003587819874839761 | -68.90338737346637
128.57142857142856 | 0.00016528275563290935 | -75.63544910209045
142.85714285714283 | 0.00047017023732153564 | -66.5548973203053
157.14285714285714 | 0.0006740293044305251 | -63.426424429061825
171.42857142857142 | 0.0004511572988827446 | -66.91344024331272
185.7142857142857 | 0.0005004116935164003 | -66.01345100713789
200.0 | 0.0005706466044688427 | -64.87265525164653
214.28571428571428 | 0.0006524458245202333 | -63.709110877915066
228.57142857142856 | 0.0005151152323263498 | -65.76191215061326
242.85714285714283 | 0.0010351853620246087 | -59.69963755493109
257.1428571428571 | 0.0009419125580562421 | -60.51978825659099
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
