user-lqt/gowin-fpga-instrument-138k/testing/measurements/reports/latency/firmware_2A1C5EA9A07E/K20/medium/trial_001/audio_spectrum.csv

频率（Hz） | 幅度（V） | 幅度（dBV）
14.285714285714285 | 0.0003539054456372077 | -69.02225509412769
28.57142857142857 | 0.0009124378437895367 | -60.795934209071014
42.857142857142854 | 0.00039607220475962074 | -68.04451268198613
57.14285714285714 | 0.00029363114462101263 | -70.64395763862802
71.42857142857142 | 0.00039405273409618785 | -68.08891309676385
85.71428571428571 | 0.0005559199781987444 | -65.0997543672026
100.0 | 0.0002457343659495098 | -72.19068206384061
114.28571428571428 | 0.00033786238430092835 | -69.42520314881112
128.57142857142856 | 0.0002517694498227313 | -71.97993938276366
142.85714285714283 | 0.0003313897543664823 | -69.59321845731279
157.14285714285714 | 0.00013469322880972436 | -77.4130847246624
171.42857142857142 | 0.0005214890649594836 | -65.65509587619853
185.7142857142857 | 0.00048707369835719366 | -66.24810642793385
200.0 | 0.0005229430943437657 | -65.63091135294505
214.28571428571428 | 0.0005471505821431288 | -65.23786268744453
228.57142857142856 | 0.0007938241862924365 | -62.00551346223487
242.85714285714283 | 0.0009688873084465708 | -60.27453465848708
257.1428571428571 | 0.0009922624247072145 | -60.06746908655154
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
