user-lqt/gowin-fpga-instrument-138k/docs/figures/system_architecture.png

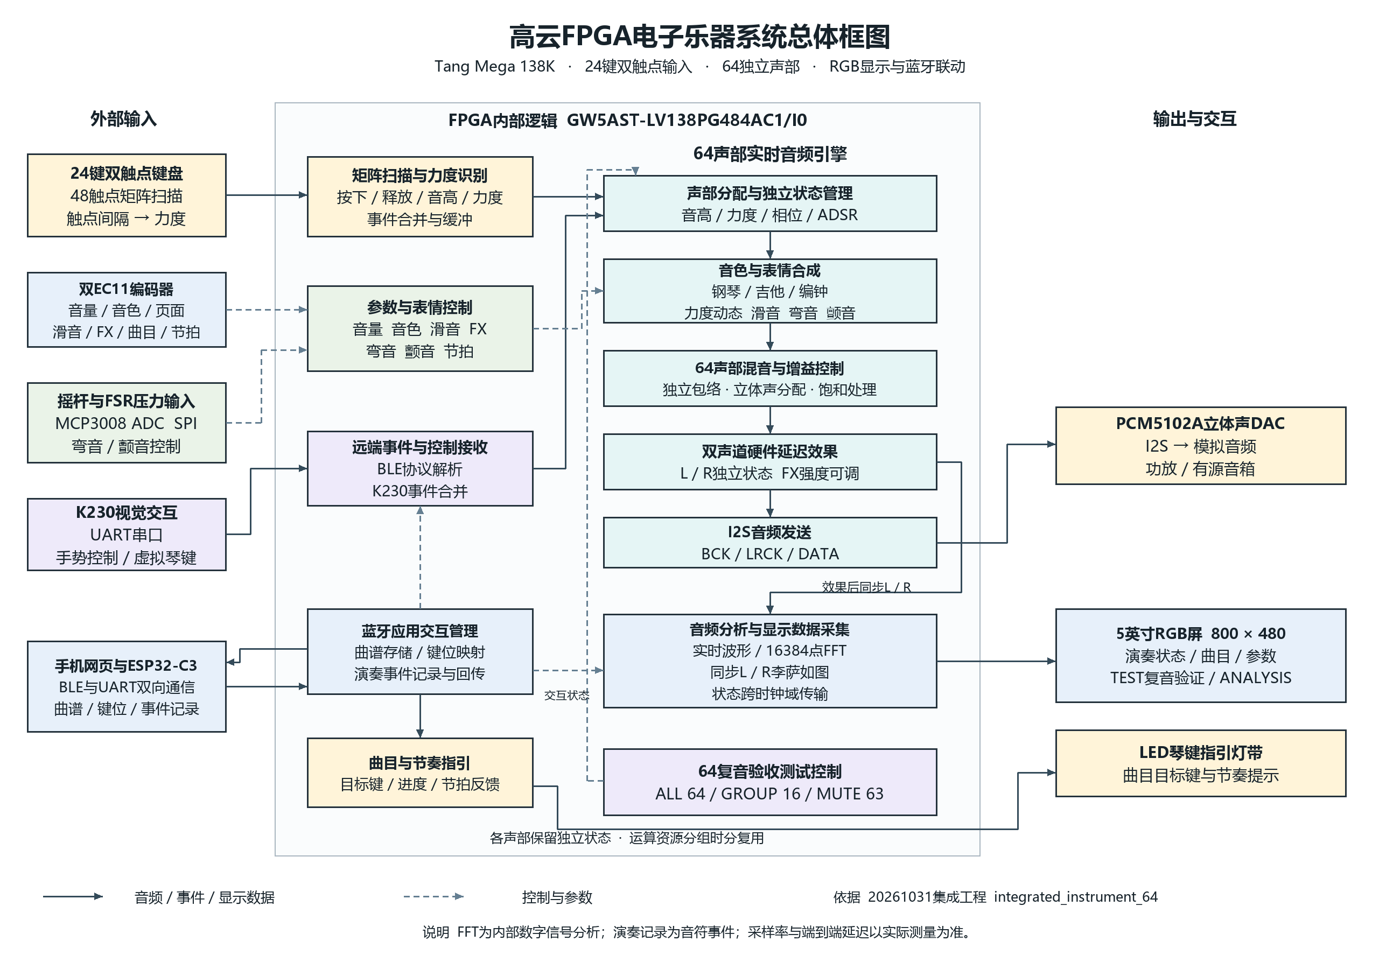
docs/figures/system_architecture.png
