user-lqt/gowin-fpga-instrument-138k/testing/measurements/reports/polyphony/group04_64_001/frequency_errors.png

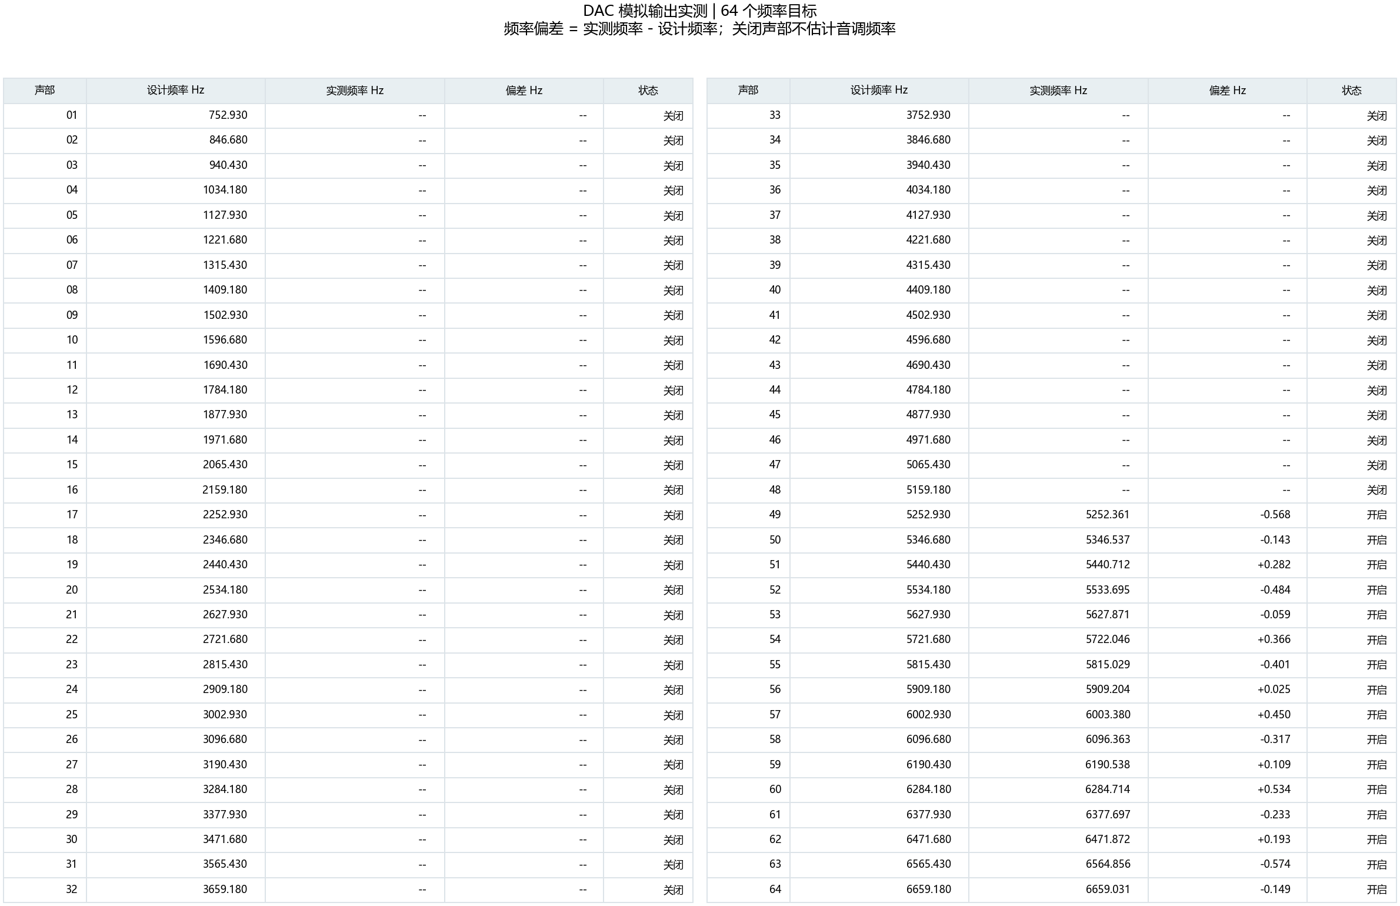
testing/measurements/reports/polyphony/group04_64_001/frequency_errors.png
