user-lqt/gowin-fpga-instrument-138k/docs/高云FPGA电子乐器分阶段硬件采购清单.md

# 分阶段硬件采购清单

> 四阶段 BOM、预算、接线电气要求、不买清单。**注意：本文按 Tang Mega 60K 编写，平台已改为 138K，修正项见 `PLATFORM_TANG_MEGA_138K.md` 第 4 节。**
>
> 本文档由团队原始 Word 文件自动转换归档，内容未作修改。
> 权威的接口与平台信息以 `INTERFACE_FREEZE.md` 和 `PLATFORM_TANG_MEGA_138K.md` 为准。

---

高云 FPGA 实时多音色合成电子乐器分阶段硬件采购清单
适用平台  Sipeed Tang Mega 60K  |  本科组三人团队
使用说明
本清单按照先发声、再满足基础赛题要求、再冲击高分、最后成品化的顺序组织。建议仅在上一阶段验收通过后采购下一阶段器件，以减少型号不匹配和重复采购。首选申请大赛提供的 Tang Mega 60K；外接 GPIO 只允许使用 3.3 V 电平，任何 5 V 输出均不得直接接入 FPGA。
第一阶段先使用有源音箱，不立即购买功放和扬声器。
触摸琴键、压力传感器、PCB和外壳在基础声音链路稳定后再购买。
商品链接优先采用官方页或搜索页，下单前仍需核对模块照片、引脚和供电说明。
阶段零  开发平台
目标：取得完整开发套件并完成下载、串口和基础 LED 工程。
器件
具体型号
数量
采购要求
FPGA开发板
Sipeed Tang Mega 60K，GW5AT-LV60PG484AC1/I0
1
完整 NEO Dock 套件，不买裸核心板
下载调试附件
配套 USB JTAG UART 调试器及连接线
1套
确认商品选项包含下载与串口附件
HDMI线
HDMI 1.4 或以上
1
后期连接板载 HDMI TX

官方链接：高云竞赛板卡申请  |  Tang Mega 60K 官方资料  |  Sipeed 官方推荐淘宝商品
下单选项应明确包含 Tang Mega 60K 核心板、Tang Mega NEO Dock 底板和调试附件。收到板卡后先核对版本、原理图和管脚约束。
阶段一  打通 FPGA 发声链路
目标：FPGA 生成固定 1 kHz 正弦波，通过 I2S 和 DAC 从有源音箱正常发声。
器件
具体型号
数量
参考预算
选择要求
I2S DAC
PCM5102A 红色 DAC 模块
2
15至35元每个
三线 I2S，支持无 MCLK，3.3 V 数字输入
有源音箱
3.5 mm 输入电脑音箱
1
50至150元
自带功放和音量调节
音频线
RCA 转 3.5 mm 或 3.5 mm 音频线
1
10至20元
按 DAC 输出接口选择
杜邦线
公公 公母 母母 20 cm
各1组
15至30元
建议硅胶软线
面包板
830 孔面包板
1
10至20元
用于低速接口临时搭建
万用表
基础数字万用表
1
30至100元
检查供电、短路和电平
逻辑分析仪
8 通道 24 MHz USB 逻辑分析仪
1
25至60元
检查 I2S I2C SPI

PCM5102A 三线 I2S DAC
8通道24MHz逻辑分析仪
面包板杜邦线套装
3.5mm有源音箱
阶段一验收
左右声道持续输出 1 kHz 正弦波。
LRCK 实测约为 48 kHz，I2S 数据格式无一位错位。
没有严重杂音、爆音或周期性中断。
预计外围预算：150至350元，不含开发板和已有设备。
阶段二  满足基础赛题要求
目标：实现至少两维交互、8 复音、独立 ADSR、实时变调，并将端到端延迟控制在 10 ms 内。
器件
具体型号
数量
参考预算
用途和要求
音符键盘
4×4 薄膜矩阵键盘，8 Pin
2
5至12元每个
多键音符与和弦输入
旋转编码器
EC11 增量式编码器及旋钮帽
3
3至10元每个
3.3 V 上拉，控制音量和参数
距离传感器
HC-SR04
2
5至12元每个
5 V 供电，ECHO 必须电阻分压
OLED
SSD1306 0.96英寸 128×64 I2C 四针版
1
10至25元
必须支持 3.3 V
电阻包
1/4 W 常用阻值
1盒
10至20元
含 10 kΩ 和 20 kΩ
电容包
0.1 μF 10 μF 100 μF 等
1盒
10至20元
去耦与电源滤波

4×4薄膜矩阵键盘
EC11旋转编码器
HC-SR04超声波模块
SSD1306 I2C OLED
常用电阻电容元件包
阶段二关键电气要求
矩阵键盘列输入使用内部上拉或 10 kΩ 外部上拉至 3.3 V。廉价键盘可能存在鬼键，正式版本再增加隔离二极管。
HC-SR04 的 ECHO 为 5 V，采用 10 kΩ 串联和 20 kΩ 下拉形成约 3.3 V 分压后接 FPGA。
SSD1306 购买 VCC GND SCL SDA 四针 I2C 版本，使用 3.3 V 供电。
阶段二验收
键盘可同时触发多个音符，至少 8 复音稳定发声。
每个声部具有独立 ADSR，松键后平滑释放。
HC-SR04 或编码器形成第二演奏维度。
OLED 显示音色、音量和活跃声部数。
输入到声音的端到端延迟不超过 10 ms，连续运行 30 分钟。
预计新增预算：60至150元。完成本阶段后已经具备基础提交版本。
阶段三  冲奖交互升级
目标：实现 32 复音、三维表情、触摸琴键、力度控制、两种以上音色和不超过 5 ms 的响应延迟。
器件
具体型号
数量
参考预算
选择要求
触摸控制器
MPR121 十二通道 I2C 模块
2
15至35元每个
3.3 V，需引出 ADDR 和 IRQ
琴键材料
10至20 mm 导电铜箔胶带
1卷
10至25元
制作 24 个触摸电极
压力传感器
Interlink FSR402 或兼容 FSR
2至4
15至40元每个
输出接 ADC，不接 FPGA
ADC
MCP3008 10 bit 8通道 SPI 模块
1
15至35元
3.3 V 供电和参考电压
面板
1至2 mm 亚克力或 PET 绝缘板
1
20至60元
覆盖铜箔触摸电极
音频采集
Behringer UCA202 或 UCA222
可选1
按店铺价格
线路输入，用于录音和频谱验证

MPR121 12路电容触摸模块
导电铜箔胶带
FSR402压力传感器
MCP3008 SPI ADC模块
Behringer UCA222
阶段三验收
两块 MPR121 提供最多 24 个触摸琴键，并配置不同 I2C 地址。
至少形成音符、力度、手势三个独立演奏维度。
32 个独立声部可同时保持状态，测试模式输出不同频率。
频谱能观察到相应独立谱峰，完成波表和 FM 等两种音色。
至少一种 FPGA 数字音效稳定运行，最大演奏延迟不超过 5 ms。
预计新增预算：100至300元，不含可选 USB 音频接口。
阶段四  独立成品化
目标：取消面包板依赖，形成能够运输、上电即运行并连续演示的完整作品。
器件或服务
具体型号或方案
数量
参考预算
注意事项
功放板
PAM8403 双声道 2×3 W 带音量版
1至2
8至25元
5 V 独立供电
扬声器
4 Ω 3 W 全频喇叭 40至52 mm
2
10至30元每个
匹配 PAM8403
功放电源
5 V 2 A 稳压电源
1
20至40元
与 FPGA 信号地共地
音频线
双芯屏蔽线
1至2米
5至15元
DAC 到功放尽量短
琴键PCB
嘉立创 EDA 双层板
1批
30至100元
功能固定后再打样
接口PCB
双层转接板
1批
30至100元
整合 DAC 传感器和电源
外壳
激光切割亚克力或 3D 打印
1套
80至250元
预留散热和维护孔
固定件
M2.5 M3 螺柱和脚垫
1套
15至45元
板卡绝缘固定

PAM8403带音量功放板
4欧3W全频喇叭
5V 2A稳压电源
嘉立创EDA
嘉立创PCB
亚克力激光切割定制
功放安全要求
PAM8403 使用 BTL 差分输出，扬声器负端不得接系统地。
左右声道负端不得互连，功放输出不得连接普通耳机。
示波器普通接地夹不能随意夹在 PAM8403 扬声器输出端。
PCM5102A 到 PAM8403 使用短屏蔽线，功放独立 5 V 供电但信号地共地。
预计新增预算：200至600元，主要取决于 PCB 和外壳。
测试设备和借用建议
设备
用途
建议
双通道示波器
测量输入标记到 DAC 输出的端到端延迟
优先向实验室借用
逻辑分析仪
检查 I2S I2C SPI 和键盘扫描
第一阶段自购
万用表
检查电源和接线
第一阶段自购
可调电源
调试功放和传感器供电
实验室借用
USB线路输入接口
录制音频和 FFT 验证
冲奖阶段可选
焊台和热风枪
PCB和排针焊接
使用实验室设备

预算汇总
阶段
内容
预计新增预算
阶段零
Tang Mega 60K完整套件
免费申请或按官方店铺价格
阶段一
DAC 音箱 线材 基础工具
150至350元
阶段二
键盘 编码器 测距 OLED
60至150元
阶段三
触摸 力度 ADC 触摸面板
100至300元
阶段四
功放 扬声器 PCB 外壳
200至600元
外围合计
不含开发板和已有仪器
约510至1400元

节省预算的优先方法：申请免费板卡；借用学校显示器、示波器和音箱；第一阶段只购买 DAC、键盘、HC-SR04 和线材；核心功能稳定后再采购触摸、压力和外壳。
实际下单顺序
现在购买
PCM5102A模块 2个
杜邦线三种和830孔面包板
8通道逻辑分析仪和数字万用表
4×4矩阵键盘 2个
EC11编码器 3个
HC-SR04 2个
SSD1306 OLED 1个
常用电阻电容包
第一声正常后购买
MPR121模块 2个
导电铜箔胶带和绝缘面板
FSR402 2至4个
MCP3008模块 1个
全部功能稳定后购买
PAM8403功放板
4 Ω 3 W扬声器 2个
5 V 2 A独立电源
定制PCB和外壳
可选USB线路输入音频接口
暂不购买
DFPlayer Mini VS1053 WT588D 等音频播放或解码模块，容易产生预录音频合规争议。
蓝牙音频解码板和带内置歌曲的音乐模块。
5 V I2C触摸模块或任何会把信号上拉到5 V的模块。
未确认底板和引脚的HDMI扩展板。
Tang Mega 60K裸核心板或只有NEO Dock的单独底板。
大功率功放和复杂触摸屏。
采购前最终核对
□  确认开发板商品选项为 Tang Mega 60K 完整 NEO Dock 套件。
□  确认 PCM5102A 支持无 MCLK 的 BCK LCK DIN 三线 I2S。
□  确认所有连接 FPGA 的数字信号不超过 3.3 V。
□  确认 OLED 为四针 I2C 版而非七针 SPI 版。
□  确认 MPR121 可使用 3.3 V，并引出 ADDR 和 IRQ。
□  确认 MCP3008 模块能在 3.3 V 供电下工作。
□  保留商品页面截图、模块原理图和订单型号，便于后续接线核对。
资料依据
赛题要求与适配板卡依据：全国大学生嵌入式芯片与系统设计竞赛 2026 高云半导体 FPGA 创新设计赛道选题指南。板卡接口依据：Sipeed Tang Mega 60K 官方资料页，最后核对日期为 2026 年 9 月 20 日。电商链接可能随平台更新，下单时应以商品详情页的实际型号、引脚和供电说明为准。
