user-lqt/gowin-fpga-instrument-138k/testing/validation/README.md

# 本次整理的离线验证

- 运行原软件测试集294项：292项通过，2项因原压缩包未包含 `verify_scope_download.py` 报错。两项均为采集下载诊断工作流测试；没有伪造缺失模块，也没有修改测试使其跳过。
- 首次运行曾因本机Tk脚本路径未配置而产生界面测试错误；配置匹配的Tcl/Tk 8.6.12后重新完整运行，最终只剩上述2项。
- 原软件源码保持原字节。本次没有连接示波器、逻辑分析仪或FPGA，测量结果来自团队归档，不是本次新测。
- 保留的报告JSON/CSV和原屏均从原压缩包复制；结果性质、测量条件与局限见各报告。

运行命令：`python -B -m unittest discover -s tools -p "test_*.py"`。
环境：Python3.12，NumPy2.5.4，SciPy1.18.1，Matplotlib3.11.2；图形测试需要可用的Tkinter。
