user-lqt/gowin-fpga-instrument-138k/testing/docs/analysis_reference/README.md

# 历史分析引擎

`scan_latency_validation_ed003177ee1d.py` 是原84次钢琴相位预算引用的历史源码。
SHA-256：`ed003177ee1df62f158db0f4db7728481d4e685b8e3c6737c06e71541d0ac665`。

仅供历史结果溯源，不参与当前软件运行，不应替换 `tools/scan_latency_validation.py`。
