user-lqt/gowin-fpga-instrument-138k/testing/docs/K22_B_PARTIAL_REVIEW.md

# K22 第十一次 B 窗口部分导通复核

## 记录与结论

对应 `K22/medium/trial_011`，逻辑原始记录为 `logic_173`。
只使用已保存的示波器两路原始数据和数字 CSV，未访问仪器或修改固件。
原始文件分析前后哈希一致，旧失败文件保留。

本次不能套用初始 A 窗口瞬态分类；当前完整 B 窗口验证模型不适用。
仍为分析不可用，不等于延迟超过 5 ms，也不据此认定接线错误。

## 原始证据

- 两仪器共同列起止沿拟合最大残差约 0.4474 µs。
- 相关 B 窗口为逻辑时间 2.786851917 至 2.786877542 s。
- A 行尾部列低延伸到 B 起点后约 1.375 µs，随后列恢复高。
- B 起点后约 8.250 µs，列重新进入低电平。
- 该列低段宽约 18.000 µs，保持到 B 内部窗口末尾。
- 下一帧列信号覆盖完整 B 内部窗口。
- 示波器原始模拟列电压也可见 A 尾部后的恢复高、再次下降过程，不是数字 CSV 漏点的直接证据。

这与 B 接触在扫描中途建立导通的时序相符，
但不能仅凭上述阈值波形认定精确物理闭合时刻或电气成因。
短暂 A 尾部重叠、B 中途开始导通、B 导通后再次断开必须分别处理，
不能把它们统一称作机械抖动。

## 软件调整

本次只补充结构化错误明细、具体窗口时间和模拟/数字对照图，
没有将部分 B 窗口改为分析通过，没有跳过该窗口后仅挑下一完整窗口。
新增提示会说明低段是否保持到窗口末尾，并区分中途开始与中途断开。
相关 91 项离线测试通过。

诊断报告相对测试软件目录：

`measurements/reports/latency/firmware_2A1C5EA9A07E/K22/medium/trial_011/scan_diagnostics/diagnostic_002/report.html`

下一步如支持 B 中途导通，应建立独立起点区间、后续持续性及模拟/数字一致性约束，
覆盖 A 尾部假导通、B 内部断开、错误记录与缺帧反例，再作全批回放。
不能单纯放宽“整个 B 内部必须低”的判据后宣称现场可靠。

## 后续 v5 实现与回放

已实现独立 `midwindow_b_v1` 判据，具体条件见 `SCAN_LATENCY_VALIDATION.md`。
保留首次部分 B 窗口；只接受一次内部高到低保持至尾部，
且原始模拟列有对应高低证据、随后三个 B 内部窗口完整列低。
没有用下一完整窗口替代原起点，前一 B 窗口的保守闭合参考也未缩减。

trial_011 新的窗口起点到最晚模拟起音约 3.444987 ms；
未补齐滤波和时基预算的观察包络约 3.649344 ms，仍不作达标判定。
新报告另存该记录的 `scan_validation/verification_001`，旧失败文件和诊断保持不变。

同一批 78 条记录旧版回放 `joint_replay_005` 与新版 `joint_replay_006`：

- 仅 trial_011 从拒绝变为观察可用。
- 旧有 24 条可用记录的计时间隔和观察包络数值完全不变，源哈希全部一致。
- 新版共 25 条观察可用、52 条拒绝、1 条无效跳过。
- 153 项相关离线测试通过，含中途断开、缺后续完整窗口、
  原始模拟证据不符、A 尾部假导通与错误 CSV 等反例。

这些是历史数据回放，不是冻结版本后的实际仪器成功率；
不得据此宣布全键最坏延迟、现场可靠性或比赛验收已经完成。
