user-lqt/gowin-fpga-instrument-138k/testing/docs/K22_CONTACT_TRANSIENT_REVIEW.md

# K22 第八次首次接触复核

## 结论

对已有 trial_008 两路示波器原始数据及 logic_168 数字 CSV 进行离线复核，
未连接仪器、重新采集或修改 RTL、延迟验收判据。原失败结果不变。

原始列电压在 A 行有效期间缓慢下降，经过阈值附近时可见电压波动；
逻辑分析仪在相同局部出现多个短跳变。
证据支持阈值穿越瞬态的解释，但不能确定缓慢下降的电气成因，
也不能单凭这次记录认定真实触点抖动或接线错误。

## 直接证据

以下时间以首次数字主列脉冲映射到示波器后的起点为零，
不是 B 触点物理闭合时间。

- 首次主列脉冲前六个短跳变全部位于 A 行低有效窗口。
- 当前规则实际拒绝其中三个，而非拒绝所有短跳变。
- 后续 307 个完整共同列脉冲拟合最大残差 0.4706 µs。
- 分别跳过最初 1、3、10 个主脉冲后拟合，参考点变化约 0.0035 µs。
  该变化只是拟合敏感性，不是绝对同步误差预算。
- 原有 0.55 µs 形态学填补得到的首次示波器脉冲起点，
  比首次数字主列脉冲早约 3.4134 µs。
- 原始模拟电压局部使用 1.2/1.5/1.8 V 阈值，首次低于阈值位置分别为
  +0.2566/-3.4134/-5.3634 µs。不能将其中任意一个视为精确物理闭合点。
- 第一个 B 扫描窗口约为 +15.6647 至 +41.3295 µs，内部列全高。
- 下一 B 扫描窗口约为 +215.5226 至 +241.1874 µs，内部列全低。
- 再下一 B 扫描窗口约为 +415.4226 至 +441.0034 µs，内部列全低。
- 原始文件、元数据及关联清单分析前后 SHA256 一致。

局部 B 内部状态检查使用窗口两端各 2 µs 排除带，仅作诊断；
未据此计算新延迟、覆盖旧报告或增加可用测量次数。

## 报告位置

相对于测试软件目录：

`measurements/reports/latency/firmware_2A1C5EA9A07E/K22/medium/trial_008/contact_comparison/comparison_002/report.html`

同目录有原始电压与数字行列对照图 `contact_comparison.png` 及机器可读 `analysis.json`。
图是保存的原始采样点绘制，不是示波器原屏，也未生成或补画波形。

## 对软件改进的约束

当前“只按主列边界距离排除短跳变”模型不能覆盖本例初始 A 窗口内的阈值穿越过程。
下一版需要研究独立行窗口约束下的接触瞬态分类，
不能简单增加排除宽度，也不能把 B 内部跳变、部分导通或跨帧异常一起忽略。

后续脉冲拟合明确排除了首次接触，只适合本次诊断，不可直接替代全边沿验收，
否则可能掩盖首次接触错误、漏帧或错配。
模型改进必须同时验证正常按压与错位、缺行、B 内部跳变等反例，
并回放保留的全批记录；最后仍需冻结版本后的真实仪器验证。

K22 已有三条可用的联合观察记录，无须仅为凑三次而补测。
这些观察记录不是全键最坏延迟或最终小于 5 ms 的验收证明。

## 后续 v4 实现

在保留上述诊断和失败报告的前提下，软件已实现有独立行窗口约束的
`initial_a_interval_v1` 分类。首次下降沿不再作为精确同步点，
但须满足同一 A 独占窗口的模拟、数字证据；首次上升沿与后续完整边沿仍全部参与同步。
紧接着的 B 内部必须列高，其它窗口异常不能套用此分类。

trial_008 新分析得到 B 扫描窗口到最晚模拟起音约 3.430355 ms，
未补齐预算观察包络约 3.634735 ms，仍不作小于 5 ms 的达标判定。
新报告另存于该记录的 `scan_validation/verification_xxx`，旧失败文件未改。
全量回放仅本条记录状态改变，原有可用记录数值不变。
