user-lqt/gowin-fpga-instrument-138k/testing/docs/LATENCY_FIELD_READINESS.md

# 延迟工具现场准备状态

## 当前结论

当前不是经过现场稳定性验收的最终版本。离线测试通过不能证明仪器、探头、
数字输入门限、接触瞬态、操作时序或现场连接始终可靠。
暂停以“继续补测直到通过”为排障方法，不故意慢按以筛选通过结果。

本次未改变毛刺容许宽度、边界排除带、同步残差或 B 持续导通规则。
没有连接仪器、重新采集或修改固件；原始文件及失败证据保留。

## 本轮全量回放

相对软件目录的审计输出：

`measurements/reports/evidence/joint_replay_003/summary.md`

同目录 `audit.json` 含全部记录、原始文件哈希、模型源码哈希及错误分类。
`records.json` 为逐条落盘检查点，批处理被中断时不丢失此前结果。

共有 76 个联合关联记录：

- 75 条完整记录：23 条在当前模型下分析可用，52 条拒绝。
- 1 条已判无效的记录跳过，不恢复、不充数。

拒绝原因包括缺失完整 A/B 行、短列脉冲及部分导通、按下前证据不足、
启动前导段异常、行短跳变、两仪器对齐不符。
这是旧记录的回放统计，不是新软件现场采集成功率；旧记录中也包含历史接线或采集条件不符的情况，
不能把 52 条都归因于软件，也不能把它们默认为已经解决。

## K22 本次问题

trial_008 数字列在首个主列脉冲前有六个短低脉冲。
按当前实际列边界规则，其中三个不能解释，距首个主列脉冲约 3.375～2.167 µs。
其余短脉冲在边界排除范围内；完整记录数千个 A/B 短跳变总数不是违规数。
数字记录不足以单独区分真实短暂导通、门限穿越或测量问题，不据此认定接线错误。

新诊断保留具体事件的开始时间、低宽、最近主扫描边界距离和局部未滤波数字图。
trial_008 仍为分析不可用，不改算为通过。

以上为旧模型及初始诊断的状态。后续 v4 更新采用独立 A 窗口区间模型，
trial_008 已获得新的观察可用报告，仍不是验收通过；旧失败诊断保留不改。
具体条件见 `SCAN_LATENCY_VALIDATION.md` 的“首次 A 窗口接触瞬态”。

v4 全批回放位于 `measurements/reports/evidence/joint_replay_004`：
同样 76 条关联记录，24 条观察可用、51 条拒绝、1 条无效跳过。
仅 K22 trial_008 状态改变；原有 23 条可用记录的计时间隔与观察包络数值完全一致，
全部对应源文件哈希与旧回放一致。该结果仍不是前瞻性现场成功率。
新增 A 区间约束及反例测试后，相关离线测试共 140 项通过。

后续 v5 另支持首次 B 窗口中途开始导通，不允许内部重新断开，
要求独立原始模拟高低证据及随后三个完整 B 窗口。
同批 78 条记录在 v4/v5 的对照回放为 `joint_replay_005` / `joint_replay_006`：
仅 K22 trial_011 新增观察可用；旧 24 条可用记录数值不变、源哈希一致。
v5 共 25 条观察可用、52 条拒绝、1 条无效跳过，相关 153 项测试通过。
起点未挪到下一帧、保守扫描参考未缩减；这不代表现场验证完成。

K22 已有三条可用联合观察记录，无需再为每键三条目标继续采集：

| 记录 | B 窗口到最晚起音 ms | 未补齐预算的观察包络 ms |
| --- | --- | --- |
| trial_003 | 3.435006 | 3.639641 |
| trial_006 | 3.424966 | 3.629326 |
| trial_007 | 3.447175 | 3.652398 |

报告位于：

`measurements/reports/latency/firmware_2A1C5EA9A07E/K22/medium/trial_xxx/scan_validation/verification_xxx/report.html`

这些是条件性观察结果，不是全键最坏延迟证明或最终误差预算完成后的验收结论。
成功和失败记录必须一起保留，不能用仅挑成功结果证明系统在所有按压下均满足要求。

## 软件已完成

- 分离原始保存、分析可用和达标判定。
- 联合 B 定位不再依赖五个单触点脉冲。
- 全量原始记录离线回放、错误归类及源文件哈希保护。
- 实际拒绝事件与完整记录总数分开显示，错误可定位到具体数字事件。
- 联合、仅示波器口径分开计数；重复分析不增加测量次数。
- 125 项离线测试通过，含原始损坏、缺行、错位、短跳变及报告保留。

## 现场版本的放行条件

以下仍需真实仪器端到端验证，不能用增加合成测试替代：

1. 固定烧录文件、软件版本、仪器接线和参数，不在现场临时放宽判据。
2. 在同一冻结版本上验证代表键及正常不同按压速度，不为通过而改变按法。
3. 完整走通开始采集、提示按键、停止、下载、报告和重启后继续统计。
4. 验证未连接、触发超时、采集中断、分析不适用时不会显示“通过”或丢失原始文件。
5. 固定最终起点口径和有依据的误差预算；报告明确 B 扫描窗口不是物理闭合瞬间。
6. 验证范围及失败样本均记录，未覆盖情况不宣称已保证。

## 现场出现异常时

- 不连续重按、不重复下载同一 STOP 波形来充数，不现场临时改阈值获得通过。
- 先保留原屏、两路原始数据、完整数字 CSV、关联清单和失败诊断。
- 按异常类别处理连接/采集问题或分析不适用，不把“无法分析”说成“延迟超标”。
- 预先归档的可复核报告和原始数据可以作为补充证据，但不能冒充本次现场实测，
  也不能替代评委要求的现场验证。
- 若实时分析不可用，应如实说明并按现场允许的方法验证，不能承诺已有离线报告必然替代现场测试。
