user-lqt/gowin-fpga-instrument-138k/testing/docs/ROW_SIGNAL_PULLUP_REVIEW.md

# 行信号测量异常：核查与候选修正

本说明用于交接给工程整合任务。当前仅完成离线核查、候选约束制备与理想数字仿真；
未改生产工程、未重新布局布线、未生成新固件、未烧录，也未重新启动仪器采集。
不能据此宣布延迟小于 5 ms 或比赛验收通过。

## 1. 实测证据

测试软件目录：`C:\Users\lenovo\Desktop\高云音乐\测试软件`。
本次诊断按用户确认的接线记录为 CH1=A 行、CH2=B 行；未独立验证物理接点。

| 记录 | 条件 | 结果 |
| --- | --- | --- |
| `measurements/raw/logic/row_scope_001` | 未按琴键 | CH1 -0.44～0.20 V；CH2 -0.20～0.28 V，未观察到完整高低电平 |
| `measurements/raw/logic/row_scope_002` | 按住 K1，STOP 后下载 | 两路各 7,000,000 点，采样间隔约 1 ns，主周期约 199.87 µs |
| 同上，1.5 V 阈值 | CH1=A 行 | 主低脉冲宽度中位值约 53.831 µs |
| 同上，1.5 V 阈值 | CH2=B 行 | 主低脉冲宽度中位值约 28.507 µs |

原始数据与参数在上述目录；原屏在 `measurements/screens/logic/row_scope_编号/screen.bmp`；
中文报告、阈值统计和原始哈希在 `measurements/reports/logic/row_scope_编号/`。
采集时只下载已停止记录，未发送 RUN/SINGLE，下载后仍为 STOP。

局部模拟波形显示：A 行首次下降后，在 B 行约 25 µs 后下降时仍保持低电平，
两路随后缓慢恢复高电平。电压恢复跨越阈值附近有重复短跳变。
实测表明当前电压记录不满足软件原先的理想行模型；不能仅靠短脉冲过滤判通过。
过冲幅值属于本次探测接法下的记录，不等于无探测负载时的引脚真实幅值。

## 2. 代码和电路依据

当前核查工程：
`local_gowin/integrated_instrument/project/integrated_instrument_64/`。

启用的 CST 为 `source/constraint/instrument_24_rgb_mega138k.cst`。
`source/rtl/input/matrix_scan_8x6.v` 的行驱动是：

```verilog
assign row_out[r] = (rst_n && row_index == r[2:0]) ? 1'b0 : 1'bz;
```

即选中行拉低，未选中行高阻；当前八条行线均 `PULL_MODE=NONE`，
列线配置上拉。不能把“未选中高阻”当成“主动驱动高电平”。

本地存档 `docs/finished_hardware/local_archive/keyboard_and_expression_hardware_plan.md`
约定列线经触点接二极管阳极、二极管阴极接行线，列上拉到 3.3 V。
这仅是文档设计依据，不是实物二极管方向已核验的证明。
在该方向成立的条件下，给未选中行增加上拉具有电路上的合理性：
保持行低有效扫描，不把未选中行改成强推高。

本机安装的官方手册：
`D:\gowin eda\Gowin\Gowin_V1.9.12_x64\IDE\doc\EN\UG304-1.3.2E_Arora Ⅴ Programmable IO (GPIO) User Guide.pdf`。
印刷页 6 介绍 LVCMOS 弱上拉/弱下拉；页 8 的 3.5.4 支持 `PULL_MODE=UP`；
页 9 的 3.5.11 另有上拉强度配置。本候选只启用 UP，未另指定强度，
不假定电阻值、默认强度或实际上升时间。

## 3. 最小候选修正

仅将当前整合版本中 `row_out[0]` 至 `row_out[7]` 八条 `IO_PORT`
的 `PULL_MODE=NONE` 改为 `PULL_MODE=UP`。
其余属性、所有 `IO_LOC`、列配置、RTL、扫描周期、消抖、音频参数均保持不变。

候选全量 CST 与 manifest：
`measurements/reports/logic/row_pullup_review/candidate_001/`。
源 CST SHA256：
`54bb8c6078f5764715fd6232f5ed370fc415f838b29fb9101472c25567e6a8fc`。
候选 CST SHA256：
`2c2ef92bf1ff2b66a2ee4bbdbfbd2629b66e39d35058af5dae47660cafa71f59`。

**不要拿这份完整候选 CST 覆盖更新后的整合工程。**
若整合任务已更新其他约束，应只应用这八项行上拉差异，并重新检查差异。
`tools/prepare_row_pullup_candidate.py` 会核对八条行球位、3.3 V 电平属性，
只在新目录制备候选并保存哈希，不修改源文件，不覆盖已有候选。

## 4. 已完成的离线验证及边界

- 候选制备脚本两项测试通过：只改八项上拉、保持源文件和换行不变，
  引脚异常/电压异常/属性异常时拒绝生成，已有候选不覆盖。
- `tools/tb_row_pullup_candidate.v` 使用真实扫描 RTL、ROW_CYCLES=307，
  以数字 pullup 和文档约定的理想二极管矩阵建模。
- 107 组稳定接触组合通过：全释放、全闭合、48 个单触点、24 个双触点键、
  32 组随机组合和再次释放。每个扫描时刻一行低、其余七行有确定高电平，
  扫描发布的 48 位接触状态与设置一致。
- 此仿真不模拟实际二极管压降、GPIO 上拉电阻、接线电容、探测负载、
  上升时间或模拟噪声；不证明边沿满足当前软件误差模型或键盘动态行为。

## 5. 整合和上板复测顺序

1. 整合任务确认当前生产版本与矩阵电路适用该修正后，仅合入八项行上拉，
   保持低有效/未选中三态策略，不改引脚、消抖和音频。
2. 重新综合、布局布线并确认实际物理 I/O 属性和时序报告，保存新固件哈希；
   老 `.fs` 不会因修改 CST 自动更新。未经用户确认不烧录。
3. 烧录确认后的新版本，先保持本次 A/B 行示波器接法，分别采集未按键、
   K1 按住两种状态，核查主周期、低宽、恢复边沿和 A/B 重叠。
   这些是新的状态对照，不覆盖 `row_scope_001/002`。
4. 若未选中行稳定恢复高电平，再核查多键扫描及触点行为；
   若边沿仍过慢或负载影响明显，先复核实际电路与探测负载，
   不直接用预期上拉电阻值或增大软件容差来放行。
5. 信号可解释后再恢复联合接线：示波器 CH1=列、CH2=DAC 模拟 L，
   逻辑分析仪 D0=A、D1=B、D2=列，所有地只接公共 GND。
6. 重新核查软件扫描模型。当前模型的固定低宽、无重叠与同步残差约束，
   需要由新实测确认；不能承诺启用上拉后不修改模型就必然通过。
7. 重新进行同次按键联合采集，再计算扫描余量和模拟起音；保留阈值、
   时钟误差及其他预算，不把固定理论 200 µs 当作无条件最大扫描间隙。

## 6. 可直接发给整合任务

请先阅读本说明和 `row_scope_002` 的中文报告。
在确认矩阵二极管方向与器件属性适用后，为当前实际使用的工程制备
“八条 row_out 行线 PULL_MODE NONE→UP”的隔离构建。
只改这八项，不改引脚、不把未选中行强推高、不改扫描/消抖/音频。
不要用旧候选全量覆盖较新的 CST，保留源版本及哈希并检查实际物理 I/O 属性。
离线理想矩阵仿真已通过，但实际边沿、动态多键和最终延迟仍需上板复核。
不要自动烧录或宣称达到 5 ms。
