user-lqt/gowin-fpga-instrument-138k/testing/docs/延迟分析与确定性说明.md

# 延迟分析与确定性说明

## 软件更新

分析模型：`partial_b_v2`。适用于相邻 A/B 行、固定八行扫描的列信号与 DAC 模拟音频记录。

旧模型把超过 10 µs 的每个列低脉冲起点当成 A 行相位：

- B 行中途出现独立部分脉冲时，会误报扫描相位异常。
- 不超过 10 µs 的部分脉冲被漏掉，可能错误地使用下一帧完整 B 脉冲，使结果偏小。

新模型保留首个长扫描脉冲之后超过 1 µs 的低脉冲。仅当一个非 A 相位脉冲位于首次完整 B 脉冲的前一帧 B 窗口内、结束时间符合双触点脉宽、后续扫描及双触点脉宽连续稳定时，才识别为部分 B 脉冲。

识别成功后，以更早的部分脉冲首次越过 1.5 V 的位置作为 B 参考，不能丢弃该脉冲再从下一完整 B 扫描计时。多个额外脉冲、错误行位置、错误结束位置、A 扫描缺帧、后续 B 不稳定等仍会拒绝分析。

限制：约 0.55 µs 的毛刺填补、1 µs 保留门限及 1.5 V 电平阈值仍会影响检测。更短导通不在本模型证明范围；2 µs 相位余量不是已校准的全系统误差预算。部分脉冲识别符合模型，不等于直接测得真实物理闭合，也不证明机械触点没有抖动。

软件没有改变音频阈值、重采样方法、固件、示波器设置或原始数据。已打开的软件需关闭重开，以加载新版分析模块。

## 本次 K1 四次离线复核

钢琴音色，正常单次按压。音量 127、音效关闭是操作要求，用户未另外逐项确认；力度没有独立测量。固件版本为用户报告，未从 FPGA 读回。

| 原始记录 | 部分 B 脉冲 | B 参考到模拟起音 | 含方法敏感性及条件性扫描窗口的包络最大值 |
|---|---|---:|---:|
| trial_001 | 7.67 µs | 3.57236 ms | 3.81252 ms |
| trial_002 | 未检出符合模型的独立部分脉冲 | 3.56760 ms | 3.78952 ms |
| trial_003 | 17.09 µs | 3.58056 ms | 3.81162 ms |
| trial_004 | 未检出符合模型的独立部分脉冲 | 3.57009 ms | 3.81207 ms |

第 1 次此前报告约 3.39 ms，因旧模型漏掉 7.67 µs 部分脉冲，现更正为约 3.57 ms。第 3 次此前因部分脉冲不能拟合被标记待复核，现满足新版受约束模型并可分析。历史条件记录及错误文件保留，当前结果以 `evidence/review.json` 的模型版本和结果为准。

四次当前主结果范围约 3.568～3.581 ms，差约 0.013 ms。这是四次 K1 记录的描述，不是全键最坏延迟或零抖动证明。上述最大值均为条件性分析包络，不是严格计量上界。

报告相对位置：`measurements/reports/latency/image_6EDA1725FD4F/K01/medium/trial_NNN/evidence/report.html`。

## 固件与源码核查范围

用户已将候选工程移到 `C:\Users\lenovo\Desktop\FPGA\FPGA_Instrument_20261031`。历史记录中的原烧录文件路径不重写。

对应固件 SHA256：`6EDA1725FD4F5DA1ACD33EACE5C261872AF24064203C493C64E98BDA5BE576A2`。

以下源码位置均相对于该工程的 `project/integrated_instrument_64/source/`，实际位流采用 64 声部顶层。核查是读取，不修改 RTL。

- `project/instrument_64_top.v`：实例化 64 声部。
- `project/instrument_24_rgb_top.v`：`ROW_CYCLES=307`、按下 `DEBOUNCE_FRAMES=15`、释放 64 帧、事件间隔 256 个音频时钟。
- `rtl/input/matrix_scan_8x6.v`：八行扫描，行末读取同步后的列，最后一行结束才提交整帧 `contact_raw` 和 `scan_valid`。
- `rtl/input/keyboard_24_dual.v`：连续帧消抖；相反采样会清零消抖计数；力度映射和按键事件均有串行调度。
- `rtl/system/sample_scheduler.v`：音频采样节拍为音频时钟除以 256。
- `rtl/audio_core/audio_core.v`：有限事件 FIFO，每个采样节拍最多消费一个事件；64 声部配置的输出有效标志延迟常量为 `64+168+4=236` 个音频时钟。此常量仅描述核心内部有效标志流水线，不能当作完整 NOTE_ON 到 DAC 延迟。
- `rtl/system/i2s_tx_pcm5102a.v`：每个立体声帧统一锁存两声道样本。

注意顶层文件开头仍有旧的“8 ms press debounce”注释；实际参数为 15 帧，应以参数和行为为准。此任务未改该注释或 RTL。

## 延迟是否确定、可预测

结论：数字链路在相同输入时钟序列、初始状态、参数、队列负载下具有确定行为；端到端模拟起音延迟不是每次恒定不变的数字。可以分段建模，在明确条件下分析范围，但目前没有完成全工况最坏上界验证。

1. 扫描相位：同一触点每帧读取一次，异步闭合到首次有效读取有接近一帧的相位等待，实测一帧约 199.87 µs。不能将此一帧当作整机的全部附加延迟。
2. 整帧提交：每行结果直到第八行结束才进入消抖逻辑，各 B 行位置不同，等待不同。K1 的 B 为第 2 行，采样后还需约六行时间，约 149.9 µs，另有少量同步及寄存器时钟。
3. 连续帧消抖：无抖动时，从第一次提交有效采样到第 15 次提交间隔为 14 帧，约 2.798 ms；再加首次扫描等待和整帧提交。K1 在 A 已合格且 B 稳定等条件下，仅“B 稳定闭合到消抖合格”粗略约 2.948～3.148 ms，尚未计事件、合成、I2S、DAC 和模拟阈值。不是统一精确 3 ms。若采样到抖动，计数会重置，延迟可增大；不限制抖动持续时间就不能给出有限物理起点上界。
4. 事件调度：力度映射、按键事件轮询、多键事件和远端事件合流、音频 FIFO 的既有积压均可增加等待；FIFO 溢出更不是“固定额外延迟”，而是异常工况。
5. 音频采样：约 48 kHz，即约 20.833 µs 一个样本；核心分时计算、I2S 锁存和 DAC 转换继续贡献延迟。固定有效标志流水线不等于触点到可听声音的完整周期数。
6. 模拟起音：跨越 10/15/20 mV 的时间还受音高、力度、音色、包络、音量、滤波和噪声影响。不能把一次钢琴 K1 结果推广到所有音色和按键。

适合技术报告的表述：

> 系统采用时钟驱动的硬件扫描、连续帧消抖和实时合成链路，数字处理具有确定的状态转移与调度规则。当前 K1 钢琴四次记录在所述条件性测量模型下约为 3.57～3.58 ms；计入方法敏感性及扫描闭合窗口后约不超过 3.82 ms。该结果不构成全键全负载最坏上界，也不证明物理触点到模拟输出延迟绝对无抖动。

要证明更强的结论，还需固定起点口径、同步行列证据、时基误差预算，以及全键、多音色、多力度、并发和抖动条件覆盖。无需为此先改动已经烧录的固件。
