user-lqt/gowin-fpga-instrument-138k/testing/measurements/reports/lrck/lrck_003_video_test/periods.csv

上升沿相对触发时间（s） | 周期（µs）
-0.00104840150015985 | 20.82659791734
-0.00102757490224251 | 20.8470229152975
-0.0010067278793272124 | 20.8205729179425
-0.00098590730640927 | 20.8419979158
-0.0009650653084934699 | 20.82842291715751
-0.0009442368855763125 | 20.831172916882505
-0.0009234057126594299 | 20.84178124915501
-0.000902563931410275 | 20.821789584487497
-0.0008817421418257875 | 20.845622915437488
-0.0008608965189103499 | 20.824122917587502
-0.0008400723959927624 | 20.836247916374997
-0.0008192361480763874 | 20.835997916400014
-0.0007984001501599874 | 20.823997917600007
-0.0007775761522423874 | 20.848222915177434
-0.00075672792932721 | 20.820522917947557
-0.0007359074064092624 | 20.840272915972534
-0.0007150671334932899 | 20.830997916899996
-0.0006942361355763899 | 20.82879791711999
-0.0006734073376592699 | 20.84479791551996
-0.0006525625397437499 | 20.820581251274984
-0.000631741958492475 | 20.843789582287563
-0.0006108981689101874 | 20.826422917357487
-0.00059007174599283 | 20.83379791661998
-0.00056923794807621 | 20.83898124943497
-0.000548398966826775 | 20.82278958438755
-0.0005275761772423874 | 20.84699791530002
-0.0005067291793270874 | 20.82242291775755
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
