user-lqt/gowin-fpga-instrument-138k/testing/measurements/reports/polyphony/video test/all_64_002_video_test/frequency_errors.csv

声部 | 开启状态 | 设计频率（Hz） | 时钟拟合后的预期频率（Hz） | 实测频率（Hz） | 谱峰幅度（V） | 相对幅度（dB） | 谱峰信噪比估计（dB） | 检出谱峰 | 目标检查 | 频率偏差（Hz）
1 | 开启 | 752.9296875 | 752.9334521484375 | 753.4027099609375 | 0.01851688053891736 | -0.4442572438771928 | 61.92567805620133 | 是 | 符合 | 0.4730224609375
2 | 开启 | 846.6796875 | 846.6839208984376 | 846.3859558105469 | 0.01937290835537936 | -0.05171725835841682 | 62.31821804172011 | 是 | 符合 | -0.293731689453125
3 | 开启 | 940.4296875 | 940.4343896484376 | 940.5612945556641 | 0.019883033167903352 | 0.1740390009618742 | 62.54397430104041 | 是 | 符合 | 0.1316070556640625
4 | 开启 | 1034.1796875 | 1034.1848583984374 | 1034.7366333007812 | 0.01808703046556686 | -0.6482683365800969 | 61.72166696349842 | 是 | 符合 | 0.55694580078125
5 | 开启 | 1127.9296875 | 1127.9353271484376 | 1127.7198791503906 | 0.019696275156918686 | 0.09206831575459645 | 62.462003615833126 | 是 | 符合 | -0.209808349609375
6 | 开启 | 1221.6796875 | 1221.6857958984376 | 1221.8952178955078 | 0.01974912139133082 | 0.11534184699956812 | 62.485277147078094 | 是 | 符合 | 0.2155303955078125
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
