user-lqt/gowin-fpga-instrument-138k/testing/measurements/reports/polyphony/video test/all_64_002_video_test/peaks.csv

voice | enabled | nominal_hz | predicted_hz | measured_hz | amplitude_peak | relative_db | snr_db | present | match
1 | True | 752.9296875 | 752.9334521484375 | 753.4027099609375 | 0.01851688053891736 | -0.4442572438771928 | 61.92567805620133 | True | True
2 | True | 846.6796875 | 846.6839208984376 | 846.3859558105469 | 0.01937290835537936 | -0.05171725835841682 | 62.31821804172011 | True | True
3 | True | 940.4296875 | 940.4343896484376 | 940.5612945556641 | 0.019883033167903352 | 0.1740390009618742 | 62.54397430104041 | True | True
4 | True | 1034.1796875 | 1034.1848583984374 | 1034.7366333007812 | 0.01808703046556686 | -0.6482683365800969 | 61.72166696349842 | True | True
5 | True | 1127.9296875 | 1127.9353271484376 | 1127.7198791503906 | 0.019696275156918686 | 0.09206831575459645 | 62.462003615833126 | True | True
6 | True | 1221.6796875 | 1221.6857958984376 | 1221.8952178955078 | 0.01974912139133082 | 0.11534184699956812 | 62.485277147078094 | True | True
7 | True | 1315.4296875 | 1315.4362646484376 | 1314.8784637451172 | 0.018147223714927125 | -0.6194098757853034 | 61.750525424293215 | True | True
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
