user-lqt/gowin-fpga-instrument-138k/testing/measurements/reports/polyphony/video test/mute64_64_001_video_test/frequency_errors.csv

声部 | 开启状态 | 设计频率（Hz） | 时钟拟合后的预期频率（Hz） | 实测频率（Hz） | 谱峰幅度（V） | 相对幅度（dB） | 谱峰信噪比估计（dB） | 检出谱峰 | 目标检查 | 频率偏差（Hz）
1 | 开启 | 752.9296875 | 752.9334521484375 | 753.4027099609375 | 0.01852067974024596 | -0.430500015870495 | 61.12314647733712 | 是 | 符合 | 0.4730224609375
2 | 开启 | 846.6796875 | 846.6839208984376 | 846.3859558105469 | 0.019393122305792505 | -0.030683727207410746 | 61.522962766000205 | 是 | 符合 | -0.293731689453125
3 | 开启 | 940.4296875 | 940.4343896484376 | 940.5612945556641 | 0.019840838789121937 | 0.1675621123742812 | 61.72120860558191 | 是 | 符合 | 0.1316070556640625
4 | 开启 | 1034.1796875 | 1034.1848583984374 | 1034.7366333007812 | 0.018459202813795685 | -0.45937962572752966 | 61.094266867480094 | 是 | 符合 | 0.55694580078125
5 | 开启 | 1127.9296875 | 1127.9353271484376 | 1127.7198791503906 | 0.01971669911813485 | 0.11304572542687533 | 61.6666922186345 | 是 | 符合 | -0.209808349609375
6 | 开启 | 1221.6796875 | 1221.6857958984376 | 1221.8952178955078 | 0.019747685926860256 | 0.12668577357809113 | 61.68033226678571 | 是 | 符合 | 0.2155303955078125
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
