user-lqt/gowin-fpga-instrument-138k/testing/measurements/reports/polyphony/video test/mute64_64_001_video_test/peaks.csv

voice | enabled | nominal_hz | predicted_hz | measured_hz | amplitude_peak | relative_db | snr_db | present | match
1 | True | 752.9296875 | 752.9334521484375 | 753.4027099609375 | 0.01852067974024596 | -0.430500015870495 | 61.12314647733712 | True | True
2 | True | 846.6796875 | 846.6839208984376 | 846.3859558105469 | 0.019393122305792505 | -0.030683727207410746 | 61.522962766000205 | True | True
3 | True | 940.4296875 | 940.4343896484376 | 940.5612945556641 | 0.019840838789121937 | 0.1675621123742812 | 61.72120860558191 | True | True
4 | True | 1034.1796875 | 1034.1848583984374 | 1034.7366333007812 | 0.018459202813795685 | -0.45937962572752966 | 61.094266867480094 | True | True
5 | True | 1127.9296875 | 1127.9353271484376 | 1127.7198791503906 | 0.01971669911813485 | 0.11304572542687533 | 61.6666922186345 | True | True
6 | True | 1221.6796875 | 1221.6857958984376 | 1221.8952178955078 | 0.019747685926860256 | 0.12668577357809113 | 61.68033226678571 | True | True
7 | True | 1315.4296875 | 1315.4362646484376 | 1314.8784637451172 | 0.0181806616659884 | -0.5914447582123166 | 60.96220173499531 | True | True
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
