user-lqt/gowin-fpga-instrument-138k/final/verification/acceptance_gui_chinese.png

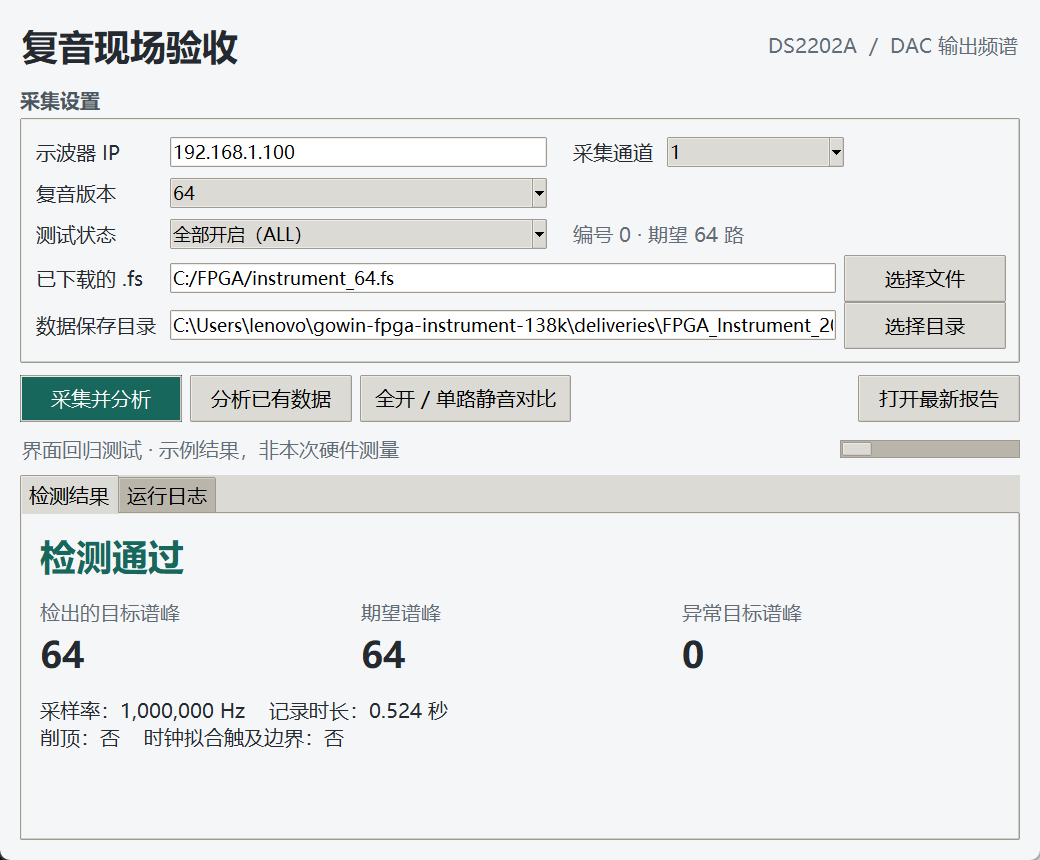
final/verification/acceptance_gui_chinese.png
