user-lqt/gowin-fpga-instrument-138k/testing/measurements/screens/lrck/lrck_002/screen.bmp

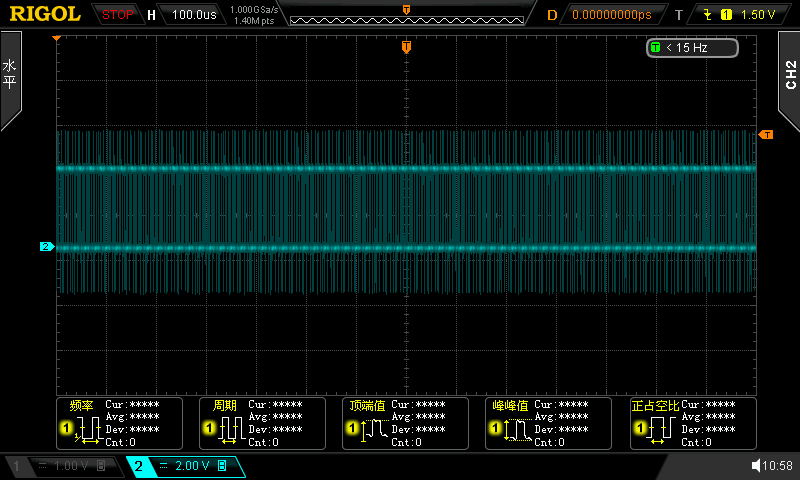
testing/measurements/screens/lrck/lrck_002/screen.bmp
