user-lqt/gowin-fpga-instrument-138k/testing/measurements/screens/lrck/lrck_003_video_test/screen.bmp

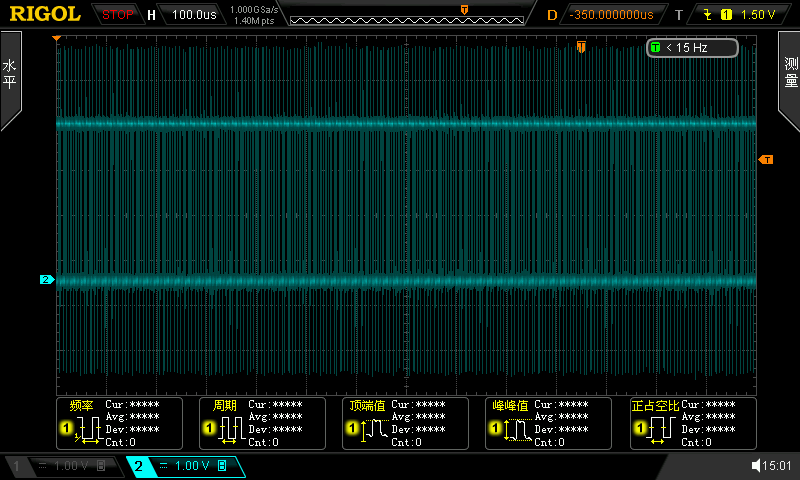
testing/measurements/screens/lrck/lrck_003_video_test/screen.bmp
