user-lqt/gowin-fpga-instrument-138k/testing/measurements/screens/polyphony/all_64_001/screen.bmp

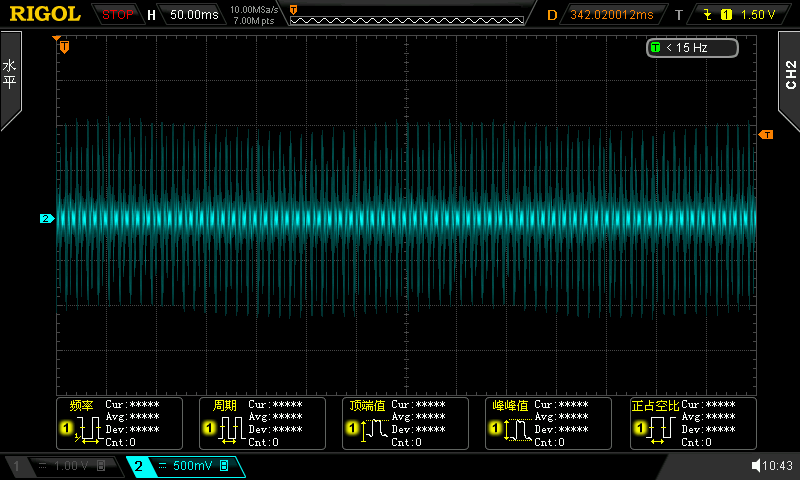
testing/measurements/screens/polyphony/all_64_001/screen.bmp
