user-lqt/gowin-fpga-instrument-138k/testing/measurements/screens/polyphony/group02_64_001/screen.bmp

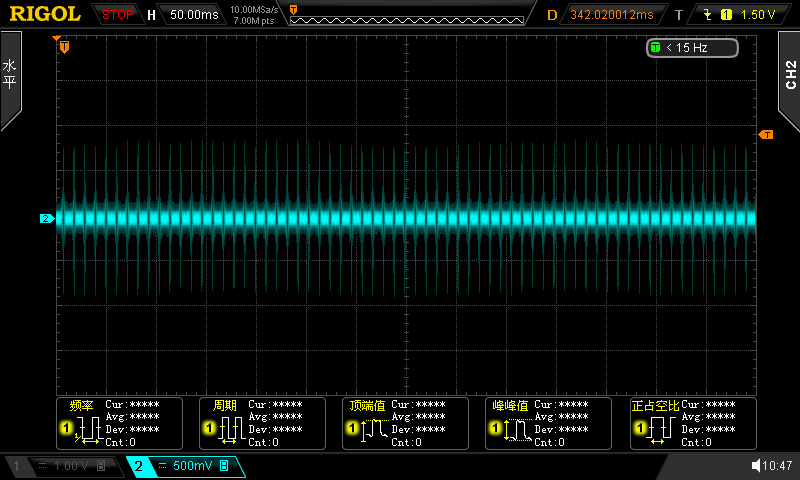
testing/measurements/screens/polyphony/group02_64_001/screen.bmp
