user-lqt/gowin-fpga-instrument-138k/testing/measurements/screens/polyphony/group04_64_001/screen.bmp

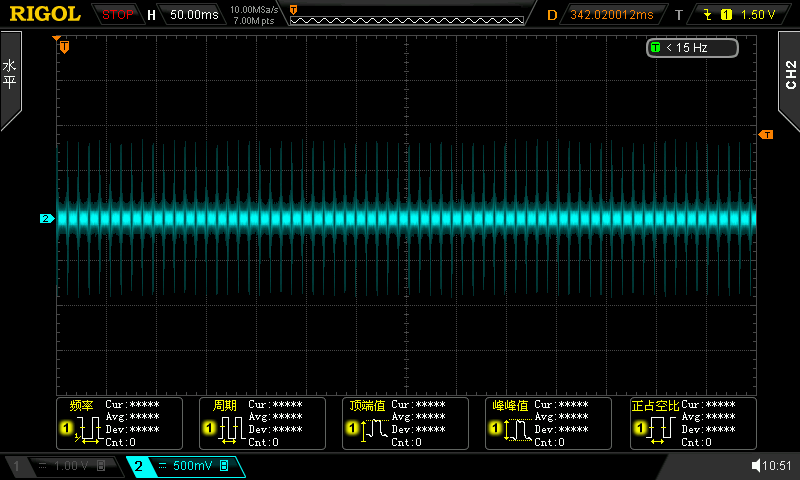
testing/measurements/screens/polyphony/group04_64_001/screen.bmp
