user-lqt/gowin-fpga-instrument-138k/testing/measurements/screens/polyphony/mute18_64_001/screen.bmp

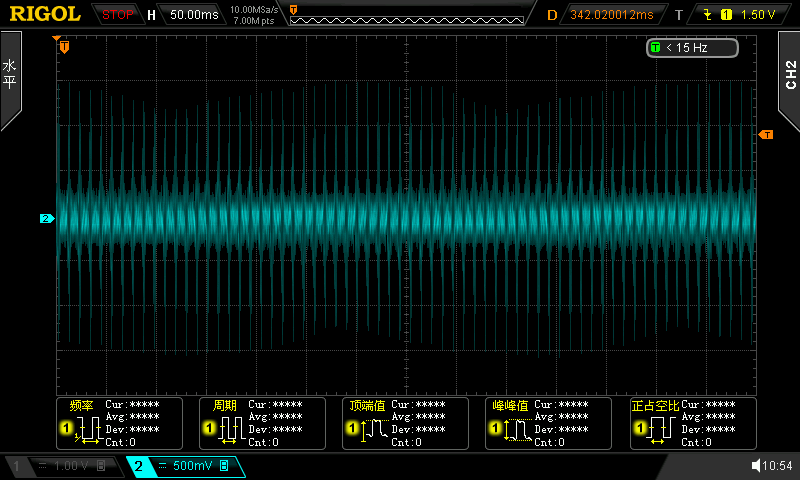
testing/measurements/screens/polyphony/mute18_64_001/screen.bmp
