user-lqt/gowin-fpga-instrument-138k/testing/measurements/screens/polyphony/video test/all_64_002_video_test/screen.bmp

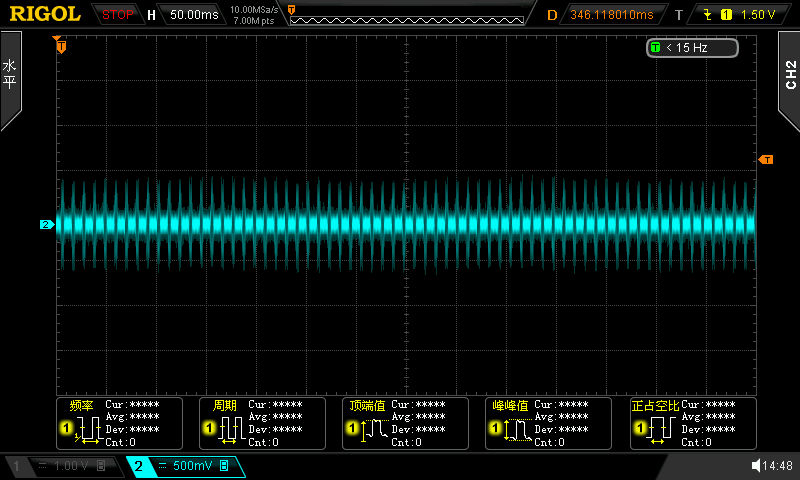
testing/measurements/screens/polyphony/video test/all_64_002_video_test/screen.bmp
