user-lqt/gowin-fpga-instrument-138k/final/project/integrated_instrument_64/source/rtl/audio_core/pitch_fraction_rom.v

// Generated Q16 semitone fractions; regenerate with generate_pitch_table.py.
module pitch_fraction_rom(input wire [7:0] fraction,
    output reg [16:0] ratio, reciprocal);
    always @* begin
        case(fraction)
            8'd0: begin ratio=17'd65536; reciprocal=17'd65536; end
            8'd1: begin ratio=17'd65551; reciprocal=17'd65521; end
            8'd2: begin ratio=17'd65566; reciprocal=17'd65506; end
            8'd3: begin ratio=17'd65580; reciprocal=17'd65492; end
            8'd4: begin ratio=17'd65595; reciprocal=17'd65477; end
            8'd5: begin ratio=17'd65610; reciprocal=17'd65462; end
            8'd6: begin ratio=17'd65625; reciprocal=17'd65447; end
            8'd7: begin ratio=17'd65640; reciprocal=17'd65433; end
            8'd8: begin ratio=17'd65654; reciprocal=17'd65418; end
            8'd9: begin ratio=17'd65669; reciprocal=17'd65403; end
            8'd10: begin ratio=17'd65684; reciprocal=17'd65388; end
            8'd11: begin ratio=17'd65699; reciprocal=17'd65374; end
            8'd12: begin ratio=17'd65714; reciprocal=17'd65359; end
            8'd13: begin ratio=17'd65729; reciprocal=17'd65344; end
            8'd14: begin ratio=17'd65743; reciprocal=17'd65329; end
            8'd15: begin ratio=17'd65758; reciprocal=17'd65315; end
            8'd16: begin ratio=17'd65773; reciprocal=17'd65300; end
            8'd17: begin ratio=17'd65788; reciprocal=17'd65285; end
            8'd18: begin ratio=17'd65803; reciprocal=17'd65270; end
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
            8'd254: begin ratio=17'd69402; reciprocal=17'd61886; end
            8'd255: begin ratio=17'd69417; reciprocal=17'd61872; end
            default: begin ratio=65536; reciprocal=65536; end
        endcase
    end
endmodule
