user-lqt/gowin-fpga-instrument-138k/final/project/integrated_instrument_64/source/rtl/audio_core/voice.v

//=============================================================================
// voice.v —— A2 单声部封装:振荡器 + ADSR + 力度
//
//   一个 voice 对应一个独立音符。声部处于 IDLE 时 audio=0；
//   NOTE_ON 重新触发相位和包络，NOTE_OFF 进入 Release，不硬切。
//=============================================================================
`include "event_defs.vh"

module voice #(
    parameter integer ENABLE_TIMBRES = 0,
    parameter integer ENABLE_ACCEPTANCE = 0,
    parameter integer DYNAMIC_PITCH = 0,
    parameter integer EXTERNAL_PITCH = 0,
    parameter integer SHARED_BODY = 0,
    parameter integer SHARED_GAIN = 0,
    parameter integer SHARED_BELL = 0,
    parameter integer SHARED_OSCILLATOR = 0,
    parameter integer SHARED_STRETCH = 0,
    parameter integer SHARED_COEFFICIENTS = 0,
    parameter integer SHARED_PHASE_ADD = 0,
    parameter integer SHARED_UPPER_ADD = 0,
    parameter integer SHARED_RELEASE = 0,
    parameter integer SHARED_ENVELOPE = 0,
    parameter integer SHARED_STRING = 0,
    parameter integer SHARED_STATE_OSCILLATOR = 0,
    parameter integer SHARED_GAIN_VELOCITY = 0,
    parameter integer SHARED_GAIN_HAMMER = 0,
    parameter integer SHARED_GAIN_OUTPUT = 0,
    parameter integer BANK_PIANO = 0,
    parameter integer BANK_TIMBRE_GAIN = 0,
    parameter integer LOCAL_BODY_OUTPUT = 0,
    parameter integer LOCAL_PIANO_STATE = 0,
    parameter integer LOCAL_STRIKE_STATE = 0,
    parameter integer OSCILLATOR_LANES = 8,
    parameter integer OSCILLATOR_LANE = 0,
    parameter integer ATTACK_SAMPLES  = 480,
    parameter integer DECAY_SAMPLES   = 2400,
    parameter [15:0]  SUSTAIN_LEVEL   = 16'd45875,
    parameter integer RELEASE_SAMPLES = 4800,
    parameter integer BELL_RING_SAMPLES = 192000,
    parameter integer ENABLE_GUITAR = 1,
    parameter integer OUTPUT_BITS = 24
) (
    input  wire               clk,
    input  wire               rst_n,
    input  wire               sample_tick,
    input  wire               acceptance_mode,
    input  wire               note_on,
    input  wire               note_off,
    input  wire [6:0]         note_id,
    input  wire [7:0]         velocity,
    input  wire [1:0]         instrument,
    input  wire [31:0]        pitch_fc,
    input  wire [47:0]        pitch_period,
    input wire [15:0] shared_release_quotient,
    input wire [15:0] shared_release_modulus,
    input wire [15:0] bank_envelope_level,
    input wire [2:0] bank_envelope_stage,
    input wire bank_envelope_active,
    input  wire signed [15:0] body_wave,
    input  wire signed [15:0] string_bank_wave,
    input  wire signed [15:0] oscillator_bank_wave,
    output wire [7:0] oscillator_brightness,
    input  wire signed [15:0] bell_bank_wave,
    input wire [6:0] oscillator_cycle,
    input wire signed [15:0] oscillator_lookup,
    input wire signed [26:0] oscillator_product,
    input wire [31:0] oscillator_phase_increment,
    input wire [31:0] oscillator_updated_phase,
    output wire [31:0] oscillator_phase_operand,
    input wire signed [25:0] oscillator_updated_upper,
    output wire signed [25:0] oscillator_upper_operand,
    output wire [11:0] oscillator_address,
    output wire signed [17:0] oscillator_operand,
    output wire [7:0] oscillator_gain,
    output wire signed [15:0] body_string_wave,
    input wire [3:0] gain_step,
    input wire signed [44:0] gain_product,
    input wire signed [33:0] gain_hammer,
    output wire signed [26:0] gain_operand_a,
    output wire signed [17:0] gain_operand_b,
    output wire [15:0] gain_piano_body,
    output wire [15:0] gain_raw_wave,
    output wire [15:0] gain_raw_noise,
    output wire [15:0] gain_raw_strike,
    output wire signed [OUTPUT_BITS-1:0] audio,
    output wire               active,
    output wire [15:0]        envelope_level,
    output wire [2:0]         envelope_stage
);
    wire [31:0] fc;
    wire signed [15:0] wave;
    wire phase_load = note_on;
    wire pure_tone=ENABLE_ACCEPTANCE && acceptance_mode;

    generate if(EXTERNAL_PITCH) begin : external_pitch
        assign fc=pitch_fc;
    end else begin : local_pitch
    note_to_fc u_note_to_fc (
        .note_id (note_id),
        .fc      (fc)
    );
    end endgenerate

    wire [15:0] strike_level;
    wire [15:0] hammer_lfsr;
    wire signed [15:0] piano_body;
    assign gain_piano_body=piano_body;
    wire signed [16:0] piano_body_difference=
        $signed({wave[15],wave})-$signed({piano_body[15],piano_body});
    wire signed [16:0] next_piano_body=
        $signed({piano_body[15],piano_body})+(piano_body_difference >>> 5);
    wire piano_strike=ENABLE_TIMBRES && instrument==0;
    wire [16:0] strike_decrement=piano_strike ?
        (({1'b0,strike_level}+17'd1023)>>10) : 17'd8;
    wire [16:0] strike_difference={1'b0,strike_level}-strike_decrement;
    generate if(LOCAL_STRIKE_STATE) begin : bank_strike_state
        assign strike_level=0;
        assign hammer_lfsr=0;
    end else begin : private_strike_state
    reg [15:0] saved_strike,saved_noise;
    assign strike_level=saved_strike;
    assign hammer_lfsr=saved_noise;
    always @(posedge clk or negedge rst_n)
        if (!rst_n) begin
            saved_strike <= 0;
            saved_noise <= 16'h1;
        end else if (note_on) begin
            saved_strike <= 16'hffff;
            saved_noise <= 16'h1;
        end else if (sample_tick) begin
            saved_strike <= (piano_strike ? strike_level>16'd2 :
                strike_level>16'd8) ? strike_difference[15:0] : 16'd0;
            saved_noise <= {hammer_lfsr[14:0],
                            hammer_lfsr[15] ^ hammer_lfsr[13] ^
                            hammer_lfsr[12] ^ hammer_lfsr[10]};
        end
    end endgenerate
    generate if(LOCAL_PIANO_STATE) begin : bank_piano_state
        assign piano_body=0;
    end else begin : private_piano_state
        reg signed [15:0] saved;
        assign piano_body=saved;
        always @(posedge clk or negedge rst_n)
            if(!rst_n) saved<=0;
            else if(note_on) saved<=0;
            else if(sample_tick)
                saved<=instrument==0 && active ? next_piano_body[15:0] : 16'd0;
    end endgenerate
    wire [7:0] safe_velocity = velocity > 8'd127 ? 8'd127 : velocity;
    wire [7:0] strike_gain;
    generate if(BANK_TIMBRE_GAIN) begin : shared_strike_profile
        assign strike_gain=0;
    end else begin : private_strike_profile
        strike_profile u_strike_profile(.velocity(safe_velocity),.instrument(instrument),
            .gain(strike_gain));
    end endgenerate
    wire [15:0] transient_brightness;
    wire [8:0] brightness_piano_w = 9'd16 + {1'b0,safe_velocity[7:1]} +
        {1'b0,transient_brightness[15:9]};
    wire [8:0] brightness_other_w = 9'd32 + {1'b0,safe_velocity[7:1]};
    wire [7:0] brightness = instrument == 0 ? brightness_piano_w[7:0] :
        brightness_other_w[7:0];

    assign oscillator_brightness=brightness;
    generate if(SHARED_STATE_OSCILLATOR) begin : external_state_oscillator
        assign wave=oscillator_bank_wave;
        assign oscillator_phase_operand=0;
        assign oscillator_upper_operand=0;
        assign oscillator_address=0;
        assign oscillator_operand=0;
        assign oscillator_gain=0;
    end else begin : original_oscillator
    oscillator #(.ENABLE_TIMBRES(ENABLE_TIMBRES),.ENABLE_ACCEPTANCE(ENABLE_ACCEPTANCE),
        .SHARED_ARITHMETIC(SHARED_OSCILLATOR),
        .SHARED_STRETCH(SHARED_STRETCH),
        .SHARED_COEFFICIENTS(SHARED_COEFFICIENTS),
        .SHARED_PHASE_ADD(SHARED_PHASE_ADD),
        .SHARED_UPPER_ADD(SHARED_UPPER_ADD),
        .BANK_LANES(OSCILLATOR_LANES),.BANK_LANE(OSCILLATOR_LANE)) u_oscillator (
        .clk         (clk),
        .rst_n       (rst_n),
        .sample_tick (sample_tick),
        .acceptance_mode(pure_tone),
        .phase_load  (phase_load),
        .fc          (fc),
        .instrument  (instrument == 1 ? 2'd3 : instrument),
        .brightness  (brightness),
        .bank_cycle(oscillator_cycle),
        .bank_lookup_wave(oscillator_lookup),
        .bank_product(oscillator_product),
        .bank_phase_increment(oscillator_phase_increment),
        .bank_updated_phase(oscillator_updated_phase),
        .bank_phase_operand(oscillator_phase_operand),
        .bank_updated_upper(oscillator_updated_upper),
        .bank_upper_operand(oscillator_upper_operand),
        .bank_address(oscillator_address),
        .bank_operand(oscillator_operand),
        .bank_gain(oscillator_gain),
        .wave        (wave)
    );
    end endgenerate

    generate if(SHARED_ENVELOPE) begin : external_envelope
        assign envelope_level=bank_envelope_level;
        assign envelope_stage=bank_envelope_stage;
        assign active=bank_envelope_active;
    end else begin : private_envelope
    adsr #(
        .ENABLE_TIMBRES  (ENABLE_TIMBRES),
        .EXTERNAL_RELEASE (SHARED_RELEASE),
        .ATTACK_SAMPLES  (ATTACK_SAMPLES),
        .DECAY_SAMPLES   (DECAY_SAMPLES),
        .SUSTAIN_LEVEL   (SUSTAIN_LEVEL),
        .RELEASE_SAMPLES (RELEASE_SAMPLES),
        .BELL_RING_SAMPLES(BELL_RING_SAMPLES)
    ) u_adsr (
        .clk         (clk),
        .rst_n       (rst_n),
        .sample_tick (sample_tick),
        .note_on     (note_on),
        .note_off    (note_off),
        .instrument  (instrument),
        .velocity    (safe_velocity),
        .shared_release_quotient(shared_release_quotient),
        .shared_release_modulus(shared_release_modulus),
        .level       (envelope_level),
        .active      (active),
        .stage       (envelope_stage)
    );
    end endgenerate

    wire signed [15:0] string_wave;
    wire signed [15:0] acoustic_wave;
    assign body_string_wave=string_wave;
    generate if (ENABLE_TIMBRES && ENABLE_GUITAR) begin : guitar
        wire [47:0] period_q16;
        if(EXTERNAL_PITCH) begin : external_period
            assign period_q16=pitch_period;
        end else begin : local_period
            note_to_period u_period (.note_id(note_id), .period_q16(period_q16));
        end
        if(SHARED_STRING) begin : external_string
            assign string_wave=string_bank_wave;
        end else begin : private_string
        plucked_string #(.DYNAMIC_PITCH(DYNAMIC_PITCH)) u_string (
            .clk(clk), .rst_n(rst_n), .sample_tick(sample_tick),
            .note_on(note_on),
            .enabled((instrument == 1 || instrument == 3) && note_id >= 24),
            .fc(fc), .period_q16(period_q16),
            .velocity(safe_velocity), .wave(string_wave)
        );
        end
        if(SHARED_BODY) begin : external_body
            assign acoustic_wave=body_wave;
        end else begin : internal_body
        guitar_body u_body (
            .clk(clk), .rst_n(rst_n), .sample_tick(sample_tick),
            .note_on(note_on), .string_wave(string_wave), .wave(acoustic_wave)
        );
        end
    end else begin : no_guitar
        assign string_wave = 0;
        assign acoustic_wave = 0;
    end endgenerate
    wire signed [15:0] base_rendered_wave =
        ENABLE_TIMBRES && ENABLE_GUITAR && (instrument == 1 || instrument == 3) && note_id >= 24 ?
        acoustic_wave : wave;
    // The acoustic guitar body filter is intentionally quiet to preserve
    // headroom. Restore a useful level after filtering, with saturation so a
    // hard pluck cannot wrap into a polarity inversion.
    wire signed [19:0] guitar_boost_sum =
        $signed({{4{base_rendered_wave[15]}},base_rendered_wave}) <<< 2;
    wire signed [15:0] rendered_wave_boosted =
        guitar_boost_sum > 20'sd32767 ? 16'sh7fff :
        guitar_boost_sum < -20'sd32768 ? 16'sh8000 :
        guitar_boost_sum[15:0];
    wire signed [15:0] bell_wave;
    generate if(SHARED_BELL) begin : external_bell
        assign bell_wave=bell_bank_wave;
    end else begin : internal_bell
    bianzhong #(.DYNAMIC_PITCH(DYNAMIC_PITCH)) u_bell (
        .clk(clk), .rst_n(rst_n), .sample_tick(sample_tick),
        .note_on(note_on && ENABLE_TIMBRES && instrument == 2),
        .fc(fc), .velocity(safe_velocity), .wave(bell_wave)
    );
    end endgenerate
    wire signed [15:0] rendered_wave =
        pure_tone ? wave : ENABLE_TIMBRES && instrument == 2 ? bell_wave :
        ENABLE_TIMBRES && ENABLE_GUITAR &&
        (instrument == 1 || instrument == 3) && note_id >= 24 ?
        rendered_wave_boosted : base_rendered_wave;
    wire signed [15:0] unboosted_wave=
        pure_tone ? wave : ENABLE_TIMBRES && instrument==2 ? bell_wave : base_rendered_wave;
    assign gain_raw_wave=!pure_tone && LOCAL_BODY_OUTPUT && ENABLE_TIMBRES && ENABLE_GUITAR &&
        (instrument==1 || instrument==3) && note_id>=24 ? 16'd0 : unboosted_wave;
    assign gain_raw_noise=hammer_lfsr;
    assign gain_raw_strike=strike_level;
    wire signed [15:0] hammer_noise = $signed(hammer_lfsr);
    wire signed [33:0] hammer_product;
    wire signed [23:0] legacy_hammer_product = hammer_product[23:0];
    // Keep the filtered body contribution supportive rather than dominant;
    // the acoustic-piano attack should remain audible over the sustain.
    wire signed [17:0] piano_body_scaled = $signed(piano_body) >>> 3;
    wire signed [33:0] hammer_product_shifted = hammer_product >>> 24;
    wire signed [23:0] legacy_hammer_shifted = legacy_hammer_product >>> 18;
    wire signed [17:0] piano_hammer_scaled =
        instrument == 0 ? (ENABLE_TIMBRES ? hammer_product_shifted[17:0] :
            legacy_hammer_shifted[17:0]) : 18'sd0;
    wire signed [17:0] piano_excitation =
        $signed({{2{rendered_wave[15]}}, rendered_wave}) +
        (instrument == 0 ? piano_body_scaled : 18'sd0) +
        piano_hammer_scaled;
    wire signed [15:0] piano_wave = pure_tone ? wave : piano_excitation > 18'sd32767 ? 16'sh7fff :
        piano_excitation < -18'sd32768 ? 16'sh8000 : piano_excitation[15:0];
    generate if (ENABLE_TIMBRES) begin : serial_gain
        reg [3:0] local_cycle;
        wire [3:0] cycle=SHARED_GAIN ? gain_step : local_cycle;
        wire [15:0] transient;
        wire signed [33:0] hammer;
        wire signed [23:0] velocity_product;
        wire signed [OUTPUT_BITS-1:0] result;
        reg signed [26:0] operand_a;
        reg signed [17:0] operand_b;
        wire signed [44:0] product;
        if(SHARED_GAIN) begin : external_product
            assign product=gain_product;
        end else begin : internal_product
            assign product=operand_a*operand_b;
        end
        assign gain_operand_a=BANK_TIMBRE_GAIN ? 27'd0 : operand_a;
        assign gain_operand_b=BANK_TIMBRE_GAIN ? 18'd0 : operand_b;
        assign transient_brightness = transient;
        assign hammer_product = hammer;
        if(BANK_TIMBRE_GAIN) begin : bank_transient
            reg [6:0] brightness;
            assign transient={brightness,9'd0};
            always @(posedge clk or negedge rst_n)
                if(!rst_n) brightness<=0;
                else if(!sample_tick && cycle==2) brightness<=product[15:9];
        end else begin : private_transient
            reg [15:0] saved;
            assign transient=saved;
            always @(posedge clk or negedge rst_n)
                if(!rst_n) saved<=0;
                else if(!sample_tick && cycle==2) saved<=product[15:0];
        end
        if(SHARED_GAIN_HAMMER) begin : bank_hammer
            assign hammer=gain_hammer;
        end else begin : private_hammer
            reg signed [33:0] saved;
            assign hammer=saved;
            always @(posedge clk or negedge rst_n)
                if(!rst_n) saved<=0;
                else if(!sample_tick && cycle==3) saved<=product[33:0];
        end
        if(SHARED_GAIN_OUTPUT) begin : bank_output
            assign result=0;
        end else begin : private_output
            reg signed [OUTPUT_BITS-1:0] saved;
            assign result=saved;
            // Saturate before narrowing: master volume is applied later and
            // cannot repair a sign reversal caused by a wrapped voice sample.
            wire signed [OUTPUT_BITS-1:0] limited =
                product[44:OUTPUT_BITS+15]=={(30-OUTPUT_BITS){product[OUTPUT_BITS+15]}} ?
                    product[OUTPUT_BITS+15:16] :
                product[44] ? {1'b1,{(OUTPUT_BITS-1){1'b0}}} :
                    {1'b0,{(OUTPUT_BITS-1){1'b1}}};
            always @(posedge clk or negedge rst_n)
                if(!rst_n) saved<=0;
                else if(!sample_tick && cycle==15) saved<=limited;
        end
        if(SHARED_GAIN_VELOCITY) begin : bank_velocity
            assign velocity_product=0;
        end else begin : private_velocity
            reg signed [23:0] saved;
            assign velocity_product=saved;
            always @(posedge clk or negedge rst_n)
                if(!rst_n) saved<=0;
                else if(!sample_tick && cycle==14) saved<=product[23:0];
        end
        always @* begin
            case (cycle)
                2: begin
                    operand_a = $signed({1'b0,safe_velocity});
                    operand_b = $signed({1'b0,strike_level[15:8]});
                end
                3: begin
                    operand_a = hammer_noise;
                    operand_b = BANK_TIMBRE_GAIN ? 18'sd0 : $signed({1'b0,transient});
                end
                14: begin
                    operand_a = BANK_TIMBRE_GAIN ? unboosted_wave :
                        BANK_PIANO ? rendered_wave : piano_wave;
                    operand_b = BANK_TIMBRE_GAIN ? $signed({1'b0,safe_velocity}) :
                        $signed({1'b0,strike_gain});
                end
                default: begin
                    operand_a = $signed({velocity_product,1'b0});
                    operand_b = $signed({1'b0,envelope_level});
                end
            endcase
        end
        // Private oscillator: 13/14/15; shared oscillator: <=45/70/74.
        // Shared bank steps keep the same arithmetic at the later deadlines.
        always @(posedge clk or negedge rst_n) begin
            if (!rst_n) begin
                local_cycle <= 0;
            end else if (sample_tick) local_cycle <= 1;
            else if (cycle != 0) begin
                local_cycle <= local_cycle == 4'd15 ? 4'd0 :
                    local_cycle + 4'd1;
            end
        end
        assign audio = active ? result : {OUTPUT_BITS{1'b0}};
    end else begin : legacy_gain
        assign gain_operand_a=0;
        assign gain_operand_b=0;
        assign transient_brightness = safe_velocity * strike_level[15:8];
        assign hammer_product = hammer_noise * $signed({1'b0,safe_velocity}) *
            $signed({1'b0,strike_level[15:8]});
        wire signed [8:0] velocity_ext = $signed({1'b0,safe_velocity});
        wire signed [31:0] wave_velocity = piano_wave * velocity_ext;
        wire signed [32:0] velocity_scaled = {wave_velocity,1'b0};
        wire signed [49:0] envelope_product =
            velocity_scaled * $signed({1'b0,envelope_level});
        assign audio = active ? (envelope_product >>> 16) : 24'sd0;
    end endgenerate

endmodule

// Lightweight velocity curves; reuse the existing scheduled gain multiplier.
module strike_profile (
    input wire [7:0] velocity,
    input wire [1:0] instrument,
    output wire [7:0] gain
);
    wire [7:0] v=velocity>127 ? 8'd127 : velocity;
    wire [7:0] top_segment=v-8'd96;
    wire [7:0] middle_segment=v-8'd64;
    // Preserve soft attacks without the old extra -6 dB attenuation.
    // Medium strikes have useful level, with additional headroom for forte.
    wire [7:0] piano_gain=v<=64 ? v :
        v<=96 ? 8'd64+middle_segment+(middle_segment>>1) :
        8'd112+top_segment+(top_segment>>1)+(top_segment>>2);
    // Restore guitar level after body filtering without further waveform
    // clipping. Hard plucks gain more than soft plucks; tuning is unchanged.
    // Preserve forte transient headroom in the existing 24-bit voice path.
    wire [7:0] guitar_upper_gain=8'd112+middle_segment+(middle_segment>>1);
    wire [7:0] guitar_gain=v<=64 ? v+(v>>1)+(v>>2) :
        guitar_upper_gain>205 ? 8'd205 : guitar_upper_gain;
    assign gain=v==0 ? 0 : instrument==0 ?
        (piano_gain==0 ? 8'd1 : piano_gain) :
        (instrument==1 || instrument==3) ? guitar_gain : v;
endmodule

// A harder strike excites upper bell modes more strongly, not at new pitches.
module bell_strike_level (
    input wire [7:0] velocity,
    input wire [2:0] mode,
    output wire [23:0] level
);
    wire [7:0] v=velocity>127 ? 8'd127 : velocity;
    wire [23:0] rise={v,16'd0};
    assign level=mode<2 ? 24'hffffff :
        mode==2 ? 24'h7fffff+rise :
        mode<5 ? 24'h3fffff+rise+(rise>>1) :
        24'h0fffff+rise+(rise>>1)+(rise>>2);
endmodule
