user-lqt/gowin-fpga-instrument-138k/final/project/integrated_instrument_64/source/rtl/audio_core/pitch_lookup_sync.v

// Synchronous lookup of the fixed release's exact integer pitch coefficients.
module pitch_lookup_sync(
    input wire clk,input wire [6:0] note_id,input wire [7:0] fraction,
    output wire [31:0] fc,output wire [47:0] period_q16,
    output wire [16:0] ratio,reciprocal);
    reg [60:0] note_rom[0:127];
    reg [33:0] fraction_rom[0:255];
    reg [60:0] note_word;
    reg [33:0] fraction_word;
    initial begin
        note_rom[0]=61'h00016534d6eefc99;
        note_rom[1]=61'h00017a7275a578ae;
        note_rom[2]=61'h000190f3546e7482;
        note_rom[3]=61'h0001a8cad348e43d;
        note_rom[4]=61'h0001c20d3233ce8f;
        note_rom[5]=61'h0001dcd0312e44fa;
        note_rom[6]=61'h0001f92a70376a5e;
        note_rom[7]=61'h000217346f4e696e;
        note_rom[8]=61'h000237078e727d5b;
        note_rom[9]=61'h000258bf2da2e8da;
        note_rom[10]=61'h00027c780cdefaf5;
        note_rom[11]=61'h0002a250cc260bc6;
        note_rom[12]=61'h0002ca698b777e4c;
        note_rom[13]=61'h0002f4e4cad2bc57;
        note_rom[14]=61'h000321e68a373a41;
        note_rom[15]=61'h0003519589a4721e;
        note_rom[16]=61'h0003841a6919e6f4;
        note_rom[17]=61'h0003b9a04897227d;
        note_rom[18]=61'h0003f254e81bb4ed;
        note_rom[19]=61'h00042e68a7a734f1;
        note_rom[20]=61'h00046e0f07393ead;
        note_rom[21]=61'h0004b17e46d1746d;
        note_rom[22]=61'h0004f8f0266f7d51;
        note_rom[23]=61'h000544a1861305e3;
        note_rom[24]=61'h000594d305bbbf26;
        note_rom[25]=61'h0005e9c965695e49;
        note_rom[26]=61'h000643cd251b9d06;
        note_rom[27]=61'h0006a32b04d2390f;
        note_rom[28]=61'h00070834c48cf37a;
        note_rom[29]=61'h00077340844b913e;
        note_rom[30]=61'h0007e4a9c40dda76;
        note_rom[31]=61'h00085cd163d39a6a;
        note_rom[32]=61'h0008dc1e039c9f56;
        note_rom[33]=61'h000962fca368ba2a;
        note_rom[34]=61'h0009f1e02337beb3;
        note_rom[35]=61'h000a8942e30982fa;
        note_rom[36]=61'h000b29a622dddf8a;
        note_rom[37]=61'h000bd392c2b4af24;
        note_rom[38]=61'h000c879a428dce83;
        note_rom[39]=61'h000d465622691c81;
        note_rom[40]=61'h000e1069824679bd;
        note_rom[41]=61'h000ee680e225c8a3;
        note_rom[42]=61'h000fc9536206ed3f;
        note_rom[43]=61'h0010b9a2a1e9cd38;
        note_rom[44]=61'h0011b83c21ce4fa8;
        note_rom[45]=61'h0012c5f921b45d18;
        note_rom[46]=61'h0013e3c0619bdf56;
        note_rom[47]=61'h00151285c184c17d;
        note_rom[48]=61'h0016534c416eefc5;
        note_rom[49]=61'h0017a725a15a5790;
        note_rom[50]=61'h00190f346146e743;
        note_rom[51]=61'h001a8cac41348e40;
        note_rom[52]=61'h001c20d2e1233cdf;
        note_rom[53]=61'h001dcd01e112e450;
        note_rom[54]=61'h001f92a6c103769f;
        note_rom[55]=61'h0021734560f4e69b;
        note_rom[56]=61'h0023707840e727d4;
        note_rom[57]=61'h00258bf260da2e8b;
        note_rom[58]=61'h0027c780c0cdefab;
        note_rom[59]=61'h002a250ba0c260be;
        note_rom[60]=61'h002ca69860b777e3;
        note_rom[61]=61'h002f4e4b40ad2bc8;
        note_rom[62]=61'h00321e68e0a373a1;
        note_rom[63]=61'h00351958609a4720;
        note_rom[64]=61'h003841a5e0919e6f;
        note_rom[65]=61'h003b9a03a0897228;
        note_rom[66]=61'h003f254da081bb4f;
        note_rom[67]=61'h0042e68ac07a734d;
        note_rom[68]=61'h0046e0f0607393ea;
        note_rom[69]=61'h004b17e4c06d1745;
        note_rom[70]=61'h004f8f016066f7d5;
        note_rom[71]=61'h00544a174061305f;
        note_rom[72]=61'h00594d30e05bbbf1;
        note_rom[73]=61'h005e9c96805695e4;
        note_rom[74]=61'h00643cd1a051b9d0;
        note_rom[75]=61'h006a32b0c04d2390;
        note_rom[76]=61'h0070834ba048cf37;
        note_rom[77]=61'h007734074044b914;
        note_rom[78]=61'h007e4a9b2040dda7;
        note_rom[79]=61'h0085cd15803d39a6;
        note_rom[80]=61'h008dc1e0e039c9f5;
        note_rom[81]=61'h00962fc960368ba2;
        note_rom[82]=61'h009f1e02e0337bea;
        note_rom[83]=61'h00a8942e6030982f;
        note_rom[84]=61'h00b29a61a02dddf8;
        note_rom[85]=61'h00bd392d002b4af2;
        note_rom[86]=61'h00c879a36028dce8;
        note_rom[87]=61'h00d46561a02691c8;
        note_rom[88]=61'h00e106974024679b;
        note_rom[89]=61'h00ee680ea0225c8a;
        note_rom[90]=61'h00fc953640206ed3;
        note_rom[91]=61'h010b9a2ae01e9cd3;
        note_rom[92]=61'h011b83c1a01ce4fa;
        note_rom[93]=61'h012c5f92c01b45d1;
        note_rom[94]=61'h013e3c05a019bdf5;
        note_rom[95]=61'h0151285ce0184c17;
        note_rom[96]=61'h016534c34016eefc;
        note_rom[97]=61'h017a725a0015a579;
        note_rom[98]=61'h0190f346a0146e74;
        note_rom[99]=61'h01a8cac3401348e4;
        note_rom[100]=61'h01c20d2e801233cd;
        note_rom[101]=61'h01dcd01d20112e45;
        note_rom[102]=61'h01f92a6c80103769;
        note_rom[103]=61'h02173455e00f4e69;
        note_rom[104]=61'h02370783400e727d;
        note_rom[105]=61'h0258bf25800da2e8;
        note_rom[106]=61'h027c780b400cdefa;
        note_rom[107]=61'h02a250b9c00c260b;
        note_rom[108]=61'h02ca6986a00b777e;
        note_rom[109]=61'h02f4e4b4000ad2bc;
        note_rom[110]=61'h0321e68d400a373a;
        note_rom[111]=61'h035195868009a472;
        note_rom[112]=61'h03841a5d000919e6;
        note_rom[113]=61'h03b9a03a60089722;
        note_rom[114]=61'h03f254d900081bb4;
        note_rom[115]=61'h042e68abc007a734;
        note_rom[116]=61'h046e0f06a007393e;
        note_rom[117]=61'h04b17e4b2006d174;
        note_rom[118]=61'h04f8f016a0066f7d;
        note_rom[119]=61'h0544a17380061305;
        note_rom[120]=61'h0594d30d4005bbbf;
        note_rom[121]=61'h05e9c967e005695e;
        note_rom[122]=61'h0643cd1a80051b9d;
        note_rom[123]=61'h06a32b0d0004d239;
        note_rom[124]=61'h070834ba20048cf3;
        note_rom[125]=61'h07734074c0044b91;
        note_rom[126]=61'h07e4a9b220040dda;
        note_rom[127]=61'h085cd1578003d39a;
        fraction_rom[0]=34'h200010000;
        fraction_rom[1]=34'h2001efff1;
        fraction_rom[2]=34'h2003cffe2;
        fraction_rom[3]=34'h20058ffd4;
        fraction_rom[4]=34'h20076ffc5;
        fraction_rom[5]=34'h20094ffb6;
        fraction_rom[6]=34'h200b2ffa7;
        fraction_rom[7]=34'h200d0ff99;
        fraction_rom[8]=34'h200ecff8a;
        fraction_rom[9]=34'h2010aff7b;
        fraction_rom[10]=34'h20128ff6c;
        fraction_rom[11]=34'h20146ff5e;
        fraction_rom[12]=34'h20164ff4f;
        fraction_rom[13]=34'h20182ff40;
        fraction_rom[14]=34'h2019eff31;
        fraction_rom[15]=34'h201bcff23;
        fraction_rom[16]=34'h201daff14;
        fraction_rom[17]=34'h201f8ff05;
        fraction_rom[18]=34'h20216fef6;
        fraction_rom[19]=34'h20234fee8;
        fraction_rom[20]=34'h20250fed9;
        fraction_rom[21]=34'h2026efeca;
        fraction_rom[22]=34'h2028cfebb;
        fraction_rom[23]=34'h202aafead;
        fraction_rom[24]=34'h202c8fe9e;
        fraction_rom[25]=34'h202e6fe8f;
        fraction_rom[26]=34'h20304fe81;
        fraction_rom[27]=34'h20320fe72;
        fraction_rom[28]=34'h2033efe63;
        fraction_rom[29]=34'h2035cfe55;
        fraction_rom[30]=34'h2037afe46;
        fraction_rom[31]=34'h20398fe37;
        fraction_rom[32]=34'h203b6fe29;
        fraction_rom[33]=34'h203d4fe1a;
        fraction_rom[34]=34'h203f2fe0b;
        fraction_rom[35]=34'h20410fdfc;
        fraction_rom[36]=34'h2042efdee;
        fraction_rom[37]=34'h2044afddf;
        fraction_rom[38]=34'h20468fdd0;
        fraction_rom[39]=34'h20486fdc2;
        fraction_rom[40]=34'h204a4fdb3;
        fraction_rom[41]=34'h204c2fda5;
        fraction_rom[42]=34'h204e0fd96;
        fraction_rom[43]=34'h204fefd87;
        fraction_rom[44]=34'h2051cfd79;
        fraction_rom[45]=34'h2053afd6a;
        fraction_rom[46]=34'h20558fd5b;
        fraction_rom[47]=34'h20576fd4d;
        fraction_rom[48]=34'h20594fd3e;
        fraction_rom[49]=34'h205b2fd2f;
        fraction_rom[50]=34'h205d0fd21;
        fraction_rom[51]=34'h205ecfd12;
        fraction_rom[52]=34'h2060afd04;
        fraction_rom[53]=34'h20628fcf5;
        fraction_rom[54]=34'h20646fce6;
        fraction_rom[55]=34'h20664fcd8;
        fraction_rom[56]=34'h20682fcc9;
        fraction_rom[57]=34'h206a0fcbb;
        fraction_rom[58]=34'h206befcac;
        fraction_rom[59]=34'h206dcfc9d;
        fraction_rom[60]=34'h206fafc8f;
        fraction_rom[61]=34'h20718fc80;
        fraction_rom[62]=34'h20736fc72;
        fraction_rom[63]=34'h20754fc63;
        fraction_rom[64]=34'h20772fc54;
        fraction_rom[65]=34'h20790fc46;
        fraction_rom[66]=34'h207aefc37;
        fraction_rom[67]=34'h207ccfc29;
        fraction_rom[68]=34'h207eafc1a;
        fraction_rom[69]=34'h20808fc0c;
        fraction_rom[70]=34'h20826fbfd;
        fraction_rom[71]=34'h20844fbee;
        fraction_rom[72]=34'h20862fbe0;
        fraction_rom[73]=34'h20880fbd1;
        fraction_rom[74]=34'h2089efbc3;
        fraction_rom[75]=34'h208bcfbb4;
        fraction_rom[76]=34'h208dcfba6;
        fraction_rom[77]=34'h208fafb97;
        fraction_rom[78]=34'h20918fb89;
        fraction_rom[79]=34'h20936fb7a;
        fraction_rom[80]=34'h20954fb6c;
        fraction_rom[81]=34'h20972fb5d;
        fraction_rom[82]=34'h20990fb4f;
        fraction_rom[83]=34'h209aefb40;
        fraction_rom[84]=34'h209ccfb32;
        fraction_rom[85]=34'h209eafb23;
        fraction_rom[86]=34'h20a08fb15;
        fraction_rom[87]=34'h20a26fb06;
        fraction_rom[88]=34'h20a44faf8;
        fraction_rom[89]=34'h20a62fae9;
        fraction_rom[90]=34'h20a80fadb;
        fraction_rom[91]=34'h20aa0facc;
        fraction_rom[92]=34'h20abefabe;
        fraction_rom[93]=34'h20adcfaaf;
        fraction_rom[94]=34'h20afafaa1;
        fraction_rom[95]=34'h20b18fa92;
        fraction_rom[96]=34'h20b36fa84;
        fraction_rom[97]=34'h20b54fa75;
        fraction_rom[98]=34'h20b72fa67;
        fraction_rom[99]=34'h20b90fa58;
        fraction_rom[100]=34'h20bb0fa4a;
        fraction_rom[101]=34'h20bcefa3b;
        fraction_rom[102]=34'h20becfa2d;
        fraction_rom[103]=34'h20c0afa1e;
        fraction_rom[104]=34'h20c28fa10;
        fraction_rom[105]=34'h20c46fa02;
        fraction_rom[106]=34'h20c64f9f3;
        fraction_rom[107]=34'h20c82f9e5;
        fraction_rom[108]=34'h20ca2f9d6;
        fraction_rom[109]=34'h20cc0f9c8;
        fraction_rom[110]=34'h20cdef9b9;
        fraction_rom[111]=34'h20cfcf9ab;
        fraction_rom[112]=34'h20d1af99d;
        fraction_rom[113]=34'h20d38f98e;
        fraction_rom[114]=34'h20d58f980;
        fraction_rom[115]=34'h20d76f971;
        fraction_rom[116]=34'h20d94f963;
        fraction_rom[117]=34'h20db2f955;
        fraction_rom[118]=34'h20dd0f946;
        fraction_rom[119]=34'h20df0f938;
        fraction_rom[120]=34'h20e0ef929;
        fraction_rom[121]=34'h20e2cf91b;
        fraction_rom[122]=34'h20e4af90d;
        fraction_rom[123]=34'h20e68f8fe;
        fraction_rom[124]=34'h20e86f8f0;
        fraction_rom[125]=34'h20ea6f8e1;
        fraction_rom[126]=34'h20ec4f8d3;
        fraction_rom[127]=34'h20ee2f8c5;
        fraction_rom[128]=34'h20f00f8b6;
        fraction_rom[129]=34'h20f20f8a8;
        fraction_rom[130]=34'h20f3ef89a;
        fraction_rom[131]=34'h20f5cf88b;
        fraction_rom[132]=34'h20f7af87d;
        fraction_rom[133]=34'h20f98f86f;
        fraction_rom[134]=34'h20fb8f860;
        fraction_rom[135]=34'h20fd6f852;
        fraction_rom[136]=34'h20ff4f843;
        fraction_rom[137]=34'h21012f835;
        fraction_rom[138]=34'h21032f827;
        fraction_rom[139]=34'h21050f818;
        fraction_rom[140]=34'h2106ef80a;
        fraction_rom[141]=34'h2108ef7fc;
        fraction_rom[142]=34'h210acf7ee;
        fraction_rom[143]=34'h210caf7df;
        fraction_rom[144]=34'h210e8f7d1;
        fraction_rom[145]=34'h21108f7c3;
        fraction_rom[146]=34'h21126f7b4;
        fraction_rom[147]=34'h21144f7a6;
        fraction_rom[148]=34'h21162f798;
        fraction_rom[149]=34'h21182f789;
        fraction_rom[150]=34'h211a0f77b;
        fraction_rom[151]=34'h211bef76d;
        fraction_rom[152]=34'h211def75e;
        fraction_rom[153]=34'h211fcf750;
        fraction_rom[154]=34'h2121af742;
        fraction_rom[155]=34'h2123af734;
        fraction_rom[156]=34'h21258f725;
        fraction_rom[157]=34'h21276f717;
        fraction_rom[158]=34'h21296f709;
        fraction_rom[159]=34'h212b4f6fb;
        fraction_rom[160]=34'h212d2f6ec;
        fraction_rom[161]=34'h212f2f6de;
        fraction_rom[162]=34'h21310f6d0;
        fraction_rom[163]=34'h2132ef6c1;
        fraction_rom[164]=34'h2134ef6b3;
        fraction_rom[165]=34'h2136cf6a5;
        fraction_rom[166]=34'h2138af697;
        fraction_rom[167]=34'h213aaf688;
        fraction_rom[168]=34'h213c8f67a;
        fraction_rom[169]=34'h213e6f66c;
        fraction_rom[170]=34'h21406f65e;
        fraction_rom[171]=34'h21424f650;
        fraction_rom[172]=34'h21442f641;
        fraction_rom[173]=34'h21462f633;
        fraction_rom[174]=34'h21480f625;
        fraction_rom[175]=34'h214a0f617;
        fraction_rom[176]=34'h214bef608;
        fraction_rom[177]=34'h214dcf5fa;
        fraction_rom[178]=34'h214fcf5ec;
        fraction_rom[179]=34'h2151af5de;
        fraction_rom[180]=34'h21538f5d0;
        fraction_rom[181]=34'h21558f5c1;
        fraction_rom[182]=34'h21576f5b3;
        fraction_rom[183]=34'h21596f5a5;
        fraction_rom[184]=34'h215b4f597;
        fraction_rom[185]=34'h215d4f589;
        fraction_rom[186]=34'h215f2f57b;
        fraction_rom[187]=34'h21610f56c;
        fraction_rom[188]=34'h21630f55e;
        fraction_rom[189]=34'h2164ef550;
        fraction_rom[190]=34'h2166ef542;
        fraction_rom[191]=34'h2168cf534;
        fraction_rom[192]=34'h216acf525;
        fraction_rom[193]=34'h216caf517;
        fraction_rom[194]=34'h216e8f509;
        fraction_rom[195]=34'h21708f4fb;
        fraction_rom[196]=34'h21726f4ed;
        fraction_rom[197]=34'h21746f4df;
        fraction_rom[198]=34'h21764f4d1;
        fraction_rom[199]=34'h21784f4c2;
        fraction_rom[200]=34'h217a2f4b4;
        fraction_rom[201]=34'h217c2f4a6;
        fraction_rom[202]=34'h217e0f498;
        fraction_rom[203]=34'h21800f48a;
        fraction_rom[204]=34'h2181ef47c;
        fraction_rom[205]=34'h2183ef46e;
        fraction_rom[206]=34'h2185cf460;
        fraction_rom[207]=34'h2187cf451;
        fraction_rom[208]=34'h2189af443;
        fraction_rom[209]=34'h218baf435;
        fraction_rom[210]=34'h218d8f427;
        fraction_rom[211]=34'h218f8f419;
        fraction_rom[212]=34'h21916f40b;
        fraction_rom[213]=34'h21936f3fd;
        fraction_rom[214]=34'h21954f3ef;
        fraction_rom[215]=34'h21974f3e1;
        fraction_rom[216]=34'h21992f3d3;
        fraction_rom[217]=34'h219b2f3c4;
        fraction_rom[218]=34'h219d0f3b6;
        fraction_rom[219]=34'h219f0f3a8;
        fraction_rom[220]=34'h21a0ef39a;
        fraction_rom[221]=34'h21a2ef38c;
        fraction_rom[222]=34'h21a4cf37e;
        fraction_rom[223]=34'h21a6cf370;
        fraction_rom[224]=34'h21a8af362;
        fraction_rom[225]=34'h21aaaf354;
        fraction_rom[226]=34'h21acaf346;
        fraction_rom[227]=34'h21ae8f338;
        fraction_rom[228]=34'h21b08f32a;
        fraction_rom[229]=34'h21b26f31c;
        fraction_rom[230]=34'h21b46f30e;
        fraction_rom[231]=34'h21b64f300;
        fraction_rom[232]=34'h21b84f2f2;
        fraction_rom[233]=34'h21ba4f2e4;
        fraction_rom[234]=34'h21bc2f2d6;
        fraction_rom[235]=34'h21be2f2c8;
        fraction_rom[236]=34'h21c00f2ba;
        fraction_rom[237]=34'h21c20f2ac;
        fraction_rom[238]=34'h21c40f29d;
        fraction_rom[239]=34'h21c5ef28f;
        fraction_rom[240]=34'h21c7ef281;
        fraction_rom[241]=34'h21c9cf273;
        fraction_rom[242]=34'h21cbcf265;
        fraction_rom[243]=34'h21cdcf257;
        fraction_rom[244]=34'h21cfaf249;
        fraction_rom[245]=34'h21d1af23b;
        fraction_rom[246]=34'h21d38f22d;
        fraction_rom[247]=34'h21d58f21f;
        fraction_rom[248]=34'h21d78f212;
        fraction_rom[249]=34'h21d96f204;
        fraction_rom[250]=34'h21db6f1f6;
        fraction_rom[251]=34'h21dd6f1e8;
        fraction_rom[252]=34'h21df4f1da;
        fraction_rom[253]=34'h21e14f1cc;
        fraction_rom[254]=34'h21e34f1be;
        fraction_rom[255]=34'h21e52f1b0;
    end
    always @(posedge clk) begin
        note_word<=note_rom[note_id];
        fraction_word<=fraction_rom[fraction];
    end
    assign fc=note_word[60:29];
    assign period_q16={19'd0,note_word[28:0]};
    assign {ratio,reciprocal}=fraction_word;
endmodule
