user-lqt/gowin-fpga-instrument-138k/final/project/integrated_instrument_64/source/rtl/audio_core/wavetable.v

// Generated exact quarter-cycle of the approved 4096-point ROM.
// Quadrant reflection preserves every integer sample and one-clock read.
module wavetable (
    input wire clk,
    input wire [11:0] addr,
    output wire signed [15:0] dout
);
    reg signed [15:0] rom [0:1023];
    wire [9:0] index = addr[10] ? (10'd0-addr[9:0]) : addr[9:0];
    reg signed [15:0] sample;
    reg negative, peak;
    initial begin
        rom[0] = 16'sd0;
        rom[1] = 16'sd50;
        rom[2] = 16'sd101;
        rom[3] = 16'sd151;
        rom[4] = 16'sd201;
        rom[5] = 16'sd251;
        rom[6] = 16'sd302;
        rom[7] = 16'sd352;
        rom[8] = 16'sd402;
        rom[9] = 16'sd452;
        rom[10] = 16'sd503;
        rom[11] = 16'sd553;
        rom[12] = 16'sd603;
        rom[13] = 16'sd653;
        rom[14] = 16'sd704;
        rom[15] = 16'sd754;
        rom[16] = 16'sd804;
        rom[17] = 16'sd854;
        rom[18] = 16'sd905;
        rom[19] = 16'sd955;
        rom[20] = 16'sd1005;
        rom[21] = 16'sd1055;
        rom[22] = 16'sd1106;
        rom[23] = 16'sd1156;
        rom[24] = 16'sd1206;
        rom[25] = 16'sd1256;
        rom[26] = 16'sd1307;
        rom[27] = 16'sd1357;
        rom[28] = 16'sd1407;
        rom[29] = 16'sd1457;
        rom[30] = 16'sd1507;
        rom[31] = 16'sd1558;
        rom[32] = 16'sd1608;
        rom[33] = 16'sd1658;
        rom[34] = 16'sd1708;
        rom[35] = 16'sd1758;
        rom[36] = 16'sd1809;
        rom[37] = 16'sd1859;
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
    end
    always @(posedge clk) begin
        sample <= rom[index];
        negative <= addr[11];
        peak <= addr[10] && addr[9:0] == 0;
    end
    wire signed [15:0] positive = peak ? 16'sd32767 : sample;
    assign dout = negative ? -positive : positive;
endmodule
