user-lqt/gowin-fpga-instrument-138k/final/project/integrated_instrument_64/source/rtl/audio_core/note_to_fc.v

//=============================================================================
// note_to_fc.v -- MIDI 音符号 -> 32 位相位增量(频率控制字 FC)
//
// 【自动生成,请勿手改】由 sim/audio_core_tb/gen_tables.py 生成。
//
//   FC = round(f_note * 2^32 / Fs),Fs = 48000 Hz,相位累加器 32 bit。
//   查表法:任意音符号的频率误差 < 0.001 音分(仅受 FC 取整限制)。
//   MIDI 标准:A4 = 440 Hz 对应 note_id = 69。
//=============================================================================
`include "event_defs.vh"

module note_to_fc (
    input  wire [6:0]  note_id,
    output reg  [31:0] fc
);
    always @(*) begin
        case (note_id)
            7'd  0: fc = 32'd    731558;   //     8.176 Hz
            7'd  1: fc = 32'd    775059;   //     8.662 Hz
            7'd  2: fc = 32'd    821146;   //     9.177 Hz
            7'd  3: fc = 32'd    869974;   //     9.723 Hz
            7'd  4: fc = 32'd    921705;   //    10.301 Hz
            7'd  5: fc = 32'd    976513;   //    10.913 Hz
            7'd  6: fc = 32'd   1034579;   //    11.562 Hz
            7'd  7: fc = 32'd   1096099;   //    12.250 Hz
            7'd  8: fc = 32'd   1161276;   //    12.978 Hz
            7'd  9: fc = 32'd   1230329;   //    13.750 Hz
            7'd 10: fc = 32'd   1303488;   //    14.568 Hz
            7'd 11: fc = 32'd   1380998;   //    15.434 Hz
            7'd 12: fc = 32'd   1463116;   //    16.352 Hz
            7'd 13: fc = 32'd   1550118;   //    17.324 Hz
            7'd 14: fc = 32'd   1642292;   //    18.354 Hz
            7'd 15: fc = 32'd   1739948;   //    19.445 Hz
            7'd 16: fc = 32'd   1843411;   //    20.602 Hz
            7'd 17: fc = 32'd   1953026;   //    21.827 Hz
            7'd 18: fc = 32'd   2069159;   //    23.125 Hz
            7'd 19: fc = 32'd   2192197;   //    24.500 Hz
            7'd 20: fc = 32'd   2322552;   //    25.957 Hz
            7'd 21: fc = 32'd   2460658;   //    27.500 Hz
            7'd 22: fc = 32'd   2606977;   //    29.135 Hz
            7'd 23: fc = 32'd   2761996;   //    30.868 Hz
            7'd 24: fc = 32'd   2926232;   //    32.703 Hz
            7'd 25: fc = 32'd   3100235;   //    34.648 Hz
            7'd 26: fc = 32'd   3284585;   //    36.708 Hz
            7'd 27: fc = 32'd   3479896;   //    38.891 Hz
            7'd 28: fc = 32'd   3686822;   //    41.203 Hz
            7'd 29: fc = 32'd   3906052;   //    43.654 Hz
            7'd 30: fc = 32'd   4138318;   //    46.249 Hz
            7'd 31: fc = 32'd   4384395;   //    48.999 Hz
            7'd 32: fc = 32'd   4645104;   //    51.913 Hz
            7'd 33: fc = 32'd   4921317;   //    55.000 Hz
            7'd 34: fc = 32'd   5213953;   //    58.270 Hz
            7'd 35: fc = 32'd   5523991;   //    61.735 Hz
            7'd 36: fc = 32'd   5852465;   //    65.406 Hz
            7'd 37: fc = 32'd   6200470;   //    69.296 Hz
            7'd 38: fc = 32'd   6569170;   //    73.416 Hz
            7'd 39: fc = 32'd   6959793;   //    77.782 Hz
            7'd 40: fc = 32'd   7373644;   //    82.407 Hz
            7'd 41: fc = 32'd   7812103;   //    87.307 Hz
            7'd 42: fc = 32'd   8276635;   //    92.499 Hz
            7'd 43: fc = 32'd   8768789;   //    97.999 Hz
            7'd 44: fc = 32'd   9290209;   //   103.826 Hz
            7'd 45: fc = 32'd   9842633;   //   110.000 Hz
            7'd 46: fc = 32'd  10427907;   //   116.541 Hz
            7'd 47: fc = 32'd  11047982;   //   123.471 Hz
            7'd 48: fc = 32'd  11704930;   //   130.813 Hz
            7'd 49: fc = 32'd  12400941;   //   138.591 Hz
            7'd 50: fc = 32'd  13138339;   //   146.832 Hz
            7'd 51: fc = 32'd  13919586;   //   155.563 Hz
            7'd 52: fc = 32'd  14747287;   //   164.814 Hz
            7'd 53: fc = 32'd  15624207;   //   174.614 Hz
            7'd 54: fc = 32'd  16553270;   //   184.997 Hz
            7'd 55: fc = 32'd  17537579;   //   195.998 Hz
            7'd 56: fc = 32'd  18580418;   //   207.652 Hz
            7'd 57: fc = 32'd  19685267;   //   220.000 Hz
            7'd 58: fc = 32'd  20855814;   //   233.082 Hz
            7'd 59: fc = 32'd  22095965;   //   246.942 Hz
            7'd 60: fc = 32'd  23409859;   //   261.626 Hz
            7'd 61: fc = 32'd  24801882;   //   277.183 Hz
            7'd 62: fc = 32'd  26276679;   //   293.665 Hz
            7'd 63: fc = 32'd  27839171;   //   311.127 Hz
            7'd 64: fc = 32'd  29494575;   //   329.628 Hz
            7'd 65: fc = 32'd  31248413;   //   349.228 Hz
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
            7'd125: fc = 32'd 999949222;   // 11175.303 Hz
            7'd126: fc = 32'd1059409297;   // 11839.822 Hz
            7'd127: fc = 32'd1122405052;   // 12543.854 Hz
            default: fc = 32'd0;
        endcase
    end
endmodule
