user-lqt/gowin-fpga-instrument-138k/final/project/integrated_instrument_64/source/rtl/audio_core/note_to_period.v

// Generated from the original note_to_fc integer constants.
// Exact floor((2^48-1)/fc); not PCM and not a rounded frequency fit.
// Stage 3 only: pitch bend must supply a matching period in stage 4.
module note_to_period (
    input wire [6:0] note_id,
    output reg [47:0] period_q16
);
    always @* begin
        case (note_id)
            7'd0: period_q16 = 48'd384760985;
            7'd1: period_q16 = 48'd363165870;
            7'd2: period_q16 = 48'd342783106;
            7'd3: period_q16 = 48'd323544125;
            7'd4: period_q16 = 48'd305385103;
            7'd5: period_q16 = 48'd288244986;
            7'd6: period_q16 = 48'd272067166;
            7'd7: period_q16 = 48'd256797038;
            7'd8: period_q16 = 48'd242384219;
            7'd9: period_q16 = 48'd228780250;
            7'd10: period_q16 = 48'd215939829;
            7'd11: period_q16 = 48'd203819974;
            7'd12: period_q16 = 48'd192380492;
            7'd13: period_q16 = 48'd181582935;
            7'd14: period_q16 = 48'd171391553;
            7'd15: period_q16 = 48'd161772062;
            7'd16: period_q16 = 48'd152692468;
            7'd17: period_q16 = 48'd144122493;
            7'd18: period_q16 = 48'd136033517;
            7'd19: period_q16 = 48'd128398577;
            7'd20: period_q16 = 48'd121192109;
            7'd21: period_q16 = 48'd114390125;
            7'd22: period_q16 = 48'd107969873;
            7'd23: period_q16 = 48'd101909987;
            7'd24: period_q16 = 48'd96190246;
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
            7'd117: period_q16 = 48'd446836;
            7'd118: period_q16 = 48'd421757;
            7'd119: period_q16 = 48'd398085;
            7'd120: period_q16 = 48'd375743;
            7'd121: period_q16 = 48'd354654;
            7'd122: period_q16 = 48'd334749;
            7'd123: period_q16 = 48'd315961;
            7'd124: period_q16 = 48'd298227;
            7'd125: period_q16 = 48'd281489;
            7'd126: period_q16 = 48'd265690;
            7'd127: period_q16 = 48'd250778;
            default: period_q16 = 0;
        endcase
    end
endmodule
