user-lqt/gowin-fpga-instrument-138k/(commit log)

2026-09-21 chore: 初始化仓库骨架与接口冻结文件
    阶段0 起点：目录结构、rtl/common 接口定义、平台冻结卡、协作规范、团队文档归档。
2026-09-21 docs(constraint): 核实板载音频通路与实机 I2S 管脚
    - 依据 Sipeed 官方例程确认板载 DAC + 功放完整，外置 PCM5102A/PAM8403 不再需要
    - 填入已核实的 I2S 三线、PA_EN、复位、LED 管脚到 tang_mega138k.cst
    - 新增 docs/C_官方例程与板载音频通路分析.md（含 I2S 协议参数与四步验证阶梯）
    - 修正平台卡与接口冻结卡的 I2S 位宽约定（32bit 槽 / 24bit 目标，待实测确认）
2026-09-21 docs(tools): 新增云源软件命令行操作手册（已实测）
    实测环境：Gowin V1.9.12 教育版、gw_sh.exe 命令行控制台可用、138K 器件库 B/C 双版本齐备、license 已就位、create_project 138K 成功。记录 set_device / create_project / run / read_ipc 的准确语法与 IP 核生成路线。
2026-09-21 docs(C): 新增零基础学习路线（四周计划 + 必学/不必学清单）
    面向完全没学过 FPGA 的成员 C：Verilog 电路思维、时序基础、Gowin 工具链、I2S 与时钟域、四周可验收产出、硬件采购最小集、提问方法。
2026-09-21 docs(C): 新增 Verilog 最小语法卡（含常见编译报错对照）
    模块骨架、wire/reg 选择、三种赋值、常量位宽写法、四种常用代码形状、Gowin 与其它工具的差异。
2026-09-21 docs(C): 语法卡补充 wire 的完整说明
    wire 的特性、三种声明、模块互连的用法、多驱动冲突、三态总线例外。
2026-09-24 docs(C): 新增 C1 模块设计说明（写码前的方案冻结）
    定义 C1 里程碑：固定正弦经 I2S 到板载 DAC 出声。含 5 个模块清单、双时钟域与两个 PLL 的取舍、I2S 协议参数与 WS 相位处理、sample_scheduler 结构、临时音源 tone_src 的合规说明、tb_system 六项检查、上板验证步骤。
2026-09-24 feat(system): C1 批次1 时钟与采样节拍（仿真PASS + 综合布线通过 + bitstream）
    交付：
    - rtl/system/clock_gen.v：GW5AST PLL 原语，50MHz -> 12.29167MHz 音频域 + 98.333MHz 系统域
    - rtl/system/sample_scheduler.v：48kHz 采样节拍 + 3.072MHz 位时钟（BCK=64xLRCK）
    - rtl/common/reset_sync.v：参数化复位同步器
    - sim/system_tb/tb_scheduler.v：12 项自检，仿真实测全部 PASS
    - project/synth_check_top.v + constraint .cst/.sdc + tools/build.tcl + tools/sim.ps1
    验证：综合 100% 无错误无告警；布局布线完成；bitstream 生成（synth_top.fs）
    资源：Logic 37/138240（<1%）、FF 36、PLL 1/12
    已知偏差：PLL 整数分频无法凑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
    [clock_gen.v, reset_sync.v, sample_scheduler.v, synth_check_top.v, tb_scheduler.v]
2026-09-24 fix(constraint): 从官方例程核实板载时钟与管脚（V22 50MHz / 器件版本 B）
    核实来源：sipeed/TangMega-138K-example 的 5 个例程 .cst，全部指向 clk=V22
    - i_clk_in 从占位改为实管脚 V22（板载 50MHz 晶振）
    - 器件版本确认 B（GW5AST-LV138PG484AC2/I1）
    - S2 复位 F4 已核实
    - 板载 16 颗 LED 属 CPU/SSPI 专用脚，改用 audio 例程验证过的 W21/W22
    构建结果：Placement and routing completed + Bitstream generation completed，零 ERROR
    踩坑记录：Sipeed 下载站是 JS 单页应用抓不到文件列表，权威管脚表在官方例程的 .cst 里
    [synth_check_top.v]
2026-09-24 fix(system): 修正 BCK 分频错误（原只达规格一半）+ 补齐三个 testbench
    发现的真 bug：
    - sample_scheduler 的 CLK_DIV_BCK 语义为「每几拍翻转一次」，
    bck 完整周期 = 2*CLK_DIV_BCK，原先按 D=4 配置导致 BCK 只有 1.536MHz
    （= 32 x LRCK，仅 16bit 槽），不符合 24bit 音频所需的 64 x LRCK
    - 修正为 D=2：BCK = 3.072MHz = 64 x LRCK，每声道 32bit 槽
    仿真实测（ModelSim ASE，全部 PASS）：
    - tb_scheduler：BCK edges/sample = 64、bck_en/sample = 128，规格断言锁死关系
    - tb_clock_gen：LRCK/BCK = 64.000，复位释放时序正确
    - tb_reset_sync：异步置位/同步释放/窄脉冲抗毛刺 全部通过
    工程实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
    [sample_scheduler.v, synth_check_top.v, tb_clock_gen.v, tb_reset_sync.v, tb_scheduler.v]
2026-09-24 docs(C): 新增批次2规格 —— 让耳机出声（i2s_tx + 音源 + 正式顶层）
    定义批次2边界：从「时钟对了」到「耳机响了」。含 i2s_tx 接口与时序策略、tone_src 临时音源参数（1kHz/256点波表）、6 项仿真检查、7 步上板验证流程。
2026-09-24 wip(system): 批次2 —— 音源/顶层完成，i2s_tx 位对齐未收敛（附阻塞报告）
    已完成：sine_rom.v（256点正弦表）、tone_src.v（1kHz相位累加器）、
    project/synth_top.v（正式顶层，替换 synth_check_top）
    未完成：rtl/system/i2s_tx.v 的位对齐
    - 已通过：复位静音、一帧64个BCK周期
    - 未通过：左右声道分离、数据位序（系统性偏移1~2位）
    根本教训（已写入 evidence/stage1/C1_批次2_进展与阻塞.md）：
    发送端与接收端模型同时不可信，两边都改导致无法二分定位；
    正确顺序应是先用绝对黄金参考冻结接收端，之后只改发送端。
    下一轮起点：先做 tb_rx_gold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
2026-09-24 docs(C): 批次2 重做记录 —— 根因已定位（bck/din 同拍 + 帧边界未清零）
    按正确顺序重做的结果：
    STEP 1（冻结接收端）进行中，未 PASS；但定位到两条真正的根因。
    根因A：din 与 bck 在同一拍更新，接收端采到变化中的值。
    修法：数据在 bck 下降沿更新，采样在上升沿。
    根因B：接收端采样相位应为 ph3；且帧回绕处必须清零位计数器，
    否则左声道丢 MSB。
    实测证据：samp_ph=3 时右声道 100% 正确（0x3c），左声道仅差最高位。
    工程教训：反复覆盖同一文件时，ModelSim 编译失败会静默沿用旧模块，
    导致调试的是幽灵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
2026-09-24 fix(system): i2s_tx 按官方例程左对齐时序重写，批次2全链路仿真通过
    - i2s_tx v2：64bit 帧移位寄存器，MSB 先出，槽内高位对齐，BCK 低半周更新数据
    - tb_i2s_tx v2.2：修 ws_d 采样点更新 + bcnt 跳变处从 1 计（v1 遗留 tb bug 是历史不收敛主因之一）
    - 修 tone_src 漏接 sine_rom.clk；sine_rom 127 个非法负数字面量；synth_top 删除不存在的 WS_LEAD 参数
    - 新增 tb_tone_src 冒烟测试；sim.ps1 纳入批次2源文件
    - 回归 5/5 tb PASS；证据见 evidence/stage1/C1_批次2_完成记录.md
    [i2s_tx.v, sine_rom.v, synth_top.v, tb_clock_gen.v, tb_i2s_tx.v, tb_reset_sync.v, tb_scheduler.v, tb_tone_src.v]
2026-09-24 fix(constraint): 器件版本按实物丝印更正为 C + build.tcl 顶层切换为 synth_top
    - DEVVER B->C（官方例程均为 B，实物为 C；版本错则烧录成功但管脚无反应）
    - build.tcl 纳入批次2源文件，顶层 synth_check_top -> synth_top
2026-09-24 fix(system): 修正 PLL 分频参数与缺失的 defparam —— 输出由错误的 36.875MHz 更正为 12.288MHz
    - clock_gen: 补上 IDIV_SEL/FBDIV_SEL 的 defparam 传递（此前从未生效）
    - 参数改为 IDIV=2/FBDIV=1/MDIV=29/ODIV0=59/ODIV1=7（VCO=725MHz，PFD=25MHz，
    双双满足 UG306 的 650~1300MHz 与 19~81.25MHz 约束）
    - LRCK=48000.5Hz（+0.0011%），时序报告 Generated Clock 已验证
    - synth_check_top 第三套错误参数一并修正；各处旧频率数字同步
    - 新增 tb_top_integration 跨模块测试（scheduler+i2s_tx）
    - 证据见 evidence/stage1/C1_批次2_完成记录.md 第 6 节
    [clock_gen.v, sample_scheduler.v, synth_check_top.v, synth_top.v, tb_clock_gen.v, tb_scheduler.v, tb_top_integration.v]
2026-09-24 fix(system): tone_src 幅度修正（-48dB -> 满量程）+ 批次2 评阅报告
    评阅结论：这版质量显著提升，核心问题已解决。
    验证结果（全部实跑，非推断）：
    - 5 个模块级 tb + 1 个集成 tb 全部 PASS
    - 综合/布线/bitstream 通过，最差路径时序 slack +12.264 ns
    - 器件版本已按实物丝印改为 C
    - PLL 频率经工具报告独立确认：CLKOUT0 = 12.288 MHz
    我独立验算 LRCK = 48000.53 Hz，误差 +0.019 音分
    （人耳可辨阈值 5~10 音分），等于精确 48 kHz，
    上一版“需换晶振/MS5351”的结论作废。
    本版修复的 bug：tone_src 只做符号扩展 {{8{sign}}, rom_data}，
    把 16 位波表放进 24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
    [tone_src.v]
2026-09-24 test(system): tb_tone_src 补幅度断言（>83% 满量程）
2026-09-24 chore: 仓库根目录迁至工程目录 E:\GowinProjects\synth_top，并补齐编译产物忽略规则
    迁移原因：此前 git 仓库在 D 盘、Gowin 工程在 E 盘，两套目录各改各的，
    已出现 tb_clock_gen.v / tb_scheduler.v 在 E 盘更新但未同步、tb_top_integration.v
    仅存在于 E 盘的漂移问题。迁移后源码与编译产物同处一地，不再漂移。
    本次改动：
    - 补齐 .gitignore：Gowin 编译产物目录（project/synth_top/ 下除 .gprj 外）、
    ModelSim 仿真库（sim/delta/、work*/）、报告文件；迁移时实测 75 条噪声降到 4 条
    - 登记 Gowin 工程文件 project/synth_top/synth_top.gprj（构建脚本已引用）
    - 登记 d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
2026-09-24 refactor(sim): 统一 testbench 位置到 tb/（移除陈旧的 sim/system_tb 副本）
    问题：同一批 testbench 存在两个位置且已漂移
    - tb/ ：sim.ps1、sim.tcl 实际引用，最近 6 个提交都提交到这里
    - sim/system_tb/ ：仅早期提交过 tb_clock_gen/tb_reset_sync/tb_scheduler，
    之后未再更新，且 tb_system.v 是与 tb_top_integration.v
    职责重叠的模板占位
    经查证 tb/ 为实际使用位置（工具脚本引用 + 提交历史一致），
    故以 tb/ 为准，移除 sim/system_tb/ 这份陈旧副本，并同步 README 中的路径说明。
    后续：sim/system_tb/tb_system.v 的功能已由 tb/tb_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
    [tb_clock_gen.v, tb_reset_sync.v, tb_scheduler.v]
2026-09-24 docs(tools): 修正 build.tcl 头注释中的调用路径（doc/ -> tools/）
2026-09-25 fix(audio): match official onboard DAC timing and reset polarity
    [i2s_tx.v, i2s_tx_official.v, sample_scheduler.v, synth_top.v, tb_clock_gen.v, tb_rx_golden.v, tb_scheduler.v]
2026-10-31 release: publish final 64-voice instrument and unify project documentation
    Import the user-designated E:/Gowin/Final project without modifying its RTL,
    constraints, ROMs, configuration, or selected programming file. Publish exactly
    one final FS from project/integrated_instrument_64/impl/pnr with SHA256
    2a1c5ea9a07e9421049f5e1623558a684046df6744faac9d5258cddcdec18ef8.
    Provide unified architecture, current hardware wiring and 58-port pinout,
    operation, BLE protocol, validation, and source/history documentation. Preserve
    the earlier main tree in archive and keep existing member branches/history.
    Collect the previously uploaded phone client and existing local ESP bridge as
    separately attributed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
    [audio_queue.csv, audio_timing.csv, keyboard_timing.csv]
2026-10-31 docs: simplify final project and archive development branches
    [audio_queue.csv, audio_timing.csv, keyboard_timing.csv]
2026-11-01 Add measurement software and archived LRCK, polyphony, and latency results
    [audio_spectrum.csv, frequency_errors.csv, keys.csv, peaks.csv, periods.csv]
